ok2haz/Frequency_Counter_FPGA/STATUS.md

# STATUS — GPSDO / čítač kmitočtu (celkový přehled)

> **Společný rozcestník obou stran projektu.** Monorepo `Frequency_Counter_FPGA`
> obsahuje dva podprojekty, které spolu komunikují přes SPI. Tento soubor je
> **jediný cross-project pohled**: stav, sdílená smlouva a otevřené úkoly
> s vyznačením závislostí. Detaily NEduplikuje — odkazuje na dokumenty stran.
>
> **Poslední aktualizace:** 2026-07-20 · udržují OK2HAZ & OK2JNJ.
> Při větší změně na jedné straně aktualizuj sekci **Sdílený kontrakt** a **TODO**.

---

## Co to je
STM32H757 (host, displej + logika) měří kmitočet, který mu přes SPI dodává
FPGA (GW1NR-9) — reciproký 4-fázový čítač s front-endem MC100EP016A / MAX9601.
Reference 4×100 MHz (0/90/180/270°) generuje Si5356A z 10 MHz OCXO,
disciplinovaného z GPS (NEO-7M). Cíl = GPSDO + přesný čítač do ~1,4 GHz.

```
  GPS (NEO-7M) ──1PPS/UTC──► STM32H757 ◄──── TMP117/ADS1115/W25Q (senzory, flash)
                                │ SPI2 (64B rámec, master)
                                ▼
   OCXO 10MHz ──► Si5356A ──4×100MHz(0/90/180/270°)──► FPGA GW1NR-9
                                                          │  MC100EP016A ÷4/÷16
   RF vstup ──► MAX9601 tvarovač ──────────────────────► (reciproký čítač + TDC)
```

---

## Stav stran

### STM32H757 (`Frequency_Counter_STM32H757/`) — zralý
- Displej, FreeRTOS, senzory, GPS, RTC, W25Q flash, UI (libprim/libui/app),
  menu + okna, alarmy, IWDG, holdover — **funkční**. Detaily → `CLAUDE.md`.
- SPI driver `fpga_freq.c` (64B rámec, CRC16, polling ~20 Hz, /4↔/16 hystereze) — **hotový**.
- ⚠️ **Velké číslo na hlavní obrazovce je zatím SIMULACE.** Reálná data z FPGA
  tečou jen do UART `freq` + diag okna (`g_freq_text`/`g_freq_info`).
  **Napojení reálných dat na headline + statistiky = hlavní otevřený úkol.**
- **Nové 2026-07-16..18** (detaily → `CLAUDE.md`):
  - **Kalibrace editovatelná** (`calib.c/h`) — AD8307 slope/intercept + ADS 12V/5V
    gain přes −/+, ULOZIT persistuje do **W25Q CALIB store**; napojeno na reálný
    přepočet RF dBm i napěťových větví.
  - **Nastavení persistentní i přes power-cycle** (`syscfg.c/h`) — BKP přežije jen
    warm reset, proto zrcadlo do **W25Q CONFIG store** (debounced zápis ~1,5 s).
  - **Časová zóna** — okno „Cas", AUTO CET/CEST dle EU pravidla nebo ruční −12..+14 h.
  - **Trend až 60 dní** — decimační pyramida (×4, 9 stagí); presety 1 min…60 dní.
  - **Nová okna:** Čítač (syrový detail měření FPGA — užitečné pro SPI bring-up),
    Selftest (per-test + SPUSTIT), Komunikace (blokové schéma stavů), Cas.
  - **Si5356 reg 218 — OPRAVA ZÁMĚNY BITŮ**, viz TODO #8 (mělo dopad na diagnostiku).

### FPGA modul (`Frequency_Counter_FPGA_Module/`) — bring-up / v2.0
- Carrier board **v2.0** (KiCad) + Verilog RTL (`src/top.v`, `spi_app.v`,
  `spi_slave_phy.v`, `coarse_counter.v`, `tdc_vernier_4phase.v`) + sim testbenche
  (`sim/tb_*.sv`) + `pins.cst`/`timing.sdc` — **v repu**.
- Kalibrace fází TDC → `PHASE_CAL_DESIGN.md` (numerická LUT → IODELAY deskew).
- Osazení/wiring v2.0 → `BOARD_V20_CHECKLIST.md` (⚠️ U3 odpojené, `div_res` kritický).

---

## ⚠️ Sdílený kontrakt (= hlavní závislost mezi stranami)

**SPI: STM32 master, FPGA slave, mode 0, MSB, 8-bit. Pevný 64B full-duplex rámec.**
SCK cíl ≤6 MHz (max ~10 MHz). CRC-16/CCITT-FALSE (0x1021/0xFFFF) přes byte 0..61.
DATA payload (TYPE 0x80): `frequency_x100000` (/4), `freq16_x100000` (/16),
`edge_count`, `gate_time_ns`, `phase_status`, `error_flags`, …

- **Autoritativní specifikace v1:** `Frequency_Counter_STM32H757/CLAUDE.md`
  → sekce „FPGA strana protokolu" (tabulka offsetů, bity STATUS/FLAGS, škálování).
- **Handoff / bring-up:** `Frequency_Counter_STM32H757/FPGA_SPI_HANDOFF.md`,
  `FPGA_INSTANCE_BRIEF.md`.
- **Protokol v2 (návrh + odpověď FPGA strany):** `FPGA_PROTOCOL_V2_NAVRH.md`.

> **Pravidlo:** jakákoli změna rámce/offsetů/škálování se promítá do OBOU stran.
> Nejdřív uprav specifikaci v `CLAUDE.md`, pak obě implementace, a zapiš do TODO níže.

---

## TODO — cross-project (šipka = kdo na koho čeká)

### Hlavní (měření, UI, HW)

| # | Úkol | Strana | Závislost / blokátor |
|---|---|---|---|
| 1 | **Reálná data FPGA → headline + statistiky** (místo simulace) | STM32 | ⬅ potřebuje FPGA vydávající platné 64B rámce (link bring-up) |
| 2 | **SPI link bring-up na HW** (`RX0:FF` = FPGA nebudí MISO) | FPGA + STM32 | obě — CS/SCK/MISO, config load z flash, viz `CLAUDE.md` diagnostika |
| 3 | **Kalibrace fází TDC** (numerická LUT → IODELAY) | FPGA | `PHASE_CAL_DESIGN.md`; STM32 pak zobrazí `phase_status` PH:F/F |
| 4 | **Protokol v2** (rozšíření rámce) | obě | `FPGA_PROTOCOL_V2_NAVRH.md` — nejdřív dohodnout, pak obě strany |
| 5 | Osazení + oživení carrier v2.0 | FPGA | `BOARD_V20_CHECKLIST.md` |
| 6 | ✅ **Datalogging stability do W25Q DATA regionu — HOTOVO 2026-07-20 (v0.4.0).** | STM32 | `datalog.c/h` = append-only **kruhový** log, **32 B / 10 s → ~600 dní** v DATA regionu (63,9 MB), pak přepis nejstaršího. Záznam: f, teploty OCXO+deska, OCXO Vc, RF (**syrové mV**, ne dBm — kalibrace se může změnit), GPS lock/sat/HDOP, flags, **CRC16**. Pozice zápisu se po bootu **odvodí ze `seq`** (žádná metadata → přežije výpadek napájení). Tick v **defaultTask** s krátkým QSPI mutex timeoutem (10 ms) — při obsazené flash vzorek zahodí, watchdog nezdrží. **Úložiště za abstrakcí `datalog_backend_t`** → SD karta připravená (`datalog_sd.c`, `probe()`=false + 5bodový plán dodělání: SDMMC1 v .ioc, cache koherence, 512B RMW, FatFs, hot-unplug). Okno Datalog (s_view=17) je nově **živé** + tlačítko ZAPNOUT/VYPNOUT (persist v syscfg, ⚠️ magic `"SCFG"`→`"SCF2"` = jednorázový reset nastavení). UART `datalog [on\|off\|erase\|dump]`. Selftest **7/7** (`datalog_selftest`). ⚠️ Kmitočet bere z `fpga_freq_get_last()`, tj. **REÁLNÝ z FPGA** (ne ze simulace hlavní obrazovky) — dokud neběží SPI link (#2), bude v záznamech **0** a užitečné budou jen teploty/Vc/GPS. Smysluplný obsah tedy až po #2. |
| 7 | Reálná kalibrace RF (AD8307 slope/intercept) → CALIB store | STM32 | **infrastruktura HOTOVÁ** (`calib.c/h`, okno Kalibrace, persist do W25Q) — zbývá jen **změřit skutečné hodnoty** na HW a zadat je |
| 8 | **Si5356 „LOS_CLKIN" — VYŘEŠENO 2026-07-18: byla to FW záměna bitů, HW je V POŘÁDKU.** Kritická validace odhalila, že reg 218 má dle **AN565**: bit2 = **LOS_XTAL**, bit3 = **LOS_CLKIN** (FW měl bit2 mylně jako LOS_CLKIN). Pozorovaný status `0x04` = bit2 = LOS_XTAL — krystal XA/XB na desce **není osazen** (piny uzemněné dle datasheetu) → bit je **trvale 1 a benigní**. Skutečný LOS_CLKIN (bit3) = **0** → **TTL buzení CLKIN detektoru plně vyhovuje** (dřívější teorie „TTL 2,4 V < VIH 2,64 V" tímto empiricky vyvrácena — VIH je garanční mez, ne skutečný práh detektoru). Důkazy (4 nezávislé): AN565 tab. reg 218 + datasheet Fig. 7 (změřené sloupce) + schéma XA/XB→GND (#PWR086) + CBPro mapa `{6,0x04,0x1D}` maskuje přesně bit2 (LOS_XTAL) interrupt. **FW opraveno**: definy bit2/bit3, LOS_CLKIN(bit3)=ČERVENÁ (⚠️ AN565: **PLL_LOL se při fyzické ztrátě vstupu neasertuje** — bit3 je hlavní indikátor ztráty reference), bit2 ignorován. **Žádná HW změna není potřeba** — LMK1C1104/LVC1G17 bezpředmětné pro LOS (s bufferem by 0x04 svítil dál!). **Verifikace po flashi**: odpojit 10 MHz → status `0x08/0x0C`+červené „LOS CLKIN!", připojit → `0x04`+zelené „LOCK OK". Volitelná hygiena: scope-check overshoot ≤3,63 V na pinu 4. (Pozn. trvale platné: 74ACT/HCT jen 4,5–5,5 V.) | — vyřešeno (FW) | flash + 1min verifikace |
| 9 | ✅ **HOTOVO 2026-07-18: detekce přetečení zásobníku zapnuta + UartTask zvětšen** (audit) | STM32 | **1)** `configCHECK_FOR_STACK_OVERFLOW=2` + `configUSE_MALLOC_FAILED_HOOK=1` — obě byly NEDEFINOVANÉ → FreeRTOS je bral jako 0 → hooky ve `freertos_hooks.c` se nikdy nevolaly (crash black-box „stack:Task" byl mrtvý kód). Nastaveno v **`FreeRTOSConfig.h` USER CODE Defines** = regen-safe, stejný vzor jako `configGENERATE_RUN_TIME_STATS`. ⚠️ **Proto je NENASTAVUJ v CubeMX GUI** (vzniklo by dvojí `#define`). Ověřeno preprocesorem: `vApplicationStackOverflowHook` je nyní v `tasks.c` 2× (dřív 0×). **2)** UartTask 512→**1024 words** (2→4 KB) v `.ioc` `FREERTOS_M7.Tasks01` **i** `freertos.c` — rámec `UartTask_run` má při `-O0` (Debug = co se flashuje) 1256 B, tj. 61 % z původních 2048 B. Stacky celkem 17,4 KB z 32 KB heapu (15,4 KB rezerva). |
| 10 | ✅ **HOTOVO — ověřeno na HW 2026-08-15:** `stacktest yes` → IWDG reset → `status` ukázal **`Reset: WATCHDOG!  stack:UartTask`**, tedy hook zachytil jméno tasku a zapsal ho do crash black-boxu. (Dřívější mlčení hooku při boot-loopu mělo jinou příčinu: `configASSERT` shodil systém s vypnutými přerušeními dřív, než nastalo přepnutí kontextu, kde metoda 2 kontroluje vzorek.) Původní zadání: **Ověřit na HW, že detekce přetečení zásobníku zabírá — v0.4.0 FLASHNUTA 2026-07-20, čeká na spuštění testu.** | STM32 | Původní návrh (dočasně přidat `waste[]` do kódu, build, flash, odstranit) nahrazen **runtime UART příkazem `stacktest yes`** — žádný rebuild, test se spustí z konzole kdykoli. Záměrně přeteče stack **UartTasku** (`volatile char waste[3600]` — jen o ~760 B, aby se stihl zavolat hook dřív, než by se rozsypal sousední heap na HardFault), pak `osDelay(1)` → kontrola stack patternu při přepnutí kontextu → `vApplicationStackOverflowHook` → `crash_blackbox` do BKP_DR3..5 → `__disable_irq()` + spin → bez heartbeatů **IWDG reset do ~4 s**. **Ověření po restartu:** System Health / UART `status` musí ukázat **„Reset: … stack:UartTask"**. Vyžaduje přesně `stacktest yes` (samotné `stacktest` jen vypíše nápovědu — ochrana proti překlepu). ⚠️ Bez VBAT baterie testuj **warm resetem** (BKP nepřežije power-cycle). **Zbývá: spustit `stacktest yes` na konzoli** (firmware už je v desce). |
| 11 | ✅ **UI: dotykové cíle a typografie pro 4,3" panel — HOTOVO 2026-07-19 (vč. 2b).** | STM32 | Panel je **4,3" 800×480 = 8,54 px/mm (217 DPI)**. Hotovo (1.–4. vlna, detaily v `UI_SIZES.md`): hit-slop + rozvržení hlavní obrazovky + Nastavení/Čas/Kalibrace ovladače 56→64 px + Kalibrace přeskládána; pilulky 30→36→42→**46 px**; karta Allan font 14→**16**. **(2b) HOTOVO**: globální bump `mono_16`→`18`/`sans_16`→`18` na **~48 místech** (Diagnostika, GPS, Health, Senzory, Paměť, O přístroji, boot splash, Reference, Kalibrace, Čítač, histogram/trend overlaye, komunikační diagram) — každé ověřeno tabulkou fontů na **šířku i skutečnou výšku glyfu** (`oy` konkrétního znaku, ne nominální `ascent` fontu — ten je worst-case pro celou znakovou sadu a zbytečně by zamítl bezpečné případy, jak se ukázalo u komunikačního diagramu). **6 míst vědomě ponecháno na mono_16/sans_16** (komentář `TODO #11(2b)` u každého v kódu): GPS Vet/Fix čítače, GPS HDOP/PDOP, Diagnostika `g_freq_info`, Health „Reset:" řádek — všechny přetékají svůj box i při současném fontu, bump by to zhoršil; main-old větev (`draw_stat_card` pro `s_layout_old`) — na zamrzlé referenční obrazovce se záměrně nedělají další úpravy, viz #14. |
| 12 | ✅ **UI: odstranit duplicity v `app_gpsdo.c` — HOTOVO 2026-07-19 (A1/A2/A3/A4 vše).** | STM32 | **(A1):** prolog okna (`app_gpsdo_init`+`prim_set_target`+`prim_reset_clip`, 24 míst) sjednocen na `window_prep()`/`window_first(view_id)` — mechanická náhrada, chování beze změny. **(A2):** `fmt_temp`/`fmt_d1`/`fmt_fN`/`fmt_minmax` sdílí `fixed_split()` (čistá aritmetika) + `fmt_fixed()` (jedna hodnota→text); `fmt_minmax` skládá dvě hodnoty do jednoho `snprintf` (ne přes mezibuffery — to by kaskádovitě rozjelo GCC `-Wformat-truncation`, ověřeno a opraveno). **(A3):** `dval`/`dtext`/`dtext_c` sdílí `dtext_a(pos,baseline,boxw,v,col,font,align)`; 1px nesrovnalost v geometrii boxu sjednocena. **(A4) dokončeno:** celoplošná karta měla 5 variant geometrie — 3 skutečně duplicitní páry (5+5+**2**, poslední pár — Čítač/Čas — nalezen až při dodatečné kontrole) mají jméno (`DG_CARD_FULL_A`/`_B`/`_C`), zbylé 3 výjimky (O přístroji, Kalibrace, Komunikace) mají opravdu unikátní obsah — pojmenování jednorázové konstanty by nebylo DRY, záměrně ponechány inline. Ověřeno `-Wall -Wextra -Wshadow -O2`: 0 nových warningů (stejná množina `-Wstringop-truncation` jako před revizí, viz #13). |
| 13 | ✅ **Audit velikostí cache v `dchg()` — HOTOVO 2026-07-19: potvrzeno false positive.** | STM32 | Překlad `-O2` hlásí **~54× `-Wstringop-truncation`** v `dchg` (`strncpy(cache, now, n-1)`). Zkontrolováno **6 namátkových vzorků** napříč souborem (`c_utc[26]`/`c_loc[34]` v okně Čas, `c_spi[68]` v Diagnostice, `c_mute/c_f/c_g[12]` v Alarmech) — ve **všech** je cache buffer (`c_*[N]`) záměrně **stejně velký jako zdrojový `snprintf` buffer** (`c_spi[68]` ↔ zdroj `sig[68]`, `c_mute[12]` ↔ zdroj `b[12]` atd.), takže `strncpy` nikdy reálně neořízne — GCC jen nepočítá s tím, že oba buffery jsou párované, a hlásí teoretické maximum zdrojového typu (`%s`/`%ld` bez znalosti reálného obsahu). **Závěr: false positive z principu návrhu, ne z nedbalosti** — vzor „cache = velikost zdroje" je konzistentní přes celý soubor. Nepotřebuje další zásah; ⚠️ při přidávání NOVÉHO `dchg` volání do budoucna přesto dodržet stejný vzor (cache stejně velká jako zdrojový buffer), jinak by hrozilo tiché zamrznutí pole (dvě různé hodnoty se stejným ořízlým prefixem = "beze změny"). Počet varování mírně kolísá (54↔55) mezi buildy kvůli GCC duplicitní diagnostice u rozbalených smyček (stejný řádek nahlášen 2×) — neznamená to novou chybu, ověřeno dohledáním konkrétních zdrojových řádků. |
| 14 | ✅ **HOTOVO 2026-08-19: A/B srovnávací větev odstraněna, vybrán NOVÝ (v2) layout.** Smazány `s_layout_old` + `screen_main_toggle_layout`/`_layout_is_old` + `render_body_grid_v1`/`render_right_column_v1` + všechny `s_layout_old` dispatch větve (draw_stat_card, draw_offset_sigma, render_card_trend, tick_stats/trend_anim); `render_body_grid_v2` → `render_body_grid` (jediný kód). Footer slot 0 vrácen z „Main SW" na **PERIOD/FREQ toggle** (`MODE_NAME[st.mode ? 0 : 1]`), touch handler `b==0` vrácen do standardní RUN/GATE/CHAN cesty. Ověřeno `-Wall -Wextra -Wshadow -Os` (screen_main.c + app_gpsdo.c, 0 varování). Původní zadání: **Odstranit dočasnou A/B srovnávací větev hlavní obrazovky** (zavedeno 2026-07-19) | STM32 | Kvůli vizuálnímu porovnání starého (pre-4,3") a nového layoutu hlavní mřížky na HW existoval **dočasný přepínač**: `screen_main_toggle_layout()`/`screen_main_layout_is_old()` v `screen_main.c` (`s_layout_old`, `render_body_grid_v1`/`_v2`, `render_right_column_v1`, dispatch v `draw_stat_card`), footer tlačítko slotu 0 je **dočasně "Main SW"** místo skutečného přepínače PERIOD/FREQ (viz `footer_button_def` case 0 a `app_gpsdo_handle_touch` b==0 v `app_gpsdo.c` — obojí označeno `⚠️ DOCASNE`). ⚠️ **Default přepnut na STARÝ layout** (`s_layout_old = true`, 2026-07-19) — je to zamrzlá referenční verze, na které se **nedělají žádné další úpravy** (proto zůstala i mimo #11(2b) bump, viz `draw_stat_card`); veškerý další vývoj hlavní obrazovky cílí na `_v2`. **Až padne rozhodnutí, které rozvržení zůstane:** (1) smazat `_v1` funkce + `s_layout_old` + dispatch v `draw_stat_card`, (2) vrátit `case 0` ve `footer_button_def` na `MODE_NAME[st.mode ? 0 : 1]` a smazat `b==0` větev v touch handleru (příslušné komentáře v kódu obsahují přesné původní znění), (3) tohle udělat **PŘED** #12/A4 (dořešení zbylé geometrie karet — už jen 3 legitimní výjimky, viz #12), ať se neduplikuje práce na dvou paralelních layoutech najednou. |
| 15 | ✅ **Menu rozšířeno na 3×4 (12 dlaždic) — HOTOVO 2026-07-19, 3 sloty volné pro budoucí funkce.** | STM32 | `MENU_ITEMS` má nově 12 pozic (bylo 9): 9 stávajících funkcí beze změny obsahu, **4. řádek = 3× "Placeholder N"** (`ACT_PLACEHOLDER`, no-op). Až bude jasné, co tam patří, stačí v `MENU_ITEMS` (app_gpsdo.c) přejmenovat label a přidat `case` do `menu_activate()` — geometrie (248×76 px dlaždice, 8,9 mm výška) i touch handler (přeskakuje `nav_push` pro placeholdery) jsou hotové. |
| 16 | ✅ **Kompletní revize necommitnutého UI balíku — HOTOVO 2026-07-19, 3 nálezy opraveny.** | STM32 | Křížová kontrola všech dnešních změn (nic z toho neběželo na HW) + kompilační sweep VŠECH zdrojáků app/libui/libprim. **(1)** Řada pilulek v headeru kolidovala s **clear zónami sekundového redrawu hodin/data** (x=648/644 — dosud se ověřovalo jen proti textu hodin na 674; datová zóna s pilulkami výšky 46 koliduje i svisle) → přidán `HDR_PILL_LIMIT`+fit-check `hdr_pill_fit` (komentář to sliboval odjakživa, kód nedělal), mezery pilulek finálně 4/5. **(2)** Fit-check by v holdover stavech vyřadil právě HOLD pilulku → **HOLD přesunut před CAL** (pořadí = důležitost; CAL je statický placeholder). Ověřeno simulací všech stavů přes tabulky fontů. **(3)** `fmt_fixed`/`fmt_temp`/`fmt_minmax` ztrácely znaménko u hodnot −0,99..−0,01 (pre-existující ve všech 4 původních kopiích) → opraveno `-` předponou. **Bonus:** ověřen mezitímní CubeMX regen (všechny USER CODE přežily, diffy jen EOL — regen-safe návrh fungoval; ztracen jen komentář na generovaném řádku freertos.c, hodnota drží z .ioc), `Backup/` složky do `.gitignore`, mrtvá `SCR_MAIN_SMALL_CARD_H` pryč, zastaralé komentáře srovnány. Detaily → `UI_SIZES.md` 6. vlna. ⚠️ **Pořád platí: nic není ověřeno na HW displeji** — všechna geometrie je počítaná (tabulky fontů), první flash ukáže realitu. |
| 17 | ✅ **UI: RUN/STOP obráceně + červený STOP + podbarvení kmitočtu; okraje mřížky 12→4 px — HOTOVO 2026-07-20 (v0.4.0).** | STM32 | **(1)** Footer slot 1: label = **AKCE**, ne stav — při běhu **červené „STOP"** (`UI_BUTTON_STOP`, nová varianta v libui + `btn_stop_*` v tmavé i světlé paletě), při zastaveném zelené „RUN". **(2)** Při STOP se zóna velkého kmitočtu podbarví `UI_COLOR_FREQ_STOP_BG` (poloprůhledná červená ~15 %) → měření zjevně stojí. Alfa vyřazuje DMA2D fast-path, ale při STOP neběží 20Hz `tick_freq`, takže se kreslí jen při plném renderu a při stisku (CPU ~0); přepnutí volá nové `screen_main_redraw_freq_area()`, protože per-segment dirty cesta by podklad nepřekreslila. **(3)** `SCR_MAIN_GRID_MARGIN` 12→**4** px v **obou** layoutech (v1 i v2) — 12 px po stranách byl čistý nevyužitý pruh. Zisk 16 px se dělí dle ratia: Allan 364→**372**, pravý sloupec (trend/drift) 398→**406**; vnitřek stat karty 125→128 px = větší rezerva na mono_18. ✅ **Ověřeno na HW 2026-07-20** (v0.4.0 flashnuta, běží). |
| 18 | 🔶 **Náhodné watchdog resety („jednou za čas") — diagnostika doplněna 2026-07-20, příčina zatím NEPOTVRZENÁ.** | STM32 | Prostý IWDG reset byl **němý** — RSR řekl jen „watchdog", ne který task přestal koupat. Doplněno: **(1)** `watchdog_supervise` před vypršením IWDG zapíše do crash black-boxu (BKP_DR3..5, kind 3) jméno tasku se starým heartbeatem → po restartu `stall:UiTask` / `stall:FpgaTask` / `stall:BOTH`; **(2)** UART `status` nově vypisuje příčinu resetu + crash text + RSR + heap + CPU + **volný stack všech 5 tasků** + stav datalogu (dřív jen „RUNNING" — proto se to špatně honilo). **Opraven konkrétní nález:** `w25q.c wait_ready()` čekal na dokončení erase (50–400 ms, timeout 1000 ms) v **čistém spinu bez yieldu** → erase volaný z defaultTasku (Normal) úplně vyhladověl UiTask (BelowNormal) a defaultTask se sám nedostal na `watchdog_supervise`; nově `osDelay(1)` mezi dotazy. Týká se i `calib_save` (UiTask) a syscfg auto-save, tj. **existovalo už před v0.4.0**. Také `datalog find_head()` (16352 QSPI čtení při bootu) nově yielduje po 512 blocích. **Stav 2026-07-20: v0.4.0 flashnuta a běží. Zbývá počkat na další výskyt resetu a přečíst `status`** — `stall:<task>` ukáže viníka. ⚠️ Dokud reset nenastane znovu, NENÍ potvrzeno ani to, že příčinou byl spinující `wait_ready` (oprava je odůvodněná sama o sobě, ale důkaz chybí), ani že diagnostický zápis do BKP na HW opravdu funguje. |
| 31 | ✅ **[HW OVĚŘENO 2026-08-15 průchodem `HW_OVERENI_PRUCHOD.md`] Grafy teplot + napájení ve vlastním okně — IMPLEMENTOVÁNO 2026-07-31, čeká na HW.** Nové okno GRAFY (s_view=29), vstup tlačítkem GRAFY ve footeru System Health (footer přeskládán na 4 tlačítka). **Kombinovaný zdroj (obě zvolené cesty):** krátká okna z RAM decimační pyramidy (nový modul `sensor_hist.c/h`, plněný ze SensorsTasku 2Hz sweepu), dlouhá z datalogu (W25Q). Vlevo grafy teplot (4 série, sdílená osa) + OCXO Vc; vpravo 5 vertikálních bargrafů napájení s nominálním markerem (#32). Detaily → `CLAUDE.md` okno GRAFY. Kompilačně ověřeno (0 warningů `-Wall -Wextra -Wshadow`). ⚠️ Datalog okna renderují jen při vstupu/změně presetu (watchdog). **Zbývá: ověřit na displeji** (geometrie počítaná, tabulky fontů; datalog cesta má smysl až po #6 běhu / #2). | STM32 | Nové okno (kandidát: dlaždice v Menu, nebo tlačítko ze Senzory/System Health) s **časovým průběhem** teplot (TMP117 0x48/0x49/0x4A, ADC3 CORE_T) a napájení (ADS AIN2/AIN3 = 12V/5V větev, OCXO_VC, VREF/VBAT) — dnes `g_sensors[]` drží jen `last/min/max/mean` (žádnou historii v čase, viz `sensor_stat.h`). **Dvě možné datové cesty:** (a) nový lehký RAM ring na vzorek/sensor stejného střihu jako trend/ADEV decimační pyramida ve `screen_main.c` (rychlé, ale jen od bootu), (b) číst z **datalogu** (`datalog.c`, už loguje `t_ocxo_c100`/`t_board_c100`/`ocxo_vc_mv`/`rf_mv` po 10 s do W25Q DATA — dlouhodobá historie zdarma, ale čtení z flash je pomalejší/blokující). Asi kombinace: krátké okno z RAM ringu (hladké, ~1 min–1 h), delší z datalogu (dny). |
| 32 | ✅ **[HW OVĚŘENO 2026-08-15 průchodem `HW_OVERENI_PRUCHOD.md`] Bargraf: vertikální segmenty + jemnější granularita + zvýrazněný nominální segment — IMPLEMENTOVÁNO 2026-07-31, čeká na HW.** `ui_bargraph_t` rozšířen o `vertical` (volitelný mód, segmenty zdola nahoru), `segs` (0=default 20; jinak N = jemnější) a `nominal_pct` (segment na nominální hodnotě zvýrazněn accentem). **Horizontální fast-path `ui_bargraph_update` beze změny** — stávající RF bargraf na hlavní obrazovce i anim demo jedou dál. Použito v okně GRAFY (#31, 24 segmentů, nominál napájecích větví). Detaily → `CLAUDE.md`. Kompilačně ověřeno. **Zbývá: ověřit vzhled na displeji.** | STM32 | `ui_bargraph.c`/`bargraph.h` dnes kreslí **horizontální** track s pevně 20 segmenty (`UI_BAR_SEGS`, `bar_seg_rect`). Požadavek: **(1)** segmenty orientovat/skládat vertikálně, aby se vešlo víc najednou (kandidát pro RF/napájecí bargrafy v novém okně z #31, kde je výška k dispozici), **(2)** víc segmentů = jemnější rozlišení měřené hodnoty (dnes 20 = 5% krok), **(3)** jeden segment (na nastavené/nominální/průměrné/aktuální hodnotě — např. `g_sensors[id].mean` nebo kalibrační nominál) vykreslit **projasněně/jinou barvou**, aby šlo na první pohled vidět odchylku od očekávané hodnoty. ⚠️ Zasahuje sdílenou geometrii (`bar_seg_rect`, `bar_lit`) používanou i stávajícím RF bargrafem na hlavní obrazovce a v novém okně Animace (`ANIM_BAR_RECT`) — nová varianta by měla být **volitelný mód** (orientace + nominal-marker jako parametr `ui_bargraph_t`), ne rozbití existujícího horizontálního API. |
| 33 | ✅ **[HW OVĚŘENO 2026-08-15 průchodem `HW_OVERENI_PRUCHOD.md`] Ověřit na HW celou novou animační sadu (2026-07-21) — zatím jen kompilátorem, NIC neběželo na displeji.** | STM32 | Rozsáhlý balík: globální přepínač `g_anim_enabled` (+ samostatný `g_digit_anim_enabled` pro zvýraznění číslic) přes okno Animace (`s_view=24`), sdílený `anim.h` helper, eased jas v Nastavení, eased Offset/σ/Drift + trend sparkline (jen v2 layout), micro-flash tlačítek na hlavní obrazovce, zvýraznění změněné číslice v headline, pulsující stavová LED v blokovém schématu, statická spinner ikona u ULOZIT v Kalibraci, boot splash fade-in. **✅ 2026-07-22 opraven root-cause „animace se nespouští": `RTC_SYSCFG2_MAGIC` se při přidání anim bitů 8/9 NEzvedl → legacy BKP_DR6 (bity 8/9=0, bez legacy-guardu jako časová zóna) při warm resetu vypnul `g_anim_enabled`/`g_digit_anim_enabled`; magic bump `0x53C1`→`0x53C2` (rtc.h) legacy záznam odmítne → defaulty (anim ON).** **✅ Přidáno subokno „PRIKLADY ANIMACI" (s_view=25, tlačítko v okně Animace): 6 dlaždic, všechny typy animací běží nepřetržitě ve smyčce, nezávisle na `g_anim_enabled` — ověření animací v izolaci. Kompilace čistá (`-Wall -Wextra`).** **2026-07-22 flash na navigačních tlačítkách/pilulkách (`tap_flash(rect,label)`):** po iteracích (osDelay 70 → 1px obrys → plný accent fill [překryl text] → vypnuto → zpět) finální = **2px accent OBRYS (`tap_flash`/`tap_flash_pill` → `tap_flash_r(rect,rad)`), neblokující, 1 frame (~17 ms = page-flip floor), JEN na 4 in-place přepínačích (Animace/Čas/Trend), které po stisku zůstanou.** **U navigačních tlačítek/pilulek flash ZÁMĚRNĚ ZRUŠEN** — problik před navigací stojí vždy ≥1 frame (musí být vidět dřív, než se flipne cílová obrazovka), jen zdržoval; odezva navigace = sama změna obrazovky. Obrys nezakrývá text (kreslí se přes hotový prvek). Iterace: 1px obrys → fill (překryl text) → high-contrast fill → 2px obrys → jen in-place. Dead getters (`screen_main_*_rect`) odstraněny. Problik PŘED navigací vždy stojí ≥1 frame (musí být vidět dřív, než se flipne cílová obrazovka) — 1 frame je fyzické minimum, kratší nejde. Volá se jen tam, kde akce překreslí celý rect/obrazovku (jinak duch). In-place RUN/GATE/CHAN drží vlastní `screen_main_button_flash`. Demo dlaždice „Ease-out bar": opraveno navrstvení % textu (baseline byl na horní hraně clear boxu → glyf ascentoval mimo → nemazal se). **Kontrolní seznam při prvním flashi:** (1) Menu → Animace: oba přepínače (ANIMACE, CISLICE) přepínají a persistují přes restart; (1b) tlačítko „PRIKLADY ANIMACI" → 6 dlaždic hýbe; (2) RF bargraf demo dojíždí plynule; (3) Nastavení → Jas −/+ : bar dojíždí, HW podsvícení reaguje okamžitě; (4) hlavní obrazovka v2 layout (přes „Main SW"): Offset/σ/Drift a trend sparkline neškubou; (5) tlačítka RUN/GATE/CHAN krátce zablikají accent obrysem; (6) headline kmitočtu — zvýraznění poslední změněné skupiny cifer (může působit jako trvalé podsvícení, viz `CLAUDE.md`, proto přepínač CISLICE zvlášť); (7) Diagnostika → DIAGRAM: uzly v chybovém stavu (BAD/WARN) pulzují, OK ne; (8) Kalibrace → ULOZIT: ikonka vedle „Ukládám..."; (9) reset/reboot: boot splash se rozjasní z černé. **Magic bumpy syscfg** (`SCF2`→`SCF3`→`SCF4`) znamenají, že PRVNÍ boot po flashi vrátí nastavení na výchozí (očekávané, ne bug). |
| 34 | ✅ **VYŘEŠENO 2026-07-22: „watchdog" reset při USB byl HardFault z přetečení stacku UartTasku — `stacktest`ovský `volatile char waste[3600]` byl local v `UartTask_run`, takže GCC ho rezervoval v rámci funkce VŽDY → frame 4904 B > 4096 B stack → task přetékal i za normálu; první USB znak (echo cesta jde hlouběji do USB HAL, ale jen když je port otevřený) dorazil za hranice → poškozený rámec → HardFault. Fix: `waste[3600]` přesunut do `noinline` funkce `stacktest_overflow()` → rámec `UartTask_run` spadl 4904→1304 B (ověřeno `.su`), stacktest funguje dál.** Cesta k diagnóze: HardFault_Handler → crash black-box (kind 4, PC+LR z exception frame) → displej ukázal `SW reset HF@00000001 U` (skok na NULL) a pak `HF@F002689C B` (garbage LR + měnící se typ U/B = poškozený rámec = přetečení); `.su` odhalil frame 4904 B. Ponecháno navíc: CDC_Transmit_FS guard + HardFault self-report (obojí užitečné do budoucna). | STM32 |
| 35 | ✅ **Audit — PRŮBĚŽNĚ HOTOV 2026-08-15.** Kompilátorový sweep 73 souborů CM7+CM4 (`-Wall -Wextra -Wshadow`) = **0 varování**, `-fanalyzer` na klíčových souborech čistý, žádný mrtvý kód (`-Wunused-function` + kontrola definic vs. volání). Nálezy opraveny: `FIL` ze stacku (UartTask +1,1 kB), 2 clear boxy pod baseline, duplicitní `row[]` buffer, zastaralé komentáře. Audit je od teď součástí každé větší změny, ne jednorázová položka. Původní: **kompilátorový sweep HOTOV 2026-07-31, hloubkový audit logiky pokračuje.** Generované init soubory (`adc/i2c/spi/quadspi/ltdc/dsihost/fmc/gpio/rtc/usart/stm32h7xx_it/stm32h7xx_hal_msp.c`) + USB (`usb_device/usbd_conf/usbd_cdc_if/usbd_desc.c`) prohnány `-Wall -Wextra -Wshadow` reálnými build flagy: **žádná reálná chyba, jen benigní CubeMX warningy** (unused parameter v HAL MSP callbacích `fmc.c`/`usbd_cdc_if.c`, missing BOS initializer `usbd_desc.c` — vše generované, neopravitelné bez zásahu do generovaného kódu). **Regen-safety spot-check OK:** PB12 (FPGA CS) default=SET, QUADSPI FlashSize=25, I2C4/I2C1 Timing=0x70303AEE, RTC BKP guard, configCHECK_FOR_STACK_OVERFLOW=2, OTG_FS IRQ prio 5, vbus_sensing=DISABLE — všechny ruční zásahy z CLAUDE.md intaktní (regen je nevrátil). **Zbývá:** hloubkový audit LOGIKY USER CODE bloků + FIFO velikostí / IRQ priorit napříč (ne jen kompilace). | STM32 | Hloubkový audit má pokrýt i **CubeMX-generovaný** kód (USER CODE bloky + vygenerovaná konfigurace: `adc.c`/`i2c.c`/`spi.c`/`quadspi.c`/`ltdc.c`/`dsihost.c`/`fmc.c`/`gpio.c`/`rtc.c`/`usart.c` init, `usbd_conf.c`, `usb_device.c`, `stm32h7xx_it.c`, `stm32h7xx_hal_msp.c`) a **vendored knihovny** tam, kde je projekt konfiguruje/upravil (FIFO velikosti USB, IRQ priority, HAL conf `stm32h7xx_hal_conf.h`, `FreeRTOSConfig.h`, linker skript). Ověřit konzistenci vygenerované konfigurace s `.ioc` a s ručními zásahy popsanými v CLAUDE.md (regen-safe pattern). Ne auditovat samotné HAL/CMSIS/FreeRTOS/USB Device Library zdrojáky (ST/vendor). | Reprodukuje se spolehlivě: fyzické připojení USB kabelu do OTG_FS konektoru (USB CDC konzole, `USE_USB_CDC_CONSOLE=1`) vyvolá reset, který uživatel označuje jako „watchdog". **Kontrola kódem (2026-07-21) nenašla zjevnou chybu:** VBUS sensing správně VYPNUTÝ (`vbus_sensing_enable=DISABLE` v `usbd_conf.c`, PA9 kvůli enkodéru), NVIC OTG_FS_IRQn priorita 5 (FreeRTOS-safe, shodná s USART1), `USBD_DEBUG_LEVEL=0` (žádný `printf` z ISR kontextu enumerace), `USBD_Delay`/`HAL_Delay` se v knihovně vůbec nevolá, `HAL_PWREx_EnableUSBVoltageDetector()` volán. **Blokátor diagnostiky:** USB CDC je JEDINÝ konzolový port (žádný USART1↔TTL dongle, žádný debugger zmíněn) → nejde spustit UART `status` pro přečtení crash black-boxu běžným způsobem. **Řešení bez kabelu/debuggeru: displej sám ukazuje diagnostiku** — po resetu/rebootu na dotykovém displeji `SYS` pilulka (hlavní obrazovka) nebo Menu → System Health → řádek „Reset: …" (`g_reset_text` + `g_crash_text`, `app_gpsdo.c:991-996`) ukáže přesnou příčinu (`watchdog stall:UiTask` / `stall:FpgaTask` / `stall:BOTH` / `stack:<task>`) BEZ nutnosti jakékoli konzole. **Čeká se na:** přesný text toho řádku od uživatele → podle `stall:`/`stack:` cíle se pak jde přímo k viníkovi (UiTask touch/I2C4 smyčka vs. defaultTask USBD zásobník vs. přímo OTG_FS_IRQHandler řetězec). **2026-07-22 (příznak upřesněn: připojení OK, ale PSANÍ do konzole → žádné echo → zamrznutí → watchdog):** (1) **`CDC_Transmit_FS` dostal guard** — dřív bez kontroly dereferencoval `pClassData->TxState`; při `dev_state != CONFIGURED` / `pClassData == NULL` (před enumerací / po odpojení / během USB reset) = **NULL-deref HardFault** → `HardFault_Handler` = `for(;;)` → IWDG reset vypadal jako němý „watchdog". Guard vrací `USBD_BUSY` (data zůstanou v ring bufferu). (2) **`HardFault_Handler` teď zapíše `HardFault` (kind 4) do crash black-boxu (BKP_DR3) + hned `NVIC_SystemReset`** → displej „Reset:" nově rozliší **HardFault** vs `stall:<task>` vs čistý watchdog. **Diagnostika po flashi:** zopakovat USB freeze → Menu → System Health → „Reset:" ukáže přesnou příčinu bez konzole. (`configASSERT` je taky `for(;;)` → jakýkoli selhaný assert = taky „watchdog"; HardFault log to odliší.) **2026-07-22 POTVRZENO uživatelem: připojení OK, PRVNÍ poslaný znak → „SW reset HardFault"** → je to skutečný procesorový fault (ne stall), a to PŘES přidaný TX guard (tj. fault je na RX/echo cestě dál). **Přidán capture místa faultu:** `HardFault_Handler` čte stacknutý PC z exception frame (EXC_RETURN bit2 → MSP/PSP, PC na off 0x18) do BKP_DR4 + `SCB->CFSR` do BKP_DR5; `rtc.c` to ukáže jako **`HF@<pc><typ>`** (typ: B=BusFault/U=UsageFault/M=MemManage). **Čeká se na:** ten `HF@…` řetězec z displeje → `arm-none-eabi-addr2line -e CM7/Debug/H757_LED_CM7.elf <pc>` (čerstvý build) → přesná funkce/řádek → cílená oprava. |

| 69 | ✅ **VYŘEŠENO 2026-08-14 — příčina byla SOFTWARE (`HardwareFlowControl` vypnutý), NE elektronika.** SD čte/zapisuje bit po bitu shodně (viz #28). „Datový přenos nejede" = `HWFC_EN=0` v CLKCR (v `.ioc` chyběl `SDMMC1.HardwareFlowControl`) + neaplikovaná transfer konfigurace CLKCR. HW (bulk kondík, CK odpor) se ukázal jako NEblokující — 16 MHz jede. **📋 TODO (volitelně, RYCHLOST SD — teprve az to bude potreba):** (1) **vyšší SDMMC takt** (16 → 25/50 MHz, `SDMMC1.ClockDiv` 2→1 nebo high-speed switch) — ⚠️ jen po (2)+(3); (2) **sériový tlumicí odpor ~22–33 Ω na SDMMC1_CK** (PC12) proti překmitům při vyšším taktu; (3) **bulk kondenzátor 4,7–10 µF na SD VDD** (dnes jen C75 100n) proti propadu při zápisovém burstu. 4-bit sběrnice + 32 KB bloky + `f_expand` předalokace = HOTOVO 2026-08-14 (SW, bez HW zásahu). Původní zápis (elektronika/DMA) ponechán níže jako historie. — 🟡 **SD elektronika + DMA — PŮVODNÍ SYMPTOM VYVRÁCEN 2026-08-12.** Na cíli přes GDB: `BSP_SD_Init() = MSD_OK`, karta **SDHC 14,5 GB**, `CardState = TRANSFER`, `CLKCR = 0x4002` (4-bit, 16 MHz) → **SDMMC1 komunikuje spolehlivě**, „init OK ale přenos nejede" se nepotvrdilo. SW strana koherence je mezitím hotová (`sd_hal_*` má statický bounce buffer v `.bss`/RAM_D1 zarovnaný na 32 B + clean/invalidate; `ENABLE_SD_DMA_CACHE_MAINTENANCE` + `ENABLE_SCRATCH_BUFFER` zapnuté v `sd_diskio.c`). **Zbývá jen HW opatrnost pro vyšší rychlosti** (viz níže) — proto 🟡, ne 🔴. Původní zápis: **init projde, karta se vidí, pak datový přenos (IDMA) „nějakou rychlostí" nejede.** Revize schématu (list 7/7 `USB_SD_FLASH`, J13 `Micro_SD_DM3AT`, piny PC8-11=D0-D3/PC12=CK/PD2=CMD): ✅ pull-upy CMD/DAT (R56–R61) jsou; ⚠️ **na SD VDD jen C75 100n — chybí bulk 4,7–10 µF** (propad při zapisovém burstu); ⚠️ **na SDMMC1_CK není sériový tlumicí odpor ~22–33 Ω** (překmity při vyšším hodinovém kmitočtu → „nejede až od nějaké rychlosti"). **SW (viz `datalog_sd.c` bod 2):** i blokující `HAL_SD_*Blocks` na H7 jede přes **IDMA** → (a) buffer NESMÍ být v **DTCM** (`0x20000000`, IDMA nedosáhne — v projektu default `.bss`/stack ale v AXI SRAM `0x24000000`, OK), (b) AXI SRAM je **cacheable** → nutná koherence (`aligned(32)`, `SCB_CleanDCache` před write / `InvalidateDCache` po read) nebo ne-cachovaná MPU oblast. **Staged rychlost:** init 400 kHz → 1-bit 12–16 MHz → 4-bit → zvyšovat (SDMMC ker. clk 64 MHz). ⚠️ Potvrdit hodnotu pull-upů (~47k, HS raději 22k) a pull-up na `SDMMC1_DET`. | STM32 (HW rework + SW) | souvisí #28 (SD backend datalogu) |

### Funkce čítače / analyzátoru — rozšíření (revize funkcí profi přístrojů, 2026-08-01)

> Vychází z porovnání s Keysight 53230A / SR620 / Microsemi 5120A / TimeLab (co dělají tovární
> čítače a fázové analyzátory a co ještě nemáme). ⭐ **#36 (1PPS TIC) je NEJVYŠŠÍ HW priorita této
> skupiny — schválně první** — odemyká celý fázový/časový cluster (#37–#39): bez měření vlastní
> chyby proti GPS 1PPS je to „GPS-monitorovaný" oscilátor, ne skutečně disciplinovaný GPSDO.
> Většina statistických položek (#40–#42, #45) se **překrývá s #27 (MathTask)** a rozjede se
> naplno až po **#2** (reálná data z FPGA); do té doby by kreslily šum ze simulace.

| # | Úkol | Strana | Závislost / blokátor |
|---|---|---|---|
| 36 | 🔴⭐ **1PPS time-interval counter (TIC) — fáze/čas. chyba OCXO vs GPS 1PPS.** Vyžaduje **HW/FPGA úpravu**: přivést GPS 1PPS do FPGA a timestampovat ho proti 100 MHz (2,5 ns TDC už je osazen). Klasická funkce fázového analyzátoru; dnes se věří jen GPS fixu, vlastní disciplinační chyba se neměří. **Enabling item pro #37–#39.** | FPGA + STM32 | HW: 1PPS pin do FPGA + protokol v2 (#4) — nové pole `time_error_ns` v DATA rámci |
| 37 | **Phase/time-error graf** (TIE [ns] vs čas, strip chart) — horizontální graf analyzátoru | STM32 | ⬅ #36 |
| 38 | **Sawtooth korekce** — odečíst kvantizační chybu NEO-7M (`UBX-TIM-TP` quantErr) od 1PPS TIC | STM32 | ⬅ #36; NEO-7M quantErr přes UBX |
| 39 | **Holdover predikce** — extrapolace driftu/aging do okna Holdover (odhad chyby v čase bez GPS) | STM32 | částečně SW hned (z trendu); přesně ⬅ #36/#41 |
| 40 | **ADEV konfidenční intervaly** (χ² meze / error bars, ~1/√(2·párů)) — rozšíření `FX_ALLAN_CONF` pásu na skutečné meze | STM32 | 🟡 ⬅ #2 (reálná data); kryje i #27 |
| 41 | **Drift / aging rate** (lineární + log(t) fit, ppb/den) | STM32 | 🟡 ⬅ #2; kryje i #27 |
| 42 | **Korelace f × teplota OCXO** (tempco, scatter + koef.) — teploty už reálné, kmitočet zatím sim | STM32 | 🟡 ⬅ #2; kryje i #27 |
| 43 | ✅ **[HW OVĚŘENO 2026-08-15 průchodem `HW_OVERENI_PRUCHOD.md`] Math Mx+B + NULL/relativní — IMPLEMENTOVÁNO 2026-08-01, čeká na HW.** Jádro `meas_math.c/h` (Y=M·X+B, NULL=relativní), okno MATH/LIMITY (s_view=31, dlaždice v Menu), selftest 8/8. Aplikuje na `screen_main_freq_hz()` (dnes SIMULACE → smysl po #2). Konfigurace **persistuje** v syscfg flash blobu (magic `"SCF6"`→`"SCF7"`). | STM32 | ✅ SW hotové; reálná data ⬅ #2 |
| 44 | ✅ **[HW OVĚŘENO 2026-08-15 průchodem `HW_OVERENI_PRUCHOD.md`] Limit / pass-fail test s alarmem — IMPLEMENTOVÁNO 2026-08-01, čeká na HW.** Meze lo/hi (pásmo ± kolem Y) → verdikt PASS/FAIL v okně; **průběžné vyhodnocení i mimo okno** (`g_meas_verdict`) → `alarm.c` beepne na hranu PASS→FAIL (armuje jen skutečným PASS, respektuje mute), počítadlo `g_alarm_limit_fail`. Selftest kryje pass/fail vektory. | STM32 | ✅ SW, staví na `alarm.c`; reálná data ⬅ #2 |
| 45 | **FFT fluktuací kmitočtu → odhad ℒ(f) (fázový šum, low-offset)** — příprava (STM má double FPU) | STM32 | 🟡 ⬅ #2 |
| 46 | **Export logu** (USB CDC / REST přes `datalog_read_back()`) — příprava | STM32 | souvisí #26; USB CDC transport už běží |
| 47 | ✅ **[HW OVĚŘENO 2026-08-15 průchodem `HW_OVERENI_PRUCHOD.md`] UI: okno PREHLED KANALU (horizontální bargrafy) — IMPLEMENTOVÁNO 2026-08-01, čeká na HW.** Sesterské okno k GRAFY (s_view=30, přepínač ve footeru obou, bez `nav_push`): všechny kanály (4 teploty + 12V/5V/REF/VBAT/OCXO Vc + RF dBm) jako vodorovné bary s nominálním markerem a číselnou hodnotou → odchylka od očekávané hodnoty na první pohled. Reálná data (`g_sensors[]`), per-řádek change-detect. **2026-08-06 granularita:** bary přepsány na **segmentované** (`HB_SEGS=45`) s **barevnými markery** — AKT (vyplněný úsek, zelená/amber), REF (accent nominal), **MIN (violet) + MAX (červená) z `g_sensors[].min/max`** (peak-hold rozsah); legenda `hbar_legend()`. Change-detect rozšířen o min/max. Opraveny 2 chyby v auditu: (1) legenda kolidovala s centrovaným titulkem → přesunuta do footeru; (2) RF řádek měl `nom=-1` sentinel, ale `lo=-80` → kreslil se falešný REF marker → sentinel na `-100`. ⚠️ **Segmentace NEBYLA kompilačně ověřena** (jen manuální review), na displeji taky ne. **Zbývá: build + ověřit vzhled na displeji.** | STM32 | — |
| 48 | **Modulation domain analyzer** (kmitočet vs čas s rychlým hradlem, ~ms) — vizualizace rozmítání/driftu/FM v čase; jádro klasického MDA (HP 53310A). Vyžaduje gap-free tok měření z FPGA. | STM32 + FPGA | 🟡 ⬅ #2, gap-free/CTA (souvisí #27); FPGA gate ~ms |
| 49 | **Disciplinační smyčka OCXO** (uzavřít EFC regulaci) — dnes Si5356 jede volně, OCXO Vc se jen měří (AIN0). Doplnit: PI regulátor kmitočtové/fázové chyby → EFC DAC/PWM, laditelná časová konstanta + tlumení, kompenzace zpoždění antény. **Odemyká skutečný „disciplinovaný" provoz** (dnes GPS-monitorovaný). | STM32 + HW | ⬅ #36 (fázová chyba jako vstup regulátoru) + HW (EFC výstup do OCXO) |
| 50 | **Odhad akumulované chyby v holdoveru** (± ns / ppb roste v čase bez GPS) — extrapolace z posledního známého driftu + OCXO tempco; napojit na holdover kužel (dnes ilustrativní `wf`) a na predikci #39. | STM32 | 🟡 ⬅ #36/#41 (změřený drift + tempco); UI kužel hotový |
| 51 | **Rozšířit zobrazení nejistoty** (rozlišení + ± chyba měřeného kmitočtu) — dnes jen `UI_DIGIT_SIGMA/FLOOR` na nejistých číslicích headline. Doplnit explicitní `± <val>` (kombinace: rozlišení z gate/√N reciproční + krátká σy@τ z ADEV + ppb ref) a „počet platných číslic". Návrh viz odpověď 2026-08-01. | STM32 | 🟡 ⬅ #2 (reálná σ); UI infra (digit sigma) hotová |
| 52 | ✅ **[HW OVĚŘENO 2026-08-15 průchodem `HW_OVERENI_PRUCHOD.md`] Warm-up / stabilizace OCXO — IMPLEMENTOVÁNO 2026-08-01.** `warmup_ready()` (app): „hotovo" = uptime ≥ 300 s A tepelný sklon `|dT/dt| < 0,08 °C/min` (z RAM historie 0x49 přes `sensor_hist`). Nahradilo naivní `uptime<180` ve stavu WARMUP okna Holdover; OCXO řádek ukazuje `45.2 C +0.03/m` (fialově dokud náběh). Kompilačně ověřeno. | STM32 | — (reálná HW data teplot už jsou) |
| 53 | ✅ **[HW OVĚŘENO 2026-08-15 průchodem `HW_OVERENI_PRUCHOD.md`] Self-survey (průměrování polohy) — IMPLEMENTOVÁNO 2026-08-01.** Okno SELF-SURVEY (s_view=32, tlačítko SURVEY v GPS okně): firmwarové Welford průměrování lat/lon/alt z platných fixů → horizontální rozptyl [m] = konvergence; START/STOP. Běží na pozadí (`survey_accumulate` v `app_gpsdo_tick`). START pošle i **UBX-CFG-TMODE2** survey-in (`gps_survey_in_cmd`) — best-effort (účinné jen na timing-grade RX, NEO-7M nejspíš NAKne). **Persist (2026-08-01):** STOP uloží výsledek do syscfg flash (magic „SCF7"→„SCF8") → přežije power-cycle, okno ukáže poslední polohu. Kompilačně ověřeno. | STM32 | firmwarové jádro HW-nezávislé; UBX efekt ⬅ timing RX |
| 54 | ✅ **[HW OVĚŘENO 2026-08-15 průchodem `HW_OVERENI_PRUCHOD.md`] Uložit/načíst sestavu — IMPLEMENTOVÁNO 2026-08-01.** Okno SESTAVY (s_view=33, tlačítko v Nastavení): 8 číslovaných slotů (jas/téma/jazyk/zvuk/zóna/efekty/animace + Math+limity) do W25Q **SETUP regionu** (`setup.c/h`, wear-leveled `w25q_store`, 1 blob = všechny sloty). NAČÍST aplikuje i téma/jas. ⚠️ **Region mapa: DATA_BASE 0x020000→0x030000** (SETUP 64 KB vloženo) → datalog se po flashi jednou založí znovu (staré logy osiroti, benigní). Kompilačně ověřeno. | STM32 | — |
| 55 | ✅ **Export obrazovky — DOKONČENO 2026-08-15:** `screenshot sd` uloží `SHOTnnn.BMP` přímo na SD kartu. Vyřešeny všechny tři slabiny USB varianty: **tearing** (snímek se zkopíruje do SDRAM scratche, teprve pak zapisuje — UiTask jinak stihne během zápisu flipnout), **spolehlivost** (FatFs zapíše celý soubor; USB tok byl best-effort a při zahlcení ringu zahazoval) a **praktičnost** (vytáhneš kartu místo terminálových triků). USB varianta zůstává pro běh bez karty. Původní zápis: **ROZPRACOVÁNO 2026-08-01.** UART `screenshot`: front FB (RGB565 800×480, `prim_stm32_front_addr`) → 24-bit BMP přes USB CDC (`screenshot.c/h`). ⚠️ EXPERIMENTÁLNÍ: ~1,15 MB = sekundy, tok jen chunk+pump+osDelay (best-effort, při zahlcení ringu může zahodit). **Zbývá:** spolehlivý flow-control (blokující write-with-drain nebo handshake), příp. RLE/PNG komprese. | STM32 | USB CDC transport běží |

#### High-end funkce (metrologická třída — z porovnání 53230A / 5120A/5125A / CNT-104S / FSWP / TimePod, 2026-08-01)

| # | Úkol | Strana | Závislost / blokátor |
|---|---|---|---|
| 56 | **Ω / Π / Λ counter weighting** — lineárně-regresní (least-squares) odhad kmitočtu místo prostého/trojúhelníkového hradla; sníží šum měření ~√3× (Kramer/Klische). Hlavní SW rozdíl high-end čítačů. | STM32 | 🟡 ⬅ #2 + gap-free hrany (#62/#27); čistě SW |
| 57 | **Theo1 / ThêoH + PDEV** — moderní estimátory stability: Theo1/ThêoH lepší dlouhé-τ z kratších dat, PDEV (parabolic deviation) sladěná s Ω-counterem (#56). Doplněk k ADEV/MDEV/HDEV pyramidě. | STM32 | 🟡 ⬅ #2; SW nad pyramidou |
| 58 | **DMTD — dual-mixer time difference** (heterodyn dvou ~stejných kmitočtů → fáze v ps/fs). **THE high-end technika** pravého fázového analyzátoru (5120A/TimePod) — měří stabilitu OCXO řádově pod přímým čítáním. | HW + STM32 | 🔴 HW: směšovač + pomocný oscilátor + nízkofrekv. ADC; pak SW analýza |
| 59 | **Cross-correlation phase noise** (2 nezávislé reference, křížové spektrum → potlačení vlastního šumu měřidla, FSWP/5125A) | HW + STM32 | 🔴 2 kanály + 2 reference (HW) |
| 60 | **Exaktní TIE / MTIE / TDEV + telecom masky** — z uložené fáze (ne odhad z ADEV jako dnes); overlay masek **G.823 / G.8262 (SEC/EEC)** = sync-test verdikt. Rozšíření mask-testu (#44) na křivkovou masku. | STM32 | 🟡 ⬅ #36 (1PPS TIC = uložená fáze) |
| 61 | **Dekompozice jitteru** (RJ/DJ, TJ, PJ, DDJ/ISI), **bathtub curve**, jitter spektrum/transfer — SI analýza hodin/dat | STM32 + HW | 🔴 ⬅ 2. kanál + rychlé timestampy (#62) |
| 62 | **Zero-dead-time continuous timestamping + hluboká paměť** (1–10 M timestampů → libovolná statistika offline; 12+ číslic/s, čtení až ~1 MSa/s). Odemyká #56 i offline ADEV/histogram. | FPGA + STM32 | 🔴 ⬅ FPGA stream timestampů (protokol v2, #4) |
| 63 | **Trigger / arming** — externí arm/gate vstup, trigger holdoff, trigger na N-tou událost, nastavitelná hystereze, delayed/pre-trigger | HW + STM32 | 🔴 HW (arm vstup + programovatelný komparátor) |
| 64 | **Vstupní front-end vyšší třídy** — prescaler kanály do GHz–desítek GHz (mikrovlnný down-convert), šířkopásmové filtry, nastavitelná citlivost/práh, 50 Ω/1 MΩ, diferenciální/vysokoimpedanční | HW | 🔴 analog; dnes strop ~1,4 GHz (MAX9601) |
| 65 | **Telecom timing rozhraní** — IEEE 1588 **PTP** (GM/slave), **SyncE**, **IRIG-B**, **NTP/ToD** + distribuční **1PPS / 10 MHz výstupy** s health flagy | CM4 + HW | ⬅ ETH na CM4 (#24–26) + výstupní HW |
| 66 | **PLL lock / settling time + FM/PM/AM demodulace** (rozšíření modulation domain #48) — doba ustálení po skoku, deviace, chirp | STM32 + FPGA | 🟡 ⬅ #48 + front-end |
| 67 | ✅ **[HW OVĚŘENO 2026-08-15 průchodem `HW_OVERENI_PRUCHOD.md`] Prezentace měření (SW cluster) — JÁDRO HOTOVO 2026-08-07, okno PENDING.** Pure-logic `meas_present.c/h` (perioda T=1/f, **odchylka od nominálu ve volitelných jednotkách Hz/ppm/ppb/ppt/rel**, auto-nominál = nejbližší kulatá reference, **freq offset**, statistika N vzorků Welford **mean/σ/min/max/p-p**, **TFOM** odhad z GPS kvality). Selftest **11/11** (`mp_selftest`, wired do run_selftests). **Okno MĚŘENÍ (s_view=34) HOTOVO 2026-08-07** — sesterské k Čítači (footer „MERENI >" / „< CITAC", bez nav_push): řádky Primární (FREKV/PERIODA toggle), Nominál (auto), Odchylka (cyklus jednotky), Offset, TFOM, N/Průměr/σ/p-p; tlačítka MODE/JEDNOTKA/RESET. Vzorky statistiky z `app_gpsdo_tick_stats_sample` (1/s, jen RUN). ⚠️ Aplikuje na `screen_main_freq_hz()` = DNES SIMULACE → plný smysl po #2. **Zbývá:** manuální nominál (dnes jen auto), min/max capture s časovou značkou + error budget (#51), persist mode/unit v syscfg. | STM32 | ✅ jádro+okno; reálná data ⬅ #2 |
| 68 | ✅ **[HW OVĚŘENO 2026-08-15 průchodem `HW_OVERENI_PRUCHOD.md`] Autokalibrace / self-check — ROZPRACOVÁNO 2026-08-01.** `autocal.c/h`: verifikace (guard-band) referencí a napájení z `g_sensors` (VREF ~2,5 V, 12V/5V ±5 %, VBAT) → PASS/WARN/FAIL. UART `autocal` (report) + tlačítko **AUTO-CAL** v okně Kalibrace (výsledek do status řádku). **Staged** (jasně označené, zatím se neprovádějí): ADC3 HW self-cal (⬅ koordinovaný reinit v SensorsTasku — ADC3 vlastní SensorsTask), timebase offset vs GPS (⬅ #2), RF slope/intercept (⬅ externí RF reference → manuální okno Kalibrace). Bezpečné (nic nezapisuje do HW). Kompilačně ověřeno. | STM32 | verifikace hotová; coefficient auto-set ⬅ ext. reference / #2 |
| 70 | ✅ **HOTOVO 2026-08-23 — okno PAMETI (s_view=43) + UART `membench`.** Dlaždice **PAMETI >** v Nastavení → tlačítko **BENCHMARK**. 6 cílů (DTCM / AXI SRAM / SRAM1 D2 / SDRAM / interní FLASH bank1 jen čtení / W25Q QSPI): rychlost zápisu i čtení **a hledání chybných bitů** (vzory 0x00/0xFF/55-AA/adresa/náhodný + test adresních linek + retence 1 s u DRAM). Naměřeno: TCM/SRAM ~180 MB/s, SDRAM 14 zápis / 31 čtení MB/s, W25Q 4,5 MB/s čtení a 240 kB/s zápis. ⚠️ Běží v **UartTasku** (jediný nehlídaný watchdogem); UI jen nastaví `g_membench_req`. ⚠️ Testuje **jen vyhrazené oblasti** + před SDRAM běží reverzibilní kontrola, že se blok nepřekrývá s framebuffery. **Odhalil dvě skutečné závady** — viz #72 a oprava haldy lwIP (`LWIP_RAM_HEAP_POINTER` ležela v SRAM1 = cizí paměti → shazovalo CM4). Detaily: `CLAUDE.md` „Benchmark pamětí”, test `HW_OVERENI_PRUCHOD.md` §7g. | STM32 | ✅ ověřeno na HW 2026-08-23 (0 chybných bitů, CM4 přežije) |
| 71 | ⬜ **Kontrola využití vnější RAM (SDRAM 32 MB @ `0xC0000000`, FMC).** Ověřit z `.map` + linkeru, co reálně leží ve vnější SDRAM a co ne. Dnes ji dle CLAUDE.md („SDRAM mapa") mají obsadit: **framebuffery FB0/FB1/FB2 + off-screen canvas pool** (region 0, 4 MB WT), **Region 1** (`sdram` test/scratch, 4 MB WBWA), **`.sdram` linker sekce** `0xC0800000` (libprim glow scratch + `bg_cache` předrenderované pozadí). Otázka: **využíváme ji, nebo velký kus z 32 MB leží ladem?** Zkontrolovat (a) že to, co MÁ být v SDRAM (`bg_cache`, glyph A8 atlas, ADEV/trend pyramidy?), tam podle `.map` **skutečně je** a neskončilo omylem v interní RAM; (b) kolik z 32 MB je fakticky obsazeno; (c) kandidáti na přesun z interní **RAM_D1** do SDRAM (velké statické buffery — `FIL` 512B sektory, `sensor_hist`, screenshot scratch) kvůli uvolnění interní RAM. ⚠️ Přesun něčeho časově kritického (SPI/DWT cesty) prověřit na latenci — SDRAM je pomalejší a cachovaná dle regionu (MPU WT/WBWA). ⚠️ Koherence u DMA2D (region 0 WT) beze změny. Zdroj pravdy = `H757_LED_CM7.map` + `MPU_Config` + `STM32H757BITX_FLASH.ld`. Souvisí s #70 (benchmark pamětí). | STM32 | nezávislé; čistě audit `.map`/linker |
| 72 | 🔴 **HW: prozvonit spoj `PF15` (FMC_A9) → A9 na SDRAM — adresy v SDRAM se opakují po 2 MB.** Zápis na `0xC0400000 + 2 MB` skončí na `0xC0400000` (dvě adresy = tatáž buňka). Důkazy jsou systematické: přesně **524 288** chybných bitů (= 1 bit na slovo v dolní polovině), na `0xC0400000` přečteno `0x00080000` (hodnota zapsaná o 2 MB dál) a vzory `0x00`/`0xFF`/`55-AA` prošly bez chyby (konstanty překryv nerozliší, `55/AA` závisí jen na paritě indexu, která se posunem o **sudé** 2 MB nemění). Odpovídá to **nefunkční adresní lince FMC_A9 = PF15** (řádkový bit 9 ↔ `HADDR[21]`; při 16bit sběrnici je řádek `HADDR[24:12]`). **Firmware je v pořádku** — `PF15` je v `.ioc` i v `HAL_GPIO_Init(GPIOF, …)` s `GPIO_PIN_15` → podezření míří na **HW (spoj / pájka)**. ⚠️ **INTERMITENTNÍ — objevuje se a mizí mezi běhy**, což sedí na **studený spoj**. Krátce to vypadalo na collateral od padající CM4, ale **to je vyvráceno**: v běhu, kde byla CM4 zdravá (žádný `stall:CM4`, všechny cíle OK), se alias **přesto vrátil**. 🔴 **Nejdražší důsledek:** `FB2` (`0xC0200000`) se od `FB0` (`0xC0000000`) liší **právě jen v `HADDR[21]`** → mohly by **sdílet paměť** a triple buffering by byl fakticky double (blikání/trhání, které by nikdo nespojoval s pamětí). **`membench` to od 2026-08-23 přímo testuje** (`fb_alias`) a vypíše buď `!! FB0 … a FB2 … SDILEJI PAMET`, nebo `(framebuffery se ale navzajem NEprekryvaji)`. **Než se sáhne na cokoli v zobrazovacím řetězci, přečíst tenhle řádek.** | STM32 (HW) | ⬅ potřebuje prozvonit desku; FW změnu nevyžaduje |
| 73 | ⏸️ **ODLOŽENO 2026-08-23 — rozhodnuto: GNSS zůstává zatím JEN GPS.** (Původně: přijímat i Galileo.) ✅ **Žádná změna kódu není potřeba** — ověřeno, že firmware žádné souhvězdí nevnucuje: `gps_config_gnss()` (UBX-CFG-GNSS, zapíná GPS+SBAS+QZSS+GLONASS) se volá **jen** z UART příkazu `gps glonass`, nikdy z `gps_init()`, a posílá se **bez UBX-CFG-CFG save**, takže platí jen do power-cyklu. Přijímač tedy jede na své vlastní konfiguraci = GPS. Až se k tomu vrátíme, platí tahle analýza: **Galileo (`gnssId = 2`) v `gps_config_gnss()` chybí** — stačil by pátý `gnss_block(…, 2, 4, 8, 1)` a zvýšený `numConfigBlocks`; **parser už připravený je** (`GAGSV` se rozebírá per-talker, `gps_constel_t` má Galileo, PRN se zobrazuje s RINEX prefixem `E`). ⚠️⚠️ **HLAVNÍ HAČEK — HW: NEO-7M Galileo NEUMÍ** (přišla až s řadou **NEO-M8**, FW 3.01+; NEO-7 zvládá jen GPS/GLONASS/QZSS/SBAS). Zapnutí bloku by na osazeném modulu **nic nezměnilo**. První krok tedy není firmware, ale **zjistit, jaký modul je fyzicky osazený** (UART `gps` → řádek `Přijímač` je dnes napevno „NEO-7M“ — přečíst reálně přes UBX-MON-VER); s NEO-7M je to **výměna modulu**, ne změna kódu. ⚠️ u·blox obvykle zvládne **3 soustavy současně** (GPS povinná + 2), takže GPS+Galileo+GLONASS naraz nemusí projít. | STM32 (+ HW) | ⏸️ odloženo na přání; obnovit až s NEO-M8 |

### Přechod na dvě jádra (CM7 / CM4)

> **Plán a odůvodnění: `Frequency_Counter_STM32H757/NAVRH_ARCHITEKTURA_CM7_CM4.md`**
> (rozdělení tasků mezi jádra, IPC, CPU rozpočty, fázování). **§11 = revize 2026-07-20** —
> opravuje kritickou chybu v návrhu IPC a srovnává plán se stavem po v0.4.0.
> Číslování navazuje na tabulku výše, odkazy `#N` platí napříč celým souborem.
>
> **Rozdělení:** **CM7 = přístroj** (měření, matematika, UI, storage — má double FPU a cache),
> **CM4 = konektivita** (ETH/lwIP, SCPI, webserver — dnes leží 240 MHz ladem).
> Mezi jádry teče jen malý definovaný stav: snapshot + příkazové ringy. Žádné sdílené
> periferie, žádný sdílený FatFs, žádné křížové HAL handly.
>
> ⚠️ **Zlaté pravidlo kapitoly:** síťová větev (#24–#26, #30) **nesmí předběhnout #2**.
> SCPI server, který na `MEASure:FREQuency?` vrátí simulovanou náhodnou procházku, je horší
> než žádný — vypadá totiž věrohodně. Totéž platí pro webové API.

| # | Úkol | Strana | Závislost / blokátor |
|---|---|---|---|
| 19 | ✅ **MPU region pro SRAM4 + korektní seqlock — HOTOVO 2026-08-09.** MPU region 2 (`0x38000000`, 64 KB, NON-CACHEABLE + shareable) v `main.c` `MPU_Config`; linker sekce `.ipc_shared` @RAM_D3; `ipc_shared.h` = celá sdílená struktura + seqlock s `__DMB()` bariérami (`ipc_snap_publish_begin/end`, `ipc_snap_read_begin/retry`) + SPSC cmd/resp ringy. Korektnost kryje `ipc_selftest` (seqlock parita + ring push/pop/wrap/full/empty) = **13. selftest** (`run_selftests`). | CM7 | **Návrh IPC by v dnešní podobě NEFUNGOVAL.** `MPU_Config()` v `main.c` má jen region 0 (framebuffery, WT) a region 1 (scratch, WBWA); pro `0x38000000` (SRAM4) **žádný region není** → platí výchozí mapa ARMv7-M, kde je `0x20000000–0x3FFFFFFF` *Normal cacheable write-back*. CM7 by si sdílenou paměť nakešoval: zápisy uvíznou v D-cache (CM4 bez cache je neuvidí), čtení vrací zastaralé řádky. Seqlock to nezachrání — kešuje se i samotné `seq`. **Fix:** MPU region 2 na `0x38000000`, 64 KB, **NON-CACHEABLE** + shareable. ⚠️ **Write-Through NESTAČÍ** (řeší jen směr CM7→paměť; čtení CM7 by pořád šlo z cache, a IPC je obousměrné). **Navíc:** seqlock musí mít `__DMB()` bariéry na obou stranách a `seq` jako `volatile` — jinak přeuspořádání zápisů. Korektní vzor v `NAVRH…md` §11.1–11.2. Nezávislé na #2. |
| 20 | ✅ **Oživení CM4 + IPC — HOTOVO, RUNTIME OVĚŘEN NA HW 2026-08-14.** `status` → `CM4: alive (IPC heartbeat), stall x0`, header `4:xx%`. Obousměrný round-trip potvrzen: CM4 přijal snapshot (ověřil magic+verzi, jinak by mlčel) **a** publikuje heartbeat zpět. **🔴 KLÍČOVÉ POUČENÍ: „CM4 nebootuje / bank2 neflashnutá" BYLA MYLNÁ DIAGNÓZA.** Option bytes byly správně už z výroby (`BCM4=1`, `BOOT_CM4_ADD0=0x810` — ověřeno čtením přes CubeProgrammer CLI) a bank2 flashnutá. CM4 maskoval **připojený debugger**, který rozbíjí boot handshake CM7↔CM4 (HSEM/`D2CKRDY`) → boot gate vyprší → `g_cm4_absent=1` → „4:off". Táž sonda dělala i **falešné HardFaulty** (`HF@24000000`, `HFSR` bit31 DEBUGEVT = leftover flash breakpoint přes FPB). **Pravidlo: CM4 testuj VÝHRADNĚ po čistém power-cyklu bez debug session** (Terminate + Remove All Breakpoints). **CM4 CPU%** (2026-08-14): CM4 měří vlastní zátěž přes DWT a publikuje ji v heartbeatu → header `4:xx%` (dnes ~0 %, naskočí s ETH/SCPI). **Zbývá:** producent cmd ringu = SCPI/web na CM4 (⬅ ETH, HW-blokované: PHY dostává 10 MHz místo 25). Původní zápis níže. — 🔶 **OBĚ STRANY NAPSÁNY 2026-08-09.** **CM7** `ipc.c`: `ipc_init`/`ipc_publish` (seqlock, **jen reálná data**, ~2 Hz z defaultTask; sigma/offset/drift ZÁMĚRNĚ neplněné dokud #2)/`ipc_service` (cmd→resp NOP echo skeleton)/`ipc_cm4_alive`/`ipc_selftest`. **CM4** `ipc_cm4.c/h` (NOVÉ): `ipc_cm4_check` (ověří magic/verze/size), `ipc_cm4_read` (seqlock čtení snapshotu, bounded retry ≤8 — CM4 se nesmí zaseknout), `ipc_cm4_heartbeat` (publikuje živost → CM7 „4:xx%"). Zapojeno v CM4 `main.c` smyčce (LED_2 = viditelný důkaz: svítí při GPS fixu ze snapshotu). Sdílený `ipc_shared.h` přes **relativní include** (regen-safe, CM4/CM7 sourozenci). **CM7 konzumuje CM4 heartbeat 2026-08-09:** defaultTask volá `ipc_cm4_alive()` → `g_cm4_alive` → CPU blok headeru trojstav **`4:OK`** (zeleně, IPC živá) / `4:--` (D2 ready ale ticho) / `4:off` (nenabootoval) — obousměrný link je **kódově kompletní**. **Snapshot v2 (2026-08-09, `IPC_VERSION` 1→2):** doplněna **plná sada instrument-state** (teploty OCXO/deska/MCU, napětí 12V/5V/VREF/VBAT/Vc, RF mV + **AD8307 kalibrace**, Si5356 stav, kanál) → CM4 obslouží SCPI/web (`MEAS:VOLT?/SYST:TEMP?/MEAS:POW?`) **bez `g_sensors`/`g_calib`** (na CM4 nejsou). Vyplynulo z **kritické validace rozdělení jader** (NAVRH §11.8: měření zůstává CM7, CM4 = konektivita; snapshot = datový kontrakt). **v3 (2026-08-09) = Math cfg config sync:** čtení přes cfg mirror ve snapshotu, zápis přes cmd ring `IPC_CMD_CFG_SET` (`ipc_cfg_apply` → `g_meas_cfg` na CM7, který zůstává jediný zapisovatel); `ipc_cmd_t` rozšířen o `double argd` (plný rozsah lo/hi/m/b). CM4 tak obslouží `CALC:` dotazy i SET. **Validace (bez HW):** CM7 i CM4 kompilačně čisté (`-Wall -Wextra -Wshadow`); **celý CM4 image RELINKNUT OK** (SRAM2 @0x10020000, ~2 KB/160K). **HW aktivace = `DUALCORE_BRINGUP_CHECKLIST.md`** (option bytes BCM4/BOOT_CM4_ADD0, flash bank2, SRAM4 clock, .ioc regen pozor, ověřovací postup). **Zbývá (⬅ bank2/.ioc/HW):** option bytes + flash bank2, **runtime round-trip**, SRAM4 clock, IWDG2/`stall:CM4`, producent cmd ringu (⬅ SCPI/web na CM4). | oba | ⬅ #19. Kód obou stran hotový+relink OK; runtime ⬅ bring-up doc. Nezávislé na #2. |
| 21 | ✅ **Liveness CM4 — OVĚŘENO NA HW 2026-08-14:** `status` hlásí `CM4: alive (IPC heartbeat), stall x0`, header `CM4:xx%`. Heartbeat i detekce stallu běží. ⚠️ **IWDG2 zůstává ZÁMĚRNĚ VYPNUTÝ** — změřeno, že jeho reset scope je system-wide, ne per-core (zaseknutá CM4 by shodila i displej a měření); zaseknutí se neztratí, CM7 ho vidí přes heartbeat (`stall:CM4` + `g_cm4_stall_count`). Původní zápis: **NAPSÁNO 2026-08-09.** **IWDG2 na CM4** (`iwdg2.c/h`): nezávislý watchdog ~4 s, registrová sekvence (zrcadlo CM7 `watchdog.c`), kick v CM4 smyčce → zaseknutá smyčka resetuje CM4. **stall:CM4 na CM7** (`freertos.c` defaultTask): hrana heartbeatu alive→dead → log `stall:CM4` + `g_cm4_stall_count` (UART `status`). **⚠️ CM7 se kvůli mrtvému CM4 NEresetuje** (§11.4) a **NEsahá na crash black-box** (ten = příčina resetu CM7); CM4 se zotaví sám IWDG2. Kompilace čistá + CM4 relink s IWDG2 OK (~1,7 KB/160K). **🔴 OVĚŘIT NA HW: reset scope IWDG2** — předpoklad CPU2/CM4-only (per-core, `RCC_RSR_IWDG2RSTF` bit 27); kdyby byl system-wide, shodil by CM7 → nepoužívat (viz `DUALCORE_BRINGUP_CHECKLIST.md` §8). SYS pill amber při stallu = snadný follow-up. | oba | ⬅ #20. Kód hotový; runtime + reset scope ⬅ HW. |
| 22 | ✅ **Rozdělit D2 SRAM mezi jádra — HOTOVO 2026-08-09 (bankově zarovnané).** D2 (288K = SRAM1 128K + SRAM2 128K + SRAM3 32K) rozděleno: **SRAM1 (128K) → CM7** (`RAM_D2 @0x30000000 LENGTH 128K` v obou CM7 linkerech; diagnostický `ram write/read` @0x30001000 ~78 KB se do SRAM1 vejde, CM7 do RAM_D2 nic nelinkuje), **SRAM2+3 (160K) → CM4** (`RAM @0x10020000 LENGTH 160K` v CM4 FLASH.ld — sjednoceno s CM4 `_RAM.ld`, který tuto konfiguraci už měl). **Validace (bez HW):** all 4 linkery parsují; **CM4 relink novým skriptem OK** (sekce @0x10020000, fit 1,6 KB/160K, `_estack` vrchol 0x10048000 beze změny); CM7 map = do D2 nelinkuje NIC; regiony disjunktní. ⚠️ HW-gated: CM4 skutečně bootující z bank2 + D2 SRAM2/3 clock enable z CM4 (jeho boot). | oba | ✅ linker split hotový + validovaný; runtime ⬅ CM4 bring-up (bank2/HW). |
| 23 | **Audit per-core RCC enable bitů** | oba | Na H7 má každé jádro vlastní sadu `RCC_C1_*ENR` / `RCC_C2_*ENR` — periferie přiřazená CM4 musí mít hodiny zapnuté **z CM4**. CubeMX to řeší přiřazením kontextu, ale tenhle projekt má hodně **ručních initů v USER CODE** (`MX_I2C1_Init` v `i2c.c`, `fpga_freq_init`, `beeper_init`, `watchdog_init`, …) a tam se to snadno mine. Projít při každém přesunu periferie mezi jádry; zapsat do `CUBEMX_CHECKLIST.md`. |
| 24 | 🟢 **F0 HOTOVO — PHY ŽIJE (2026-08-22, v0.6.0). ETH hardwarově odblokován.** Dvě příčiny, obě vyřešené: **(1) hodiny** — X1/TCXO vyměněn 10→**25 MHz**, HSE přepočten (CLAUDE.md „Přechod 10→25 MHz"); **(2) 🔑 chyběl RBIAS rezistor** — LAN8742A pin 24 vyžaduje **12,1 kΩ 1 % do GND** (bias vnitřní analogové části); bez něj PLL neběžela → REF_CLK=0 + mlčení na MDIO, přestože hodiny/VDD/reset byly OK. Diagnóza z přečtení schématu (pin 24 měl no-connect). Po osazení 12,1 k: `eth` → **`PHYAD 0: ID 0x0007C131 (LAN8742A), PHY ZIJE`**. ⚠️ **Bit-bang SMI čtení mělo TA offset o 1 bit** (ID vyšlo 0x000F8263 = 0x0007C131<<1) → opraveno (2 TA takty → 1). **Všech 11 CPU↔PHY pinů ověřeno proti schématu 4/7+2/7** (PA1/PA2/PA7, PC1/PC4/PC5, PB13, PG11-14). **F1 + F3 HOTOVO 2026-08-22:** ETH přiřazen v `.ioc` kontextu **CortexM4**, CM4 čte PHY ID přes `HAL_ETH_ReadPHYRegister` → IPC **v6** (`eth_phy_id`/`eth_init_ok`) → System Health `CM4:OK PHY:C131` + UART `status`. Regen odhalil 3 pasti (všechny opravené): build spadl na obou jádrech (IDE nepřegenerovalo makefily → chyběl FatFs/HAL ETH; → `scripts/build.sh`), `MX_ETH_Init` volal `Error_Handler()` = `while(1)` na CM4 (shodilo by dvoujádro → degradovaný `return`), a ETH DMA deskriptory ležely na CM4 aliasu `0x10020010` v `.data`, kam DMA nedosáhne (→ region `ETH_D2 @0x30040000`, `RAM` 160K→128K). **F5 KÓD HOTOVÝ 2026-08-22 (NEOVĚŘENO NA HW):** lwIP **NO_SYS=1** (bare-metal, F4 rozhodnuto — CM4 nemá RTOS) zaveden **ručně** z `STM32Cube_FW_H7_V1.13.0` (30 `.c` + `lan8742` BSP; v `.ioc` LWIP není), glue `CM4/LWIP/Target/ethernetif.c` + `CM4/LWIP/App/lwip_app.c`, **DHCP klient** startovaný link callbackem, IP/link/speed publikované přes IPC → UART `status` (`NET: UP 100 Mbit full, IP …`). Ošetřeny 4 tiché zabijáky: RX buffer 1000 vs `RxBuffLen` 1536, **rozcházející se MAC** (lwIP bral `ETH_MAC_ADDR*`, HW filtr měl jiný → ARP by odpovídal špatnou adresou), duplicity s generovaným `eth.c` (deskriptory/handle/MspInit) a `SCB_InvalidateDCache_by_Addr` (CM4 nemá D-cache). **Smyčka CM4 přestavěna** — končila `HAL_Delay(800)`, což by přeteklo RX ring; teď lwIP ~1000×/s, IPC/LED 5 Hz. Paměť: RAM 30/128 KB, `.eth_dma` 12,7/32 KB, obraz 84,6 KB. **Zbývá:** flash obou bank + HW: `ping`, `ping -f` (izolace jader), a **fallback na statickou IP** (okno SÍŤ ukládá, ale IPC snapshot ta pole zatím nenese). Diagnostika = UART `eth`/`eth clk` (bit-bang SMI z CM7, piny si nastavuje sám, nic v `.ioc`). PUVODNI POPIS: **ETH + lwIP na CM4** (RMII PHY je na desce) | CM4 | ⬅ #20, #22. **W5500 modul NENÍ potřeba** — nativní MAC+PHY (LAN87xx) je osazený, modul by byl krok zpět (~10 Mbit, druhý stack mimo kontrolu, blokuje SPI). Deskriptory a RX buffery v D2 = domácí doména CM4, který **nemá D-cache** → odpadají cache pasti ETH DMA. **PHY POTVRZEN ze schématu (list 4/7 `Ethernet.kicad_sch`, 2026-08-06): `LAN8742A` (U4)**, RMII, magnetika TG110-E050N5xx, RJ45 J8. Ref. hodiny: **25 MHz** (ECS-2520MV X1) na `XTAL1/CLKIN` (pin5) → PHY interní PLL → **REFCLKO (pin14, INT/REFCLKO) = 50 MHz RMII** zpět do MCU `ETH_REF_CLK` (R21 33Ω) = režim „REF_CLK OUT". Strapy: R22–R26 (10k) na RXD0/MODE0, RXD1/MODE1, CRS_DV/MODE2, RXER/PHYAD0 — ⚠️ **PHYAD dopočítat ze skutečných pull-up/down (pravděpodobně 0 nebo 1), musí sedět s `ETH` HAL/lwIP konfigurací** (autoneg 10/100). `ETH_RES` (nRST) pulz při initu nutný. Zbývá: potvrdit PHYAD osazením a `ETH_INT`. |
| 25 | 🔶 **SCPI server — USB STRANA KOMPLETNÍ 2026-08-15, TCP čeká na CM4/ETH.** Dnes doplněno: **SET** (`SENS:FREQ:GATE/CHAN`, `INIT`/`ABOR`/`READ?` → přestalo být read-only), **STATus OPER/QUES** event+enable registry s latchováním hran + summary bity v `*STB?`, `DISP:BRIG`, `*OPT?`, `CONF:FREQ`. Selftest ~130 assertů. ⚠️ Zbývá jen `SYST:DATE/TIME` **set** (RTC vlastní defaultTask → chce request-most; hodnotu má jen bez GPS antény) a subsystémy vázané na chybějící HW (TRIG/INPut/CAL). Původní: **JÁDRO + USB HOTOVO 2026-08-07 (hand-rolled), TCP čeká na CM4.** Transportně nezávislé jádro `scpi.c/h`: parser (case-insensitive, krátká/dlouhá forma MEAS↔MEASure, `:` hierarchie, `?` dotazy) + příkazy vracející **reálná data** (`g_sensors`/`gps_get`/FPGA driver): `*IDN? *OPC? *RST *CLS`, `SYST:VERS?/ERR?/TEMP?/GPS:STAT?/GPS:TIME?/GPS:POS?`, `MEAS:FREQ?`, **`MEAS:FREQ:DIV16?`** (/16 větev), **`CALC:DATA?`** (Math m·X+b/NULL) + **`CALC:LIM:FAIL?`** (limit pass/fail, oba přes `meas_math`), `STAT:OPER:COND?`. ⚠️ Golden rule: `MEAS:FREQ?` = **reálný FPGA** (`fpga_freq_get_last`), NE sim → SCPI NaN `9.91E37` dokud #2. Bez `%f` (celočíselná extrakce). **USB napojeno**: konzolový příkaz `scpi <cmd>` (`freertos_task_uart.c`). **Error queue + SET příkazy HOTOVO 2026-08-08:** `SYST:ERR?` popuje 8-místnou frontu (`*CLS` maže, neznámý příkaz → −113); **SET + parsování argumentů** (číslo `1e6`/`-2.5`/`1.5E-3`, bool `ON/OFF/1/0`) — `CALC:MATH:STAT/M/B`, `CALC:NULL:STAT/ACQ`, `CALC:LIM:STAT/LOW/UPP` (+ `?` readback), zápis `g_meas_cfg` z UartTasku pod krátkou kritickou sekcí (bez roztrženého double). ⚠️ modulová error queue = 1 session, TCP potřebuje per-session kontext. Selftest rozšířen (parser + fronta + nové dotazy + arg parsery + setter nad lokální cfg). Zvoleno **hand-rolled** (0 vendored kódu, testovatelné) místo libscpi. **Rozšíření stromu 2026-08-09 (vše reálná HW data):** `SYST:UPT?` (uptime), `MEAS:VOLT? [P12\|P5\|VC\|VREF\|VBAT]` (napětí větví z ADS/ADC3, ve V), `MEAS:POW?` (RF dBm z AD8307 přes `g_calib`), `SENS:FREQ:GATE?` (hradlo [s]) + `SENS:FREQ:CHAN?` (kanál z posledního FPGA rámce). **Per-session kontext HOTOVO 2026-08-09:** chybová fronta + status registry (ESR/ESE/SRE) přesunuty z modulových globálů do `scpi_ctx_t` → `scpi_process_ctx(ctx,…)` (nezávislé session), `scpi_process(…)` = tenký wrapper nad sdíleným defaultem (USB konzole beze změny). Selftest má i **test izolace dvou kontextů**. Souběžný TCP 5025 teď jen alokuje `scpi_ctx_t` per spojení. **MMEMory (datalog) HOTOVO 2026-08-09:** `MMEM:CAT?` (souhrn: backend/records/capacity/seq/errors/wrapped), `MMEM:DATA:COUN?` (počet), `MMEM:DATA? <n>` (n-tý záznam od konce jako CSV seq,t_unix,freq,teploty,Vc,RF,flags,sats,HDOP; reálná logovaná data, freq z FPGA=0 dokud #2). Selftest cache-dotazy (bez flash I/O). **Zbývá:** TCP 5025 ⬅ ETH/CM4 (#24); reálná `MEAS:FREQ?` ⬅ #2; `CALC:ADEV?/DRIFt?` ⬅ #2 (dnes simulace → porušily by zlaté pravidlo). **✅ ABSTRAKCE ZDROJE DAT HOTOVO 2026-08-10:** `scpi.c` jádro (parser+handlery) je teď **DATA-SOURCE nezávislé** — čte z `scpi_src_t` (scpi.h: instrument-state + validity bity `SCPI_V_*` + akce callbacky `set_cfg`/`read_log`). **CM7 backend** `scpi_src_load_cm7` (pod `#if CORE_CM7`) plní z `g_sensors`/`gps_get`/`fpga_freq`/`g_calib`/`g_meas_cfg`/datalog; SET→`g_meas_cfg` (kritická sekce), readback = snímek `src->meas`. `scpi_process(line,out,sz)` = wrapper (načte CM7 src) → **USB volající beze změny**. **Validace 2026-08-10: jádro se přeložilo jako `-DCORE_CM4`** (izolovaný test, ne v obraze CM4) = důkaz nezávislosti; selftest má test s platným zdrojem (MEAS:FREQ?→10 MHz, SYST:TEMP?→45,1). **W1+W2 HOTOVO 2026-08-23** (`WEB_UI_PLAN.md`): ovládací most `g_ui_cfg_req` doplněn o GATE/CHAN/RUN/LOG (dřív jen Math/limity), a `scpi.c`+`meas_math.c` teď **skutečně běží v obraze CM4** (ne jen izolovaný test) — CM4 spouští `scpi_selftest()` při bootu, výsledek jde přes IPC v7 → `status` „SCPI(CM4): selftest PASS". ⚠️ **Ten skutečný pokus odhalil, že izolovaný test z 08-10 nebyl úplný důkaz:** `SYSTem:DATE/TIME` a `DISPlay:BRIGhtness` sahaly na CM7 globály (RTC, jas) **mimo** `#if CORE_CM7` guard → build v CM4 obraze spadl. Opraveno `#else` větví vracející SCPI-99 `-241 "Hardware missing"`. Čtecí i zapisovací půlka IPC mostu (`ipc_scpi_src_from_snap`/nové `ipc_scpi_set_cfg`) přesunuty do sdíleného `ipc_scpi.c` (obě jádra). **Zbývá pro CM4 SCPI:** naplnit `scpi_src` z IPC snapshotu ZA BĚHU (ne jen v selftestu) + TCP transport port 5025. **W3 HOTOVO 2026-08-23 (kód, HW test čeká):** `CM4/LWIP/App/scpi_tcp.c`, raw lwIP server na portu 5025, 4 souběžná spojení / vlastní `scpi_ctx_t`, snapshot čten živě pro každý příkaz. W0 (vypínač ovládání) proudí přes nové pole `web_ctrl_en` v **IPC v8** — `set_cfg` se přiřadí jen když je ovládání povolené, jinak SET tiše selže existující NULL-guard ochranou parseru. Test: `HW_OVERENI_PRUCHOD.md` §7d. **W4 HOTOVO 2026-08-23 (kód, HW test čeká):** `CM4/LWIP/App/httpd_min.c`, HTTP/1.1 server port 80 (3 spojení, jeden `tcp_write` bez pacing — stačí pro malé JSON/SCPI odpovědi, W5 bude potřebovat chunking). `GET /api/state` staví JSON přes `scpi_src_t` (stejná validita jako SCPI), `POST /api/scpi` sdílí kód s TCP 5025. Parser požadavků = čistá funkce s vlastním selftestem → **IPC v9**. Test: §7e. **W5 HOTOVO 2026-08-23 (kód, HW test čeká):** SPA (`SPA_HTML[]`, ~4,3 kB `.rodata`) servírovaná na `GET /`, HTTP Basic Auth (jméno/heslo z okna PŘÍSTUP publikované přes **IPC v10** — první skutečný růst snapshotu od v8, ne recyklovaný padding), asynchronní odesílání po částech přes `tcp_sent` (W3/W4 vystačily s jedním `tcp_write`, SPA ne). **Tím je celý plán W0–W5 z `WEB_UI_PLAN.md` hotov kódem — zbývá jen HW ověření celého řetězu (§7b→7f v `HW_OVERENI_PRUCHOD.md`).** **Čtení z snapshotu:** `MEAS:FREQ?/:DIV16?/:ALL?` (freq4/16), `MEAS:VOLT? P12/P5/VC/VREF/VBAT` + `MEAS:POW?` (napětí + rf_mv + `ad8307_*` kalibrace), `SYST:TEMP? OCXO/BOARD/MCU` (teploty), `SYST:GPS:*` (gps pole), `CALC:DATA?`/`CALC:LIM:FAIL?` + `CALC:*?` readbacky (cfg mirror). **Zápis přes cmd ring:** `CALC:*` SET → `IPC_CMD_CFG_SET` (CM7 aplikuje na `g_meas_cfg`). ⚠️ **SET→readback latence** ≤~0,5 s (cmd ring ~10 ms + snapshot ~2 Hz) — CM4 SCPI po SET nečekat okamžitý mirror. `MMEM:DATA?` = přes IPC file-read okno / `datalog_read_back` na CM7 (viz #26). Návrh stromu v `NAVRH…md` §6/§6a. | oba | jádro+USB+error queue+SET+config-sync hotové; **CM4 konzument (abstrakce dat) + síť ⬅ #24**, data ⬅ #2 |
| 26 | **Webserver + REST/JSON + stahování logů** — 📋 **AUDIT + PLÁN 2026-08-22: `WEB_UI_PLAN.md`** (etapy W0–W6). 🔴 **Hlavní nález: ovládací cesta CM4→CM7 je z 90 % neimplementovaná** — `ipc_cfg_apply` umí jen Math/limity (8 klíčů), `IPC_CFG_GATE/CHAN/RUN` spadnou do `default: return 0` a `IPC_CMD_GATE/RUNSTOP/CHAN/LOG` vrací `status=1`. Web by tedy dnes uměl nastavit Math a nic víc — žádné RUN/STOP. Strojovna na CM7 ale hotová je (most `g_ui_cfg_req` → `screen_main_apply_cfg_req`, používá ho SCPI), takže **W1 = napojit `ipc_cfg_apply` na tentýž most** (malé, testovatelné BEZ webu, prospěje i SCPI/TCP #25). Další nálezy: bezpečnost webu nerozhodnuta (LAN bez autentizace = kdokoli zmáčkne STOP), „stejně jako displej" nejde doslova (vzhled/jas/animace jsou vlastnost displeje; kalibrace/sestavy/SD nemají IPC cestu), HTTP server doporučen **vlastní** místo lwIP `httpd` (odpadá `makefsdata` v buildu, parser jde do `selftest`). Rozpočty v pohodě: CM4 flash 84,6 KB/1 MB, RAM 30/128 KB. | CM4 | ⬅ #24. Statická SPA v CM4 flash bance, data přes `/api/*` z **IPC snapshotu** (v3 = plný instrument-state + kalibrace + Math cfg → `/api/meas` je jen serializace snapshotu do JSON, bez sáhnutí na CM7 globály), push 1 Hz (poll → WebSocket). **Config POST** (Math/limity z webu) → cmd ring `IPC_CMD_CFG_SET` (stejný kanál jako CM4 SCPI, viz #25). **⚠️ Změna proti původnímu návrhu:** stahování logů **nemá jít přes FatFs**, ale přes `datalog_read_back()` — datalog má jednotné čtení bez ohledu na úložiště, takže to funguje stejně pro W25Q i SD a **odpadá riziko „jediný vlastník FatFs"**. CM4 přes IPC (file-read okno) jen požádá, CM7 vyřídí. **CM4 konzument sdílí abstrakci zdroje dat s SCPI (#25).** |
| 27 | **MathTask na CM7** (matematika měření z reálných dat) | CM7 | ⬅ **#2, #1.** Gap-free Σhran/ΣΔt, syntéza GATE 0,1/1/10/100 s, klouzavé statistiky, **ADEV pyramida z reálných dat**, drift, LSQ regrese, korelace s teplotou OCXO. `double` FPU (CM7 ji má, CM4 ne — proto patří sem). Plná syntéza GATE potřebuje **protokol v2** (#4). |
| 28 | ✅ **SD karta — PLNĚ FUNKČNÍ NA HW 2026-08-14** (root cause = vypnutý `HardwareFlowControl`, viz níže). Role: **SD = EXPORT, ne úložiště.** SDMMC1 v `.ioc` (4-bit, PC8–11/PC12/PD2, `ClockDiv=2` → 16 MHz) + FatFs + `sd_export.c/h`. **✅ ROZHODNUTO: autoritativní úložiště zůstává W25Q** (uveze ~600 dní, o data se nepřijde) a SD slouží k tomu, k čemu má — vytáhnout a přečíst na PC. Tím odpadá kontinuita `seq` přes dvě média, přepis MBR i ztráta dat při vyjmutí. ⚠️ **`DATALOG_SD_RAW_OK = 0` a takové zůstane** — RAW blokový zápis by šel od LBA 0 = **MBR karty**. **Dělba podle blokování:** `sd_export_tick()` je levné (GPIO + rychlý `f_mount(NULL)`) → defaultTask ~2 Hz, jen auto-UNmount; `mount`/`export`/`test` BLOKUJÍ (stovky ms až sekundy) → **výhradně UartTask**, který není pod watchdogem. Auto-mount záměrně NENÍ. UART: `sd diag|test|det|force|mount|unmount|export [N]` → `GPSDO.CSV` (oddělovač `;`, unix čas, bez `%f`). `get_fattime()` z RTC. **✅✅ SD PLNĚ FUNKČNÍ na cíli (2026-08-14):** `sd init` čte blok 0 (`55 AA` MBR), `sd fs` = FAT32 partice, `sd mount` OK, `sd test` = **8 kB zápis+čtení bit po bitu shodné** (cesta FatFs→BSP_SD→HAL_SD→IDMA→karta). **ROOT CAUSE: `HardwareFlowControl` byl VYPNUTÝ** (v `.ioc` chyběl) → `CLKCR` `HWFC_EN=0` → datová cesta na H7 SDMMC nejela vůbec (příkazy OK, blok nedostal ani bajt, `DPSMACT` visí, `STA=0x1000`). Navíc `HAL_SD_InitCard` (voláme ho místo `HAL_SD_Init` kvůli 49denní SCR smyčce v `ConfigWideBusOperation`) nechává CLKCR na init hodinách — transfer takt+HWFC se musí aplikovat ručně `SDMMC_Init(SDMMC1, hsd1.Init)`. Oba fixy regen-safe v `sd_export.c` (`sd_apply_init_config` + `SDMMC_Init`). Odhalil funkční Frantův projekt `H757_SDcard_01`. Card-detect PE3 = mechanická vada slotu, opravena. ⚠️ **Zbývá jen:** HWFC doplnit do `.ioc` přes CubeMX (viz CUBEMX_CHECKLIST); tlačítko EXPORT v UI (worker mimo UiTask). | CM7 | Nezávislé na jádrech i na #2. |
| 29 | **Encoder + J7 LED/tlačítka + AlarmMgr** | CM7 | Nezávislé na všem ostatním, dá se dělat kdykoli. Encoder PA8/PA9 přes TIM1 v HW kvadratuře (0 % CPU), PC13 tlačítko; J7 = 6 LED zrcadlících stav (PWR/LOCK/DISC/ALARM/LOG/LINK). ⚠️ **Tlačítka na J7 — potvrdit, jestli tam vůbec jsou** a na kterých pinech. AlarmMgr = modul, ne task. |
| 30 | **mDNS/LXI discovery + USBTMC** | oba | ⬅ #25, #26. `_scpi-raw._tcp`, hostname `gpsdo.local` = LXI-lite. USBTMC = VISA bez socketu. **MSC (přístroj jako flash disk) zamítnuto** — kolize vlastnictví FatFs s logováním; export souborů řeší #26. |

#### Postup migrace krok za krokem (M0–M12)

> **Zadání tohoto žebříku:** po **každém** kroku musí přístroj **dál měřit a zobrazovat**,
> krok musí jít **samostatně ověřit** a **samostatně vrátit zpět**. Žádný krok nesmí být
> „velký třesk". Kroky `M` = pořadí provedení, sloupec „Pokrývá" mapuje na úkoly #19–#30.
>
> **Průběžné pravidlo po každém kroku (regresní minimum):**
> 1. `selftest` → musí být **7/7 PASS**,
> 2. `status` → porovnat s baseline z M0 (heap, volný stack tasků, CPU %) — **výrazný propad
>    volného stacku nebo skok CPU je červená vlajka**,
> 3. displej: hlavní obrazovka překresluje, hodiny tikají, dotyk reaguje,
> 4. nechat běžet **≥30 min** a zkontrolovat, že nepřibyl watchdog reset (`status` → `Reset:`).
>
> ⚠️ **Od M3 dál se flashují OBĚ banky** (CM7 `@0x08000000` + CM4 `@0x08100000`, `BCM4=1`).
> Použij `tools/make_release_image.ps1`. Flashnutí jen bank1 = **černý displej** (viz `CONTRIBUTING.md` §7).

| Krok | Cíl | Jak ověřit (kritérium PASS) | Návrat zpět | Pokrývá |
|---|---|---|---|---|
| **M0** | **Záchytný bod.** Nic neměnit. Flashnout dnešní stav, uložit si výstup `status` jako referenci (heap, volný stack všech 5 tasků, CPU %, `Reset:`). Ověřit, že umíš flashnout obě banky. | Přístroj běží; **výstup `status` uložený do souboru** — bez baseline se později nepozná, co krok rozbil. | — | — |
| **M1** | **MPU region 2 pro SRAM4** (`0x38000000`, 64 KB, **non-cacheable + shareable**). Nic ho zatím nepoužívá. | Krok musí být **neviditelný**: displej beze změny (region 0/1 nedotčeny), `sdram write/read` OK, `qspitest` OK, regresní minimum. ⚠️ Chybná MPU konfigurace se projeví jako rozbitý framebuffer nebo HardFault — proto tenhle krok samostatně. | revert `MPU_Config()` | #19 |
| **M2** | **Ověřit, že SRAM4 opravdu NENÍ kešovaná.** UART `ipctest`: přečíst zpět `MPU->RASR` a ověřit bity TEX/C/B; zapsat vzor přes DMA a přečíst CPU **bez** `SCB_InvalidateDCache` — musí být vidět nová data. | `ipctest` → `PASS (uncached)`. **Když tenhle test neprojde, NEPOKRAČUJ** — celé IPC by pak bylo postavené na písku a chyby by se projevily až jako náhodné nekonzistence. | — (jen test) | #19 |
| **M3** | **CM4 „hello".** Minimální firmware do bank 2: bliká LED jiným rytmem než POST + inkrementuje čítač v SRAM4. CM7 ho čte a ukazuje v `status`. | `status` → `CM4: alive, cnt=N`, a při druhém volání je **N vyšší**. ⚠️ **Zároveň otestovat opak:** flashnout jen bank 1 → přístroj **musí nabootovat** a hlásit `CM4:ABSENT` + `SYS !` (degradovaně, ne černý displej). | flashnout původní bank 2 | #20 |
| **M4** | **IPC snapshot + seqlock.** Sdílená hlavička (`ipc_shared.h`) pro oba projekty: **magic + verze**, pak malý snapshot (uptime, kmitočet, GPS fix). CM7 publikuje, CM4 čte a **echuje zpět kontrolní součet**. | `status` → `IPC: v1 OK, echo match, torn=0`. **Nesouhlas echa nebo rostoucí `torn` = seqlock nebo koherence je špatně.** Necha běžet 30 min a sledovat `torn`. | vypnout publikaci (jeden `#define`) | #20 |
| **M5** | **cmd/resp ringy.** CM4 periodicky posílá **neškodný NOP příkaz**, CM7 ho aplikuje a odpoví do resp ringu. Zatím **žádný příkaz, který něco mění**. | `status` → počet odeslaných příkazů (CM4) == počet zpracovaných (CM7) == počet přijatých odpovědí. Rozjetí čísel = ztráta v ringu. | vypnout `#define` | #20 |
| **M6** | **Liveness a degradace — cíleně otestovat všechny tři poruchy.** IWDG2 na CM4 + heartbeat ve snapshotu + `stall:CM4` v black-boxu. | **Tři samostatné testy:** (a) nezaflashovaná bank 2 → `CM4:ABSENT`, měří dál; (b) CM4 zaseknutý (debug příkaz) → CM7 ukáže `SYS !`, **měří dál a NERESETUJE se**; (c) CM7 zaseknutý (`stacktest yes`) → CM4 přestane vydávat data jako aktuální. **Tenhle krok je hlavní pojistka „nic se nerozbije".** | — | #21 |
| **M7** | **Rozdělit D2 SRAM** v obou linker skriptech; `ram` test buffer (`0x30000000`, UART `ram write/read`) přesunout nebo zrušit. | `.map` obou jader: **žádný překryv** v D2. `ram write/read` buď funguje na nové adrese, nebo je odstraněn z `help`. Regresní minimum. ⚠️ **Musí být hotové PŘED M9** — jinak si ETH deskriptory a CM7 tiše přepíšou paměť. | revert linkerů | #22 |
| **M8** | **Audit per-core RCC + kontextů v `.ioc`.** Projít ruční inity v USER CODE (`MX_I2C1_Init`, `fpga_freq_init`, `beeper_init`, `watchdog_init`) proti tomu, které jádro periferii vlastní. Zkusit **CubeMX regen** a ověřit, že USER CODE bloky přežily. | Build obou jader bez varování o dvojí inicializaci; po regenu `git diff` ukáže **jen EOL změny** (stejně jako při regenu 2026-07-19). Regresní minimum. | `git checkout` po regenu | #23 |
| **M9** | **ETH na CM4 — jen link, DHCP a ping.** Žádný lwIP aplikační stack. | Ping z PC projde. **A hlavně zátěžový test:** `ping -f` (flood) několik minut → **displej nesmí zpomalit, `status` nesmí ukázat watchdog reset, CPU % na CM7 se nesmí hnout.** Tohle je test izolace jader — pokud tady CM7 utrpí, návrh dělení je špatně a je lepší to zjistit teď než po webserveru. | vypnout NetTask | #24 |
| **M10** | **SCPI přes USB CDC** (na CM7, **bez sítě**). Parser na transportu, který už funguje. | `*IDN?` přes USB vrátí správný řetězec; `MEAS:FREQ?` vrátí totéž, co je na displeji. Nulové riziko — síť se vůbec neúčastní. | vypnout `#define` | #25 |
| **M11** | **SCPI přes TCP 5025** — týž parser, jiný transport, data z IPC snapshotu. | Z PC přes socket: `*IDN?`, `MEAS:FREQ?` — hodnoty **musí souhlasit s displejem a s USB variantou**. Rozdíl = chyba ve snapshotu, ne v SCPI. | vypnout ScpiTask | #25 |
| **M12** | **Webserver** (REST/JSON → SPA → stahování logů přes `datalog_read_back()`). | `/api/meas` vrací totéž co SCPI a displej; stažený log souhlasí s `datalog dump`. | vypnout HttpTask | #26 |

**Mimo žebřík (nezávislé, dají se dělat kdykoli):** #28 SD backend, #29 encoder/J7/AlarmMgr.
**Blokované #2:** #27 MathTask. **Až po M12:** #30.

> ⚠️ **Dvě místa, kde se to nejspíš pokazí, a proto mají vlastní krok:**
> **M2** (kdyby SRAM4 zůstala kešovaná, IPC by „skoro fungovalo" a padalo náhodně) a
> **M6** (bez cíleného testu poruch se degradace nikdy neověří — pozná se až v provozu).
> Ani jeden z nich nic nepřidává funkčně; oba existují čistě proto, aby se chyba našla hned.

---

## ✅ Checklist ověření na HW — zobrazení + funkčnost všech features

> Projít na reálném displeji: každá položka = **otevřít → ověřit zobrazení (nic se neořezává/nepřekrývá/neduchuje)
> + funkčnost (tlačítka, změna stavu, persistence)**. ⚠️ Většina UI a všechny statistiky/headline jsou zatím
> nad SIMULACÍ (#2) — ověřuje se **UI/logika**, ne správnost čísel. Odškrtávej `[x]`.

### A0) Nové 2026-08-08 — GLONASS parser + SCPI rozšíření (napsáno bez HW, ověřit přednostně)

> Kód přeložen čistě (`arm-none-eabi-gcc -Wall -Wextra -Wshadow -fanalyzer`), logika krytá
> selftestem; **HW ověření zbývá.** Dotčené: `gps.c/h`, `scpi.c/h`, `freertos_task_uart.c`.

**GLONASS — per-talker GSV akumulace + `gps glonass` (UBX-CFG-GNSS):**
- [ ] **Baseline selftest:** UART `selftest` → řádek „GPS parser" **PASS** (nový per-talker test `gsv_feed`/`gsv_merge` běží i bez antény — čistá logika).
- [ ] **Před zapnutím:** `gpsraw` ukáže jen `$GP…` věty; GPS okno (s_view=2) karta Družice = jen GPS družice.
- [ ] **Zapnutí:** UART `gps glonass` → odpověď „UBX-CFG-GNSS odeslano (GPS+SBAS+QZSS+GLONASS)".
- [ ] **Ověření příjmu:** po ~2–5 s `gpsraw` → přicházejí i **`$GLGSV`** věty, `SENT` roste.
- [ ] **⚠️ Regrese původního bugu:** v GPS okně **GPS družice NEZMIZÍ**, když dorazí GLONASS — **obě konstelace vidět SOUČASNĚ** (dřív jeden akumulátor → GLGSV vynuloval GPGSV).
- [ ] **Počet družic:** `sats_in_view` (družice v dosahu) = **součet** GPS+GLONASS; víc družic než před zapnutím.
- [ ] **Sky plot / bargraf:** tap na kartu Družice přepne bargraf↔sky plot; GLONASS PRN v rozsahu **65–96**, tečky na správných azimutech/elevacích.
- [ ] **NAK varianta:** pokud NEO-7M má jednosouhvězdí FW → `$GLGSV` nepřijdou, GPS jede dál (neškodné). → kandidát na **NEO-M8** (Galileo/BeiDou).
- [ ] **(volitelné, až po ověření dat)** obarvit sky plot/bargraf dle pole `gps_sat_t.constel` (GPS/GLONASS/Galileo/BeiDou).
- [ ] **(rozhodnutí)** po úspěšném ověření zvážit, zda `gps_config_gnss()` volat automaticky v `gps_init` (dnes záměrně opt-in — reconfig nešel ověřit bez HW).

**SCPI — error queue + nové dotazy (přes `scpi <cmd>` na USB konzoli):**
- [ ] **Baseline selftest:** `selftest` → řádek „SCPI parser" **PASS** (pokrývá nové příkazy i chování fronty).
- [ ] **Identita:** `scpi *IDN?` → `OK2HAZ,GPSDO-Counter,0,<verze>`.
- [ ] **Chybová fronta (SCPI-99):** `scpi SYST:ERR?` → `0,"No error"` (prázdno) → `scpi FOO?` (neznámý) vrátí `-113,"Undefined header"` → `scpi SYST:ERR?` → `-113,"Undefined header"` → znovu `scpi SYST:ERR?` → `0,"No error"` (fronta vyprázdněna).
- [ ] **`*CLS` maže frontu:** `scpi FOO?` → `scpi *CLS` → `scpi SYST:ERR?` → `0,"No error"`.
- [ ] **Kmitočet /4 vs /16:** `scpi MEAS:FREQ?` a `scpi MEAS:FREQ:DIV16?` → reálný kmitočet (bez FPGA linku obojí `9.91E37`); při signálu **obě větve stejný reálný kmitočet** (FPGA už dělič zahrnuje).
- [ ] **GPS dotazy:** `scpi SYST:GPS:TIME?` → `hh:mm:ss` při fixu (jinak `9.91E37`); `scpi SYST:GPS:POS?` → `lat,lon,alt`.
- [ ] **CALC subsystém (Math/limity):** v okně Math/Limity (31) nastav M/B/NULL a limity → `scpi CALC:DATA?` = `Y=m·X+b` nad reálným kmitočtem; `scpi CALC:LIM:FAIL?` = `0` (v mezích/off) / `1` (FAIL). Ověř, že sedí s verdiktem v okně.
- [ ] **SET příkazy + arg parsing (2026-08-08):** `scpi CALC:MATH:M 2` → `scpi CALC:MATH:M?` vrátí `2.00000`; `scpi CALC:MATH:B 100`, `scpi CALC:MATH:STAT ON` → zkontroluj, že se **okno Math/Limity (31) aktualizovalo** (M/B/stav sedí). `scpi CALC:LIM:LOW 9.9e6` + `CALC:LIM:UPP 10.1e6` + `CALC:LIM:STAT ON` → limity nastaveny. `scpi CALC:NULL:ACQ` (při platném kmitočtu) zachytí referenci. Chybný arg `scpi CALC:MATH:M xyz` → `-224` + zapíše se do `SYST:ERR?`.
- [ ] **Ostatní:** `scpi SYST:TEMP?` (OCXO °C), `scpi STAT:OPER:COND?` (bit0 FPGA link, bit1 GPS lock, bit2 ref lock).

**SCPI — rozšíření 2026-08-08 (IEEE 488.2 compliance, VISA-ready před ETH):**
- [ ] **IEEE 488.2 status model:** `scpi *ESR?` (přečte + smaže Standard Event Status), `scpi *ESE 32`→`*ESE?`=`32`, `scpi *SRE?`, `scpi *STB?`. Po `scpi FOO?` musí `*ESR?` mít bit5 (CME, `32`) a `*STB?` bit2 (EAV, `4`); `*ESR?` podruhé = `0` (čtení maže). Chybný arg (`CALC:MATH:M xyz`) → `*ESR?` bit4 (EXE, `16`). `*CLS` smaže ESR i frontu.
- [ ] **Common commands:** `scpi *OPC` → `*ESR?` bit0 (`1`); `scpi *OPC?`=`1`; `scpi *WAI` (ticho); `scpi *TST?`=`0` když poslední selftest PASS (jinak `1`); `scpi *RST` (ticho).
- [ ] **Fronta — počet + alias:** `scpi SYST:ERR:COUN?` = počet chyb; `scpi SYST:ERR:NEXT?` = totéž co `SYST:ERR?` (popne).
- [ ] **Compound (`;`):** `scpi *CLS;*ESE 32;*ESE?;*STB?` → provede vše, vrátí dvě odpovědi spojené `;` (`32;0`). `scpi *IDN?;SYST:VERS?` → dvě hodnoty přes `;`.
- [ ] **Frekvenční jednotky:** `scpi CALC:LIM:UPP 10.1MHZ` → `CALC:LIM:UPP?` ≈ `10100000`; `100KHZ`, `1GHZ`, `2M` fungují (mega = velké i malé M — jen Hz doména).
- [ ] **Teplota s selektorem:** `scpi SYST:TEMP? BOARD` (0x48), `MCU` (jádro), `FPGA` (neosazen → `9.91E37`); bez arg = OCXO.
- [ ] **Kmitočet — obě větve + FETCh:** `scpi MEAS:FREQ:ALL?` = `f4,f16`; `scpi FETC:FREQ?` = totéž co `MEAS:FREQ?`.
- [ ] **Questionable:** `scpi STAT:QUES:COND?` (bit0 kmitočet podezřelý, bit1 čas/GPS, bit2 reference) — inverzní k `OPER:COND?`.
- [ ] **⚠️ Pozn.:** `MEAS:FREQ?`/`CALC:*` jsou plně smysluplné až po **#2** (reálný SPI link místo simulace headline); do té doby ukazují reálná FPGA data z driveru, ne simulovaný headline.

**Sky plot / bargraf — prefix souhvězdí (navazuje na GLONASS):**
- [ ] GPS okno (2) → karta Družice: PRN mají **písmenný prefix dle RINEX** — `G05` (GPS), `R68` (GLONASS), `E12` (Galileo), `C07` (BeiDou). Platí v bargrafu i sky plotu.
- [ ] Barva tečky/sloupce zůstává **dle C/N0** (zelená/žlutá/červená) — prefix je jen textový, C/N0 se neztratí.
- [ ] Bez GLONASS (jen GPS) = všechny prefixy `G` (žádná regrese zobrazení).

**Datalog SD backend — 512B RMW layer (SW hotové, SD stále neaktivní):**
- [ ] `selftest` → řádek „Datalog zaznam + CRC" **PASS** (nově pokrývá i SD RMW layer proti RAM fake bloku — čistá logika, bez SD). Toto ověří **správnost blokové vrstvy bez HW**.
- [ ] SD backend zůstává neaktivní (`probe()==false`) → datalog jede dál na W25Q (žádná změna chování). SD bring-up (SDMMC1 v .ioc, HAL 512B primitiva, cache koherence) = samostatný HW krok, viz komentář v `datalog_sd.c`.

### A) Nové / změněné tento cyklus (2026-08-06/07) — ověřit přednostně
- [ ] **PŘEHLED KANÁLŮ (s_view=30):** segmentované bary; markery AKT(zelená/amber)/REF(accent)/MIN(violet)/MAX(červená) na správných pozicích; **legenda ve footeru** vpravo od „< GRAFY" (nekoliduje s titulkem); RF řádek **nemá** REF marker; hodnoty vpravo se neořezávají.
- [ ] **MĚŘENÍ (s_view=34, #67):** vstup přes Čítač → footer „MERENI >" (a zpět „< CITAC"). Řádky: Primární (tlačítko FREKV↔PERIODA), Nominál (auto), Odchylka (tlačítko cyklu jednotky Hz/ppm/ppb/ppt/rel), Offset, TFOM (barva dle úrovně), N/Průměr/σ/Peak-peak. Tlačítko RESET nuluje statistiku. Řádky se nepřekrývají, hodnoty se neořezávají. *(Statistika roste jen při RUN; hodnoty ze simulace do #2.)*
- [ ] **Selftest (s_view=20):** ukazuje **11/11 PASS** (přibyl „Prezentace mereni"); řádky se nepřekrývají s „Celkem".
- [ ] **Perf regrese — BEZ artefaktů:** zaoblené rohy karet/tlačítek/pilulek/stop barů čisté (AA LUT `fill.c`); orámování bez zubů (arc bez atan2f `shapes.c`); **žádní „duchové"** po překreslení kdekoli (dedup dirty rectů v `present`); veškerý text ostrý bez šumu (glyph loop `text.c`).

### B) Hlavní obrazovka (s_view=0)
- [ ] Headline kmitočet + jednotka; **RUN/STOP** (červené STOP při běhu, zelené RUN při stopu) + podbarvení čísla při STOP.
- [ ] Footer tlačítka (dočasně „Main SW" #14 → přepíná starý/nový layout); GATE/CHAN reagují + bliknou.
- [ ] Pilulky headeru (GNSS/SYS/SAT/HDOP/HOLD/CAL) — vejdou se, správné barvy; tap GNSS→GPS okno, tap SYS→Health.
- [ ] Čas/datum tiká 1×/s (lokální čas + label zóny); ikony mute/holdover.
- [ ] Tap Allan náhled→ALLAN okno; tap trend→trend fullscreen.

### C) Průchod všemi okny (otevřít z Menu / kontextu → zpět BACK vede správně)
- [ ] **GPS (2):** FIX, TP 100k/10Hz, družice (bargraf ↔ sky plot tapem), lokátor, čas UTC. Tlačítko SURVEY→Self-survey.
- [ ] **Diagnostika (1):** teploty/napětí/FPGA/Si5356/RTOS; footer DIAGRAM/PAMET/SELFTEST/ZPĚT.
- [ ] **System Health (3):** RTOS, stacky, I2C chyby, linky, reset důvod; footer SENZORY/DIAGNOSTIKA/NASTAVENI/GRAFY.
- [ ] **Senzory (4)** · **Paměť (5)** · **Grafy (29)** (teploty+napájení) · **Přehled kanálů (30)** (viz A).
- [ ] **Histogram (6) ↔ ALLAN (23) ↔ Spektrogram (26):** záložky VIEW_TABS; LIN/LOG; ADEV/TDEV/MTIE.
- [ ] **Trend fullscreen (9):** presety 1 min…60 dní (−/+).
- [ ] **Nastavení (7):** mute, jas −/+ (bar + HW), auto-dim, téma TMAVÉ/SVĚTLÉ (přepne paletu), jazyk; REFERENCE(14), O PŘÍSTROJI(10), SESTAVY(33).
- [ ] **Menu (12):** 12 dlaždic + Restart (→ potvrzení 13). Dlaždice: Diagnostika, Nastavení, Health, Čítač(19), Holdover(16), Datalog(17), Alarmy(18), Kalibrace(15), Čas(22), Animace(24), Math/Limity(31), Status ribbon(28).
- [ ] **Čítač (19):** živý SPI/měření detail, obě odbočky /4+/16, fázový status.
- [ ] **Holdover (16):** WARMUP/LOCK/HOLDOVER/NO-LOCK; OCXO warm-up sklon; (kandidát na TFOM #67).
- [ ] **Kalibrace (15):** editace slope/intercept/gain −/+; ULOZIT (persist W25Q); AUTO-CAL verdikt.
- [ ] **Datalog (17):** stav/kapacita/seq; ZAPNOUT/VYPNOUT. **Alarmy (18):** počítadla + mute.
- [ ] **Čas (22):** UTC + lokální; AUTO CET/CEST ↔ ruční −/+.
- [ ] **Reference (14):** Si5356 lock stav. **O přístroji (10):** verze = git tag, build, autoři.
- [ ] **Komunikace/diagram (21):** uzly + stavové LED (pulzují při BAD/WARN), spoje barvené stavem.
- [ ] **Animace (24) → Příklady (25) / EFEKTY (27):** přepínače ZAP/VYP; 6 demo animací běží.
- [ ] **Math/Limity (31):** MATH m/B/NULL, verdikt PASS/FAIL, pásmo, LIMITY/ALARM.
- [ ] **Self-survey (32):** START/STOP, rozptyl klesá, persist polohy.
- [ ] **Sestavy (33):** 8 slotů uložit/načíst/smazat (načtení aplikuje téma/jas).
- [ ] **Screensaver (8):** auto-dim po nečinnosti → velké hodiny; dotek probudí (nespustí akci).
- [ ] **Boot splash (11):** logo + build + Selftest řádek.

### D) Persistence (přežije reset i power-cycle)
- [ ] Jas/téma/jazyk/mute/auto-dim/zóna/efekty/animace/Math/survey — po **power-cycle** drží (W25Q syscfg).
- [ ] Kalibrace (W25Q CALIB) + Sestavy (W25Q SETUP) drží. RTC čas přes warm reset (BKP), přes power-cycle jen s VBAT.

### E) Zvuk / alarmy / watchdog
- [ ] Boot jingle (pokud ne mute); mute umlčí i test. Alarm: ztráta signálu 3×, ztráta GPS 2×, limit FAIL 4×, obnova 1×.
- [ ] `stacktest yes` → po ~4 s IWDG reset → Health „Reset: stack:UartTask" (ověření detekce #10).

## Kde co hledat (mapa dokumentů)

**Kořen repa:** `CONTRIBUTING.md` (workflow, IOC-owner pravidlo, **§7 dual-core flash**) ·
`STATUS.md` (tento soubor) · **`NAVOD.md` (uživatelský návod — pro obsluhu, ne pro vývoj)** ·
`tools/make_release_image.ps1` (combined CM7+CM4 image).

> ⚠️ **`NAVOD.md` drž v souladu s realitou.** Má nahoře tabulku „Stav vývoje", která přiznává,
> že měřený kmitočet je zatím simulace — **po dokončení #1/#2 ji aktualizuj**, jinak bude návod
> lhát o tom hlavním. Totéž u dočasného tlačítka „Main SW" (#14) a jednorázového resetu
> nastavení ve v0.4.0.

> ⚠️ **STM32H757 = dual-core. Flashuj OBĚ banky** (CM7 `@0x08000000` + CM4 `@0x08100000`)
> a měj `BCM4=1` v option bytes, jinak černý displej. Detaily → `CONTRIBUTING.md` §7.

**STM32 (`Frequency_Counter_STM32H757/`):** `CLAUDE.md` (bible) ·
`CUBEMX_CHECKLIST.md` · `FPGA_INSTANCE_BRIEF.md` · `FPGA_PROTOCOL_V2_NAVRH.md` ·
`FPGA_SPI_HANDOFF.md` · `NAVRH_ARCHITEKTURA_CM7_CM4.md` · `USB_CDC_PLAN.md` ·
`CM7/GPSDO_UI_README.md`.

**FPGA (`Frequency_Counter_FPGA_Module/`):** `BOARD_V20_CHECKLIST.md` ·
`PHASE_CAL_DESIGN.md` · `FPGA_MEAS_VALIDATION.md` (validace metod: rozpočet chyb,
drift/kompenzace, koherentní limitace, placement GW1NR-9C; 2026-07-19) ·
`FPGA_module_schematic.pdf` · `src/` (RTL) · `sim/` (testbenche).
