ok2haz/Frequency_Counter_FPGA/Frequency_Counter_STM32H757/ETH_BRINGUP_CHECKLIST.md

# Ethernet + SCPI + web na CM4 — etapový plán

> Rozpracování `NAVRH_ARCHITEKTURA_CM7_CM4.md` §5/§6/§6a do **spustitelných etap**.
> Váže se na `STATUS.md` #24/#25/#26, `DUALCORE_BRINGUP_CHECKLIST.md`.
>
> Přidáno 2026-08-11, **přepracováno po auditu téhož dne** (viz §10 — co a proč se změnilo).

> 🔴 **MÍRA JISTOTY (čti kriticky):** ETH na této desce **nikdy neběželo**. Ověřeno je jen,
> že PHY je osazený (schéma list 4/7) a že CM4 bootuje a mluví přes IPC. Čísla paměti jsou
> **odhady** z §2 návrhu, ne měření. Kroky ber jako kontrolní body, ne jako recept.

---

## 0. Řídicí princip

**Každý nevratný závazek až po levném důkazu.**

V plánu jsou přesně dva nevratné závazky — **regenerace `.ioc`** (může rozbít právě
stabilizovaný build obou jader) a **volba RTOS vs. holá smyčka** (určuje tvar celé
síťové vrstvy). Oba jsou proto zařazené **až za** etapy, které stojí skoro nic a přinesou
data: F0 ověří hardware bez jediné změny v projektu, F1 připraví diagnostiku, F3 udělá
minimální regen.

Vedlejší efekt: nejlevnější únik z celého plánu je hned po **F0**.

---

## 1. Přehled etap

```
F0 diagnostika ─→ F1 IPC v4 ─→ F2 paměť ─→ F3 CubeMX(ETH) ─→ F4 ROZHODNUTÍ ─→ F5 link+ping
   z CM7            příprava      pravidlo     minimální        RTOS/smyčka       = M9
   BEZ REGENU       bez ETH                                                         │
                                                                                    ▼
                                                        F6 SCPI (M10) ─→ F7 web (M11) ─→ F8 služby (M12)
```

| F | Cíl | Nevratné? | Riziko | Rozsah | Hotovo, když |
|---|---|---|---|---|---|
| **F0** | Pinmapa + PHY žije + REF_CLK měří 50 MHz | ne | 🔴 HW nejistoty | S | přečteno PHY ID, změřen ref. clock |
| **F1** | IPC v4: stav linky/IP → displej | ne | bump verze | S | Health ukazuje `NET: down` |
| **F2** | Adresování DMA bufferů, clocky | ne | — (řešeno návrhem) | S | pravidlo zapsané, `.map` ověřen |
| **F3** | CubeMX: **jen ETH** na CM4 | ⚠️ **ANO** | regen rozbije jádra | M | obě jádra se přeloží a bootují |
| **F4** | Rozhodnout RTOS vs. smyčka | ⚠️ **ANO** | — | S | rozhodnutí zapsané i s důvodem |
| **F5** | Link + DHCP + ping (**M9**) | ne | ETH DMA, izolace jader | L | `ping` projde, `ping -f` nehne displejem |
| **F6** | SCPI TCP 5025 (**M10**) | ne | — jen práce | M | VISA `*IDN?`, reálné veličiny |
| **F7** | Web + `/api/*` (**M11**) | ne | flash rozpočet | L | stránka v prohlížeči |
| **F8** | mDNS, SNTP (**M12**) | ne | — | S | `gpsdo.local` se najde |

**Rozsah:** S = hodiny, M = den, L = víc dní. Relativní, ne kalendářní.

---

## 2. F0 — Diagnostika z CM7 (⭐ nejdůležitější etapa)

**Bez jediné změny v `.ioc`, bez regenerace, bez rizika pro funkční build.** Zodpoví dvě
ze tří hardwarových neznámých pomocí infrastruktury, která funguje dnes.

Klíčové zjištění, na kterém to stojí: **SMI/MDIO je clockované signálem MDC, tedy
nezávisle na 50 MHz RMII ref. hodinách.** PHY odpovídá na MDIO, i kdyby `nINTSEL` byl
špatně. Obě otázky se tak dají řešit odděleně.

- [x] ✅ **Pinmapa vytažena 2026-08-13** — schéma v repu **je** (`STM32H747BIT.pdf`, list 4/7
      Ethernet + 2/7 CPU), jen ho nikdo neotevřel. Zapsána do `NAVRH…md` §6a.1 i do komentáře
      u příkazu `eth`. PHY = **LAN8742A**, strap `PHYAD0`→GND ⇒ očekávaná adresa **0**.
      **Původní znění:** „v repu **není**,
      dokumenty znají jen názvy signálů. Potřebné: `MDC`, `MDIO`, `ETH_RES`, `ETH_REF_CLK`,
      `ETH_INT`. Zapsat do `NAVRH…md` §6a.1 (dnes tam jsou jen jména).
- [x] ✅ **Příkaz `eth` HOTOV 2026-08-13** (inline v `freertos_task_uart.c`, idiom `scanner`):
  - pulz `ETH_RES` low ≥100 µs, pak pár ms
  - **bit-bang SMI** na MDC/MDIO (GPIO je přístupné z obou jader, nezávisle na tom, komu
    ETH v `.ioc` patří)
  - **scan adres 0–31**, číst PHY ID (reg 2 a 3) → očekáváno `0x0007C130` / `0x0007C131`
  - vypsat nalezenou PHYAD a BMSR (stav linku)
- [x] ✅ **`eth clk` HOTOV** (TIM2_CH2 v režimu externích hodin na PA1, okno 100 ms z DWT) → musí být **50 MHz**. Timerem v external-clock režimu
      (pokud pin sedí na TIM vstupu), jinak osciloskopem. **Tím se ověří strap `nINTSEL`**
      (režim „REF_CLK OUT"), který §6a.1 sám označuje jen jako *předpokládaný*.
- [x] 🔴 **VÝSLEDEK F0 (2026-08-13): PHY NEODPOVÍDÁ — a je známo proč. ETH je blokovaná HW.**

  `eth` na cíli: `=> ZADNY PHY NEODPOVIDA na SMI` (sken všech 32 adres).
  **Příčina nalezena a uživatelem potvrzena na desce:** `X1` je **10 MHz**
  (`HSE_VALUE` 10 MHz, PLL 10×96/2 = 480 MHz sedí). Podle listu 2/7 jde jeho
  výstup přes **R5 (50 Ω) do `RCC_OSC`** (HSE procesoru) **a přes R6 (50 Ω) do
  `OSC_25M`**, což je `XTAL1/CLKIN` PHY (list 4/7, pin 5; XTAL2 nezapojen).
  **LAN8742A vyžaduje 25 MHz** — dostává 10 → nenaběhne a neodpoví ani na MDIO.

  Jeden oscilátor nemůže obsloužit obojí: GPSDO potřebuje 10 MHz pro časovou
  základnu, PHY 25 MHz. Síť je *pojmenovaná* `OSC_25M`, takže záměr byl 25 MHz.

  ⚠️ **Oprava vlastní dřívější formulace:** tvrzení „SMI nezávisí na REF_CLK,
  takže mlčení nelze vysvětlit strapem nINTSEL" je o nINTSEL pravdivé, ale
  sváděla k závěru, že PHY nepotřebuje žádné hodiny. **Jsou to dvoje různé
  hodiny:** 50 MHz REF_CLK (výstup do MAC, řídí ho nINTSEL) a **25 MHz vstupní
  takt**, bez kterého PHY neběží vůbec. Hláška v příkazu `eth` opravena.

  **Proč zrovna 25 MHz (a proč 10 nestačí ani částečně):** vnitřní PLL PHY je
  navržená na pevný poměr — z 25 MHz dělá **125 MHz** pro 100BASE-TX (linková
  rychlost je 125 Mbaud) a 50 MHz pro REF_CLK OUT. **Není žádný registr ani strap,
  kterým by se vstupní kmitočet přeladil.** Při 10 MHz by i v ideálním případě
  vyšlo 50 MHz místo 125 → na drátě by to nebyl Ethernet a žádný protějšek by se
  nesesynchronizoval; 10BASE-T by dopadl stejně. Reálně PLL při 2,5× mimo rozsah
  vůbec nezachytí a čip zůstane v interním resetu → mlčí i na MDIO, což odpovídá
  pozorování. **Zkrátka: 25 MHz je zadrátované v návrhu PLL, ne konfigurovatelné.**

  **Doporučené řešení: odpojit R6 a přivést PHY samostatných 25 MHz** (levný XO,
  Ethernet nepotřebuje disciplinovaný takt, stačí ±50 ppm). ⚠️ **R5 nechat** —
  to jsou hodiny procesoru.

  **Zamítnuté varianty (ověřeno výpočtem, ne odhadem):**
  - **Si5356** — má přesně 4 výstupy a všechny nese 4-fázový TDC. Žádný nezbývá.
  - **MCO z STM32** — ⚠️ zamítnuto ze dvou nezávislých důvodů. (1) `MCO2` umí přes
    PLL2 vyrobit 25 MHz, ale sedí na **PC9 = SDMMC1_D1** (SD karta, obsazené).
    (2) `MCO1` je na **PA8** (encoder, zatím neimplementovaný → pin by šel uvolnit),
    jenže **PLL1 nikdy nedá přesně 25 MHz**: VCO je 960 MHz (10 × N96) a
    `960 / 25 = 38,4` — MCO dělič i `PLLQ` jsou celočíselné, takže to nevyjde
    v žádné kombinaci. Snížit VCO na 800 MHz (25 × 32) by znamenalo SYSCLK
    400 místo 480 MHz, tedy −17 % výkonu při už tak 60% zátěži. Nevyplatí se.
  - **Režim REF_CLK IN (50 MHz na XTAL1)** — stejně potřebuje externí zdroj
    hodin, navíc změnu strapu `nINTSEL` a přepojení pinu 14 (stal by se z něj
    `nINT`, ale je drátovaný do `ETH_REF_CLK`). Víc práce než varianta s XO.

  **Tohle je ten „nejlevnější únik" z §0.** Dokud se HW neupraví, F1–F8 nemá smysl začínat.

⚠️ Příkaz `eth` je bring-up rezidum — nechat ho jako diagnostiku (jako `fpgaraw`), ale
označit komentářem, že bit-bang MDIO je jen pro F0 a produkčně to dělá HAL z CM4.

---

## 3. F1 — IPC v5 dopředu (příprava, ne důsledek) — ✅ HOTOVO 2026-08-22

CM4 nemá konzoli ani displej. Bez tohohle kroku bys M9 ladil jen debuggerem —
proto **patří sem, ne až za rozjetou síť**. Na ETH nezávisí ani trochu.

- [x] ✅ **Rozšířeno `ipc_cm4_status_t`** o `net_ip` (IPv4 oktety), `net_link`, `net_speed_mbps`,
      `net_duplex` (`ipc_shared.h`). Publikuje `ipc_cm4_set_net()` (CM4), čte `ipc_cm4_net()` (CM7).
- [x] ✅ **`IPC_VERSION` 4 → 5** (ne 3→4 — v4 už zabral `sens_valid`). Obě strany ověřují
      `magic`+`version`+`size`; nesouhlas → IPC off (`4:--`). ⚠️ **Nutno přeflashnout OBĚ banky.**
- [x] ✅ **System Health**: řádek CM4 nově `CM4:OK NET:down` (mono_16, box 156 px). CM4 dnes
      hlásí natvrdo `down` (`ipc_cm4_set_net(0,0,0,0)` v CM4 smyčce) — lwIP až F5.
- [x] ✅ **`NET` chip v headeru ZAMÍTNUT** — `HDR_PILL_LIMIT` je na rozpočtu; Health je bezpečnější (dle plánu).
- [x] ✅ Zapsáno do `CLAUDE.md` (IPC v5) a `STATUS.md` (#24).
- **Most CM7:** `g_cm4_net_up` (defaultTask z `ipc_cm4_net()`), app vrstva čte globál (vzor jako `g_cm4_alive`).

✅ **Kritérium SPLNĚNO:** Health ukazuje `NET: down`, přežije reset (IPC re-init robustní na magic).
Zobrazovací řetěz je odladěný dřív, než ho u F5 budu potřebovat. Kompilačně čisté (CM7+CM4,
`-Wall -Wextra -Wshadow`). **Zbývá HW-ověřit na displeji po reflashi obou bank.**

---

## 4. F2 — Paměť: pravidlo místo ověřování

Rozpočet CM4 (160 KB, SRAM2+3), odhady z §2 návrhu:

| Položka | Odhad |
|---|---|
| ETH deskriptory + RX/TX buffery | ~32 KB |
| lwIP heap + pbuf pool | 32–64 KB |
| Stacky (F5: 1 kontext, F8: 4) | 4–20 KB |
| **Rezerva ze 160 KB** | **44–92 KB** |

- [ ] 🔴 **PRAVIDLO: DMA-viditelné buffery adresuj vždy systémovou adresou `0x3002xxxx`.**
      CM4 linkuje RAM na `0x10020000` (alias), CM7 vidí tutéž paměť na `0x30020000`.
      ETH DMA je **sběrnicový master, ne CPU** — přes alias by mohl zapisovat jinam, než
      CPU čte (projev: link up, ale RX nikdy nepřijde). **Tímhle pravidlem riziko mizí
      definičně**, není potřeba luštit RM0399 jako bránu.
      ⚠️ Sekce nesmí kolidovat s běžnou RAM CM4 — je to **stejná fyzická paměť**.
- [ ] **Povolit SRAM2/3 clock z CM4** — `RCC_C2_AHB2ENR` (per-core registr!).
- [ ] Ověřit v `.map`, kde deskriptory reálně skončily. **Nespoléhat, že to sedlo.**
- [ ] ⚠️ CM4 **nemá D-cache** → žádná cache maintenance kolem ETH DMA. Hlavní důvod, proč
      ETH patří sem a ne na CM7 — **nezahazuj tu výhodu** přesunem bufferů do D1.
- [ ] Kdyby bylo těsno: **přerozdělit SRAM1** (CM7 drží 128 KB, které linker nevyužívá —
      jediný uživatel je diagnostický `ram write/read`).

---

## 5. F3 — CubeMX: jen ETH (⚠️ první nevratný krok) — ✅ KÓD HOTOVÝ 2026-08-22, čeká na HW ověření

Záměrně **minimální regen**: žádné LWIP, žádný FreeRTOS. Menší změna = menší šance,
že se rozbije funkční stav.

### Co regenerace přinesla a co se muselo dodělat
`.ioc` vyšlo správně (`ETH:I` v `CortexM4.IPs`, `MX_ETH_Init … CortexM4`, všech 11 pinů sedí
proti schématu). Regen ale odhalil **tři věci, které by jinak tiše bolely**:

1. 🔴 **Build spadl na obou jádrech** — IDE po regeneraci nepřegenerovalo `Debug/*/subdir.mk`,
   takže z buildu vypadl FatFs (CM7) i HAL ETH (CM4): `undefined reference to f_open` /
   `HAL_ETH_Init`, přestože `.project` byl v pořádku. Léčba + prevence viz `CUBEMX_CHECKLIST.md`
   („VRÁTILO SE 2026-08-22"); nezávislá cesta ven = **`scripts/build.sh`**.
2. 🔴 **`MX_ETH_Init` → `Error_Handler()` = `while(1)` na CM4.** `HAL_ETH_Init` čeká na SW reset
   MAC, který bez běžícího RMII REF_CLK vyprší → shodilo by to **celou CM4** i s IPC (`4:off`),
   tedy bychom kvůli nefunkčnímu ethernetu přišli o funkční dvoujádro. Upraveno na degradovaný
   `return` + `g_eth_init_ok`.
3. 🔴 **ETH DMA deskriptory skončily na `0x10020010` v `.data`** (orphan sekce — linker
   `.RxDescripSection` neznal). To je CM4-only alias, kam **ETH DMA nedosáhne**. Vyčleněn region
   `ETH_D2 @0x30040000` (SRAM3, systémová adresa) + `RAM` zkrácena 160K→128K, jinak by tam
   linker tiše umístil `.bss`. Ověřeno: `nm` → `30040000 B DMARxDscrTab`.

Obě úpravy (2) a (3) **regenerace smaže** — jsou zapsané v `CUBEMX_CHECKLIST.md` § ETH.

- [x] Přepnout kontext na **CortexM4** a přiřadit mu **ETH (RMII)**. Nic víc.
- [ ] ⚠️ **Odškrtnout aspirační IP CM4** (`DUALCORE_BRINGUP_CHECKLIST.md` §5):
      `OPENAMP_M4`, `USB_DEVICE_M4`, `USB_HOST_M4`, `FATFS_M4`, `PDM2PCM_M4`, `WWDG2`, `VREFBUF`.
- [ ] `IWDG2` v `.ioc` **nezapínat** — `iwdg2.c` je ruční registrová implementace, HAL modul vypnutý.
- [ ] Ověřit, že **USER CODE bloky přežily**: beep, LED_2, `ipc_cm4_init()`, `iwdg2_init()`, smyčka.
- [ ] ⚠️ **Zdiffovat `.ioc` a `CM7/Core/Src/gpio.c`** — ETH piny nesmí přepsat nic z CM7 (FMC/LTDC/DSI).
- [ ] ⬅ **ZBÝVÁ NA HW:** ověřit, že se **nic nerozbilo**: displej běží, `4:OK`, selftest projde.
- [x] `HAL_ETH_ReadPHYRegister` → potvrdit PHY ID **z CM4** (nejen z CM7 v F0).
      Implementováno: `eth.c` čte reg 2/3 po úspěšném initu → `g_eth_phy_id` → IPC v6
      (`ipc_cm4_set_eth`) → CM7 `g_cm4_phy_id`. Vidět v **System Health** (`CM4:OK PHY:C131`)
      a v UART **`status`** (`ETH(CM4): init OK, PHY ID 0x0007C131 (LAN8742A)`).
      ⚠️ PHY ID se čte **až po** úspěšném `HAL_ETH_Init` (dřív není nastavený MDIO CSR clock
      range) → `init no` znamená „CM4 se k MDIO nedostala", **ne** „PHY mlčí".
      ⚠️ Vyžaduje **flash obou bank** (`IPC_VERSION` 5→6).

---

## 6. F4 — Rozhodnutí RTOS vs. smyčka (⚠️ druhý nevratný krok)

Až **teď**, s daty. Do téhle chvíle byly F0–F3 na volbě nezávislé.

**Stav argumentů (po auditu, viz §10):**

| Pro **smyčku** (`NO_SYS=1`) | Pro **FreeRTOS** |
|---|---|
| Nic v aplikaci neblokuje — data jsou v IPC snapshotu, `scpi_process` je čistá transformace | ✅ **Ekosystém H7+lwIP je RTOS-first** — generovaný `ethernetif.c` počítá se semaforem a input taskem, referencí pro `NO_SYS` je míň |
| `httpd`, `mdns`, `sntp` z lwIP jsou **všechny `NO_SYS`-kompatibilní** | Pod zátěží (flood) jde prioritizovat SCPI proti webu |
| `iwdg2_kick()` zůstane triviální (jeden kick, jedna smyčka) | Rozdíl v RAM je **~16 KB ze 160 KB** — nerozhoduje |

**Rozhodovací kritéria, která budeš mít v ruce po F3:**
- [ ] Jak vypadá generovaný `ethernetif.c` — jde z něj `NO_SYS` udělat bez přepisu?
- [ ] Kolik ladění spolykalo F3 — když H7 ETH dělal potíže, ber šlapanou cestu (FreeRTOS).
- [ ] Rozhodnutí **zapsat i s důvodem** (sem, do §6), ať se k němu nemusíš vracet.

**Výchozí doporučení, pokud nic nerozhodne:** FreeRTOS s **jediným NetTaskem** v F5 —
chová se jako smyčka, ale sedí na standardním portu lwIP a další tasky jde přidat bez přepisu.

---

## 7. F5 — Link + DHCP + ping — 🟡 KÓD HOTOVÝ 2026-08-22, NEOVĚŘENO NA HW

**F4 rozhodnuto: `NO_SYS = 1` (bare-metal lwIP, bez RTOS).** CM4 je dnes holá `while(1)`
smyčka — raw API + polling je nejmenší možný zásah a nepřidává FreeRTOS, jeho heap ani
další stacky do 128 KB, které CM4 má. Na `NO_SYS = 0` se dá přejít, až to bude chtít
webserver (F7) s blokujícími sockety; do té doby by RTOS byl jen režie navíc.

**lwIP zaveden RUČNĚ, ne CubeMX** (v `.ioc` LWIP není): zdroje zkopírované
z `STM32Cube_FW_H7_V1.13.0` — 30 `.c` z `LwIP/src/{core,core/ipv4,netif}` +
`Drivers/BSP/Components/lan8742`. Glue: `CM4/LWIP/Target/ethernetif.c` (adaptovaný ST
`LwIP_HTTP_Server_Raw` z H743I-EVAL) + `CM4/LWIP/App/lwip_app.c` (náš init/proces/DHCP).
⚠️ Soubor se jmenuje `lwip_app.c`, ne `lwip.c`, aby budoucí CubeMX „Generate Code"
s LWIP nezpůsobil kolizi dvou souborů se stejnou rolí.

**Čtyři věci, které by to tiše rozbily (všechny ošetřené):**
1. **`ETH_RX_BUFFER_SIZE` 1000 vs `heth.Init.RxBuffLen` 1536** — ST příklad má 1000, náš
   generovaný `eth.c` programuje DMA na 1536. DMA by psala za konec bufferu. Srovnáno na 1536.
2. **MAC adresa se lišila** — `low_level_init` bral `ETH_MAC_ADDR*` z `hal_conf` (02:00:…),
   ale HW filtr naprogramoval `MX_ETH_Init` na 00:80:E1:…. ARP odpovědi by chodily se špatným
   MAC. Teď se MAC bere **z `heth.Init.MACAddr`**, takže se nemůžou rozejít.
3. **Duplicity s generovaným `eth.c`** — ST příklad si sám deklaruje `DMARxDscrTab`/
   `DMATxDscrTab`, `EthHandle` i `HAL_ETH_MspInit`. Vše odstraněno, používá se `heth` z `eth.c`
   a `low_level_init` **ETH znovu neinicializuje** (jen čte `heth.gState`) → `eth.c` zůstává netknutý.
4. **`SCB_InvalidateDCache_by_Addr` v `HAL_ETH_RxLinkCallback`** — CM4 nemá D-cache a CMSIS
   pro něj tu funkci ani nedefinuje. Odstraněno; právě tohle je důvod, proč ETH patří na CM4.

**⚠️ Hlavní smyčka CM4 přestavěná.** Končila `HAL_Delay(800)`, takže by se lwIP obsloužil
1× za 800 ms → RX ring (4 deskriptory) by při jakémkoli provozu přetekl a ping by měl RTT
skoro sekundu. Teď: **rychlá část** (`lwip_app_process()` + `iwdg2_kick()`) každou iteraci
(~1 ms), **pomalá část** (IPC snapshot, heartbeat, ETH stav) na ~5 Hz, LED_2 na stavovém
automatu místo blokujících `HAL_Delay`.

**Paměť** (ověřeno z `.map`): RAM 30 KB ze 128 KB (SRAM2), `.eth_dma` 12,7 KB z 32 KB (SRAM3
— deskriptory + zero-copy RX pool 8×1568 B). CM4 obraz 12,9 KB → **84,6 KB** flash.

- [x] lwIP init, `ethernetif`, `netif` up (bare-metal smyčka dle F4).
- [x] Autonegotiace → `HAL_ETH_SetMACConfig` dle Speed/Duplex (`ethernet_link_check_state`).
- [x] DHCP jako výchozí — startuje/zastavuje se **link callbackem**, ne natvrdo: jinak by
      klient posílal DISCOVER do odpojeného kabelu a po zapojení čekal na svůj backoff.
- [ ] ⬅ **ZBÝVÁ: fallback na statickou IP.** Okno SÍŤ na CM7 (s_view=35) sice DHCP on/off
      i ruční adresu ukládá do syscfg, ale **IPC snapshot ta pole zatím nenese** → CM4 se k nim
      nedostane. Doplnit spolu s rozšířením snapshotu.
- [x] Hlásit stav linky a IP přes **IPC** (`ipc_cm4_set_net()`, publikuje se jen při změně)
      → UART `status` řádek `NET: UP 100 Mbit full, IP 10.0.0.42`.
- [x] `iwdg2_kick()` — jeden kontext, prostý kick (viz §9).
- [ ] ⬅ **ZBÝVÁ (HW):** `ping` z PC projde.
- [ ] ✅ **Test izolace jader:** `ping -f` (flood) → **displej na CM7 se nesmí hnout**,
      žádný watchdog reset, `g_rtos_cpu_pct` CM7 beze změny. Hlavní důkaz, že rozdělení
      jader dává smysl.

---

## 8. F6–F8 — Aplikační vrstva

### F6 — SCPI na TCP 5025 (**M10**)

🔴 **Gate na #2 platí PER PŘÍKAZ, ne per etapu.** Zlaté pravidlo zakazuje servírovat
*simulaci*, ne servírovat cokoli:

| Smí hned (reálná data dnes) | Čeká na #2 (dnes simulace) |
|---|---|
| `*IDN?`, `SYST:ERR?`, `SYST:VERS?` | `MEAS:FREQ?` |
| `MEAS:VOLT?`, `SYST:TEMP?`, `MEAS:POW?` | `CALC:ADEV?`, `CALC:DRIF?`, `CALC:OFFS?` |
| `SYST:GPS:STAT?`, `STAT:OPER:COND?` | statistiky odvozené z headline |

Neimplementované vracej jako chybu do `SYST:ERR?`, **ne jako vymyšlené číslo**.

- [ ] `scpi_src_load_cm4()` — plní **tentýž `scpi_src_t`** z IPC snapshotu. Jádro `scpi.c`
      se nemění, ověřeně se kompiluje jako `-DCORE_CM4`.
- [ ] `set_cfg` → **cmd ring** (`IPC_CMD_CFG_SET`, klíče `IPC_CFG_*`).
- [ ] ⚠️ **BLOKUJÍCÍ: sjednotit `SCPI_CFG_*` a `IPC_CFG_*`.** Dnes jsou to dva paralelní
      enumy, které musí sedět 1:1 **bez jakéhokoli compile-time hlídání** (nález z revize
      kódu). Přidat `_Static_assert` **dřív, než na tom poběží síťové zápisy** — jinak
      přeházené pořadí tiše zapíše `LIM:LOW` do `null_ref`.
- [ ] ✅ Kritérium: `*IDN?` a `MEAS:VOLT?` z PC vrátí totéž co USB CDC na CM7.

### F7 — Webserver (**M11**)

- [ ] Statická SPA v bank2 flash (dnes je v ní 8 KB z 1 MB).
- [ ] `/api/meas`, `/api/status` = JSON ze snapshotu; start **pollingem 1 Hz**, WebSocket později.
- [ ] Stahování logů: **IPC file-read okno** (§3 návrhu plánuje 4 KB, **zatím neexistuje**)
      → CM7 plní přes `datalog_read_back()`. Další rozšíření = **IPC v6**.
      Záměrně **ne přes FatFs** — funguje pak stejně pro W25Q i SD.

### F8 — Služby (**M12**)

- [ ] mDNS (`gpsdo.local`, `_scpi-raw._tcp`) = LXI-lite.
- [ ] SNTP jako **cross-check** času proti GPS (ne jako zdroj — GPS je přesnější).

---

## 9. Průřezová témata

### Watchdog CM4

| Etapa | Model |
|---|---|
| dnes / F5 | `iwdg2_kick()` v jednom kontextu — triviálně správné |
| F6+ (pokud FreeRTOS) | **heartbeat + supervisor** jako na CM7 (`watchdog.c`) |

⚠️ Nekopíruj `watchdog.c` doslova — CM7 verze píše **crash black-box do BKP**, což je
„příčina resetu CM7". CM4 do něj sahat nesmí.

🔴 **Reset scope IWDG2 je pořád neověřený** (`DUALCORE_BRINGUP_CHECKLIST.md` §8). Při ladění
boot-loopu 2026-08-11 se `IWDG2RSTF` (bit 27) ani jednou neasertoval, takže o něm nevíme nic
nového. **Ověřit dřív, než na CM4 poběží něco, co se musí umět zotavit.**

### Verzování IPC

| Verze | Obsah | Kdy |
|---|---|---|
| v3 | senzory, kalibrace, Math/limit cfg mirror | hotovo |
| v4 | sens_valid (maska platnosti) + t_fpga_c100 | hotovo (2026-08-13) |
| **v5** | + stav ETH linky a IP (CM4→CM7) | ✅ **F1 HOTOVO (2026-08-22)** |
| **v6** | + file-read okno pro stahování logů | F7 |

### Bezpečnost — rozhodnout před F6

⚠️ SCPI i web umí přes cmd ring **měnit konfiguraci přístroje** (`CALC:` SETy → `g_meas_cfg`),
a po síti to bude **bez autentizace**. Volba:
- jen důvěryhodná LAN, nebo
- **read-only jako výchozí** a zápis za přepínačem v UI.

Není to teoretické — je to měřicí přístroj, kterému může kdokoli na LAN přenastavit limity.

### Diagnostika bez konzole

CM4 nemá UART ani displej. Do F1 (a při jakémkoli pádu i potom) je jediná cesta **debugger** —
postup v `memory/debug-bez-konzole.md` (`ST-LINK_gdbserver -g` = attach bez resetu).
Pro CM4 vybrat **jiný access port než pro CM7** (`-m <apID>`) — hodnotu ověřit.

---

## 10. Únikové cesty

| Kdy | Když se nepovede | Kam ustoupit |
|---|---|---|
| **F0** | PHY neodpoví ani po scanu 0–31 | HW problém (strapy/hodiny). **Zatím jsi neinvestoval nic** — SCPI zůstává na USB CDC, které funguje dnes. |
| **F0** | REF_CLK není 50 MHz | Strap `nINTSEL` → HW úprava, nebo externí 50 MHz oscilátor |
| **F3** | Regen rozbije build | `git checkout` na `.ioc` a generované soubory; F0/F1/F2 zůstávají použitelné |
| **F5** | `ping -f` shodí displej | Izolace jader nefunguje dle předpokladu → přehodnotit umístění ETH |
| **F5** | RAM nestačí | Přerozdělit SRAM1 z CM7 (128 KB leží ladem) |
| **F7** | Flash bank2 nestačí na SPA | Assets komprimovat, nebo do W25Q (64 MB) |

**Nejlevnější únik je po F0** — do té chvíle je investovaný jen jeden diagnostický UART příkaz.

---

## 11. Co se tímto plánem NEMĚNÍ

- `scpi.c` jádro — už teď data-source nezávislé (`scpi_src_t`), CM4 backend je jen další plnič.
- IPC snapshot CM7→CM4 — v3 nese plnou sadu instrument-state, na SCPI stačí.
- CM7 — kromě `ipc_cm4_status_t` (v4), zobrazení stavu sítě a diagnostického `eth` příkazu
  se ho to nedotkne.

**Hlavní hodnota dosavadní práce na IPC v2/v3: síť je transport, ne přepis aplikace.**

---

## 12. Historie: co změnil audit (2026-08-11)

První verze plánu měla pořadí `E0 brány → E1 CubeMX → E2 paměť → E3 PHY → E4 link`.
Audit našel čtyři vady:

| # | Nález | Oprava |
|---|---|---|
| 1 | **Největší riziko (regen) předcházelo prvnímu důkazu** — `.ioc` se měnil dřív, než bylo jasné, jestli ETH hardware vůbec žije | Nová etapa **F0**: diagnostika **z CM7** bit-bangem MDIO, bez regenu. SMI je clockované MDC → nepotřebuje REF_CLK, takže obě HW otázky jdou zodpovědět odděleně. |
| 2 | **Riziko adresy DMA řešeno ověřováním** („ověřit v RM0399") | Změněno na **pravidlo návrhu**: DMA buffery vždy na systémové adrese `0x3002xxxx`. Riziko mizí definičně. |
| 3 | **Volba RTOS/smyčka udělaná předem** na základě ekosystémových argumentů | Odsunuta do **F4**, protože F0–F3 jsou na ní nezávislé. Z původních tří argumentů pro FreeRTOS obstál v auditu **jen jeden** (ekosystém); „lwIP si nese vlastní souběžnost" neplatí — `NO_SYS=1` je přesně na to navržený, a `httpd`/`mdns`/`sntp` jsou `NO_SYS`-kompatibilní. |
| 4 | **Gate na #2 byl per etapa** | Zjemněn na **per příkaz** — reálné veličiny (napětí, teploty, GPS) můžou jít po síti hned, čeká jen headline kmitočet a odvozené statistiky. |

Dále: **IPC v4 přesunuto z E4b (důsledek) do F1 (příprava)** — na ETH nezávisí a bez něj
se M9 ladí jen debuggerem. A doplněn nález, že **pinmapa ETH v repu vůbec neexistuje**
(dokumenty znají jen názvy signálů), takže je to první konkrétní úkol.
