ok2haz/Frequency_Counter_FPGA/Frequency_Counter_STM32H757/STM32H747BIT.pdf

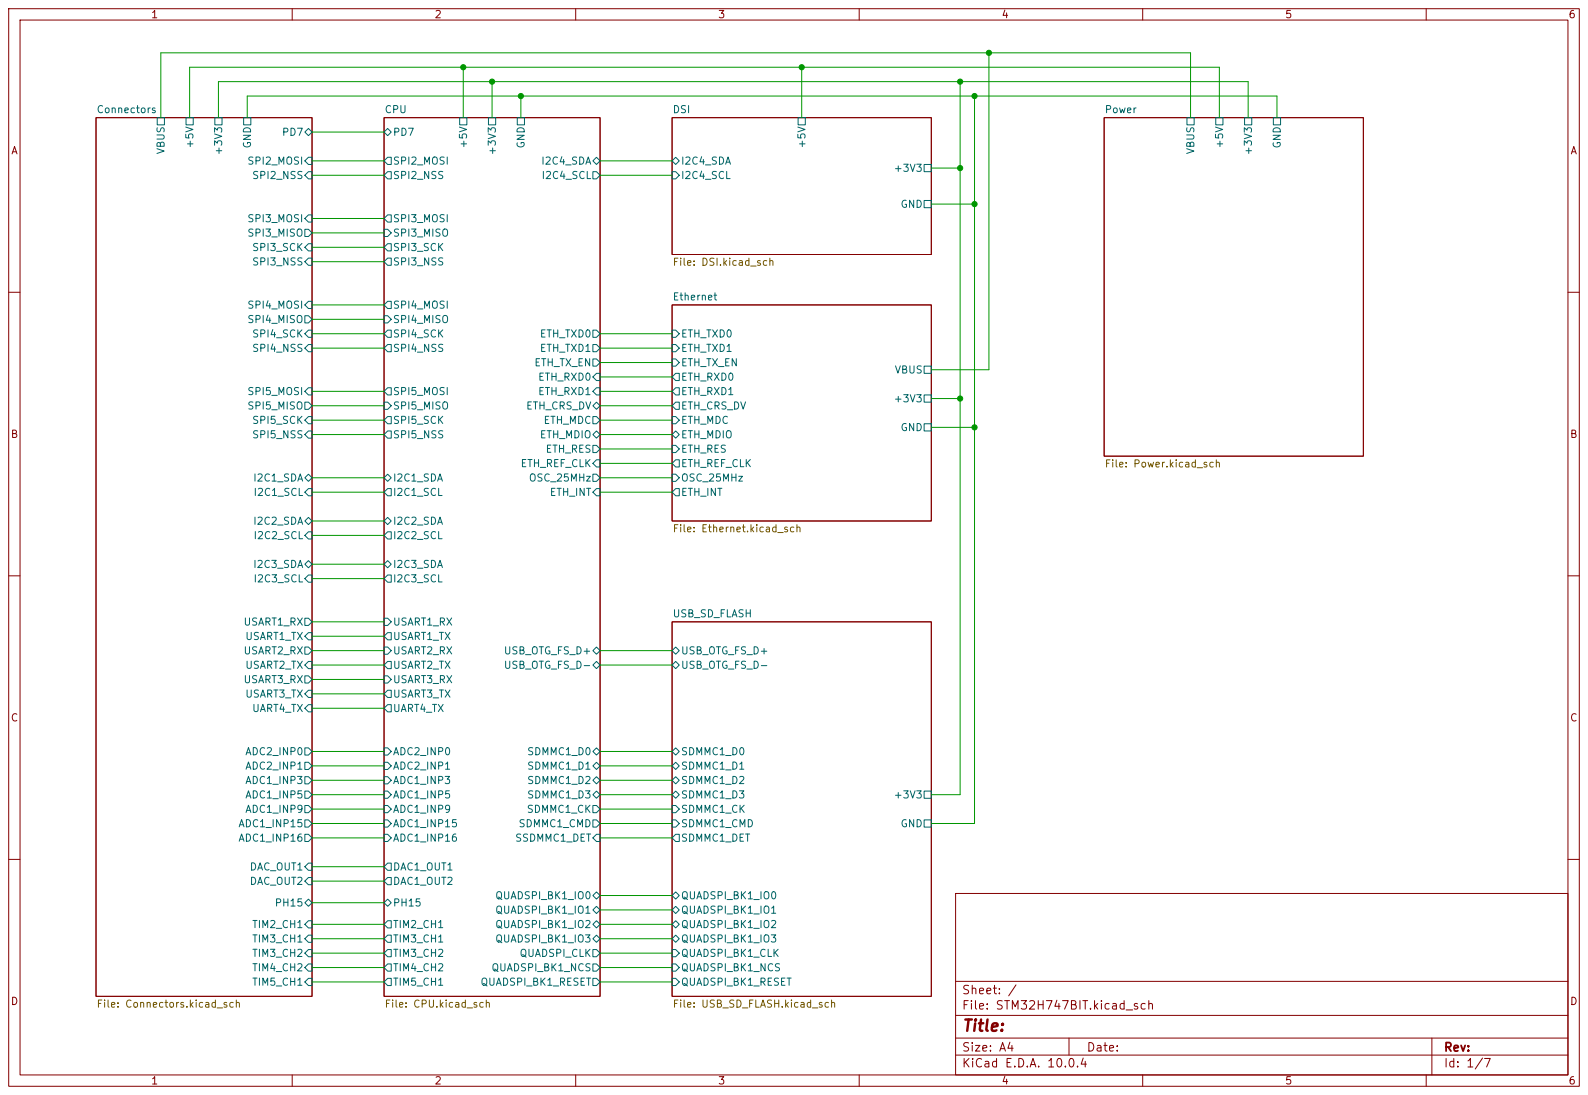
[picture p1: page 1]

Size: A4 | Rev:
KiCad E.D.A. 10.0.4 | Id: 1/7

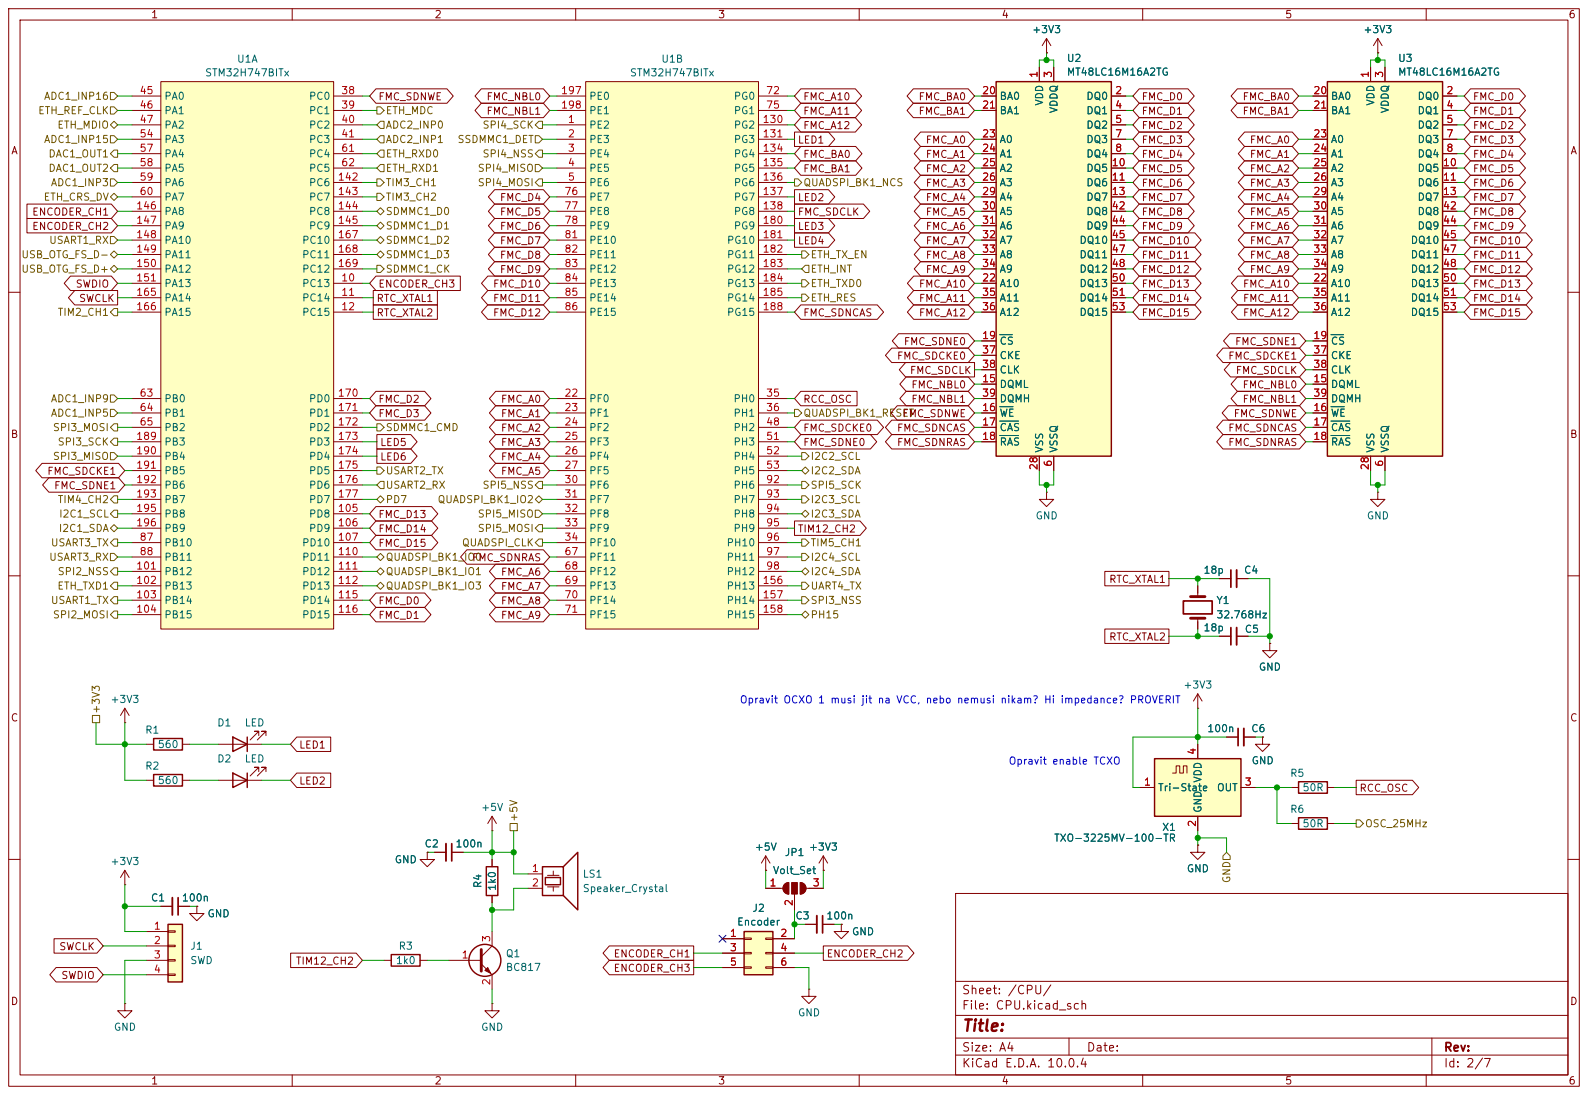
[picture p2: page 2]

6 DQ3 7 DQ4 8 DQ5 10 DQ6 11 DQ7 13 DQML 15 WE 16 CAS 17 RAS 18 CS 19 BA0 20 BA1 21

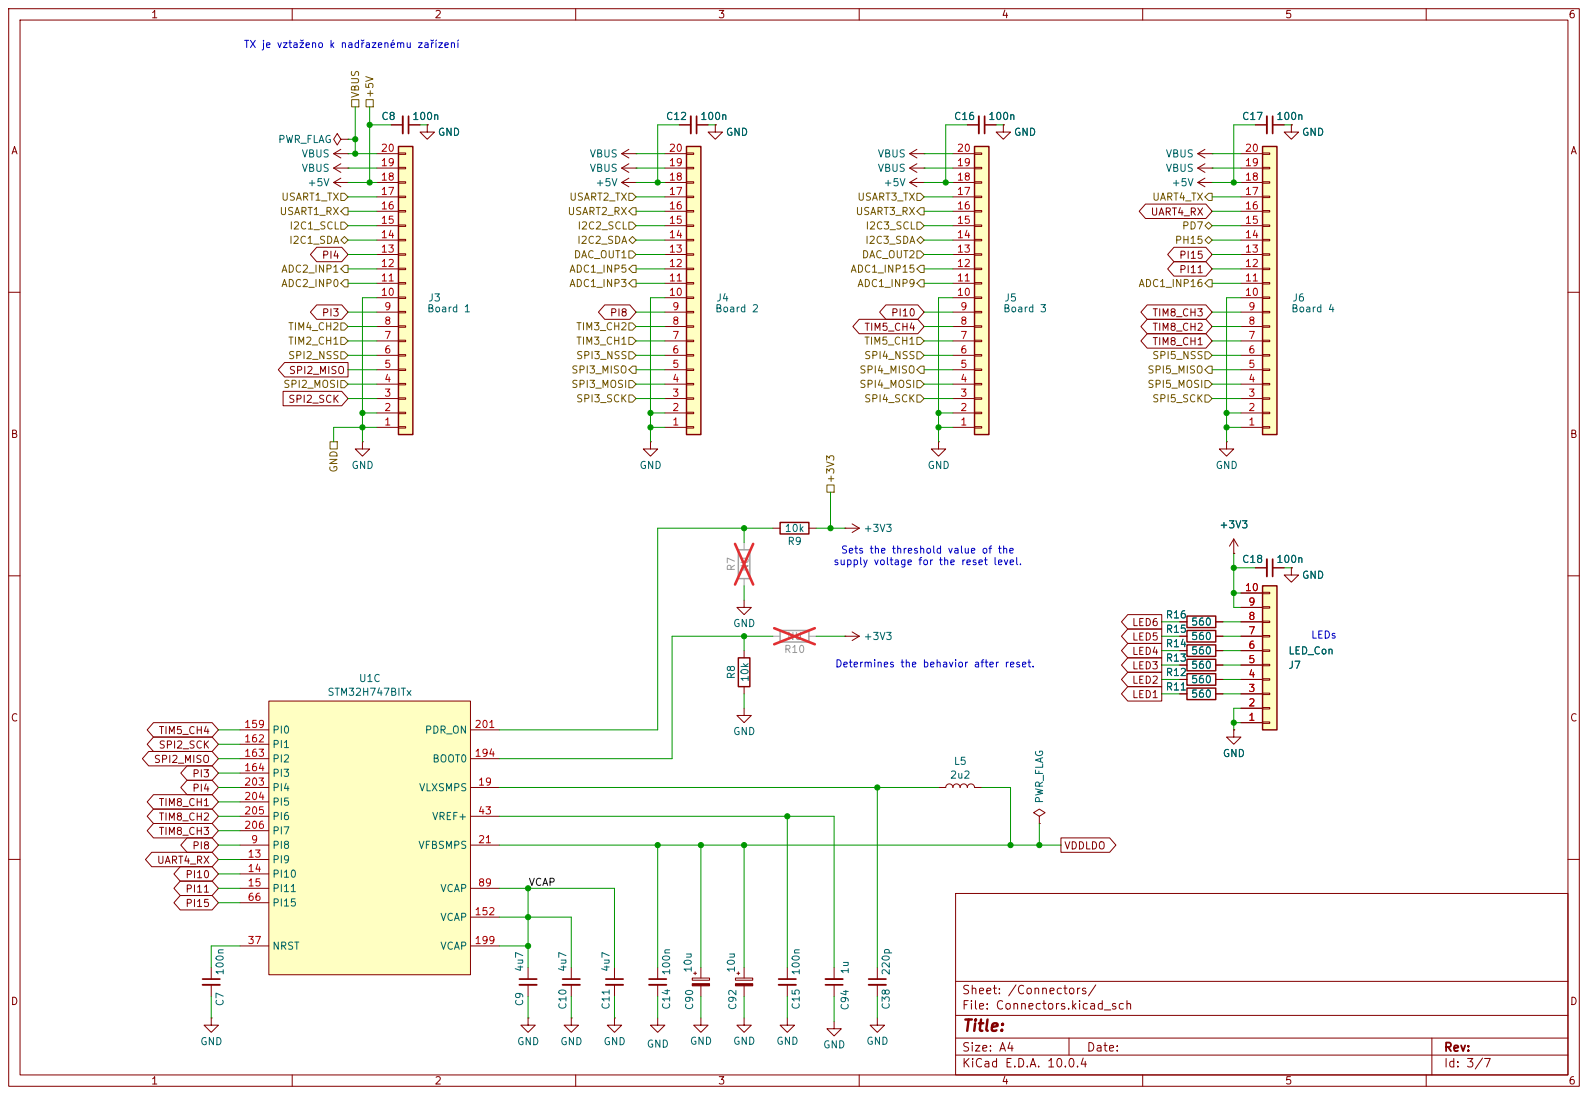
[picture p3: page 3]

supply voltage for the reset level.

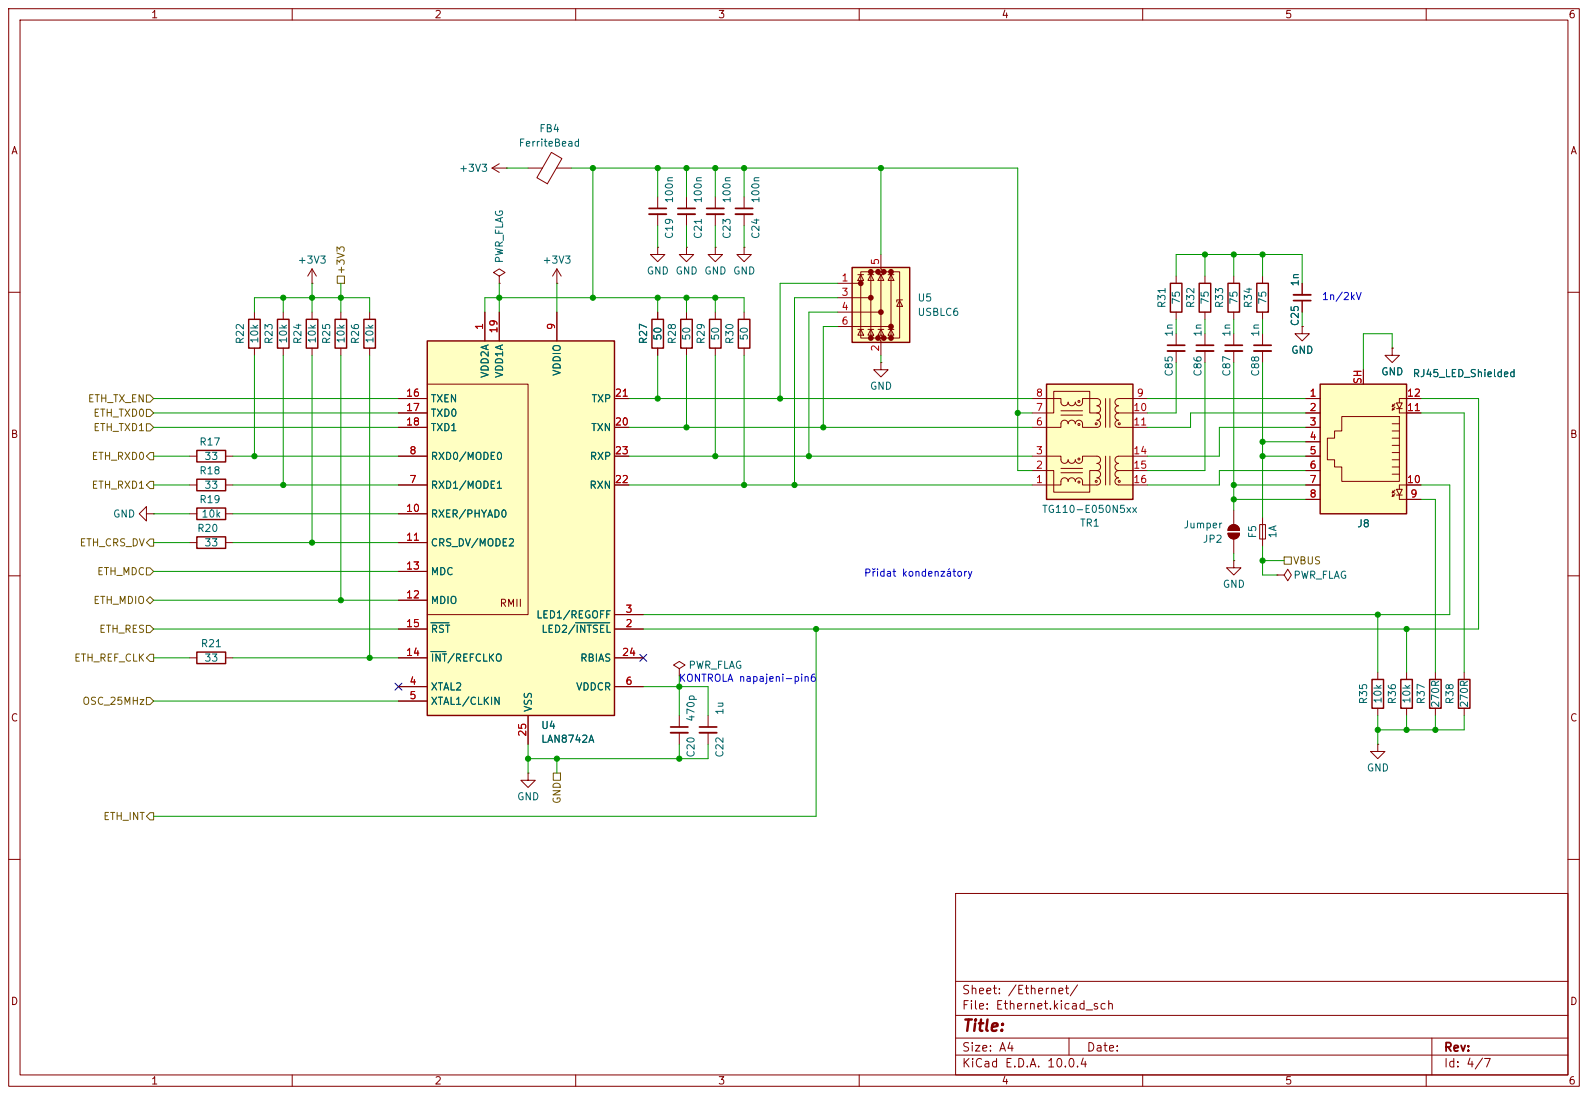
[picture p4: page 4]

7 7
8 8 | | 9 9

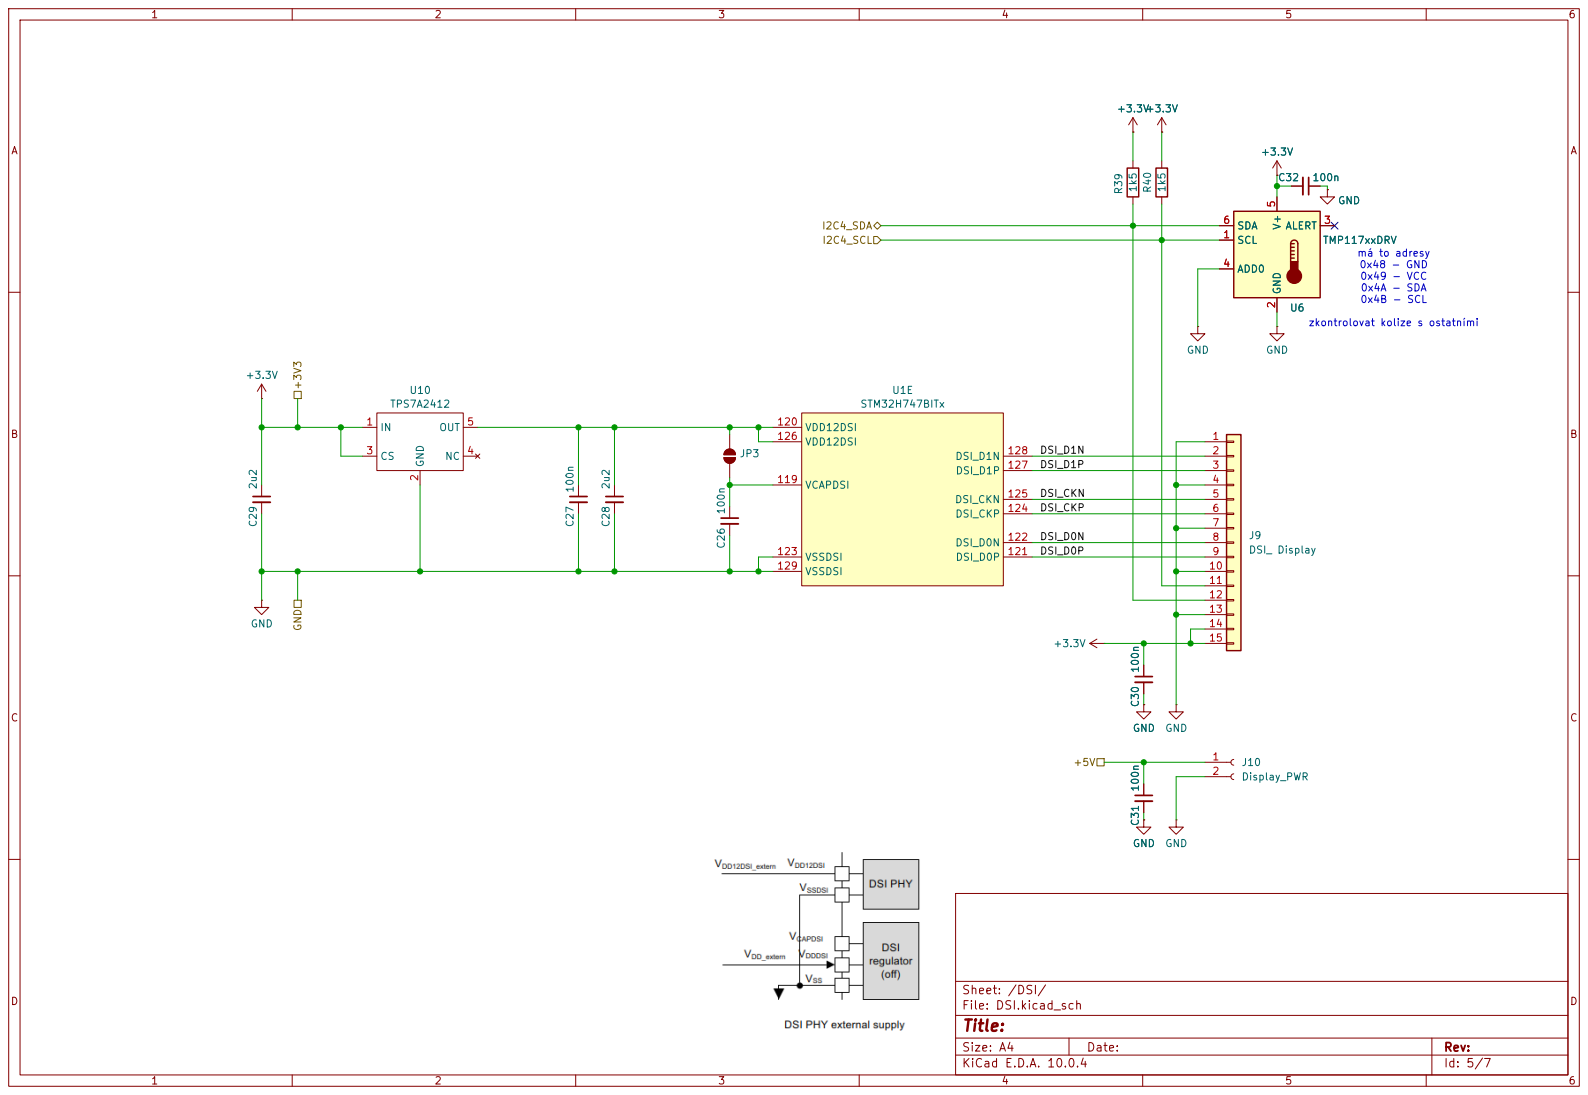
[picture p5: page 5]

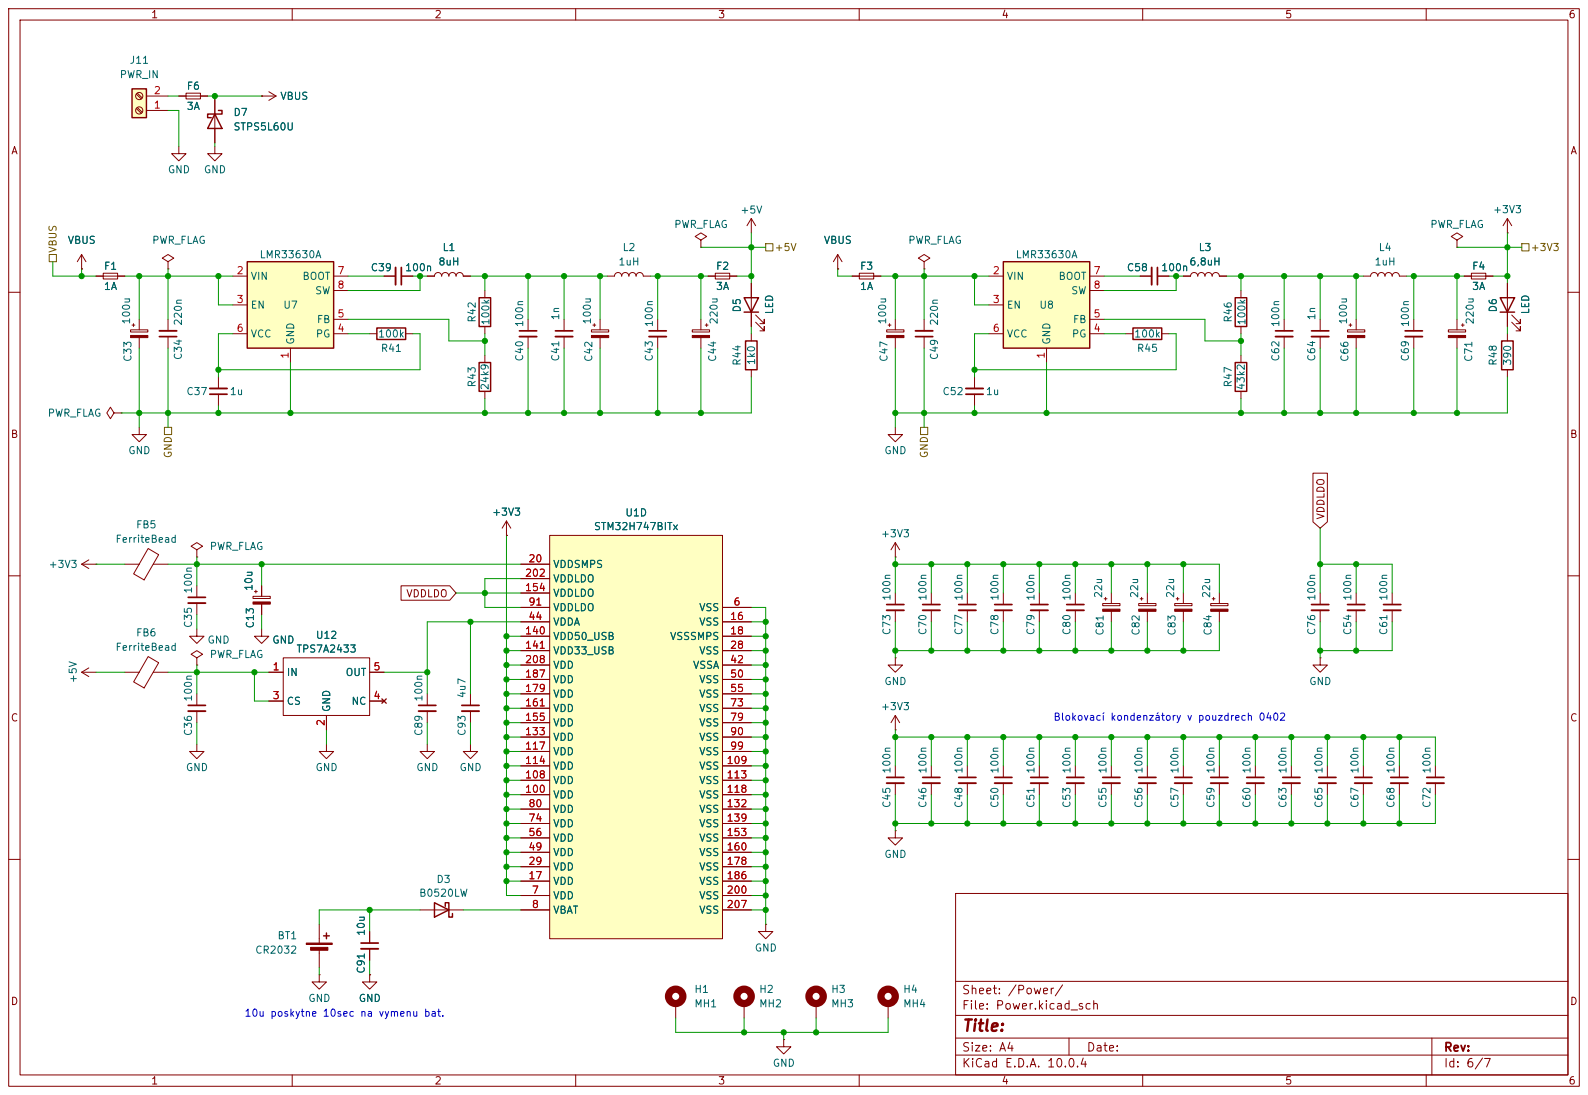
[picture p6: page 6]

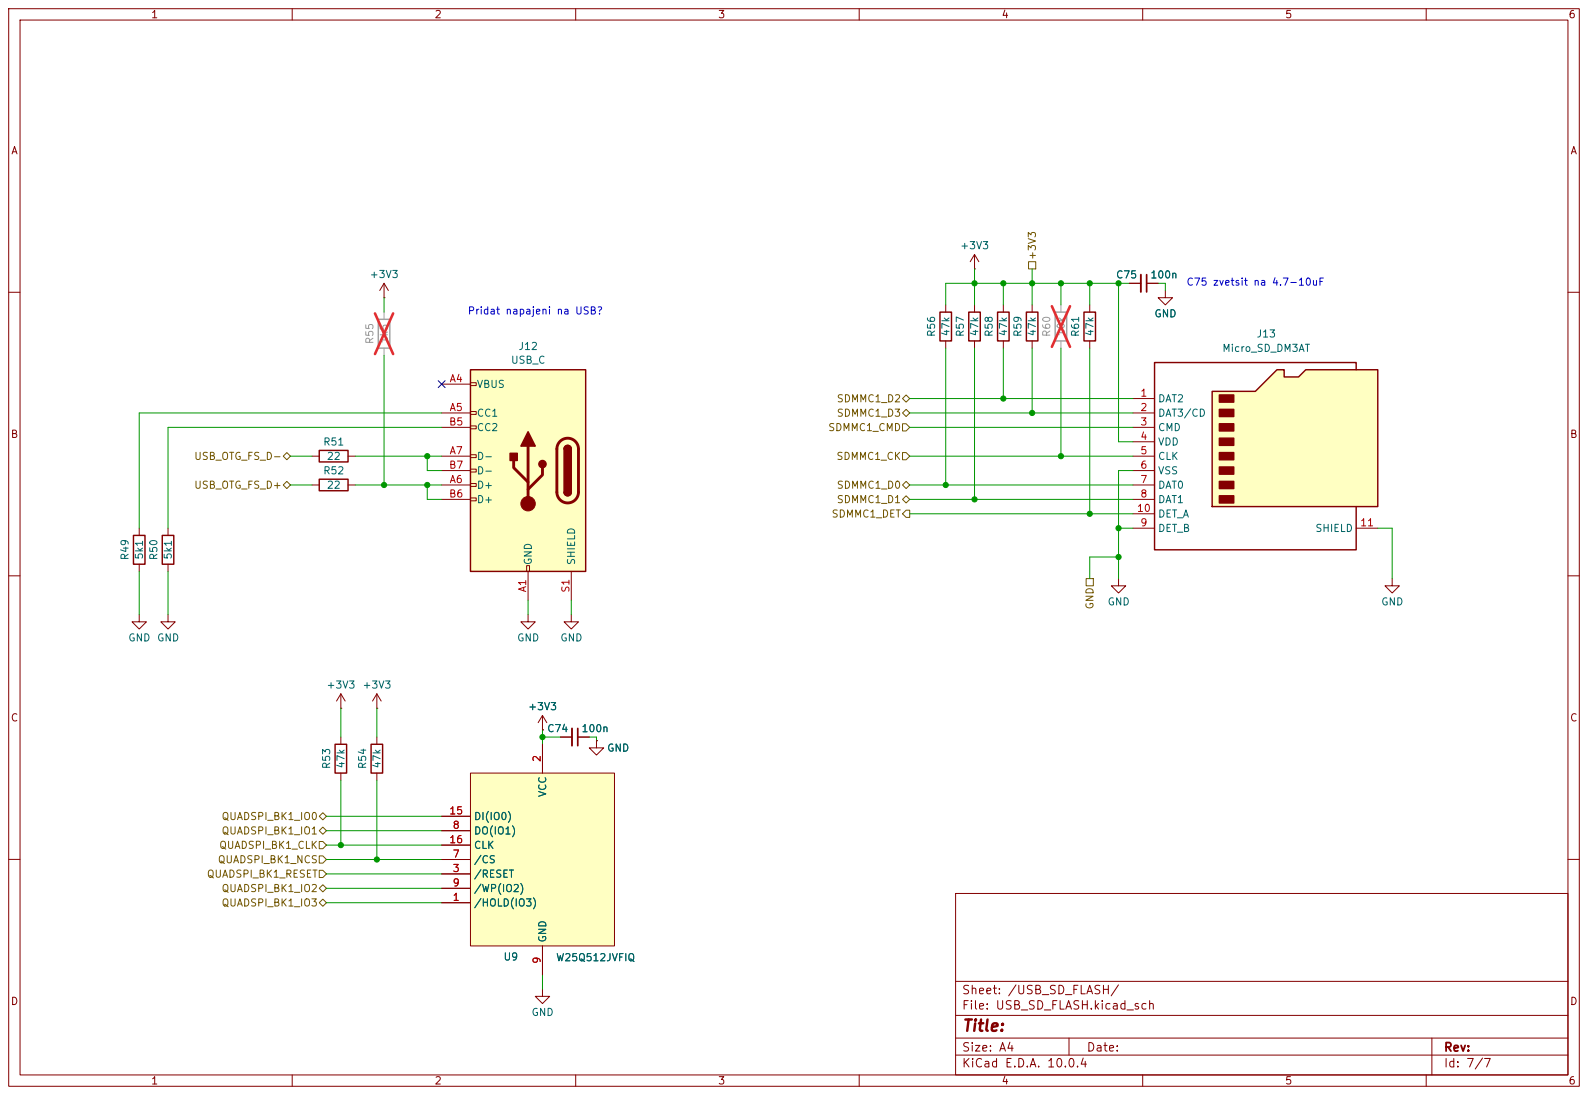
[picture p7: page 7]

2 /RESET 3 /CS 7 DO(IO1) 8 /WP(IO2) 9 GND
