ok2haz/Frequency_Counter_FPGA/Frequency_Counter_FPGA_Module/FPGA_Module_2_0/FPGA_module.pdf

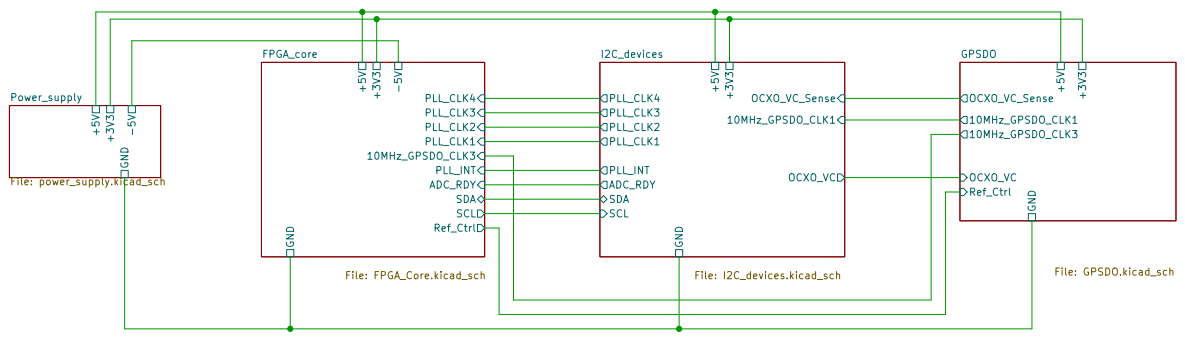
[picture p8: page 1]

FPGA_core

GPSDO

Size: A4 | Rev: 1.0
KiCad E.D.A. 10.0.4 | Id: 1/5

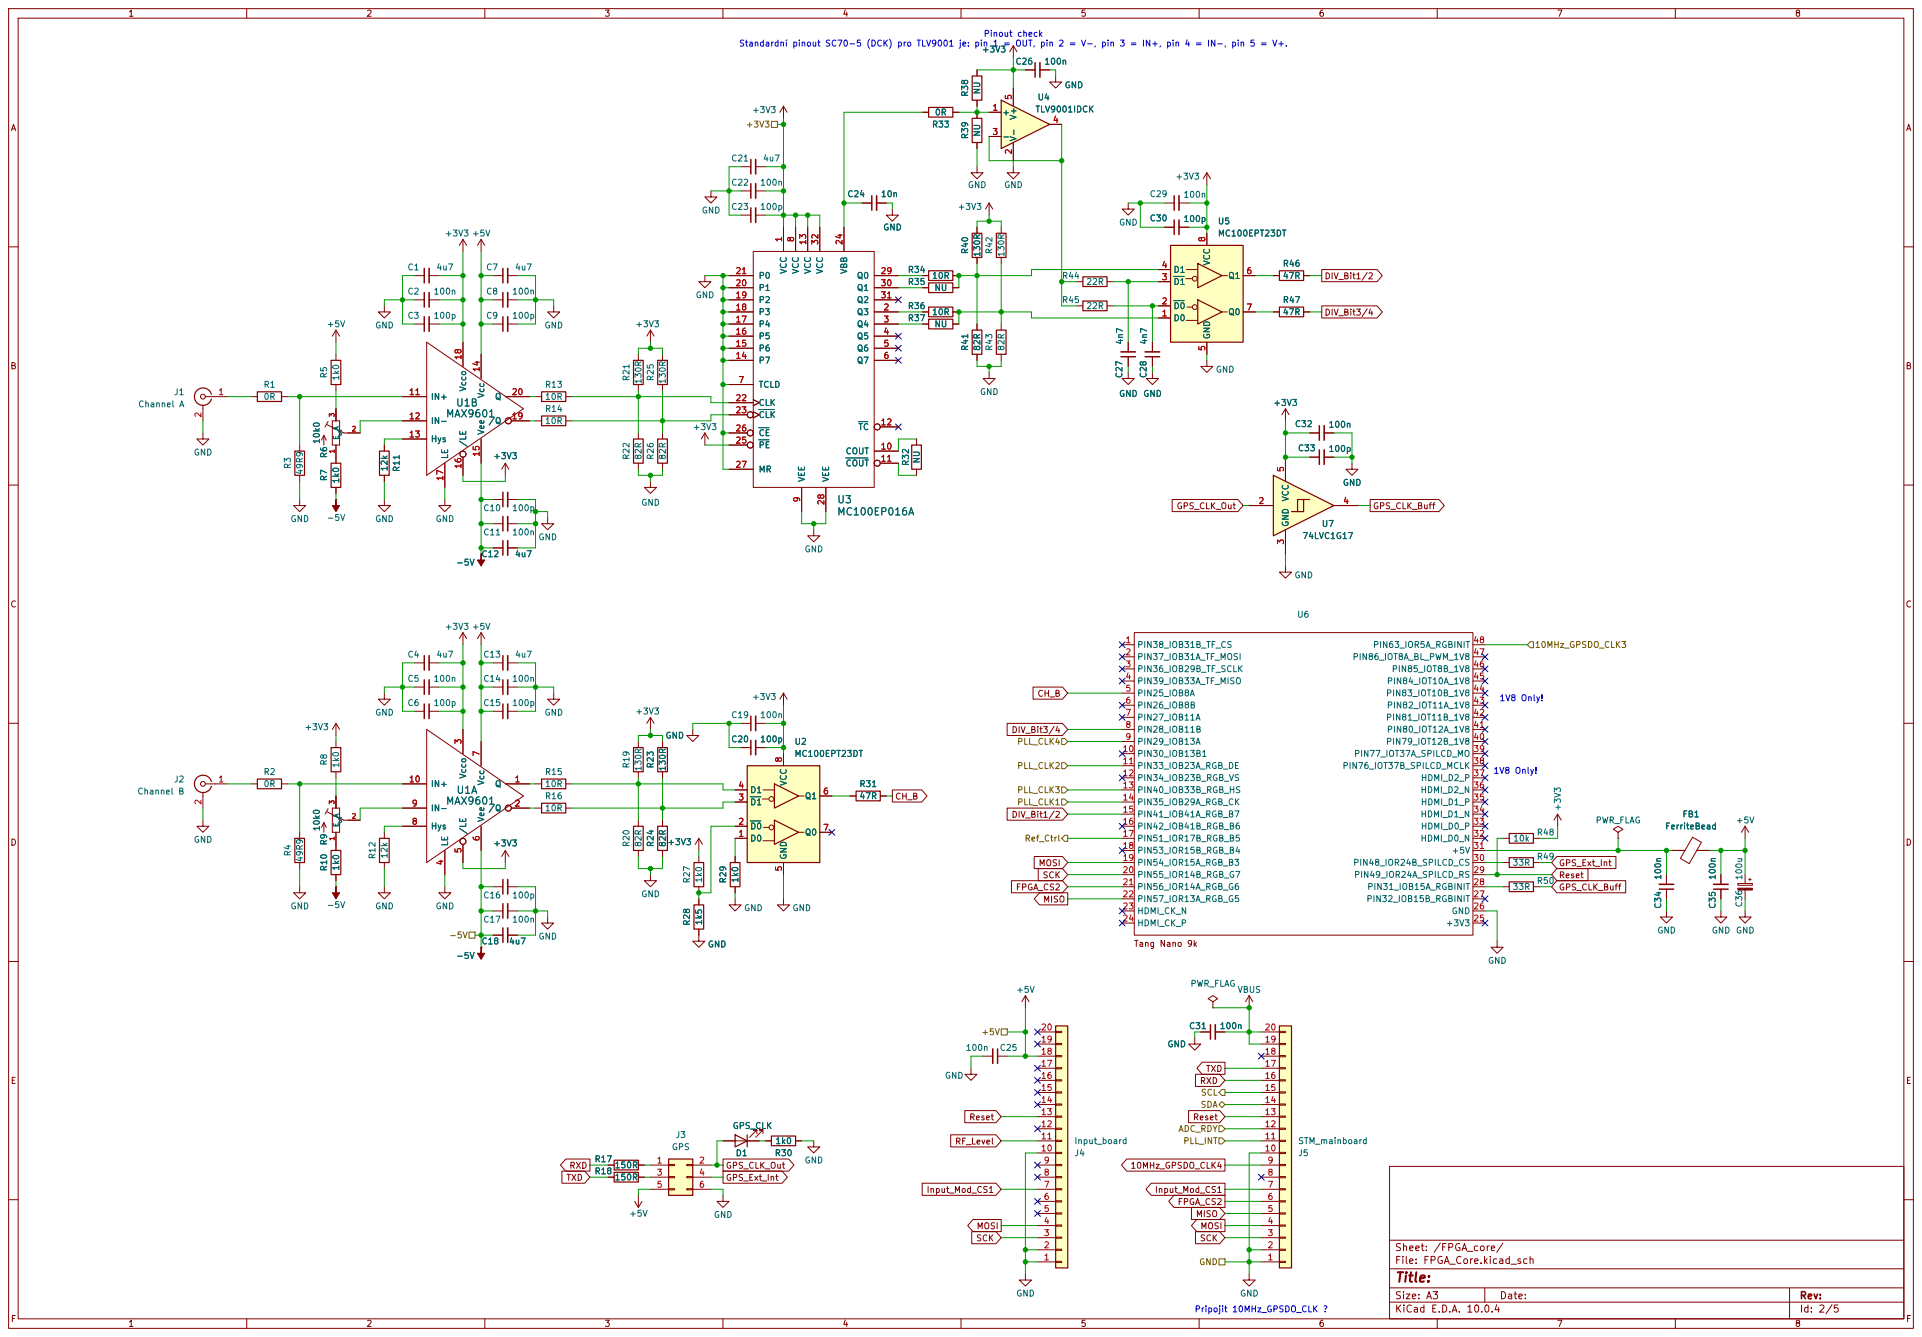
[picture p9: page 2]

Size: A3 | Rev:

F Date:

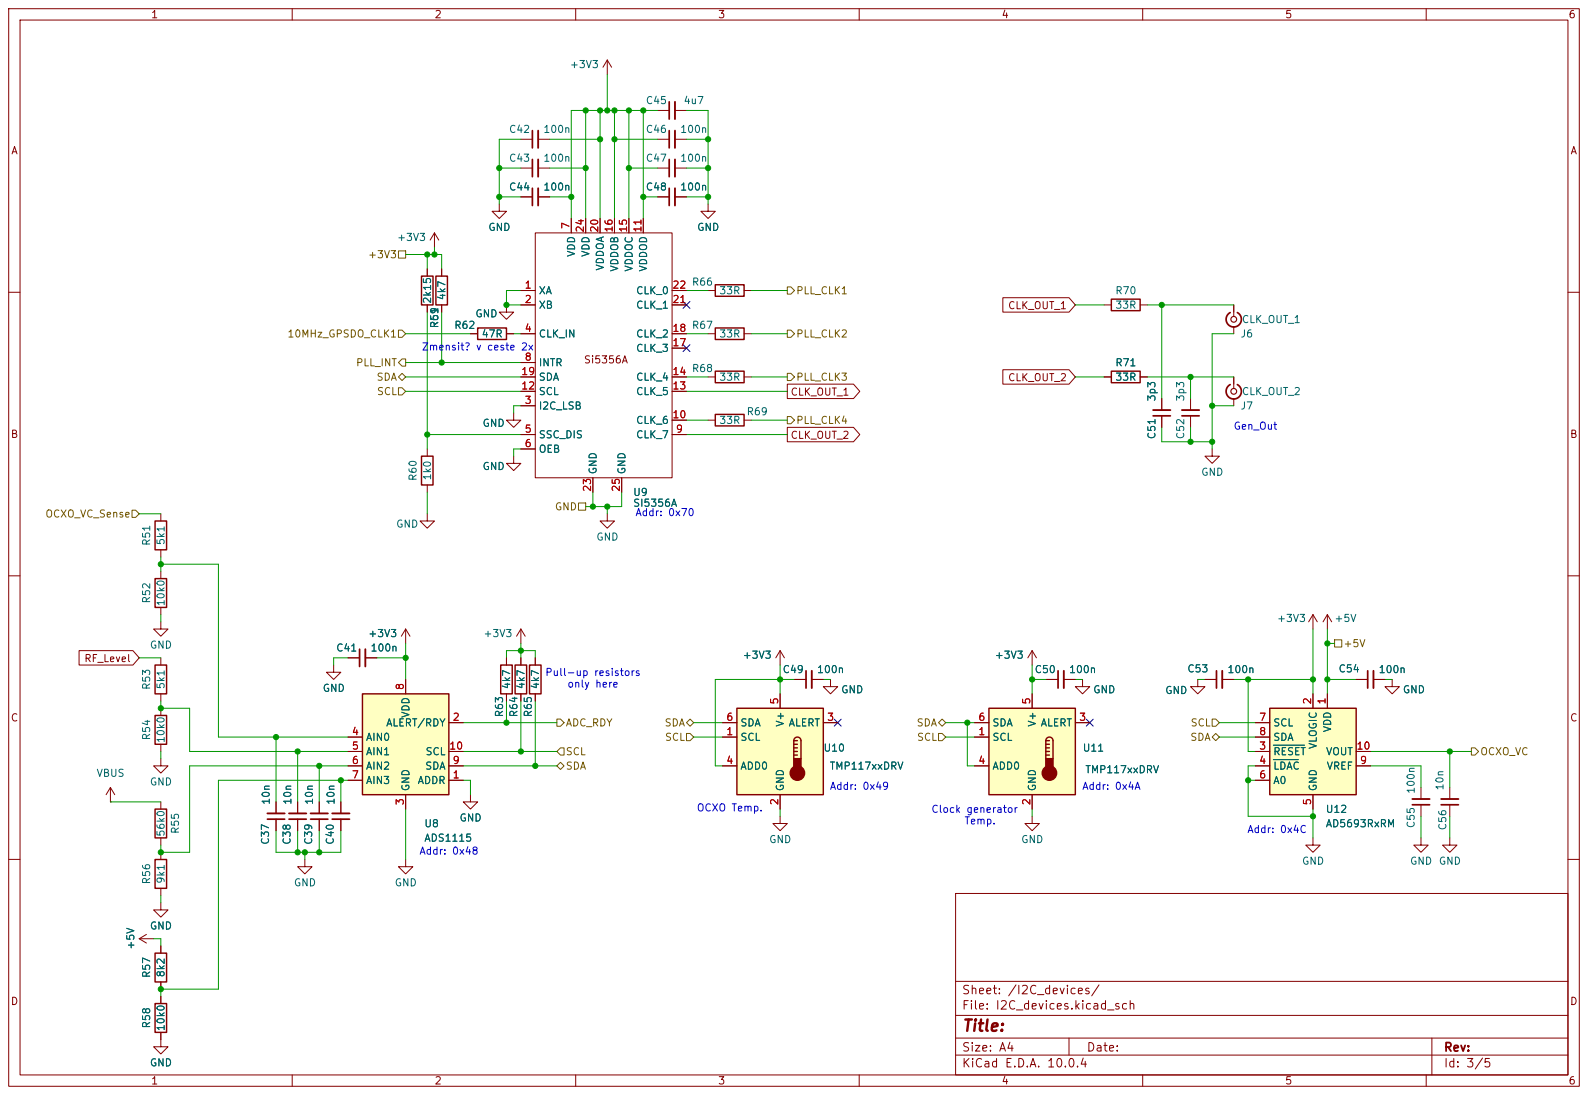
[picture p10: page 3]

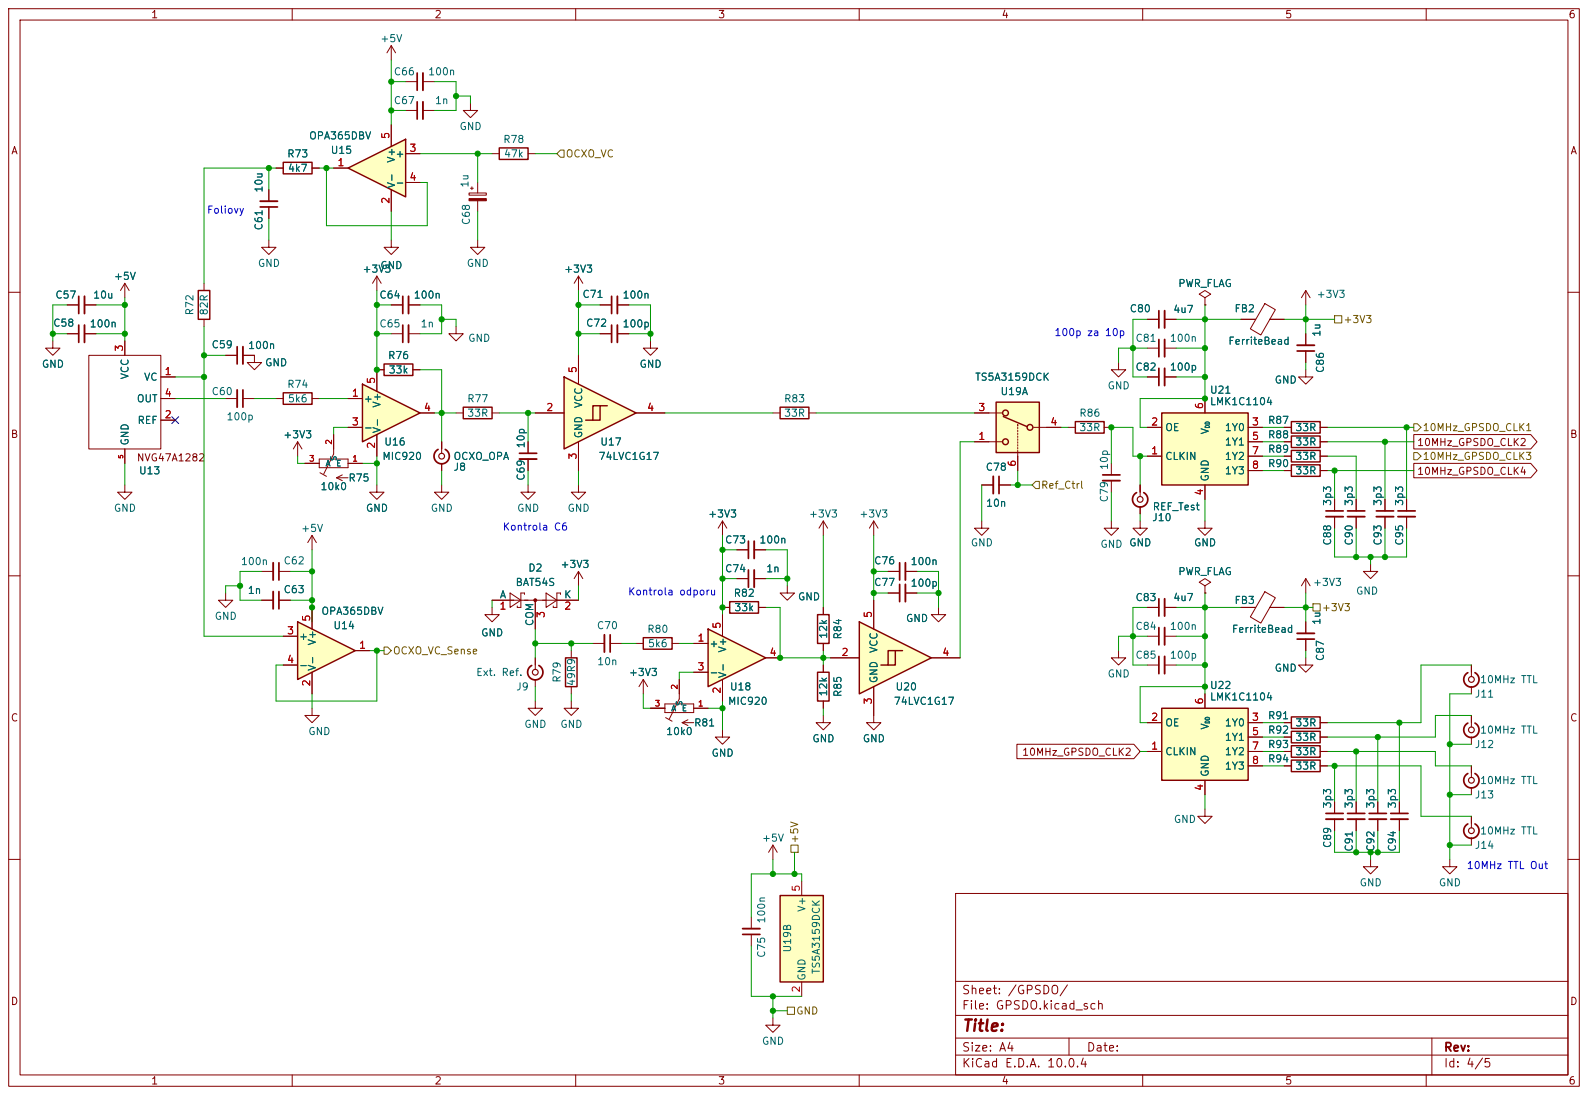
[picture p11: page 4]

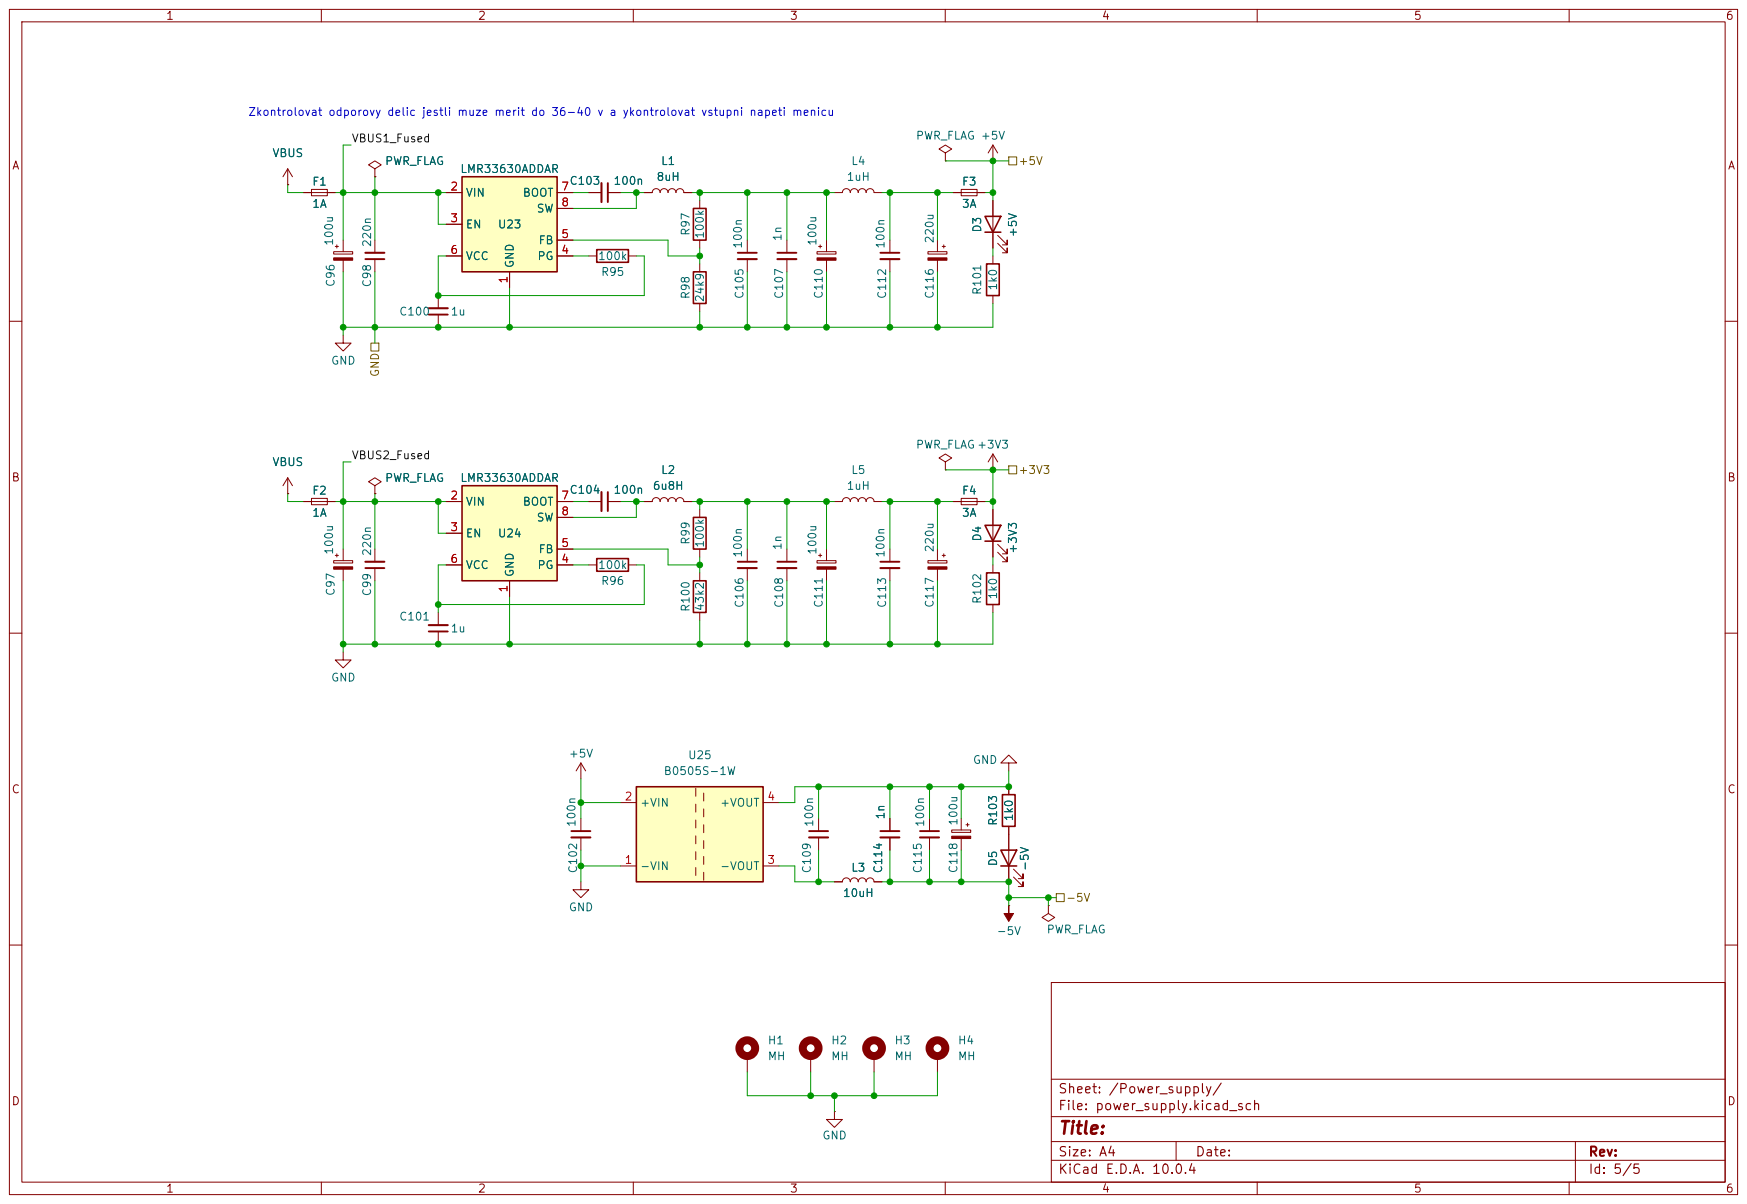
[picture p12: page 5]

VBUS2_Fused Zkontrolovat odporovy delic jestli muze merit do 36-40 v a ykontrolovat vstupni napeti menicu
