ok2haz/Frequency_Counter_FPGA/Frequency_Counter_STM32H757/H757_LED.ioc

Mcu.UserName=STM32H757BITx
PA1.Signal=ETH_REF_CLK
PA10.Signal=USART1_RX
PA11.Signal=USB_OTG_FS_DM
PA12.Signal=USB_OTG_FS_DP
PA2.Signal=ETH_MDIO
PA7.Signal=ETH_CRS_DV
PB12.GPIO_Label=SPI2_RCK
PB12.Signal=GPIO_Output
PB13.Signal=ETH_TXD1
PB14.Signal=USART1_TX
PB15.Signal=SPI2_MOSI
PC0.Signal=FMC_SDNWE
PC1.Signal=ETH_MDC
PC10.Signal=SDMMC1_D2
PC11.Signal=SDMMC1_D3
PC12.Signal=SDMMC1_CK
PC4.Signal=ETH_RXD0
PC5.Signal=ETH_RXD1
PC8.Signal=SDMMC1_D0
PC9.Signal=SDMMC1_D1
PD0.Signal=FMC_D2_DA2
PD1.Signal=FMC_D3_DA3
PD10.Signal=FMC_D15_DA15
PD11.GPIO_Label=QSPI BK1 IO0
PD11.Signal=QUADSPI_BK1_IO0
PD12.GPIO_Label=QSPI BK1 IO1
PD12.Signal=QUADSPI_BK1_IO1
PD13.GPIO_Label=QSPI BK1 IO3
PD13.Signal=QUADSPI_BK1_IO3
PD14.Signal=FMC_D0_DA0
PD15.Signal=FMC_D1_DA1
PD2.Signal=SDMMC1_CMD
PD8.Signal=FMC_D13_DA13
PD9.Signal=FMC_D14_DA14
PE0.Signal=FMC_NBL0
PE1.Signal=FMC_NBL1
PE10.Signal=FMC_D7_DA7
PE11.Signal=FMC_D8_DA8
PE12.Signal=FMC_D9_DA9
PE13.Signal=FMC_D10_DA10
PE14.Signal=FMC_D11_DA11
PE15.Signal=FMC_D12_DA12
PE3.GPIO_Label=SD_DET
PE3.Signal=GPIO_Input
PE7.Signal=FMC_D4_DA4
PE8.Signal=FMC_D5_DA5
PE9.Signal=FMC_D6_DA6
PF0.Signal=FMC_A0
PF1.Signal=FMC_A1
PF10.GPIO_Label=QSPI CLK
PF10.Signal=QUADSPI_CLK
PF11.Signal=FMC_SDNRAS
PF12.Signal=FMC_A6
PF13.Signal=FMC_A7
PF14.Signal=FMC_A8
PF15.Signal=FMC_A9
PF2.Signal=FMC_A2
PF3.Signal=FMC_A3
PF4.Signal=FMC_A4
PF5.Signal=FMC_A5
PF7.GPIO_Label=QSPI BK1 IO2
PF7.Signal=QUADSPI_BK1_IO2
PG0.Signal=FMC_A10
PG1.Signal=FMC_A11
PG11.Signal=ETH_TX_EN
PG12.GPIO_Label=ETH_INT
PG12.Signal=GPIO_Input
PG13.Signal=ETH_TXD0
PG14.GPIO_Label=ETH_RES
PG14.Signal=GPIO_Output
PG15.Signal=FMC_SDNCAS
PG2.Signal=FMC_A12
PG3.GPIO_Label=LED_1
PG3.Signal=GPIO_Output
PG4.Signal=FMC_A14_BA0
PG5.Signal=FMC_A15_BA1
PG6.GPIO_Label=QSPI BK1 NCS
PG6.Signal=QUADSPI_BK1_NCS
PG7.GPIO_Label=LED_2
PG7.Signal=GPIO_Output
PG8.Signal=FMC_SDCLK
PH11.Signal=I2C4_SCL
PH12.Signal=I2C4_SDA
PH2.Signal=FMC_SDCKE0
PH3.Signal=FMC_SDNE0
PI1.Signal=SPI2_SCK
PI2.Signal=SPI2_MISO
PI4.Signal=GPIO_Output
