ok2haz/Frequency_Counter_FPGA/Frequency_Counter_STM32H757/CM7/Core/Src/main.c

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
/* Includes ------------------------------------------------------------------*/
#include "main.h"
#include "FreeRTOS.h"
#include "cmsis_os2.h"
#include "adc.h"
#include "dsihost.h"
#include "fatfs.h"
#include "i2c.h"
#include "ltdc.h"
#include "quadspi.h"
#include "rtc.h"
#include "sdmmc.h"
#include "spi.h"
#include "usart.h"
#include "usb_device.h"
#include "gpio.h"
#include "fmc.h"

/* USER CODE BEGIN Includes */
#include <stdio.h>
#include "ws_panel.h"
#include "tc358762.h"
#include "ft5x06.h"
#include "beeper.h"
#include "si5356.h"
#include "watchdog.h"      /* IWDG1 watchdog (init pred schedulerem) */
#include "bootled.h"       /* boot selftest blikani na LED_1 (PG3) */
#include "freertos_shared.h"  /* g_brightness — ulozeny jas z BKP */
#include <string.h>        /* strncpy — g_reset_text */
#include "usb_console.h"   /* prepinac konzole USART1 <-> USB CDC (USE_USB_CDC_CONSOLE) */
extern UART_HandleTypeDef huart1;
extern I2C_HandleTypeDef hi2c4;
extern DSI_HandleTypeDef hdsi;
extern LTDC_HandleTypeDef hltdc;
/* USER CODE END Includes */

/* USER CODE BEGIN PD */

#ifndef HSEM_ID_0
#define HSEM_ID_0 (0U) /* HW semaphore 0*/
#endif

/* USER CODE END PD */


void SystemClock_Config(void);
void PeriphCommonClock_Config(void);
void MX_FREERTOS_Init(void);
/* USER CODE BEGIN PFP */
static void MPU_Config(void);
/* USER CODE END PFP */

/* USER CODE BEGIN 0 */

/**
  * @brief  Konfigurace MPU pro SDRAM framebuffer.
  *
  * Bez MPU konfigurace bere ARM Cortex-M7 SDRAM (0xC0000000) jako default
  * Write-Back cacheable region. To znamena, ze CPU zapisy zustanou v D-cache
  * dokud neprijde SCB_CleanDCache flush. LTDC ale cte primo ze SDRAM pres AXI,
  * coz vede k race conditions zejmena pri psani menicich se dat.
  *
  * Tato funkce konfiguruje 4 MB region na 0xC0000000 jako Write-Through cache:
  *   - CPU zapisy jdou IHNED do SDRAM (LTDC vidi konzistentni data)
  *   - CPU cteni stale vyuziva cache (rychle)
  *   - Neni potreba explicitni SCB_CleanDCache po zapisu do FB
  */
static void MPU_Config(void)
{
    MPU_Region_InitTypeDef MPU_InitStruct = {0};

    /* Vypnout MPU pred zmenou */
    HAL_MPU_Disable();

    /* Region 0: SDRAM framebuffery (0xC0000000, 4 MB, Write-Through).
     * Triple buffering: FB0 @C0000000, FB1 @C0100000, FB2 @C0200000 (vse RGB565,
     * 1 MB stride); zbytek regionu (@C0300000) rezerva. WT = CPU zapisy jdou hned
     * do SDRAM (LTDC/DMA2D ctou konzistentni data). DMA2D zapisy ale obchazi
     * D-cache -> po DMA2D copy/blit do FB se cache zneplatnuje v prim_stm32_hal.c. */
    MPU_InitStruct.Enable           = MPU_REGION_ENABLE;
    MPU_InitStruct.Number           = MPU_REGION_NUMBER0;
    MPU_InitStruct.BaseAddress      = 0xC0000000;
    MPU_InitStruct.Size             = MPU_REGION_SIZE_4MB;   /* FB0/FB1/FB2 (triple buffer), vse WT */
    MPU_InitStruct.SubRegionDisable = 0x00;
    MPU_InitStruct.TypeExtField     = MPU_TEX_LEVEL0;
    MPU_InitStruct.AccessPermission = MPU_REGION_FULL_ACCESS;
    MPU_InitStruct.DisableExec      = MPU_INSTRUCTION_ACCESS_DISABLE;
    MPU_InitStruct.IsShareable      = MPU_ACCESS_NOT_SHAREABLE;
    MPU_InitStruct.IsCacheable      = MPU_ACCESS_CACHEABLE;
    MPU_InitStruct.IsBufferable     = MPU_ACCESS_NOT_BUFFERABLE;  /* WT = Cacheable+NotBufferable */
    HAL_MPU_ConfigRegion(&MPU_InitStruct);

    /* Region 1: sdram test buffer (UART 'sdram' write/read) + scratch (0xC0400000,
     * 4 MB, Normal Write-Back). Mimo framebuffery (region 0 = 4 MB); cachovane (WBWA).
     * Jen CPU (necte LTDC/DMA2D) -> WB je OK. */
    MPU_InitStruct.Enable           = MPU_REGION_ENABLE;
    MPU_InitStruct.Number           = MPU_REGION_NUMBER1;
    MPU_InitStruct.BaseAddress      = 0xC0400000;
    MPU_InitStruct.Size             = MPU_REGION_SIZE_4MB;
    MPU_InitStruct.SubRegionDisable = 0x00;
    MPU_InitStruct.TypeExtField     = MPU_TEX_LEVEL1;            /* TEX=001,C=1,B=1 -> WBWA */
    MPU_InitStruct.AccessPermission = MPU_REGION_FULL_ACCESS;
    MPU_InitStruct.DisableExec      = MPU_INSTRUCTION_ACCESS_DISABLE;
    MPU_InitStruct.IsShareable      = MPU_ACCESS_NOT_SHAREABLE;
    MPU_InitStruct.IsCacheable      = MPU_ACCESS_CACHEABLE;
    MPU_InitStruct.IsBufferable     = MPU_ACCESS_BUFFERABLE;
    HAL_MPU_ConfigRegion(&MPU_InitStruct);

    /* Region 2: IPC sdilena pamet CM7<->CM4 (SRAM4 / domena D3, 0x38000000, 64 KB)
     * — Normal NON-CACHEABLE + SHAREABLE. Bez D-cache: zapisy CM7 uvidi CM4 (a
     * naopak) bez SCB_Clean/Invalidate -> zaklad pro seqlock IPC snapshot + cmd/resp
     * ringy. Linker sekce .ipc_shared @RAM_D3 (STM32H757BITX_FLASH.ld). Zatim jen
     * priprava regionu (IPC vrstva prijde pozdeji). ⚠️ Bez tohoto by SRAM4 bela
     * default kesovana -> IPC "skoro funguje" a pada nahodne. */
    MPU_InitStruct.Enable           = MPU_REGION_ENABLE;
    MPU_InitStruct.Number           = MPU_REGION_NUMBER2;
    MPU_InitStruct.BaseAddress      = 0x38000000;
    MPU_InitStruct.Size             = MPU_REGION_SIZE_64KB;
    MPU_InitStruct.SubRegionDisable = 0x00;
    MPU_InitStruct.TypeExtField     = MPU_TEX_LEVEL1;            /* TEX=001,C=0,B=0 -> Normal non-cacheable */
    MPU_InitStruct.AccessPermission = MPU_REGION_FULL_ACCESS;
    MPU_InitStruct.DisableExec      = MPU_INSTRUCTION_ACCESS_DISABLE;
    MPU_InitStruct.IsShareable      = MPU_ACCESS_SHAREABLE;
    MPU_InitStruct.IsCacheable      = MPU_ACCESS_NOT_CACHEABLE;
    MPU_InitStruct.IsBufferable     = MPU_ACCESS_NOT_BUFFERABLE;
    HAL_MPU_ConfigRegion(&MPU_InitStruct);

    /* Zapnout MPU s default mapou pro nechraneny privilegovany pristup */
    HAL_MPU_Enable(MPU_PRIVILEGED_DEFAULT);
}

/* USER CODE END 0 */

/**
  * @brief  The application entry point.
  * @retval int
  */
int main(void)
{

/* USER CODE BEGIN Boot_Mode_Sequence_0 */
  int32_t timeout;
  /* MPU MUSI byt nakonfigurovan PRED enable D-Cache.
   * Voláme zde misto v USER CODE BEGIN MPU_Configuration, protože
   * tamten region existuje pouze kdyz MPU je povoleno v IOC.
   * V IOC mame CORTEX_M7.MPU_Control=__NULL (vypnuto), takze region
   * po regeneraci CubeMX zmizi a volani by se ztratilo.
   * Boot_Mode_Sequence_0 region je naopak generovan vzdycky. */
  MPU_Config();
/* USER CODE END Boot_Mode_Sequence_0 */

  /* Enable the CPU Cache */

  /* Enable I-Cache---------------------------------------------------------*/
  SCB_EnableICache();

  /* Enable D-Cache---------------------------------------------------------*/
  SCB_EnableDCache();

/* USER CODE BEGIN Boot_Mode_Sequence_1 */
  /* Wait until CPU2 boots and enters in stop mode or timeout.
   * ⚠️ NEspadnout do Error_Handler pri timeoutu! Displej + veskera logika bezi
   * na CM7; CM4 dnes jen blika LED. Kdyz CM4 nenabehne (prazdna/vadna bank2 nebo
   * BCM4=0 v option bytes), D2CKRDY se nikdy nenastavi -> puvodni Error_Handler
   * = tichy zasek PRED init displeje = CERNA obrazovka. Misto toho pokracujeme
   * degradovane a priznak g_cm4_absent zviditelnime (UART boot log + Health + SYS
   * pill amber). Behem tohoto boot fragmentu jeste nebezi HAL/UART, jen RAM zapis. */
  timeout = 0xFFFF;
  while((__HAL_RCC_GET_FLAG(RCC_FLAG_D2CKRDY) != RESET) && (timeout-- > 0));
  if ( timeout < 0 )
  {
    g_cm4_absent = 1;
  }
/* USER CODE END Boot_Mode_Sequence_1 */
  /* MCU Configuration--------------------------------------------------------*/

  /* Reset of all peripherals, Initializes the Flash interface and the Systick. */
  HAL_Init();

  /* USER CODE BEGIN Init */
  setvbuf(stdout, NULL, _IONBF, 0);
  /* USER CODE END Init */

  /* Configure the system clock */
  SystemClock_Config();

  /* Configure the peripherals common clocks */
  PeriphCommonClock_Config();
/* USER CODE BEGIN Boot_Mode_Sequence_2 */
/* When system initialization is finished, Cortex-M7 will release Cortex-M4 by means of
HSEM notification */
/*HW semaphore Clock enable*/
__HAL_RCC_HSEM_CLK_ENABLE();
/*Take HSEM */
HAL_HSEM_FastTake(HSEM_ID_0);
/*Release HSEM in order to notify the CPU2(CM4)*/
HAL_HSEM_Release(HSEM_ID_0,0);
/* wait until CPU2 wakes up from stop mode.
 * ⚠️ Stejny duvod jako Boot_Mode_Sequence_1: kdyz CM4 vubec nenabehl, ani se
 * neprobudi z HSEM -> timeout. Pokracuj degradovane misto tiche tmy. */
timeout = 0xFFFF;
while((__HAL_RCC_GET_FLAG(RCC_FLAG_D2CKRDY) == RESET) && (timeout-- > 0));
if ( timeout < 0 )
{
g_cm4_absent = 1;
}
/* USER CODE END Boot_Mode_Sequence_2 */

  /* Initialize all configured peripherals */
  MX_GPIO_Init();
  MX_FMC_Init();
  MX_SPI2_Init();
  MX_I2C4_Init();
  MX_DSIHOST_DSI_Init();
  MX_LTDC_Init();
  MX_USART1_UART_Init();
  MX_RTC_Init();
  MX_ADC3_Init();
  MX_QUADSPI_Init();
  MX_SDMMC1_SD_Init();
  MX_FATFS_Init();
  /* USER CODE BEGIN 2 */

  /* Pricina resetu (24/7 diagnostika): zachyt RCC->RSR a smaz flagy (RMVF),
   * aby pristi boot videl cerstvou pricinu. IWDG1RSTF = watchdog zasahl (system
   * v behu zatuhl a auto-zotavil se) -> Health okno to ukaze cervene. */
  g_reset_rsr = RCC->RSR;
  RCC->RSR |= RCC_RSR_RMVF;
  {
    const char *rc; uint8_t bad = 0;
    if      (g_reset_rsr & RCC_RSR_IWDG1RSTF) { rc = "WATCHDOG!"; bad = 1; }
    else if (g_reset_rsr & RCC_RSR_WWDG1RSTF) { rc = "WWDG!";     bad = 1; }
    else if (g_reset_rsr & RCC_RSR_SFT1RSTF)    rc = "SW reset";
    else if (g_reset_rsr & RCC_RSR_PORRSTF)     rc = "power-on";
    else if (g_reset_rsr & RCC_RSR_BORRSTF)     rc = "brownout";
    else if (g_reset_rsr & RCC_RSR_PINRSTF)     rc = "NRST pin";
    else                                        rc = "---";
    strncpy((char *)g_reset_text, rc, sizeof(g_reset_text) - 1);
    g_reset_text[sizeof(g_reset_text) - 1] = '\0';
    g_reset_bad = bad;
    printf("[RESET] pricina: %s%s\n", rc,
           bad ? " (system zatuhl a byl auto-resetovan!)" : "");
  }

  /* CM4 (D2) boot handshake vyhodnoceny v Boot_Mode_Sequence_1/2 (pred UART).
   * Kdyz nenabehl, jedeme dal (displej je na CM7) — jen o tom nahlas rekni:
   * typicky priznak = naflashovana jen bank1, nebo BCM4=0 v option bytes. */
  if (g_cm4_absent)
    printf("[BOOT] CM4 (D2) nenabehl -> degradovany rezim. Zkontroluj: "
           "naflashovana bank2 @0x08100000 + option byte BCM4=1.\n");

  /* ⚠️ Vycisti framebuffery na CERNO hned na zacatku: SDRAM (FMC, 0xC0000000)
   * NENI resetem nulovana -> po soft resetu (napr. Menu->Restart) drzi POSLEDNI
   * snimek pred restartem (klidne trend/jine okno) a LTDC ho zacne skenovat drive,
   * nez ho UiTask prekresli -> vypadalo, ze system "nabootuje do trendu". Cerne FB
   * = cisty start. FB0/1/2 = 3x 1 MB stride od 0xC0000000. */
  memset((void *)0xC0000000u, 0, 3u * 0x100000u);

  /* ⚠️ ADC reference VREFBUF: VREF+ (pin 43) NENI na desce spojen s VDDA (zamerne —
   * kvuli sumu ze SMPS), budi se vnitrnim bufferem. Bez reference VREF+ visi (~0,5 V)
   * a ADC3 interni kanaly railuji na 0xFFFF. SCALE0 = VREF_OUT1 ~2,5 V (zmereno 2,51 V),
   * HIZ=0 -> buffer skutecne zene pin VREF+. Vyzaduje >=1uF na VREF+ (na desce dodano).
   * ⚠️🔑 KLICOVE: VREFBUF ma VLASTNI clock `RCC_APB4ENR.VREFEN` (NE pres SYSCFG!) —
   * bez `__HAL_RCC_VREF_CLK_ENABLE()` je cely VREFBUF->CSR MRTVY (zapisy ignorovany,
   * cteni vraci 0, ENVR nedrzi). Tohle byla nejskrytejsi pricina railovani.
   * Neni fatal: kdyby buffer nenabehl, ADC railuje, ale zbytek (displej/FPGA) pojede;
   * stav pres `adcraw` (VREFBUF CSR=0x09 = ENVR+VRR). SensorsTask meri skutecne VREF+
   * z VREFINT (self-measuring) -> presna hodnota SCALE0 nemusi sedet, dopocita se. */
  __HAL_RCC_VREF_CLK_ENABLE();
  HAL_SYSCFG_VREFBUF_VoltageScalingConfig(SYSCFG_VREFBUF_VOLTAGE_SCALE0);
  HAL_SYSCFG_VREFBUF_HighImpedanceConfig(SYSCFG_VREFBUF_HIGH_IMPEDANCE_DISABLE);
  if (HAL_SYSCFG_EnableVREFBUF() != HAL_OK) {
    printf("[WARN] VREFBUF nenabehl (VRR timeout) - ADC reference plovouci\n");
  }

  /* I2C1 (FPGA deska: TMP117 0x49/0x4A, ADS1115 0x48, Si5356A 0x70/0x71) */
  MX_I2C1_Init();

  /* Si5356A clock generator: aplikovat CBPro register map (100 MHz + faze).
   * Pred schedulerem -> bez mutexu (zadna I2C1 konkurence). */
  si5356_init(&hi2c1);

  /* Beeper na PH9 (800 Hz pres TIM7) */
  beeper_init();

  /* DMA2D (Chrom-ART) si inicializuje primitives HAL (prim_stm32_init)
   * pri prvnim renderu obrazovky. */

  /* === Inicializace Waveshare 43H-800480-IPS displeje === */
  printf("\n=== Display init start ===\n");

  /* 1) ATTINY MCU 0x45 potrebuje cas po power-on */
  HAL_Delay(100);

  /* 2) Probe MCU a precist FW ID */
  if (!ws_panel_probe(&hi2c4)) {
      printf("[ERR] Panel probe selhal - pokracuji bez displeje\n");
      bootled_blink_once(BOOTLED_STEP_PANEL_PROBE);
      goto display_skip;
  }

  /* 3) Power-on sekvence: napajeni LCD, uvolnit reset bridge, backlight enable */
  if (!ws_panel_power_on(&hi2c4)) {
      printf("[ERR] Panel power-on selhal\n");
      bootled_blink_once(BOOTLED_STEP_PANEL_POWERON);
      goto display_skip;
  }

  /* 4) Spustit DSI signal - bridge ho potrebuje pred inicializaci */
  if (HAL_DSI_Start(&hdsi) != HAL_OK) {
      printf("[ERR] HAL_DSI_Start selhal\n");
      bootled_blink_once(BOOTLED_STEP_DSI_START);
      goto display_skip;
  }
  HAL_Delay(50);

  /* 5) Inicializovat TC358762 bridge pres DSI generic write */
  if (!tc358762_init(&hdsi)) {
      printf("[ERR] TC358762 init selhal\n");
      bootled_blink_once(BOOTLED_STEP_TC358762);
      goto display_skip;
  }

  /* 6) Reload LTDC layer - aby zacal tlacit pixely z framebufferu */
  HAL_LTDC_Reload(&hltdc, LTDC_RELOAD_IMMEDIATE);

  /* 7) Zapnout podsviceni na ulozeny jas (g_brightness z BKP, jinak default 200) */
  ws_panel_set_backlight(&hi2c4, g_brightness);

  printf("=== Display init dokoncen ===\n");

  /* 8) Probe touch controlleru (po panel power-on, kdy uz neni v resetu) */
  printf("=== Touch init start ===\n");
  if (!ft5x06_probe(&hi2c4)) {
      printf("ft5x06: probe FAILED - touch nebude k dispozici\n");
  } else {
      printf("=== Touch init dokoncen ===\n");
  }
display_skip:
  ;
  /* IWDG1 watchdog (~4 s) — az tesne pred schedulerem (min. hlidany cas pred
   * prvnim refreshem z defaultTasku; startup grace pokryje rozjezd tasku). */
  watchdog_init();
  /* USER CODE END 2 */

  /* Init scheduler */
  osKernelInitialize();  /* Call init function for freertos objects (in cmsis_os2.c) */
  MX_FREERTOS_Init();

  /* Start scheduler */
  osKernelStart();

  /* We should never get here as control is now taken by the scheduler */

  /* Infinite loop */
  /* USER CODE BEGIN WHILE */
  while (1)
  {

    /* USER CODE END WHILE */

    /* USER CODE BEGIN 3 */
  }
  /* USER CODE END 3 */
}

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
/* USER CODE BEGIN 4 */
/* Pozn.: SPI2 nyni slouzi pro FPGA citac kmitoctu (viz fpga_freq.c).
 * Puvodni ShiftRegister_SendByte (74HC595) byl odstranen - kolidoval s PB12,
 * ktere je nyni CS k FPGA. */

/**
  * Přesměrování standardního výstupu (printf) na UART
  */
extern osMutexId_t uartTxMutexHandle;

/* Vystup jednoho bloku konzole: USB CDC (neblokujici, ring) nebo USART1 (blokujici).
 * Prepina USE_USB_CDC_CONSOLE (usb_console.h) — vychozi 0 = USART1 jako dosud. */
static HAL_StatusTypeDef console_send(uint8_t *buf, uint16_t n)
{
#if USE_USB_CDC_CONSOLE
  usb_console_tx(buf, n);
  return HAL_OK;
#else
  return HAL_UART_Transmit(&huart1, buf, n, 100);
#endif
}

int _write(int file, char *ptr, int len)
{
  /* \n -> \r\n expanze: kazda zprava zacne na novem radku od kraje (jinak LF
   * bez CR dela "schodiste"). Timeout 100ms; mutex serializuje soubezne printf
   * (jen za behu scheduleru - pred startem je jednovlaknove). */
  uint8_t buf[160];
  int n = 0;
  HAL_StatusTypeDef status = HAL_OK;
  uint8_t locked = (uartTxMutexHandle != NULL) && (osKernelGetState() == osKernelRunning);

  if (locked) osMutexAcquire(uartTxMutexHandle, osWaitForever);
  for (int i = 0; i < len; i++) {
    if (ptr[i] == '\n' && (n == 0 || buf[n - 1] != '\r')) {
      buf[n++] = '\r';
    }
    buf[n++] = (uint8_t)ptr[i];
    if (n >= (int)sizeof(buf) - 1) {                 /* prubezny flush */
      if (console_send(buf, (uint16_t)n) != HAL_OK) { status = HAL_ERROR; break; }
      n = 0;
    }
  }
  if (status == HAL_OK && n > 0) status = console_send(buf, (uint16_t)n);
  if (locked) osMutexRelease(uartTxMutexHandle);

  /* Vrátí počet vstupních znaku, nebo -1 při chybě */
  return (status == HAL_OK) ? len : -1;
}

/* USER CODE END 4 */

/**
  * @brief  Period elapsed callback in non blocking mode
  * @note   This function is called  when TIM6 interrupt took place, inside
  * HAL_TIM_IRQHandler(). It makes a direct call to HAL_IncTick() to increment
  * a global variable "uwTick" used as application time base.
  * @param  htim : TIM handle
  * @retval None
  */
void HAL_TIM_PeriodElapsedCallback(TIM_HandleTypeDef *htim)
{
  if (htim->Instance == TIM6)
  {
    HAL_IncTick();
  }
  /* USER CODE BEGIN Callback 1 */
  else if (htim->Instance == TIM7)
  {
    beeper_isr_toggle();   /* 1600 Hz -> 800 Hz na PH9 */
  }
  /* USER CODE END Callback 1 */
}

/**
  * @brief  This function is executed in case of error occurrence.
  * @retval None
  */
void Error_Handler(void)
{
  /* USER CODE BEGIN Error_Handler_Debug */
  /* User can add his own implementation to report the HAL error return state */
  __disable_irq();
  bootled_fail();   /* donekonecna blika LED_1 (PG3) - pocet bliknuti = posledni bootled_step() */
  /* USER CODE END Error_Handler_Debug */
}
#ifdef USE_FULL_ASSERT
/**
  * @brief  Reports the name of the source file and the source line number
  *         where the assert_param error has occurred.
  * @param  file: pointer to the source file name
  * @param  line: assert_param error line source number
  * @retval None
  */
void assert_failed(uint8_t *file, uint32_t line)
{
  /* USER CODE BEGIN 6 */
  /* User can add his own implementation to report the file name and line number,
     ex: printf("Wrong parameters value: file %s on line %d\r\n", file, line) */
  /* USER CODE END 6 */
}
#endif /* USE_FULL_ASSERT */
