ok2haz/Frequency_Counter_FPGA/Frequency_Counter_STM32H757/CM7/Core/Inc/sensor_stat.h

/*
 * sensor_stat.h
 *
 * Sdílený stav senzorů (3× TMP117 + 4× ADS1115 + 3× ADC3 interní = 10): poslední
 * hodnota + platnost + statistika (min/max/avg) + čítače chyb. Slouží displeji,
 * UART výpisu i budoucí matematice/statistice/logu.
 *
 * Čistý C header (jen <stdint.h>), BEZ RTOS/HAL závislostí — smí ho includovat
 * jak firmware (Core/Src), tak decoupled app/ vrstva (UI).
 *
 * Zápis: VÝHRADNĚ SensorsTask (freertos_task_sensors.c) přes sensor_update()
 * (platný vzorek) / sensor_fail() (chyba čtení). Čtení: kdokoli. ⚠️ Výjimka:
 * sensor_stat_reset_all() smí volat i jiný task (UART/UI) — viz komentář u ní.
 *
 * ⚠️ Sdílení bez zámku (jako ostatní g_* stavy). Hodnoty se mění ~1×/s; případné
 * roztržené čtení vícebajtové položky je pro monitor/diagnostiku akceptovatelné.
 * Přesná matematika nad vzorky by měla běžet uvnitř SensorsTask.
 */
#ifndef INC_SENSOR_STAT_H_
#define INC_SENSOR_STAT_H_

#include <stdint.h>

/* Index senzoru v g_sensors[]. Pořadí = pořadí čtení v SensorsTask. */
typedef enum {
    SENS_T48 = 0,   /* TMP117 0x48 (displej, I2C4)   [°C] */
    SENS_T49,       /* TMP117 0x49 (FPGA, I2C1)      [°C] */
    SENS_T4A,       /* TMP117 0x4A (FPGA, I2C1)      [°C] */
    SENS_ADS0,      /* ADS1115 AIN0                  [mV] */
    SENS_ADS1,      /* ADS1115 AIN1                  [mV] */
    SENS_ADS2,      /* ADS1115 AIN2 = 12V větev      [mV] */
    SENS_ADS3,      /* ADS1115 AIN3 = 5V větev       [mV] */
    SENS_CORE_T,    /* MCU teplota jádra (ADC3 TEMPSENSOR)       [°C] */
    SENS_VDDA,      /* VREF+ z ADC3 VREFINT (= VREFBUF ~2,5 V, NE VDDA;
                       enum název SENS_VDDA ponechán kvůli stabilitě indexů; label "VREF") [mV] */
    SENS_VBAT,      /* VBAT (ADC3, vnitřní dělič /4)             [mV] */
    SENS_COUNT
} sensor_id_t;

/* Stav + statistika jednoho skalárního senzoru. Jednotka dle sensor_id_t. */
typedef struct {
    float    last;        /* poslední hodnota; při chybě DRŽÍ poslední dobrou */
    float    min;         /* minimum z platných vzorků */
    float    max;         /* maximum z platných vzorků */
    float    mean;        /* aritmetický průměr (running) z platných vzorků */
    uint32_t samples;     /* počet platných vzorků od resetu (0 = ještě žádný) */
    uint32_t err_total;   /* celkový počet chyb čtení od bootu */
    uint32_t err_last_ms; /* HAL_GetTick() v okamžiku poslední chyby (0 = žádná) → "uptime od poslední" */
    uint16_t err_streak;  /* po sobě jdoucí chyby (0 = poslední čtení OK) */
    uint8_t  valid;       /* 1 = poslední čtení bylo platné */
    uint8_t  _pad;
} sensor_stat_t;

extern sensor_stat_t g_sensors[SENS_COUNT];

/* Popisná metadata senzoru (název + jednotka) — JEDNO místo pravdy pro UART výpis
 * i UI/diagnostiku (dřív duplicitní pole v každém konzumentovi). Index = sensor_id_t.
 * Definováno ve freertos.c. */
typedef struct {
    const char *label;   /* název, např. "TMP117 0x48" */
    const char *unit;    /* jednotka, "C" / "mV" */
} sensor_desc_t;

extern const sensor_desc_t g_sensor_desc[SENS_COUNT];

/* Zaznamená PLATNÝ vzorek: last=value, aktualizuje min/max/mean/samples,
 * valid=1, err_streak=0. Min/max/mean se lazy-inicializují prvním vzorkem. */
void sensor_update(sensor_id_t id, float value);

/* Zaznamená CHYBU čtení: valid=0, err_total++, err_streak++. 'last' zůstává
 * (poslední dobrá hodnota) → matematika/log mají ignorovat podle valid. */
void sensor_fail(sensor_id_t id);

/* Restartuje statistiku VŠECH senzorů od aktuální hodnoty: min=max=mean=last,
 * samples=1. `last`, `valid` a `err_*` zůstávají (aktuální hodnota a chybová
 * historie nejsou totéž co měřená statistika).
 * ⚠️ `samples` se ZÁMĚRNĚ nenuluje — zbytek kódu ho čte jako „má senzor vůbec
 * hodnotu?" (datalog by zapsal INVALID16, UI by ukázalo „---"); detaily
 * v implementaci. Senzor, který ještě nikdy nic nepřečetl, se přeskočí.
 * Smí volat i UartTask/UiTask (UART `sensors reset` / tlačítko v okně Senzory),
 * ne jen SensorsTask — `sensor_stat_t` už dnes toleruje netrhané čtení bez
 * zámku (viz výše), takže benigní rasa s právě probíhajícím `sensor_update()`
 * je přijatelná stejně jako jinde v téhle struktuře. */
void sensor_stat_reset_all(void);

#endif /* INC_SENSOR_STAT_H_ */
