ok2haz/Frequency_Counter_FPGA/Frequency_Counter_STM32H757/CM7/app/app_gpsdo.c

/**
 * @file app_gpsdo.c
 * @brief Glue: init libprim+HAL, drive the main and diagnostics screens, and
 *        route touch to the MENU / back buttons. Single-context (UiTask).
 */

#include "app_gpsdo.h"
#include "anim.h"                /* anim_t/anim_reset/anim_set/anim_step — sdileno se screen_main.c */
#include "screens/screen_main.h"
#include "hal/stm32/prim_stm32_hal.h"
#include "sensor_stat.h"        /* g_sensors[] (hodnota + valid + statistika) */
#include "fx_flags.h"           /* g_fx_enabled + FX_* — graficke efekty (OCXO budik, holdover kuzel, spektrogram) */
#include "gps.h"                /* gps_get() — zive GPS data do GNSS okna */
#include "w25q.h"               /* w25q_read_jedec — externi flash v okne PAMET */
#include "w25q_map.h"           /* W25Q_DATA_BASE/SIZE — okno Datalog */
#include "datalog.h"            /* datalog_get_status/set_enabled — okno Datalog */
#include "sd_export.h"          /* stav SD + g_sd_req — okno SD karta (s_view=37) */
#include "membench.h"           /* benchmark pameti + g_membench_req — okno PAMETI (s_view=43) */
#include "sensor_hist.h"        /* sensor_hist_series — RAM historie pro okno Grafy (#31) */
#include "ipc_shared.h"         /* IPC_VERSION — detekce nesouladu bank v System Health (v6).
                                 * Cisty sdileny header (jen stdint, zadny HAL), stejny na obou jadrech. */
#include "alarm.h"              /* g_alarm_* pocitadla — okno Alarmy */
#include "fpga_freq.h"          /* fpga_freq_get_last/format_val — okno Citac */
#include "calib.h"              /* g_calib, calib_load/save — okno Kalibrace */
#include "meas_math.h"          /* g_meas_cfg + Math/limity (#43/#44) — okno MATH */
#include "meas_present.h"       /* perioda/jednotky/nominal/statistika/TFOM (#67) — okno MERENI */
#include "setup.h"              /* uloz/nacti sestavu — okno SESTAVY (s_view=33) */
#include "autocal.h"            /* autokalibrace / self-check — tlacitko AUTO-CAL v Kalibraci */
#include "syscfg.h"             /* syscfg_load — nastaveni z W25Q flash (prezije power-cycle) */
#include "cmsis_os2.h"          /* osThreadGetStackSpace (volny stack tasku) */
#include "FreeRTOS.h"           /* taskENTER_CRITICAL — atomicka publikace g_survey_* (S2) */
#include "task.h"
#include <prim/prim.h>
#include <ui/ui.h>
#include <stdio.h>
#include <string.h>
#include <math.h>    /* sinf/cosf — sky plot druzic (GPS okno) */
#include "version.h" /* FW_VERSION_FULL — okno "O pristroji" + splash (== UART) */

/* Firmware sensor globals (defined in freertos.c). */
extern volatile char    g_spi_text[64];          /* FPGA SPI status line */
extern volatile uint8_t g_spi_ok;                /* 1 = link alive */
extern volatile char    g_freq_info[64];         /* FPGA quality: gate/PH/SEQ line */
extern volatile uint8_t g_si5356_status;         /* reg 218: SYS_CAL/LOS_CLKIN/PLL_LOL */
extern volatile uint8_t g_si5356_ok;             /* 1 = status read OK */
extern volatile uint32_t g_rtos_heap_free;       /* free heap [B] */
extern volatile uint32_t g_rtos_heap_min;        /* min-ever-free heap [B] */
extern volatile uint32_t g_rtos_cpu_pct;         /* CPU load [%] */
extern volatile uint32_t g_uptime_s;             /* uptime [s] */
extern volatile char     g_rtc_text[24];         /* "YYYY-MM-DD HH:MM:SS" (RTC z LSE, sync z GPS) — UTC */
extern volatile char     g_rtc_text_local[24];   /* totez v lokalni zone (screensaver, okno Cas) */
extern volatile char     g_tz_label[8];          /* "UTC"/"UTC+2"/"CET"/"CEST" (pise rtc_app_tick) */
/* Sitova konfigurace (okno Sit, s_view=35) — persist v syscfg blobu. */
extern volatile uint8_t  g_net_dhcp;
extern volatile uint32_t g_net_ip, g_net_mask, g_net_gw;
extern volatile int8_t   g_tz_offset_h;          /* casova zona -12..+14 h (okno Cas) */
extern volatile uint8_t  g_tz_auto;              /* 1 = AUTO CET/CEST (EU pravidlo) */
int rtc_cest_active(uint16_t y, uint8_t month, uint8_t day, uint8_t hour_utc); /* rtc.h (cista fce) */
extern volatile uint8_t  g_rtc_synced;           /* 1 = RTC srovnan z GPS */
extern volatile uint8_t  g_brightness;           /* jas displeje 0-255 (okno Nastaveni) */
extern volatile uint8_t  g_sound_muted;          /* 1 = zvuk vypnut */
extern volatile uint8_t  g_autodim_en;           /* 1 = auto-dim po necinnosti */
extern volatile uint16_t g_autodim_sec;          /* prodleva auto-dim [s] (preset 15..600) */
extern volatile uint8_t  g_theme_idx;            /* schema 0..4 = tmave/svetle/stredni/obrys/kontrast (UI_THEME_*) */
extern volatile uint8_t  g_lang_en;              /* 0 = cesky, 1 = english (texty postupne) */
/* g_anim_enabled je deklarovan v anim.h (sdileno se screen_main.c). */
extern volatile uint8_t  g_sys_cfg_dirty;        /* 1 = zmena jas/mute/dim -> persist do BKP */
/* Ulozeny vysledek self-survey (persist syscfg flash; survey_stop plni). */
extern volatile uint8_t  g_survey_valid;
extern volatile uint32_t g_survey_n;
extern volatile double   g_survey_lat, g_survey_lon;
extern volatile float    g_survey_alt, g_survey_spread;
extern volatile char     g_reset_text[12];       /* pricina posledniho resetu (main.c) */
extern volatile uint8_t  g_reset_bad;            /* 1 = watchdog reset (cervene) */
extern volatile char     g_crash_text[16];       /* crash black-box z BKP ("stack:UiTask") */
extern volatile uint8_t  g_selftest_res;         /* boot selftest: 0=--- 1=PASS 2=FAIL */
extern volatile uint8_t  g_selftest_detail[13];  /* per-test vysledky (poradi viz freertos_shared.h; drz = SELFTEST_N=13) */
extern volatile uint8_t  g_freq_stale;           /* 1 = ztrata signalu / mrtvy link (okno Citac) */
extern volatile uint8_t  g_cm4_absent;           /* 1 = CM4 (D2) nenabehl pri bootu */
extern volatile uint8_t  g_cm4_alive;            /* 1 = CM4 heartbeat ziva (IPC) */
extern volatile uint8_t  g_cm4_net_up;           /* 1 = ETH link UP (z CM4, IPC v5, F1) -> Health "NET:" */
extern volatile uint8_t  g_cm4_eth_ok;           /* 1 = HAL_ETH_Init na CM4 proslo (IPC v6, F3) */
extern volatile uint32_t g_cm4_phy_id;           /* PHY ID z CM4 pres MDIO (0x0007C131 = LAN8742A) */
extern volatile uint8_t  g_cm4_ipc_ver;          /* IPC_VERSION obrazu CM4; != IPC_VERSION = nesoulad bank */
extern volatile uint8_t  g_web_ctrl_en;          /* 1 = vzdalene OVLADANI povoleno (W0) */
extern volatile char     g_web_user[16];
extern volatile char     g_web_pass[20];
int run_selftests(void);                         /* pure-logic testy — okno Selftest (SPUSTIT) */

/* FreeRTOS task handles (defined in freertos.c) — pro volny stack v System Health. */
extern osThreadId_t UiTaskHandle, FpgaTaskHandle, UartTaskHandle,
                    I2C4TaskHandle, defaultTaskHandle;

/* Linker symboly (adresy) pro vyuziti interni FLASH/RAM v okne PAMET. */
extern uint32_t _sidata, _sdata, _edata, _sbss, _ebss;

/* Si5356 status bits (reg 218 / 0xDA) — bitova mapa OVERENA z AN565 (drivejsi
 * bit2=LOS_CLKIN byla chyba). bit2 = LOS_XTAL: krystalovy vstup XA/XB je na
 * teto desce uzemneny (bez krystalu, 10 MHz jde do CLKIN pin 4) -> bit2 je
 * TRVALE 1 a IGNORUJE se. bit3 = skutecny LOS_CLKIN. ⚠️ PLL_LOL se pri
 * fyzicke ztrate vstupu NEasertuje (AN565: LOL = rozdil >5000 ppm na PFD)
 * -> ztratu 10 MHz reference hlasi prave LOS_CLKIN (bit3) = cervena. */
#define SI5356_SYS_CAL    (1u << 0)
#define SI5356_LOS_XTAL   (1u << 2)   /* bez krystalu trvale 1 — nehodnotit */
#define SI5356_LOS_CLKIN  (1u << 3)   /* ztrata 10 MHz na CLKIN (pin 4) */
#define SI5356_PLL_LOL    (1u << 4)

static prim_fb_t s_fb;
static int s_inited = 0;
static int s_view = 0;          /* 0=main 1=diag 2=gps ... 23=allan — plny seznam oken v CLAUDE.md */

/* Present coalescing: vysokofrekvencni ticky (clock/signal/freq) jen renderuji a
 * nastavi s_dirty; jeden flip pak udela app_gpsdo_flush() (UiTask ho vola na ~30Hz
 * gate). Snizi pocet VBR flipu + sjednoti copy-forward. Vzacne udalosti (touch,
 * prepnuti obrazovky, render/clear) prezentuji hned pres present_now(). */
static int s_dirty = 0;
static void present_now(void) { prim_stm32_present(); s_dirty = 0; }

/* Forward decl — goto_view/nav i touch je potrebuji pred definici nize. */
static void app_gpsdo_render_anim(void);       /* Animace/prepinace (s_view=24) */
static void app_gpsdo_render_animdemo(void);   /* Prehled vsech animaci ve smycce (s_view=25) */

/* ── Flash tlacitka/pilulky pri stisku (2px accent OBRYS pres prvek) ──────────
 * `rad` = zaobleni dle prvku (UI_DIM_BUTTON_RADIUS tlacitko / UI_DIM_PILL_RADIUS
 * pilulka). Obrys NEzakryva text — kresli se PRES uz vykresleny prvek (popisek
 * zustava), takze netreba label ani re-render obsahu. Neblokuje: nakresli + flipne,
 * akce volajiciho hned potom prekresli + flipne. Diky double-buffered vsync flipu
 * (present_now ceka na dokonceni PREDCHOZIHO) se obrys zobrazi 1 frame (~17 ms =
 * page-flip floor, mene fyzicky nejde).
 * ⚠️ VOLA SE JEN u in-place prvku, ktere po stisku ZUSTANOU (anim/cas/trend
 * toggly; RUN/GATE/CHAN maji vlastni flash). U NAVIGACNICH tlacitek/pilulek se
 * ZAMERNE nevola — tam by ten 1 frame navic jen zdrzoval prepnuti okna (2026-07-22,
 * odezva = sama zmena obrazovky). Obrys jde mimo dirty-rect copy-forward -> volat
 * jen pred akci, ktera dotceny rect prekresli. Gate g_anim_enabled. */
static void tap_flash_r(prim_rect_t r, int16_t rad)
{
    if (!g_anim_enabled || r.w <= 6 || r.h <= 6) return;
    prim_set_target(&s_fb);
    prim_reset_clip();
    prim_stroke_rect_rounded(r, rad, 2, UI_COLOR_ACC);
    present_now();
}
static inline void tap_flash(prim_rect_t r)      { tap_flash_r(r, UI_DIM_BUTTON_RADIUS); }
static inline void tap_flash_pill(prim_rect_t r) { tap_flash_r(r, UI_DIM_PILL_RADIUS); }

/* ── Spolecny prolog okna (TODO #12/A1) ──────────────────────────────────────
 * `app_gpsdo_init(); prim_set_target(&s_fb); prim_reset_clip();` byl doslova
 * zkopirovany v 24 render funkcich (radove dalsich ~70 radku) — kazda kopie
 * byla dalsi misto, kde se mohl rozejit init/target/clip. window_prep() to
 * sjednocuje; window_first(N) navic vyresi "je tohle prvni vstup do okna N?"
 * (zmena s_view) pro oken s live-redraw dispatchem (app_gpsdo_tick). Poradi
 * `s_view = N;` vuci prep() NEZALEZI (nezavisle stavy) — volajici ho muze
 * priradit pred i za window_prep()/window_first(), podle toho, co je citelnejsi. */
static void window_prep(void)
{
    app_gpsdo_init();
    prim_set_target(&s_fb);
    prim_reset_clip();
}
static int window_first(uint8_t view_id)
{
    window_prep();
    return (s_view != (int)view_id);
}

/* Back button on the diagnostics screen. */
/* Back button lives in the bottom bar, in the same slot as the main MENU. */
static const prim_rect_t BACK_RECT = {650, 417, 133, 61};
/* System Health footer = 4 tlacitka (2026-07-31 pridano GRAFY, #31): rozlozeni
 * SENZORY / DIAGNOSTIKA / NASTAVENI / GRAFY, sirky nestejne (DIAGNOSTIKA nejdelsi
 * label -> nejsirsi), vse pred BACK_RECT (x=650). */
static const prim_rect_t SENS_BTN_RECT = {18, 417, 140, 61};
static const prim_rect_t HEALTH_DIAG_BTN_RECT = {166, 417, 176, 61};
/* "GRAFY" tlacitko v System Health -> okno Grafy (casovy prubeh senzoru, s_view=29). */
static const prim_rect_t HEALTH_GRAPH_BTN_RECT = {498, 417, 138, 61};
/* SESTERSKA okna analyzy stability: ALLAN (s_view=23, log-log graf) <-> HISTOGRAM
 * (s_view=6, rozdeleni) <-> SPEKTROGRAM Δf (s_view=26). Prepina SDILENA ZALOZKA
 * (VIEW_TABS, segmented v patce vlevo) BEZ nav_push -> BACK z libovolneho vede
 * tam, odkud byla trojice otevrena (tap na Allan nahled na hl. obrazovce = main).
 * Patka: [zalozky vlevo] [ovladac konkretniho pohledu stred] [ZPET vpravo]. */
static const prim_rect_t VIEW_TABS_RECT = {18, 417, 300, 61};    /* zalozky ALLAN/HIST/SPEKTR */
static const char *const VIEW_TAB_LABELS[3] = {"ALLAN", "HIST", "SPEKTR"};
static const prim_rect_t LOGY_RECT       = {330, 417, 180, 61};  /* histogram: lin/log Y (footer stred) */
static const prim_rect_t ALLAN_METRIC_RECT = {330, 417, 300, 61}; /* allan: prepinac ADEV/TDEV/MTIE (footer stred) */
/* 5 segmentu v 300 px = 60 px/segment = 7,0 mm — presne na projektovem minimu
 * dotykoveho cile (UI_SIZES.md). Uz se nesmi pridat sesty. */
static const char *const ALLAN_METRIC_SEG[5] = {"ADEV", "MDEV", "HDEV", "TDEV", "MTIE"};

/* Sdilena zalozka (segmented) — vybrany = aktivni pohled (0=ALLAN 1=HIST 2=SPEKTR). */
static void view_tabs_render(int active)
{
    ui_segmented_t sc = {.rect = VIEW_TABS_RECT, .labels = VIEW_TAB_LABELS,
                         .n = 3, .selected = (uint8_t)active};
    ui_segmented_render(&sc);
}
/* Trend okno: RELATIVNI +/- casove okno (presety 10/20/30/60/120 s), hodnota mezi. */
static const prim_rect_t TREND_MINUS = {18, 417, 90, 61};
static const prim_rect_t TREND_PLUS  = {214, 417, 90, 61};
/* Presety casoveho okna trendu. ⚠️ int32_t (NE int16_t) — 60 dni = 5 184 000 s
 * by v int16 preteklo. Dlouha okna kresli decimacni pyramida (screen_main.c
 * trend_feed): krok se automaticky prizpusobi, u 30 d je ~18 h/vzorek. */
static const int32_t TREND_PRESETS[] = {
    60,                 /* 1 min  */
    600,                /* 10 min */
    3600,               /* 1 h    */
    21600,              /* 6 h    */
    86400,              /* 1 den  */
    604800,             /* 7 dni  */
    2592000,            /* 30 dni */
    5184000,            /* 60 dni */
};
#define TREND_PRESET_N ((int)(sizeof(TREND_PRESETS)/sizeof(TREND_PRESETS[0])))
static const prim_rect_t HIST_PLOT_RECT  = {26, 96, 540, 300};
static const prim_rect_t HIST_TABLE_RECT = {582, 100, 180, 292};
/* "NASTAVENI" tlacitko v System Health (footer, viz SENS_BTN_RECT skupina). */
static const prim_rect_t SET_BTN_RECT = {350, 417, 140, 61};
/* Footer Diagnostiky (hub pro technicka podokna): DIAGRAM | PAMET | SELFTEST.
 * Vse konci pred BACK_RECT (x=650) — footer pravidlo y>=416 patri tlacitkum. */
static const prim_rect_t DIAG_DIAGRAM_BTN_RECT = {18, 417, 160, 61};
static const prim_rect_t DIAG_MEM_BTN_RECT     = {190, 417, 150, 61};
static const prim_rect_t DIAG_ST_BTN_RECT      = {352, 417, 160, 61};
/* Ovladace v okne Nastaveni (2 sloupce jako diag): levy = Zvuk / Jas / Auto-dim,
 * pravy = Vzhled (schema) / Jazyk (+ rezerva na dalsi polozky).
 * ⚠️ TODO #11(1b) HOTOVO 2026-07-19: 56 px (6,6 mm) -> 64 px (7,5 mm, nad
 * doporucenym minimem 7 mm). MUTE/THEME/LANG mely v kartach dost rezervy
 * (button koncil 16-24 px pred spodnim okrajem karty) -> zmena JEN vysky
 * bez zasahu do karet c1/c4/c5. Jas (c2) a Auto-dim (c3) mely rezervu jen
 * 10-12 px -> karty c2/c3 se zvetsily o 8 px kazda (viz app_gpsdo_render_settings),
 * cerpano ze 42 px volneho prostoru pred paticnkou (bylo 368->410 px). */
static const prim_rect_t MUTE_RECT   = {230, 354, 148, 64};   /* Zvuk zap/vyp — v okne ALARMY */
static const prim_rect_t BR_MINUS    = {30, 112, 72, 64};     /* Jas - (y 188->112, layout 2026-08-15) */
static const prim_rect_t BR_PLUS     = {110, 112, 72, 64};    /* Jas + */
static const prim_rect_t ADEN_RECT   = {30, 232, 140, 64};    /* Auto-dim zap/vyp (y 308->232) */
static const prim_rect_t DIM_MINUS   = {182, 232, 64, 64};    /* prodleva - (56->64 px: 6,6 -> 7,5 mm, UI_SIZES 2026-08-15) */
static const prim_rect_t DIM_PLUS    = {310, 232, 64, 64};    /* prodleva + */
/* ── Prava polovina okna Nastaveni = MRIZKA 2x5 (2026-08-13) ────────────────
 * Nastaveni se stalo rozcestnikem: Menu se vyprazdnilo na placeholdery a vsechno,
 * co je konfigurace (Cas, Alarmy, Kalibrace, Animace, Sit), se presunulo sem.
 * Leva polovina zustava primym ovladanim (zvuk / jas / auto-dim).
 * Geometrie: x=410/600 (w=182, mezera 8), y=72/140/208/276/344 (h=62, mezera 6);
 * posledni rada konci na 406, footer zacina 417. Dotykovy cil 62 px = 7,3 mm,
 * tesne nad projektovym minimem 7 mm (viz UI_SIZES.md). */
/* ⚠️ 2026-08-13 (2. iterace): Nastaveni je CISTY ROZCESTNIK — vsechny primé
 * ovladace se odstehovaly do tematickych podoken:
 *   - jas + auto-dim -> nove okno DISPLEJ (s_view=36),
 *   - zvuk (mute)    -> okno ALARMY (patri k tomu, co umlcuje).
 * Diky tomu je mrizka 3x4 pres CELOU sirku okna a ma stejnou geometrii jako
 * Menu (w=246, h=76, x=18/278/538, y=68/154/240/326) — jednotny vzhled obou
 * rozcestniku a dotykovy cil 76 px = 8,9 mm. */
#define SETNAV_W   246
#define SETNAV_H   76
#define SETNAV_XA   18
#define SETNAV_XB  278
#define SETNAV_XC  538
/* ⚠️ 2026-08-13: `Vzhled` se presunul do okna DISPLEJ (je to vlastnost displeje,
 * ne obecne nastaveni) — mrizka se proto o jednu bunku PRESKLADALA, aby v ni
 * nezustala díra uprostred. Volne jsou ted posledni dve bunky vpravo dole. */
static const prim_rect_t DISPNAV_RECT = {SETNAV_XA,  68, SETNAV_W, SETNAV_H};  /* -> Displej (36) */
static const prim_rect_t LANG_RECT    = {SETNAV_XB,  68, SETNAV_W, SETNAV_H};  /* Jazyk (prepinac) */
static const prim_rect_t ALRMNAV_RECT = {SETNAV_XC,  68, SETNAV_W, SETNAV_H};  /* -> Alarmy (18) */
static const prim_rect_t CASNAV_RECT  = {SETNAV_XA, 154, SETNAV_W, SETNAV_H};  /* -> Cas (22) */
static const prim_rect_t NET_RECT     = {SETNAV_XB, 154, SETNAV_W, SETNAV_H};  /* -> Sit (35) */
static const prim_rect_t KALIBNAV_RECT= {SETNAV_XC, 154, SETNAV_W, SETNAV_H};  /* -> Kalibrace (15) */
static const prim_rect_t ANIMNAV_RECT = {SETNAV_XB, 240, SETNAV_W, SETNAV_H};  /* -> Animace (24) */
/* Vzhled (prepinac) — uz NENI v Nastaveni, zije v okne DISPLEJ (prava karta).
 * ⚠️ Souradnice natvrdo: `DG_RX` (= DG_MX 18 + DG_COLW 376 + DG_GAP 12 = 406) je
 * definovane az nize v souboru, takze se tu na nej odkazat neda. 406 + 14 = 420. */
static const prim_rect_t THEME_RECT   = {420, 112, 200, 64};   /* Vzhled (y 190->112) */
/* Rozlozeni hlavni obrazovky — pravy sloupec okna DISPLEJ, symetricky pod
 * kartou Vzhled (stejne y jako Auto-dim vlevo). */
static const prim_rect_t LAYOUT_RECT  = {420, 230, 240, 64};
/* Okno Cas (s_view=22, dlazdice v Menu): rezim AUTO CET/CEST vs rucni posun.
 * TODO #11(1b) HOTOVO: 56->64 px, vsude dost rezervy (viz komentare u volajicich). */
static const prim_rect_t TZ_AUTO_RECT = {30, 236, 200, 64};   /* AUTO <-> RUCNI */
static const prim_rect_t TZ_MINUS     = {30, 310, 72, 64};    /* rucni posun - */
static const prim_rect_t TZ_PLUS      = {250, 310, 72, 64};   /* rucni posun + */
static const prim_rect_t REF_RECT    = {SETNAV_XA, 240, SETNAV_W, SETNAV_H};  /* -> Reference (14) */
static const prim_rect_t ABOUT_RECT  = {SETNAV_XA, 326, SETNAV_W, SETNAV_H};  /* -> O pristroji (10) */
static const prim_rect_t SETUP_ENTER_RECT = {SETNAV_XC, 240, SETNAV_W, SETNAV_H}; /* -> SESTAVY (33) */
static const prim_rect_t SDNAV_RECT  = {SETNAV_XC, 326, SETNAV_W, SETNAV_H};  /* -> SD karta (37) */
static const prim_rect_t MEMBNAV_RECT= {SETNAV_XB, 326, SETNAV_W, SETNAV_H};  /* -> Pameti/benchmark (43) */
/* Okno SESTAVY (s_view=33): vyber slotu (-/+) + ULOZIT/NACIST/SMAZAT ve footeru. */
static const prim_rect_t SET_SLOT_MINUS = {40, 116, 64, 64};
static const prim_rect_t SET_SLOT_PLUS  = {214, 116, 64, 64};
static const prim_rect_t SETUP_SAVE_RECT  = {18,  417, 150, 61};
static const prim_rect_t SETUP_LOAD_RECT  = {176, 417, 150, 61};
static const prim_rect_t SETUP_ERASE_RECT = {334, 417, 150, 61};

static bool in_rect(int16_t x, int16_t y, prim_rect_t r)
{
    return x >= r.x && x < r.x + r.w && y >= r.y && y < r.y + r.h;
}

/* ── Navigacni zasobnik (BACK se vraci k tomu, odkud okno OTEVRENO) ──────────
 * Pri kazdem forward prechodu se pushne aktualni s_view; BACK popne a vykresli.
 * Umoznuje "z okna oteviraneho z Menu -> BACK zpet do Menu" i vnoreni
 * (Menu->Nastaveni->O pristroji). app_gpsdo_render_main resetuje (koren). */
static uint8_t s_nav_stack[6];
static int     s_nav_sp = 0;
static void nav_push(uint8_t from) { if (s_nav_sp < 6) s_nav_stack[s_nav_sp++] = from; }
static void app_gpsdo_render_net(void);      /* Sit / ETH (s_view=35) */
static void app_gpsdo_render_access(void);   /* Pristup: jmeno/heslo (s_view=42) */
static void app_gpsdo_render_display(void);  /* Displej: jas + auto-dim (s_view=36) */
static void app_gpsdo_render_sd(void);       /* SD karta (s_view=37) */
static void app_gpsdo_render_membench(void); /* Pameti / benchmark (s_view=43) */
static void app_gpsdo_render_kalib(void);    /* Kalibrace (s_view=15) — spawnuje pruvodce */
static void app_gpsdo_render_alarms(void);   /* Alarmy (s_view=18) — spawnuje okno PRAHY */
static void goto_view(uint8_t v)
{
    switch (v) {
    case 1:  app_gpsdo_render_diag();     break;   /* Diagnostika (spawnuje Komunikaci) */
    /* ⚠️ `case 2` DOPLNEN 2026-08-17. `nav_push(2)` se pouzival uz driv (GPS ->
     * SURVEY), ale goto_view ho neznal -> spadlo to do `default` a ZPET ze
     * Self-survey vedlo na HLAVNI OBRAZOVKU misto zpatky do GPS okna. Stejnou
     * chybu by zdedilo nove okno KVALITA GPS (38). */
    case 2:  app_gpsdo_render_gps();      break;   /* GPS (spawnuje survey + kvalitu) */
    case 3:  app_gpsdo_render_health();   break;   /* Health (spawnuje senzory/pamet/nastaveni) */
    case 7:  app_gpsdo_render_settings(); break;   /* Nastaveni (spawnuje O pristroji) */
    case 12: app_gpsdo_render_menu();     break;   /* Menu rozcestnik */
    case 15: app_gpsdo_render_kalib();    break;   /* Kalibrace (spawnuje pruvodce) */
    case 18: app_gpsdo_render_alarms();   break;   /* Alarmy (spawnuje okno PRAHY) */
    case 24: app_gpsdo_render_anim();     break;   /* Animace (spawnuje subokno prikladu) */
    case 35: app_gpsdo_render_net();      break;   /* Sit (dnes bez podoken, pro symetrii) */
    case 42: app_gpsdo_render_access();   break;   /* Pristup (z okna Sit) */
    case 36: app_gpsdo_render_display();  break;   /* Displej */
    case 37: app_gpsdo_render_sd();       break;   /* SD karta */
    case 43: app_gpsdo_render_membench(); break;   /* Pameti / benchmark */
    default: app_gpsdo_render_main();     break;   /* koren */
    }
}
static void nav_back(void)
{
    uint8_t v = (s_nav_sp > 0) ? s_nav_stack[--s_nav_sp] : 0;
    goto_view(v);
}

void app_gpsdo_init(void)
{
    if (s_inited) return;
    /* Nastaveni z W25Q flash (prezije power-cycle) PRED tematem/renderem — pri
     * studenem startu (BKP smazana) je flash autoritativni pro jas/schema/zonu/... */
    syscfg_load();
    ui_theme_select(g_theme_idx);   /* ulozene schema PRED prvnim renderem */
    prim_stm32_init(&s_fb);
    screen_main_init();
    calib_load();   /* W25Q CALIB store -> g_calib (blokujici, ~ms; prazdno = vychozi hodnoty) */
    setup_init();   /* W25Q SETUP store -> ulozene sestavy (okno SESTAVY) */
    /* Rekonstrukce dlouhych tau z datalogu — jen se NAPLANUJE, samotne cteni
     * bezi po davkach z tick_stats_sample (blokujici QSPI nesmi do initu, ktery
     * drzi prvni render obrazovky). */
    app_gpsdo_stats_seed_start();
    s_inited = 1;
}

void app_gpsdo_render_main(void)
{
    window_prep();
    s_view = 0;
    s_nav_sp = 0;    /* hlavni obrazovka = koren navigace */
    screen_main_render();
    present_now();          /* flip hotovy snimek na displej (tearing-free) */
}

/* ── Diagnostics screen ─────────────────────────────────────── */

/* Rozklad float na (cele, des) bez %f (nano.specs), decimals 1..3. Ciste
 * cislo — sjednocuje aritmetiku ctyr drivejsich temer identickych kopii
 * (fmt_temp, fmt_d1, fmt_fN, fmt_minmax), viz TODO #12/A2. Vraci JEN cisla
 * (ne string): fmt_minmax kombinuje DVA vysledky do jednoho snprintf, stejne
 * jako puvodne — samostatny mezikrok "naformatuj do bufferu, pak %s%s slep"
 * by kaskadovite roztahl GCC -Wformat-truncation worst-case pres vic bufferu
 * (overeno pri prvnim pokusu: rostouci buf[24]->32 si vyzadalo i key[26]...). */
static void fixed_split(float v, int decimals, int32_t *whole, int32_t *frac)
{
    int32_t scale = 1;
    for (int i = 0; i < decimals; i++) scale *= 10;
    int32_t t = (int32_t)(v * (float)scale + (v >= 0.0f ? 0.5f : -0.5f));
    *whole = t / scale;
    *frac  = t % scale; if (*frac < 0) *frac = -*frac;
}

/* Jedna hodnota -> "cele.des" (decimals 1..3). ZADNA jednotka/sentinel navic
 * — to resi volajici (fmt_temp pridava " C", fmt_d1 ma "--" sentinel).
 * ⚠️ sgn: pro v v (-1;0) je cela cast 0 a %ld minus nevytiskne — bez explicitni
 * predpony by "-0.5" vyslo jako "0.5" (ZTRATA ZNAMENKA; pre-existujici chyba
 * vsech ctyr puvodnich fmt_* kopii, nalezena revizi 2026-07-19 — realne
 * zasahne zaporne teploty -0.99..-0.01 °C). */
static void fmt_fixed(char *buf, size_t n, float v, int decimals)
{
    int32_t w, f;
    fixed_split(v, decimals, &w, &f);
    const char *sgn = (v < 0.0f && w == 0 && f != 0) ? "-" : "";
    switch (decimals) {
    case 1: snprintf(buf, n, "%s%ld.%01ld", sgn, (long)w, (long)f); break;
    case 2: snprintf(buf, n, "%s%ld.%02ld", sgn, (long)w, (long)f); break;
    case 3: snprintf(buf, n, "%s%ld.%03ld", sgn, (long)w, (long)f); break;
    default: snprintf(buf, n, "%ld", (long)w); break;
    }
}

/* Teplota "23.45 C" (2 des. + jednotka). */
static void fmt_temp(char *buf, size_t n, float v)
{
    char num[16];
    fmt_fixed(num, sizeof num, v, 2);
    snprintf(buf, n, "%s C", num);
}

/* ── Dvousloupcový layout diagnostiky ──────────────────────────────────── */
#define DG_MX    18                              /* outer margin */
#define DG_GAP   12                              /* column gap */
#define DG_COLW  376                             /* column width */
#define DG_LX    DG_MX                           /* left column x */
#define DG_RX    (DG_MX + DG_COLW + DG_GAP)      /* right column x */
#define DG_LLBL  (DG_LX + 12)                    /* left col label x */
#define DG_RLBL  (DG_RX + 12)                    /* right col label x */
#define DG_LVAL  (DG_LX + DG_COLW - 14)          /* left col value right edge */
#define DG_RVAL  (DG_RX + DG_COLW - 14)          /* right col value right edge */

/* TODO #12/A4 (castecne): celoplosna karta jednoho okna existovala v 5 ruznych
 * variantach geometrie (y 58 vs 62, h 200..346) — spodni hrana kolisala 13-55 px
 * pred paticnkou bez zjevneho duvodu. Tyhle dve konstanty pojmenovavaji dve
 * SKUTECNE pouzivane (identicke) varianty (5+5 oken), aby se aspon nerozchazely
 * NAHODOU pri budouci uprave jednoho z nich. ⚠️ Zbyle vyjimky (About, Kalibrace,
 * Citac/Cas, Komunikace) maji vlastni obsah ruzne vysoky — sjednotit i je na
 * jednu spolecnou vysku by chtelo overit polohu radku v kazdem z nich zvlast
 * (riziko prekryvu); ponechano jako samostatny TODO. */
static const prim_rect_t DG_CARD_FULL_A = {DG_LX, 58, 764, 346};  /* Senzory/Pamet/Histogram/Allan/Trend */
static const prim_rect_t DG_CARD_FULL_B = {DG_LX, 62, 764, 300};  /* Reference/Datalog/Alarmy/Survey/Sestavy/SD */
/* Vysoka varianta: konci 407, tj. 10 px nad footerem (417) — pro okna s hodne
 * obsahem (Selftest, Holdover). Zadani z HW pruchodu 2026-08-15. */
static const prim_rect_t DG_CARD_FULL_TALL = {DG_LX, 62, 764, 345};
/* TODO #12/A4 dokonceno 2026-07-19: Citac + Cas mely stejnou geometrii, jen
 * duplikovanou (ne zamerne odlisnou jako zbyle vyjimky). O pristroji (2 karty
 * 200+130), Kalibrace (348) a Komunikace (320) zustavaji SAMOSTATNE — kazda
 * pouzita jen jednou, pojmenovani konstanty by tam nebylo DRY, jen navic
 * neduvod uvrstva (viz zasada "no premature abstraction"). Timhle je A4
 * uzavrena — vic skutecne duplicitni geometrie v souboru neni. */
static const prim_rect_t DG_CARD_FULL_C = {DG_LX, 62, 764, 340};  /* Citac/Cas */

/* GPS okno ma NEsymetricke sloupce: levy (Druzice: sky/bar prepinatelne dotykem)
 * je siroky, pravy (cas/poloha/timepulse/prijimac) zmenseny ~1/3. */
#define GPS_LX    DG_MX                           /* 18 */
#define GPS_LW    502                             /* levy sloupec (Druzice) — siroky */
#define GPS_LLBL  (GPS_LX + 12)                   /* 30 */
#define GPS_RX    532                             /* pravy sloupec x (right-aligned na 782) */
#define GPS_RW    250                             /* pravy sloupec sirka (~2/3 z 376) */
/* Tlacitko SURVEY (footer pravy sloupec, pred BACK@650) -> okno Self-survey (s_view=32). */
static const prim_rect_t GPS_SURVEY_BTN = {532, 417, 112, 61};
/* ⚠️ Vstup do okna KVALITA GPS je TAP NA KARTU "Prijimac", ne footer tlacitko.
 * Duvod (chyba z prvni verze, 2026-08-17): footer tohoto okna je obsazeny —
 * karta Druzice je ZAMERNA vyjimka roztazena az po spodni okraj (x 18..520,
 * y 160..478, viz komentar u jejiho renderu), takze cela leva polovina radku
 * y=417 je karta; v pravem sloupci uz sedi SURVEY (532..644) a ZPET (650..783).
 * Tlacitko umistene do {330,417,...} leželo CELE uvnitr karty Druzice a bargraf
 * ho pri kazdem obnoveni (2x/s) prekreslil -> na displeji nebylo videt.
 * Tap na kartu je navic zavedeny idiom teto codebase (Allan, trend, prepinac
 * bar/sky na teze obrazovce) vcetne ztlumeneho '↗' v headeru. */
static const prim_rect_t GPS_QUAL_RECT  = {GPS_RX, 330, GPS_RW, 74};   /* karta Prijimac */
#define GPS_RLBL  (GPS_RX + 12)                   /* 544 */

/* GPS okno: karta Druzice — prepinani zobrazeni (bargraf <-> sky plot) dotykem.
 * Roztazena az po spodni okraj (160..478). */
static const prim_rect_t GPS_SAT_RECT = {GPS_LX, 160, GPS_LW, 318};
static bool s_gps_polar = false;   /* false = bargraf C/N0 (default), true = polarni sky plot */

/* A static label drawn once into the chrome (left, sans). */
/* Popisek (menu) řádku diagnostiky: STEJNÝ font jako živá hodnota (mono_18),
 * odlišený jen barvou — tlumená (INK_3) vs světlá hodnota (INK). */
static void dlabel(int16_t x, int16_t y, const char *s)
{
    prim_draw_text((prim_point_t){x, y}, s, &ui_font_mono_18, UI_COLOR_INK_3,
                   PRIM_ALIGN_LEFT);
}

/* ── Box-cisteny zivy text (TODO #12/A3) ─────────────────────────────────────
 * dval/dtext/dtext_c byly tri skoro identicke funkce lisici se jen zarovnanim
 * — a navic se rozchazely v geometrii boxu (dval `baseline-17`, ostatni dve
 * `baseline-16` — 1px nesrovnalost, objevena pri teto revizi). dtext_a je
 * spolecny zaklad (LEFT/CENTER/RIGHT), sjednoceny na `baseline-16`; dtext/
 * dtext_c jsou uz jen tenke obalky (volajici beze zmeny), dval zustava
 * vlastni specializovanou funkci (fixni font mono_18, barva dle `valid`,
 * "!" znacka pro neplatna data) postavenou nad stejnym zakladem. */
typedef enum { DTEXT_LEFT, DTEXT_CENTER, DTEXT_RIGHT } dtext_align_t;

static void dtext_a(int16_t pos, int16_t baseline, int16_t boxw, const char *v,
                    prim_color_t col, const prim_font_t *font, dtext_align_t align)
{
    int16_t box_x = (align == DTEXT_LEFT)   ? pos
                   : (align == DTEXT_CENTER) ? (int16_t)(pos - boxw / 2)
                   :                           (int16_t)(pos - boxw);
    prim_rect_t box = {box_x, (int16_t)(baseline - 16), boxw, 22};
    prim_fill_rect(box, UI_COLOR_BG_CARD, PRIM_BLEND_REPLACE);
    prim_set_clip(box);
    prim_align_t palign = (align == DTEXT_LEFT)   ? PRIM_ALIGN_LEFT
                         : (align == DTEXT_CENTER) ? PRIM_ALIGN_CENTER
                         :                            PRIM_ALIGN_RIGHT;
    prim_draw_text((prim_point_t){pos, baseline}, v, font, col, palign);
    prim_reset_clip();
}

/* Right-aligned live value: clear its box then redraw. valid==0 → dimmed + red "!". */
static void dval(int16_t xr, int16_t baseline, int16_t boxw, const char *v, int valid)
{
    dtext_a(xr, baseline, boxw, v, valid ? UI_COLOR_INK : UI_COLOR_INK_3,
           &ui_font_mono_18, DTEXT_RIGHT);
    if (!valid)
        prim_draw_text((prim_point_t){(int16_t)(xr - boxw + 2), baseline}, "!",
                       &ui_font_mono_18, UI_COLOR_BAD, PRIM_ALIGN_LEFT);
}

/* Left-aligned live text in a cleared box (status lines, colorized).
 * Text se OŘÍZNE na šířku boxu -> dlouhý řetězec (SPI stav, velké SEQ/CRC)
 * nepřeteče kartu. */
static void dtext(int16_t x, int16_t baseline, int16_t boxw, const char *v,
                  prim_color_t col, const prim_font_t *font)
{ dtext_a(x, baseline, boxw, v, col, font, DTEXT_LEFT); }

/* Center-aligned live text in a cleared box (GPS okno). */
static void dtext_c(int16_t cx, int16_t baseline, int16_t boxw, const char *v,
                    prim_color_t col, const prim_font_t *font)
{ dtext_a(cx, baseline, boxw, v, col, font, DTEXT_CENTER); }

/* Jako dtext(), ale clear/clip box se pocita ze SKUTECNYCH metrik fontu
 * (ascent/descent), ne z napevno danych 22 px v dtext_a. dtext_a je ladena pro
 * mono_14/16/18 (ascent<=18) a pouziva se na desitkach mist -> nemenit globalne.
 * Pro vyssi fonty (mono_20/25, okno PRISTUP) ale ten napevny box orizne HORNI
 * cast glyfu (mono_25 ma ascent 26 -> orizne se 10 px z 26, tedy pres tretinu
 * znaku) -> pismena splynou/zmizi a heslo na displeji vypada kratsi nebo jinak,
 * nez skutecne je (nahlaseno 2026-08-23: opsane heslo z displeje nesedelo). */
static void dtext_tall(int16_t x, int16_t baseline, int16_t boxw, const char *v,
                       prim_color_t col, const prim_font_t *font)
{
    prim_rect_t box = {x, (int16_t)(baseline - font->ascent), boxw,
                       (int16_t)(font->ascent + font->descent)};
    prim_fill_rect(box, UI_COLOR_BG_CARD, PRIM_BLEND_REPLACE);
    prim_set_clip(box);
    prim_draw_text((prim_point_t){x, baseline}, v, font, col, PRIM_ALIGN_LEFT);
    prim_reset_clip();
}

/* ── Spolecna hlavicka okna: pozadi + BACK + nadpis ─────────────────────────
 * Tenhle blok byl doslova zkopirovany v 19 render funkcich — kazda kopie byla
 * dalsi misto, kde se mohly rozejit souradnice (viz historie oprav layoutu
 * 2026-07-18). Volajici pak uz jen dokresli sve karty/tlacitka.
 * title_y: WIN_TITLE_Y (38) pro vetsinu oken; okno Nastaveni ma hustsi layout
 * a nadpis o 4 px vys (WIN_TITLE_Y_TIGHT) — proto je to parametr, ne konstanta. */
#define WIN_TITLE_Y        38
#define WIN_TITLE_Y_TIGHT  34
static void window_chrome(const char *title, int16_t title_y)
{
    prim_blit((prim_rect_t){0, 0, UI_DIM_SCREEN_W, UI_DIM_SCREEN_H},
              screen_main_bg(), UI_DIM_SCREEN_W * (int16_t)sizeof(prim_pixel_t));
    ui_button_t back = {.rect = BACK_RECT, .variant = UI_BUTTON_NORMAL, .label = "< ZPET"};
    ui_button_render(&back);
    prim_draw_text((prim_point_t){UI_DIM_SCREEN_W / 2, title_y}, title,
                   &ui_font_mono_25, UI_COLOR_ACC, PRIM_ALIGN_CENTER);
}

/* GPS souradnice -> "dd.ddddddH" (bez float v printf, integer extrakce). */
static void fmt_ll(float v, char pos, char neg, char *out, size_t n)
{
    char h = (v >= 0.0f) ? pos : neg;
    if (v < 0.0f) v = -v;
    long ud = (long)(v * 1000000.0f + 0.5f);
    snprintf(out, n, "%ld.%06ld%c", ud / 1000000, ud % 1000000, h);
}

/* float DOP/1-desetinne -> "1.7" (bez %f); "--" pro neplatne (<=0). Obracene
 * poradi argumentu (v,out,n) oproti fmt_fixed(buf,n,v,decimals) — puvodni
 * volani v draw_gps_values zustavaji beze zmeny. */
static void fmt_d1(float v, char *out, size_t n)
{
    if (v <= 0.0f) { snprintf(out, n, "--"); return; }
    fmt_fixed(out, n, v, 1);
}

/* Round a float reading to long without pulling in <math.h>. */
static long lround_f(float v) { return (long)(v >= 0.0f ? v + 0.5f : v - 0.5f); }

/* anim_t/anim_reset/anim_set/anim_step jsou v anim.h (sdileno se screen_main.c). */

/* Maidenhead lokator (10 znaku, 5 paru: field/square/subsquare/ext/ext2),
 * napr. "JN89NS85KN". Vstup = zem. sirka/delka [°]. Pary 3+5 velkymi pismeny. */
static void fmt_locator(float lat, float lon, char *out, size_t n)
{
    double lo = (double)lon + 180.0;   /* 0..360 */
    double la = (double)lat + 90.0;    /* 0..180 */
    if (lo < 0) lo = 0; else if (lo >= 360) lo = 359.999999;
    if (la < 0) la = 0; else if (la >= 180) la = 179.999999;
    char b[11];
    b[0] = (char)('A' + (int)(lo / 20.0));  b[1] = (char)('A' + (int)(la / 10.0));
    lo = fmod(lo, 20.0);  la = fmod(la, 10.0);
    b[2] = (char)('0' + (int)(lo / 2.0));   b[3] = (char)('0' + (int)(la / 1.0));
    lo = fmod(lo, 2.0);   la = fmod(la, 1.0);
    b[4] = (char)('A' + (int)(lo / (2.0 / 24.0)));  b[5] = (char)('A' + (int)(la / (1.0 / 24.0)));
    lo = fmod(lo, 2.0 / 24.0);   la = fmod(la, 1.0 / 24.0);
    b[6] = (char)('0' + (int)(lo / (2.0 / 240.0))); b[7] = (char)('0' + (int)(la / (1.0 / 240.0)));
    lo = fmod(lo, 2.0 / 240.0);  la = fmod(la, 1.0 / 240.0);
    b[8] = (char)('A' + (int)(lo / (2.0 / 5760.0)));b[9] = (char)('A' + (int)(la / (1.0 / 5760.0)));
    b[10] = '\0';
    snprintf(out, n, "%s", b);
}

/* Selftest cistych app helperu (Maidenhead lokator — nova, snadno chybova logika).
 * Bez sdileneho stavu -> bezpecne za behu; soucast UART "selftest"/boot selftestu. */
bool app_gpsdo_selftest(void)
{
    char loc[16]; int ok = 1;
    fmt_locator(49.52f, 17.55f, loc, sizeof loc);   /* interni bod -> field/square/subsquare */
    ok &= (strncmp(loc, "JN89SM", 6) == 0);
    fmt_locator(0.0f, 0.0f, loc, sizeof loc);        /* rovnik + nulty poledník -> pole "JJ" */
    ok &= (loc[0] == 'J' && loc[1] == 'J');
    printf("app: fmt_locator selftest %s (%s)\n", ok ? "OK" : "FAIL", loc);
    return ok != 0;
}

/* Compact "min/max" with 1 decimal from a sensor's stats. */
static void fmt_minmax(char *buf, size_t n, const sensor_stat_t *s)
{
    if (s->samples == 0) { snprintf(buf, n, "--/--"); return; }
    /* clamp na realny rozsah senzoru (teploty ±125.0) pred fmt_fixed — samo
     * o sobe by na tomto rozsahu nepretekly, klamp jen drzi vystup rozumny
     * pri necekane hodnote (senzor error apod). Puvodne se klampoval az
     * zaokrouhleny int (×10, hranice 9999 = 999.9); ekvivalentni na floatu. */
    float lo = s->min, hi = s->max;
    if (lo > 999.9f) lo = 999.9f; else if (lo < -999.9f) lo = -999.9f;
    if (hi > 999.9f) hi = 999.9f; else if (hi < -999.9f) hi = -999.9f;
    int32_t lw, lf, hw, hf;
    fixed_split(lo, 1, &lw, &lf);
    fixed_split(hi, 1, &hw, &hf);
    /* Klamp na VYSTUPU fixed_split (i kdyz uz vstupni float je klampnuty vyse):
     * GCC -Wformat-truncation nedokaze protahnout rozsahovou analyzu pres
     * float aritmetiku uvnitr fixed_split, takze bez tohohle vidi lw/hw jako
     * "cely int32" -> az 26 B do buf[24]. S explicitnim klampem primo na
     * hodnotach predanych do snprintf uz rozsah spocita (shoduje se s tim,
     * jak to delal puvodni kod pred timto sjednocenim). */
    if (lw > 999) lw = 999; else if (lw < -999) lw = -999;
    if (hw > 999) hw = 999; else if (hw < -999) hw = -999;
    /* sgn: stejna oprava ztraty znamenka u -0.x jako ve fmt_fixed (viz tam). */
    const char *ls = (lo < 0.0f && lw == 0 && lf != 0) ? "-" : "";
    const char *hs = (hi < 0.0f && hw == 0 && hf != 0) ? "-" : "";
    snprintf(buf, n, "%s%d.%d/%s%d.%d", ls, (int)lw, (int)lf, hs, (int)hw, (int)hf);
}

/* Change-detect: vrati 1 (a aktualizuje cache) kdyz se 'now' lisi od 'cache'. */
static int dchg(char *cache, size_t n, const char *now)
{
    if (strncmp(cache, now, n) == 0) return 0;
    strncpy(cache, now, n - 1);
    cache[n - 1] = '\0';
    return 1;
}

/* Redraw dynamic values. force=1 -> prekresli VSE (po blitu chrome jsou hodnoty
 * smazane); force=0 (tick) -> jen pole, ktera se ZMENILA -> usetri DMA2D fill +
 * cache invalidaci + CPU text u nemennych poli (vetsina). */
/* Vrati 1 pokud se NECO prekreslilo (-> volajici flipne present), jinak 0. */
static int draw_diag_values(int force)
{
    static char c_tv[4][20], c_tm[4][20], c_adc[4][20], c_mcu[2][20];
    static char c_spi[68], c_fpga[68], c_si[20], c_sys[5][20];
    char buf[24], key[26];
    int drew = force;   /* force -> vse se kresli */

    /* ── Levy sloupec: teploty (hodnota + min/max), poradi = labely v chrome:
     * STM board (0x48) / MCU jadro (ADC3) / OCXO (0x49) / FPGA board (0x4A).
     * ⚠️ Radkovy layout: label (DG_LLBL, sirka do ~140 px — nejdelsi "FPGA board"
     * ma 110 px @ mono_18) | min/max (DG_LLBL+140, 100 px) | hodnota (DG_LVAL,
     * 100 px). Puvodni min/max box zacinal na DG_LLBL+96=126 px — to je UVNITR
     * label "FPGA board"/"STM board"/"MCU jadro" (koncí ~129-140 px), takze
     * kazdy zivy prekres min/max SMAZAL (fill_rect pred textem) kus labelu ->
     * neciteny/uriznuty text. Posunuto + zuzeno tak, aby zadny box nezasahoval
     * do sousedniho textu (min. 20 px rezerva na obe strany). */
    static const sensor_id_t tid[4] = { SENS_T48, SENS_CORE_T, SENS_T49, SENS_T4A };
    static const int16_t     ty[4]  = { 104, 130, 156, 182 };
    for (int i = 0; i < 4; i++) {
        const sensor_stat_t *s = &g_sensors[tid[i]];
        fmt_minmax(buf, sizeof(buf), s);
        if (force || dchg(c_tm[i], sizeof(c_tm[i]), buf)) {
            dtext((int16_t)(DG_LLBL + 140), ty[i], 100, buf, UI_COLOR_INK_3, &ui_font_sans_18); drew = 1; }
        fmt_temp(buf, sizeof(buf), s->last);
        snprintf(key, sizeof(key), "%c%s", s->valid ? 'V' : 'X', buf);  /* vykresleni zalezi i na valid */
        if (force || dchg(c_tv[i], sizeof(c_tv[i]), key)) {
            dval(DG_LVAL, ty[i], 100, buf, s->valid); drew = 1; }
    }

    /* Napeti: ADS1115 AIN0..3 (258/284/310/336) + MCU VREF/VBAT (362/388). Roztec 26.
     * Box zuzen na 100 px (bylo 120) — realny obsah "1234 mV" ~88 px @ mono_18,
     * 120 px byla zbytecna rezerva ("blok siresi nez text uvnitr"). */
    for (int k = 0; k < 4; k++) {
        const sensor_stat_t *a = &g_sensors[SENS_ADS0 + k];
        snprintf(buf, sizeof(buf), "%ld mV", lround_f(a->last));
        snprintf(key, sizeof(key), "%c%s", a->valid ? 'V' : 'X', buf);
        if (force || dchg(c_adc[k], sizeof(c_adc[k]), key)) {
            dval(DG_LVAL, (int16_t)(258 + k * 26), 100, buf, a->valid); drew = 1; }
    }
    for (int k = 0; k < 2; k++) {
        const sensor_stat_t *mv = &g_sensors[SENS_VDDA + k];
        snprintf(buf, sizeof(buf), "%ld mV", lround_f(mv->last));
        snprintf(key, sizeof(key), "%c%s", mv->valid ? 'V' : 'X', buf);
        if (force || dchg(c_mcu[k], sizeof(c_mcu[k]), key)) {
            dval(DG_LVAL, (int16_t)(362 + k * 26), 100, buf, mv->valid); drew = 1; }
    }

    /* ── Pravy sloupec ── */
    /* FPGA: SPI status (barva dle g_spi_ok -> klic vc. ok) + merici kvalita. */
    char sig[68];
    snprintf(sig, sizeof(sig), "%c%s", g_spi_ok ? 'O' : 'X', (const char *)g_spi_text);
    if (force || dchg(c_spi, sizeof(c_spi), sig)) {
        /* mono_14 ZAMERNE (jediny 14px text v oknech): NOLINK radek ma az 38 zn
         * (38x10=380 px @16 > box 352 -> orizl by se RX0/CRC ocas; @14 = 304 px OK). */
        dtext(DG_RLBL, 104, DG_COLW - 24, (const char *)g_spi_text,
              g_spi_ok ? UI_COLOR_OK : UI_COLOR_BAD, &ui_font_mono_14); drew = 1; }
    /* ⚠️ TODO #11(2b): NEbumpovano — absolutni worst-case (vsechny chybove
     * priznaky + max SEQ/gate soucasne) uz na mono_16 preteka box 352 px,
     * na mono_18 jeste vic (overeno tabulkou fontu); realny obsah je kratsi,
     * ale bez jistoty to radsi nechat na soucasnem fontu. */
    if (force || dchg(c_fpga, sizeof(c_fpga), (const char *)g_freq_info)) {
        dtext(DG_RLBL, 132, DG_COLW - 24, (const char *)g_freq_info, UI_COLOR_INK_2, &ui_font_sans_16); drew = 1; }

    /* Reference Si5356: lock status (retezec 1:1 se statusem -> staci porovnat si).
     * LOS_CLKIN (bit3) = ztrata 10 MHz reference = CERVENA (LOL se pri fyzicke
     * ztrate vstupu neasertuje — viz SI5356_* definice). LOS_XTAL ignorovan. */
    const char *si; prim_color_t sic;
    if (!g_si5356_ok)                                   { si = "N/A (I2C)";   sic = UI_COLOR_INK_3; }
    else if (g_si5356_status & SI5356_LOS_CLKIN)        { si = "LOS CLKIN!";  sic = UI_COLOR_BAD; }
    else if (g_si5356_status & SI5356_PLL_LOL)          { si = "PLL UNLOCK!"; sic = UI_COLOR_BAD; }
    else if (g_si5356_status & SI5356_SYS_CAL)          { si = "CALIB...";    sic = UI_COLOR_VIOLET; }
    else                                                { si = "LOCK OK";     sic = UI_COLOR_OK; }
    if (force || dchg(c_si, sizeof(c_si), si)) {
        dtext(DG_RLBL, 206, DG_COLW - 24, si, sic, &ui_font_mono_18); drew = 1; }

    /* System / RTOS / RTC. Box zuzen na 110 px (bylo 150) — heap je max 32768 B
     * (configTOTAL_HEAP_SIZE) = "32768 B" ~77 px @ mono_18, "23:59:59"/"100 %"
     * jeste kratsi; 110 px necha ~30 px rezervu vc. mista na "!" pri neplatne
     * hodnote, misto 73 px prazdneho bloku navic. */
    snprintf(buf, sizeof(buf), "%lu B", (unsigned long)g_rtos_heap_free);
    if (force || dchg(c_sys[0], sizeof(c_sys[0]), buf)) { dval(DG_RVAL, 288, 110, buf, 1); drew = 1; }
    snprintf(buf, sizeof(buf), "%lu B", (unsigned long)g_rtos_heap_min);
    if (force || dchg(c_sys[1], sizeof(c_sys[1]), buf)) { dval(DG_RVAL, 314, 110, buf, 1); drew = 1; }
    snprintf(buf, sizeof(buf), "%lu %%", (unsigned long)g_rtos_cpu_pct);
    if (force || dchg(c_sys[2], sizeof(c_sys[2]), buf)) { dval(DG_RVAL, 340, 110, buf, 1); drew = 1; }
    { uint32_t s = g_uptime_s;
      snprintf(buf, sizeof(buf), "%lu:%02lu:%02lu",
               (unsigned long)(s / 3600u), (unsigned long)((s / 60u) % 60u),
               (unsigned long)(s % 60u)); }
    if (force || dchg(c_sys[3], sizeof(c_sys[3]), buf)) { dval(DG_RVAL, 366, 110, buf, 1); drew = 1; }

    /* RTC: cas HH:MM:SS z g_rtc_text ("YYYY-MM-DD HH:MM:SS"). synced=0 -> ztlumeny
     * + "no GPS" (jeste nesrovnano z GPS). Klic vc. sync stavu (rozhoduje o barve). */
    { char rt[24]; uint8_t rsy;
      strncpy(rt, (const char *)g_rtc_text, sizeof rt - 1); rt[sizeof rt - 1] = '\0';
      rsy = g_rtc_synced;
      if (rsy && strlen(rt) >= 19) snprintf(buf, sizeof(buf), "%.8s", rt + 11);
      else                         snprintf(buf, sizeof(buf), "no GPS");
      snprintf(key, sizeof(key), "%c%s", rsy ? 'V' : 'X', buf);
      if (force || dchg(c_sys[4], sizeof(c_sys[4]), key)) { dval(DG_RVAL, 392, 110, buf, rsy); drew = 1; } }

    return drew;
}

void app_gpsdo_render_diag(void)
{
    int first = window_first(1);
    if (first) {
        /* First entry: draw the static chrome + labels exactly once. */
        s_view = 1;
        window_chrome("DIAGNOSTIKA", WIN_TITLE_Y);
        ui_button_t diagbtn = {.rect = DIAG_DIAGRAM_BTN_RECT, .variant = UI_BUTTON_NORMAL,
                               .label = "DIAGRAM"};
        ui_button_render(&diagbtn);
        ui_button_t membtn = {.rect = DIAG_MEM_BTN_RECT, .variant = UI_BUTTON_NORMAL,
                              .label = "PAMET"};
        ui_button_render(&membtn);
        ui_button_t stbtn = {.rect = DIAG_ST_BTN_RECT, .variant = UI_BUTTON_NORMAL,
                             .label = "SELFTEST"};
        ui_button_render(&stbtn);

        /* Left column: Teploty (vc. MCU jadra) + Napeti (ADS1115 + MCU).
         * ⚠️ FOOTER PRAVIDLO: spodni lista (y >= 416) je VZDY dedikovana
         * tlacitkum -> obsah konci <= 404. (Drivejsi 3. karta "MCU" sahala
         * do 472 = do listy; jeji radky jsou slouceny sem, roztec 26 px.) */
        ui_card_t c_temp = {.rect = {DG_LX, 58, DG_COLW, 144},
                            .header_label = "Teploty  (last  min/max)"};
        ui_card_render_chrome(&c_temp);
        dlabel(DG_LLBL, 104, "STM board");    /* TMP117 0x48 (I2C4) */
        dlabel(DG_LLBL, 130, "MCU jadro");    /* ADC3 interni senzor */
        dlabel(DG_LLBL, 156, "OCXO");         /* TMP117 0x49 (I2C1, FPGA deska) */
        dlabel(DG_LLBL, 182, "FPGA board");   /* TMP117 0x4A (I2C1, neosazen) */

        ui_card_t c_adc = {.rect = {DG_LX, 212, DG_COLW, 192},
                           .header_label = "Napeti (ADS1115 + MCU)"};
        ui_card_render_chrome(&c_adc);
        dlabel(DG_LLBL, 258, "OCXO_VC");      /* AIN0: ladici napeti OCXO */
        dlabel(DG_LLBL, 284, "RF_Level");     /* AIN1: uroven vstupniho signalu */
        dlabel(DG_LLBL, 310, "AIN2 (12V)");
        dlabel(DG_LLBL, 336, "AIN3 (5V)");
        dlabel(DG_LLBL, 362, "VREF");
        dlabel(DG_LLBL, 388, "VBAT");

        /* Right column: FPGA + Reference + System. */
        ui_card_t c_fpga = {.rect = {DG_RX, 58, DG_COLW, 92},
                            .header_label = "Komunikace + mereni FPGA"};
        ui_card_render_chrome(&c_fpga);

        ui_card_t c_ref = {.rect = {DG_RX, 160, DG_COLW, 72},
                           .header_label = "Reference Si5356 (4x100MHz)"};
        ui_card_render_chrome(&c_ref);

        ui_card_t c_sys = {.rect = {DG_RX, 242, DG_COLW, 162},
                           .header_label = "System / RTOS / RTC"};
        ui_card_render_chrome(&c_sys);
        dlabel(DG_RLBL, 288, "Heap free");
        dlabel(DG_RLBL, 314, "Heap min");
        dlabel(DG_RLBL, 340, "CPU");
        dlabel(DG_RLBL, 366, "Uptime");
        dlabel(DG_RLBL, 392, "RTC (UTC)");
    }
    /* present (flip) jen kdyz se neco prekreslilo (first=1 vzdy kresli chrome+vse). */
    if (draw_diag_values(first)) present_now();
}

/* Zive hodnoty GPS okna (s_view=2). force=1 po vykresleni chrome -> vse;
 * force=0 (tick) -> jen zmenena pole. Vrati 1 pokud se neco prekreslilo. */
static int draw_gps_values(int force)
{
    static char c_fix[16], c_sat[24], c_bars[64], c_dop[28], c_time[20], c_date[16];
    static char c_lat[24], c_lon[24], c_alt[20], c_tp[20], c_loc[24], c_rx[40];
    char buf[64], a[16], b[16];
    gps_data_t g;
    gps_get(&g);
    int drew = force;

    /* ── Radek 1 karty FIX (bez nadpisu): "FIX: 3D/2D/No signal" (velke, vlevo) +
     * Time Pulse (vpravo). Time Pulse: s fixem 100 kHz (GPSDO PLL ref, disc. na
     * GNSS), bez fixu 10 Hz (hold VC / holdover). ── */
    const char *fs; prim_color_t fc;
    if      (g.valid && g.fix_mode == 3) { fs = "FIX: 3D";        fc = UI_COLOR_OK; }
    else if (g.valid && g.fix_mode == 2) { fs = "FIX: 2D";        fc = UI_COLOR_OK; }
    else if (g.fix_quality > 0)          { fs = "FIX: OK";        fc = UI_COLOR_OK; }
    else                                 { fs = "FIX: No signal"; fc = UI_COLOR_INK_3; }
    if (force || dchg(c_fix, sizeof c_fix, fs)) {
        /* ⚠️ box MUSI zacinat nad baseline: mono_25 kresli 25 px NAHORU od 96,
         * tj. od 71 — puvodni box od 74 nechaval horni 3 px stareho textu
         * (audit 2026-08-15, stejna trida chyby jako u FORMAT varovani v SD okne). */
        prim_fill_rect((prim_rect_t){GPS_LLBL, 70, 288, 34}, UI_COLOR_BG_CARD, PRIM_BLEND_REPLACE);
        prim_draw_text((prim_point_t){GPS_LLBL, 96}, fs, &ui_font_mono_25, fc, PRIM_ALIGN_LEFT);
        drew = 1; }

    const char *tp; prim_color_t tc;
    if (g.fix_quality) { tp = "Time Pulse 100 kHz"; tc = UI_COLOR_OK; }
    else               { tp = "Time Pulse 10 Hz";   tc = UI_COLOR_WARN; }
    if (force || dchg(c_tp, sizeof c_tp, tp)) {
        prim_fill_rect((prim_rect_t){300, 74, (int16_t)(GPS_LX + GPS_LW - 14 - 300), 30},
                       UI_COLOR_BG_CARD, PRIM_BLEND_REPLACE);
        prim_draw_text((prim_point_t){(int16_t)(GPS_LX + GPS_LW - 14), 96}, tp,
                       &ui_font_mono_18, tc, PRIM_ALIGN_RIGHT); drew = 1; }

    /* ── Radek 2 karty FIX: pocet druzic (vlevo) + HDOP/PDOP (vpravo, presunuto sem) ── */
    snprintf(buf, sizeof buf, "%u / %u druzic", g.num_sat, g.sats_in_view);
    if (force || dchg(c_sat, sizeof c_sat, buf)) {
        dtext(GPS_LLBL, 134, 200, buf, UI_COLOR_INK_3, &ui_font_sans_18); drew = 1; }
    fmt_d1(g.hdop, a, sizeof a); fmt_d1(g.pdop, b, sizeof b);
    snprintf(buf, sizeof buf, "HDOP %s   PDOP %s", a, b);
    if (force || dchg(c_dop, sizeof c_dop, buf)) {
        prim_fill_rect((prim_rect_t){300, 118, (int16_t)(GPS_LX + GPS_LW - 14 - 300), 24},
                       UI_COLOR_BG_CARD, PRIM_BLEND_REPLACE);
        /* ⚠️ TODO #11(2b): NEbumpovano — box ~206 px, i kratsi "HDOP 9.9 PDOP 9.9"
         * uz na mono_18 preteka (overeno tabulkou fontu), box neni dtext-clipovany
         * (jen fill_rect clear) -> preteceni by bylo VIDITELNE, ne tiche. */
        prim_draw_text((prim_point_t){(int16_t)(GPS_LX + GPS_LW - 14), 134}, buf,
                       &ui_font_mono_16, UI_COLOR_INK_3, PRIM_ALIGN_RIGHT); drew = 1; }
    /* naznak prepinani zobrazeni druzic (staticky) vpravo v hlavicce karty Druzice */
    if (force)
        prim_draw_text((prim_point_t){(int16_t)(GPS_LX + GPS_LW - 14), 186},
                       "TAP: bar/sky", &ui_font_mono_14, UI_COLOR_INK_4, PRIM_ALIGN_RIGHT);

    /* Druzice: JEDNO zobrazeni na plnou sirku sloupce — bargraf C/N0 nebo polarni
     * sky plot (az/el), prepinatelne dotykem (s_gps_polar). Barva = C/N0. */
    {
        gps_sat_t sv[GPS_MAX_SATS];
        /* RINEX písmeno souhvězdí (gps_constel_t: GPS/GLONASS/Galileo/BeiDou) —
         * prefix PRN (G05/R68/E12/C07) odliší souhvězdí; barva zůstává = C/N0. */
        static const char k_constel_ltr[GPS_CONSTEL_N] = { 'G', 'R', 'E', 'C' };
        int nsv = g.sat_count;                        /* uint8_t 0..GPS_MAX_SATS -> vzdy >=0 */
        if (nsv > GPS_MAX_SATS) nsv = GPS_MAX_SATS;   /* pojistka proti pretekani sv[] */
        for (int i = 0; i < nsv; i++) sv[i] = g.sats[i];
        for (int i = 1; i < nsv; i++) {               /* insertion sort podle snr desc */
            gps_sat_t t = sv[i]; int j = i - 1;
            while (j >= 0 && sv[j].snr < t.snr) { sv[j + 1] = sv[j]; j--; }
            sv[j + 1] = t;
        }
        int n = nsv > 14 ? 14 : nsv;                  /* bary: az 14 (siroky sloupec) */
        /* zmenovy klic: mod + pocet + hash az/el/snr VSECH druzic (+ C/N0 baru) */
        uint32_t skyh = s_gps_polar ? 0xA5u : 0x5Au;
        for (int i = 0; i < nsv; i++)
            skyh = skyh * 31u + sv[i].prn + (uint32_t)(sv[i].azim / 4u) * 7u
                 + (uint32_t)(sv[i].elev / 4u) * 13u + (sv[i].snr / 8u)
                 + (uint32_t)sv[i].constel * 17u;
        char key[64]; int kp = snprintf(key, sizeof key, "%d_%08lx", n, (unsigned long)skyh);
        for (int i = 0; i < n && kp < (int)sizeof key - 5; i++)
            kp += snprintf(key + kp, sizeof key - kp, ".%u", sv[i].snr);
        if (force || dchg(c_bars, sizeof c_bars, key)) {
            /* clear cele plochy druzic (194..476) — karta jde az po spodni okraj */
            prim_fill_rect((prim_rect_t){GPS_LLBL, 194, GPS_LW - 24, 282},
                           UI_COLOR_BG_CARD, PRIM_BLEND_REPLACE);
            if (nsv == 0) {
                dtext_c((int16_t)(GPS_LX + GPS_LW / 2), 330, GPS_LW - 24,
                        "Hledam druzice...", UI_COLOR_WARN, &ui_font_sans_18);
            } else if (s_gps_polar) {
                /* ── Sky plot na plnou plochu: velky kruh r=132, stred=zenit, N nahore ── */
                const int16_t scx = (int16_t)(GPS_LX + GPS_LW / 2), scy = 332, sr = 132;
                /* prim_draw_circle (ne prim_draw_arc 0..360) — plny kruh nedela
                 * atan2f per-pixel (ring_sector); u r=132 to je ~70k atan2f/kruh. */
                prim_draw_circle((prim_point_t){scx, scy}, sr,                   1, UI_COLOR_LINE);
                prim_draw_circle((prim_point_t){scx, scy}, (int16_t)(sr * 2 / 3), 1, UI_COLOR_LINE);
                prim_draw_circle((prim_point_t){scx, scy}, (int16_t)(sr / 3),     1, UI_COLOR_LINE);
                prim_draw_line((prim_point_t){(int16_t)(scx - sr), scy},
                               (prim_point_t){(int16_t)(scx + sr), scy}, 1, UI_COLOR_LINE);
                prim_draw_line((prim_point_t){scx, (int16_t)(scy - sr)},
                               (prim_point_t){scx, (int16_t)(scy + sr)}, 1, UI_COLOR_LINE);
                prim_draw_text((prim_point_t){scx, (int16_t)(scy - sr + 15)}, "N",
                               &ui_font_mono_14, UI_COLOR_INK_3, PRIM_ALIGN_CENTER);
                prim_draw_text((prim_point_t){(int16_t)(scx + sr - 12), (int16_t)(scy + 5)}, "E",
                               &ui_font_mono_14, UI_COLOR_INK_4, PRIM_ALIGN_RIGHT);
                for (int i = 0; i < nsv; i++) {       /* tecky: azimut 0=N po smeru hodin */
                    float azr = (float)sv[i].azim * 0.0174533f;
                    float rr  = (float)sr * (float)(90 - (sv[i].elev > 90 ? 90 : sv[i].elev)) / 90.0f;
                    int16_t px = (int16_t)(scx + sinf(azr) * rr);
                    int16_t py = (int16_t)(scy - cosf(azr) * rr);
                    uint8_t snr = sv[i].snr;
                    prim_color_t col = (snr >= 38) ? UI_COLOR_OK :
                                       (snr >= 25) ? UI_COLOR_WARN :
                                       (snr > 0)   ? UI_COLOR_BAD : UI_COLOR_INK_4;
                    prim_fill_circle((prim_point_t){px, py}, (int16_t)(snr > 0 ? 6 : 3), col);
                    if (snr > 0) {                    /* PRN vedle tecky */
                        char pr[8]; snprintf(pr, sizeof pr, "%c%u",
                            (sv[i].constel < GPS_CONSTEL_N) ? k_constel_ltr[sv[i].constel] : '?', sv[i].prn);
                        prim_draw_text((prim_point_t){(int16_t)(px + 8), (int16_t)(py + 4)}, pr,
                                       &ui_font_mono_14, UI_COLOR_INK_3, PRIM_ALIGN_LEFT);
                    }
                }
            } else {
                /* ── C/N0 bargraf na plnou plochu (az 14 nejsilnejsich) ── */
                const int16_t base = 452;             /* dolni hrana sloupcu (u spodniho okraje) */
                const int16_t maxh = 238;             /* vyska pro C/N0 = 55 dB-Hz */
                const int16_t area = (int16_t)(GPS_LW - 24);
                int16_t slot = (int16_t)(area / n);
                int16_t bw = (int16_t)(slot * 2 / 3);
                if (bw < 3) bw = 3;
                for (int i = 0; i < n; i++) {
                    uint8_t snr = sv[i].snr;
                    prim_color_t col = (snr >= 38) ? UI_COLOR_OK :
                                       (snr >= 25) ? UI_COLOR_WARN :
                                       (snr > 0)   ? UI_COLOR_BAD : UI_COLOR_INK_4;
                    int16_t cx = (int16_t)(GPS_LLBL + i * slot + slot / 2);
                    int16_t h  = (int16_t)((snr > 55 ? 55 : snr) * maxh / 55);
                    if (h < 2) h = 2;
                    prim_fill_rect((prim_rect_t){(int16_t)(cx - bw / 2), (int16_t)(base - h),
                                   bw, h}, col, PRIM_BLEND_REPLACE);
                    if (snr > 0) {                    /* C/N0 nad sloupcem */
                        char sn[6]; snprintf(sn, sizeof sn, "%u", snr);
                        prim_draw_text((prim_point_t){cx, (int16_t)(base - h - 4)}, sn,
                                       &ui_font_mono_14, UI_COLOR_INK_3, PRIM_ALIGN_CENTER);
                    }
                    char pr[8]; snprintf(pr, sizeof pr, "%c%u",
                        (sv[i].constel < GPS_CONSTEL_N) ? k_constel_ltr[sv[i].constel] : '?', sv[i].prn);
                    prim_draw_text((prim_point_t){cx, 468}, pr, &ui_font_mono_14,
                                   UI_COLOR_INK_3, PRIM_ALIGN_CENTER);
                }
            }
            drew = 1;
        }
    }

    /* (HDOP/PDOP presunuty nahoru k FIX — radek 2 karty FIX.) */

    /* cas + datum z RTC (LSE, disciplinovany GPS). RTC tika i bez fixu -> karta
     * je vzdy zive; synced=0 (volny beh od bootu) ztlumime. g_rtc_text =
     * "YYYY-MM-DD HH:MM:SS" -> [0..9] datum, [11..18] cas. */
    char rt[24]; uint8_t rsy;
    strncpy(rt, (const char *)g_rtc_text, sizeof rt - 1); rt[sizeof rt - 1] = '\0';
    rsy = g_rtc_synced;
    snprintf(buf, sizeof buf, "%s UTC", (strlen(rt) >= 19) ? rt + 11 : "--:--:--");
    if (force || dchg(c_time, sizeof c_time, buf)) {
        dtext(GPS_RLBL, 104, GPS_RW - 24, buf, rsy ? UI_COLOR_INK : UI_COLOR_INK_3,
              &ui_font_mono_18); drew = 1; }
    snprintf(buf, sizeof buf, "%.10s", rt);   /* datum "YYYY-MM-DD" (sync stav nese barva casu) */
    if (force || dchg(c_date, sizeof c_date, buf)) {
        dtext(GPS_RLBL, 126, GPS_RW - 24, buf, UI_COLOR_INK_3, &ui_font_sans_18); drew = 1; }

    /* poloha */
    if (g.valid) fmt_ll(g.lat_deg, 'N', 'S', a, sizeof a); else snprintf(a, sizeof a, "--");
    snprintf(buf, sizeof buf, "Lat  %s", a);
    if (force || dchg(c_lat, sizeof c_lat, buf)) {
        dtext(GPS_RLBL, 190, GPS_RW - 24, buf, UI_COLOR_INK_3, &ui_font_mono_18); drew = 1; }
    if (g.valid) fmt_ll(g.lon_deg, 'E', 'W', a, sizeof a); else snprintf(a, sizeof a, "--");
    snprintf(buf, sizeof buf, "Lon  %s", a);
    if (force || dchg(c_lon, sizeof c_lon, buf)) {
        dtext(GPS_RLBL, 214, GPS_RW - 24, buf, UI_COLOR_INK_3, &ui_font_mono_18); drew = 1; }
    if (g.fix_quality) snprintf(buf, sizeof buf, "Alt  %ld m", lround_f(g.alt_m));
    else               snprintf(buf, sizeof buf, "Alt  --");
    if (force || dchg(c_alt, sizeof c_alt, buf)) {
        dtext(GPS_RLBL, 238, GPS_RW - 24, buf, UI_COLOR_INK_3, &ui_font_mono_18); drew = 1; }

    /* Lokator (Maidenhead grid) — karta bez nadpisu, jen "Locator <hodnota>"
     * (vetsim pismem, vycentrovano ve volne karte 252..320). */
    char loc[16];
    if (g.valid) fmt_locator(g.lat_deg, g.lon_deg, loc, sizeof loc);
    else         snprintf(loc, sizeof loc, "----------");
    snprintf(buf, sizeof buf, "Locator %s", loc);
    if (force || dchg(c_loc, sizeof c_loc, buf)) {
        dtext(GPS_RLBL, 294, GPS_RW - 24, buf, g.valid ? UI_COLOR_ACC : UI_COLOR_INK_3,
              &ui_font_mono_18); drew = 1; }

    /* Prijimac: zive statistiky linky (naparsovane vety + platne fixy) — rostou,
     * dokud GPS tece -> dukaz zivosti (staticke "NEO-7M" je v chrome). */
    snprintf(buf, sizeof buf, "Vet:%lu Fix:%lu",
             (unsigned long)g.sentences, (unsigned long)g.fixes);
    /* ⚠️ TODO #11(2b): NEbumpovano na mono_18 — pocitadla rostou bez limitu
     * (roky provozu), realny 7-8 mistny stav uz PRETEKA i pri soucasnem
     * mono_16 (226 px box, overeno tabulkou fontu) -> bump by to jen zhorsil. */
    if (force || dchg(c_rx, sizeof c_rx, buf)) {
        dtext(GPS_RLBL, 384, GPS_RW - 24, buf, UI_COLOR_INK_2, &ui_font_mono_16); drew = 1; }

    return drew;
}

/* GPS / GNSS okno (tap na GNSS pill, ZPET zpet na main). Zive (refresh ~2x/s
 * v app_gpsdo_tick). First entry kresli chrome, pak jen zmenena pole. */
void app_gpsdo_render_gps(void)
{
    int first = window_first(2);
    if (first) {
        s_view = 2;
        window_chrome("GNSS / GPS", WIN_TITLE_Y);

        /* Levy (siroky) sloupec: FIX (bez nadpisu — FIX/druzice/DOP/TimePulse jsou
         * uvnitr) + Druzice roztazena AZ PO SPODNI OKRAJ (vyjimka z footer pravidla —
         * BACK je vpravo, levy sloupec ho nekryje). */
        ui_card_t c_fix = {.rect = {GPS_LX, 58, GPS_LW, 96}};   /* bez header_label */
        ui_card_render_chrome(&c_fix);
        ui_card_t c_sat = {.rect = {GPS_LX, 160, GPS_LW, 318},   /* 160..478 = spodni okraj */
                           .header_label = "Druzice"};
        ui_card_render_chrome(&c_sat);
        /* Pravy (uzsi) sloupec: cas/poloha/lokator/prijimac. */
        ui_card_t c_time = {.rect = {GPS_RX, 58, GPS_RW, 76}, .header_label = "Cas / datum (UTC)"};
        ui_card_render_chrome(&c_time);
        ui_card_t c_pos = {.rect = {GPS_RX, 144, GPS_RW, 98}, .header_label = "Poloha"};
        ui_card_render_chrome(&c_pos);
        ui_card_t c_loc = {.rect = {GPS_RX, 252, GPS_RW, 68}};   /* Lokator — bez nadpisu */
        ui_card_render_chrome(&c_loc);
        ui_card_t c_rx = {.rect = GPS_QUAL_RECT,
                          .header_label = "Prijimac NEO-7M"};
        ui_card_render_chrome(&c_rx);
        /* Ztlumene '↗' hned za titulkem = naznak, ze karta je klikaci (tap -> okno
         * KVALITA GPS). Pozice se pocita STEJNE jako u Allan/trend karet na hlavni
         * obrazovce (sirka titulku z tabulky fontu + 6 px), aby to sedelo i kdyby
         * se popisek zmenil. */
        {   const char *rxt = "Prijimac NEO-7M";
            int16_t hx = (int16_t)(GPS_QUAL_RECT.x + UI_DIM_CARD_PAD_X
                                   + prim_text_width(rxt, &ui_font_sans_18) + 6);
            prim_draw_text((prim_point_t){hx, (int16_t)(GPS_QUAL_RECT.y + UI_DIM_CARD_PAD_Y + 16)},
                           "↗", &ui_font_sans_18, UI_COLOR_INK_4, PRIM_ALIGN_LEFT);
        }
        ui_button_t sv = {.rect = GPS_SURVEY_BTN, .variant = UI_BUTTON_NORMAL, .label = "SURVEY >"};
        ui_button_render(&sv);
    }
    if (draw_gps_values(first)) present_now();
}

/* ── System Health okno (s_view=3) ────────────────────────────────────────
 * Otevre se tapem na SYS pill (vedle GNSS). Hlubsi pohled nez diagnostika:
 * RTOS pamet+CPU, volny stack tasku (osThreadGetStackSpace), I2C chybovost
 * (z g_sensors err citacu), stav linku (FPGA/Si5356/senzory) a napajeci vetve.
 * Live refresh ~2x/s pres app_gpsdo_tick (stejny first/values split jako diag). */

/* Agreguje I2C chybovost ze skupiny senzoru: streak = max souvislych chyb,
 * total = soucet chyb od bootu. (Health = streak==0 -> ted OK.) */
static void i2c_health(const sensor_id_t *ids, int n, uint16_t *streak, uint32_t *total)
{
    uint16_t st = 0; uint32_t tot = 0;
    for (int i = 0; i < n; i++) {
        const sensor_stat_t *s = &g_sensors[ids[i]];
        if (s->err_streak > st) st = s->err_streak;
        tot += s->err_total;
    }
    *streak = st; *total = tot;
}

/* Prekresli dynamicke hodnoty System Health. force=1 -> vse (po blitu chrome),
 * force=0 (tick) -> jen zmenena pole. Vrati 1 pokud neco kreslil. */
static int draw_health_values(int force)
{
    static char c_rtos[3][20], c_stk[5][16], c_i2c[2][40], c_lnk[3][40];
    char buf[36], key[40];   /* "I2C1 FPGA: CHYBA (<u32>)" az 29 zn. -> bez truncation */
    int drew = force;

    /* ── Levy sloupec: RTOS pamet / CPU / uptime ── */
    snprintf(buf, sizeof(buf), "%lu B", (unsigned long)g_rtos_heap_free);
    if (force || dchg(c_rtos[0], sizeof(c_rtos[0]), buf)) { dval(DG_LVAL, 104, 150, buf, 1); drew = 1; }
    snprintf(buf, sizeof(buf), "%lu B", (unsigned long)g_rtos_heap_min);
    if (force || dchg(c_rtos[1], sizeof(c_rtos[1]), buf)) { dval(DG_LVAL, 132, 150, buf, 1); drew = 1; }
    snprintf(buf, sizeof(buf), "%lu %%", (unsigned long)g_rtos_cpu_pct);
    if (force || dchg(c_rtos[2], sizeof(c_rtos[2]), buf)) { dval(DG_LVAL, 160, 150, buf, 1); drew = 1; }
    /* Uptime presunut do karty "System" (pravy sloupec) — c_rtos[3] nevyuzito. */

    /* ── Levy sloupec: volny stack tasku (high-water headroom, bajty) ── */
    osThreadId_t thr[5] = { UiTaskHandle, FpgaTaskHandle, UartTaskHandle,
                            I2C4TaskHandle, defaultTaskHandle };
    static const int16_t sy[5] = { 264, 292, 320, 348, 376 };
    for (int i = 0; i < 5; i++) {
        uint32_t fb = thr[i] ? osThreadGetStackSpace(thr[i]) : 0;
        snprintf(buf, sizeof(buf), "%lu B", (unsigned long)fb);
        /* < 64 B headroom = varovani (cerveny '!'); jinak svetla hodnota. */
        if (force || dchg(c_stk[i], sizeof(c_stk[i]), buf)) {
            dval(DG_LVAL, sy[i], 120, buf, fb >= 64); drew = 1; }
    }

    /* ── Pravy sloupec: I2C chybovost (celobarevne radky) ── */
    static const sensor_id_t i2c1_ids[5] = { SENS_T49, SENS_ADS0, SENS_ADS1,
                                             SENS_ADS2, SENS_ADS3 };  /* T4A vynechan (neosazen) */
    static const sensor_id_t i2c4_ids[1] = { SENS_T48 };
    uint16_t s1, s4; uint32_t t1, t4;
    i2c_health(i2c1_ids, 5, &s1, &t1);
    i2c_health(i2c4_ids, 1, &s4, &t4);
    snprintf(buf, sizeof(buf), "I2C1 FPGA: %s (%lu)", s1 ? "CHYBA" : "OK", (unsigned long)t1);
    snprintf(key, sizeof(key), "%c%s", s1 ? 'X' : 'O', buf);
    if (force || dchg(c_i2c[0], sizeof(c_i2c[0]), key)) {
        dtext(DG_RLBL, 104, DG_COLW - 24, buf, s1 ? UI_COLOR_BAD : UI_COLOR_OK, &ui_font_mono_18); drew = 1; }
    snprintf(buf, sizeof(buf), "I2C4 panel: %s (%lu)", s4 ? "CHYBA" : "OK", (unsigned long)t4);
    snprintf(key, sizeof(key), "%c%s", s4 ? 'X' : 'O', buf);
    if (force || dchg(c_i2c[1], sizeof(c_i2c[1]), key)) {
        dtext(DG_RLBL, 132, DG_COLW - 24, buf, s4 ? UI_COLOR_BAD : UI_COLOR_OK, &ui_font_mono_18); drew = 1; }

    /* ── Pravy sloupec: periferie / linky ── */
    snprintf(buf, sizeof(buf), "FPGA SPI: %s", g_spi_ok ? "LINK OK" : "NO LINK");
    snprintf(key, sizeof(key), "%c%s", g_spi_ok ? 'O' : 'X', buf);
    if (force || dchg(c_lnk[0], sizeof(c_lnk[0]), key)) {
        dtext(DG_RLBL, 200, DG_COLW - 24, buf, g_spi_ok ? UI_COLOR_OK : UI_COLOR_BAD, &ui_font_mono_18); drew = 1; }
    const char *si; prim_color_t sic;
    if (!g_si5356_ok)                            { si = "N/A (I2C)";   sic = UI_COLOR_INK_3; }
    else if (g_si5356_status & SI5356_LOS_CLKIN) { si = "LOS CLKIN!";  sic = UI_COLOR_BAD; }
    else if (g_si5356_status & SI5356_PLL_LOL)   { si = "PLL UNLOCK!"; sic = UI_COLOR_BAD; }
    else if (g_si5356_status & SI5356_SYS_CAL)   { si = "CALIB...";    sic = UI_COLOR_VIOLET; }
    else                                         { si = "LOCK OK";     sic = UI_COLOR_OK; }
    snprintf(buf, sizeof(buf), "Ref Si5356: %s", si);
    if (force || dchg(c_lnk[1], sizeof(c_lnk[1]), buf)) {
        dtext(DG_RLBL, 228, DG_COLW - 24, buf, sic, &ui_font_mono_18); drew = 1; }
    int nok = 0; for (int i = 0; i < SENS_COUNT; i++) if (g_sensors[i].valid) nok++;
    snprintf(buf, sizeof(buf), "Senzory: %d/%d OK", nok, (int)SENS_COUNT);
    snprintf(key, sizeof(key), "%c%s", (nok >= SENS_COUNT - 1) ? 'O' : 'X', buf);  /* -1: 0x4A neosazen */
    if (force || dchg(c_lnk[2], sizeof(c_lnk[2]), key)) {
        dtext(DG_RLBL, 256, DG_COLW - 24, buf,
              (nok >= SENS_COUNT - 1) ? UI_COLOR_OK : UI_COLOR_WARN, &ui_font_mono_18); drew = 1; }

    /* ── Pravy sloupec: karta System (napajeni souhrnne / uptime / reset / selftest).
     * Konkretni napeti vetvi jsou v Diagnostice + SENZORY; tady jen verdikt. ── */
    static char c_sys2[5][40];
    { const sensor_stat_t *v12 = &g_sensors[SENS_ADS2];
      const sensor_stat_t *v5  = &g_sensors[SENS_ADS3];
      const char *ps; prim_color_t pc;
      if (v12->samples == 0 || v5->samples == 0 || !v12->valid || !v5->valid) {
          ps = "Unkn"; pc = UI_COLOR_INK_3;
      } else {
          long m12 = lround_f(v12->last), m5 = lround_f(v5->last);
          int ok12 = (m12 > 10800 && m12 < 13200);    /* 12 V ±10 % */
          int ok5  = (m5  > 4500  && m5  < 5500);     /* 5 V ±10 % */
          if (ok12 && ok5) { ps = "OK";   pc = UI_COLOR_OK; }
          else             { ps = "FAIL"; pc = UI_COLOR_BAD; }
      }
      snprintf(buf, sizeof(buf), "Power supplies: %s", ps);
      /* TODO #11(2b) 2026-07-19: bump na mono_18 tam, kde se vejde (overeno
       * tabulkou fontu). Tenhle radek ("Power supplies: FAIL" max 20 zn.) i
       * Uptime nize maji velkou rezervu (352 px box, realny obsah <200 px). */
      if (force || dchg(c_sys2[0], sizeof(c_sys2[0]), buf)) {
          dtext(DG_RLBL, 328, DG_COLW - 24, buf, pc, &ui_font_mono_18); drew = 1; } }
    { uint32_t s = g_uptime_s;
      snprintf(buf, sizeof(buf), "Uptime: %lu:%02lu:%02lu", (unsigned long)(s / 3600u),
               (unsigned long)((s / 60u) % 60u), (unsigned long)(s % 60u));
      if (force || dchg(c_sys2[1], sizeof(c_sys2[1]), buf)) {
          dtext(DG_RLBL, 350, DG_COLW - 24, buf, UI_COLOR_INK_2, &ui_font_mono_18); drew = 1; } }
    if (g_crash_text[0])
        snprintf(buf, sizeof(buf), "Reset: %s %s", (const char *)g_reset_text,
                 (const char *)g_crash_text);
    else
        snprintf(buf, sizeof(buf), "Reset: %s", (const char *)g_reset_text);
    int rbad = g_reset_bad || g_crash_text[0];
    /* ⚠️ TODO #11(2b): NEbumpovano — nejdelsi radek Reset ("Reset: " +
     * g_reset_text[12] + " " + g_crash_text[16]) = 34 zn. = 340 px pri
     * mono_16 (bezva bez rezervy, box 352 px); pri mono_18 by to bylo
     * 374 px > 352 -> orizlo by se (overeno tabulkou fontu). */
    if (force || dchg(c_sys2[2], sizeof(c_sys2[2]), buf)) {
        dtext(DG_RLBL, 372, DG_COLW - 24, buf,
              rbad ? UI_COLOR_BAD : UI_COLOR_INK_3, &ui_font_mono_16); drew = 1; }
    /* Selftest + CM4 (D2) sdili jeden radek (oba kratke fixni retezce - "Selftest:
     * FAIL" max 14 zn. v boxu 190 px, "CM4:ABSENT" max 10 zn. v boxu 156 px;
     * pri mono_18 (advance 11) to je 154 resp. 110 px - porad s rezervou, zadne
     * riziko prekryvu, overeno tabulkou fontu). Drive samostatny radek CM4 na
     * baseline 416 kolidoval s paticnimi tlacitky (zacinaji na y=417). */
    snprintf(buf, sizeof(buf), "Selftest: %s",
             g_selftest_res == 1 ? "PASS" : (g_selftest_res == 2 ? "FAIL" : "---"));
    if (force || dchg(c_sys2[3], sizeof(c_sys2[3]), buf)) {
        dtext(DG_RLBL, 394, 190, buf,
              g_selftest_res == 1 ? UI_COLOR_OK
              : (g_selftest_res == 2 ? UI_COLOR_BAD : UI_COLOR_INK_3), &ui_font_mono_18);
        drew = 1; }

    /* CM4 (D2) boot + stav ETH linky (F1, IPC v5). CM4 ABSENT = degradovany rezim
     * (prazdna bank2 / BCM4=0), amber. Kdyz CM4 bezi, pripoj NET stav (link z CM4;
     * dnes vzdy "down" nez prijde lwIP ve F5). Mono_16 (advance 10) -> "CM4:OK
     * NET:down" = 150 px do boxu 156 px (overeno). */
    /* ⚠️ Do boxu 156 px se pri mono_16 (advance 10) vejde 15 znaku — "CM4:OK NET:down"
     * je presne na doraz, takze PRIPOJIT dalsi udaj NELZE. Misto toho se ukazuje ten
     * udaj, ktery v danem stavu neco rika: dokud link nejede (tj. do lwIP ve F5) je
     * "NET:down" konstanta bez informace, kdezto PHY ID je zivy dukaz, ze CM4 mluvi
     * s LAN8742A pres MDIO (= kriterium F3). Jakmile link nabehne, prebira NET. */
    if (g_cm4_absent)
        snprintf(buf, sizeof(buf), "CM4:ABSENT");
    /* ⚠️ Nesoulad IPC verzi bank ma PREDNOST: v tomhle stavu CM4 zije a heartbeat bezi
     * (takze header ukazuje "4:xx%"), ale snapshot IGNORUJE — displej by jinak klamal.
     * "CM4:IPCv5!=6" = 12 znaku, vejde se. Lecba = preflashnout OBE banky. */
    else if (g_cm4_ipc_ver != (uint8_t)IPC_VERSION)
        snprintf(buf, sizeof(buf), "CM4:IPCv%u!=%u",
                 (unsigned)g_cm4_ipc_ver, (unsigned)IPC_VERSION);
    else if (g_cm4_net_up)
        snprintf(buf, sizeof(buf), "CM4:OK NET:UP");
    else if (g_cm4_eth_ok && g_cm4_phy_id != 0u)
        snprintf(buf, sizeof(buf), "CM4:OK PHY:%04X", (unsigned)(g_cm4_phy_id & 0xFFFFu));
    else
        snprintf(buf, sizeof(buf), "CM4:OK ETH:--");
    if (force || dchg(c_sys2[4], sizeof(c_sys2[4]), buf)) {
        dtext((int16_t)(DG_RLBL + 196), 394, (int16_t)(DG_COLW - 24 - 196), buf,
              (g_cm4_ipc_ver != (uint8_t)IPC_VERSION) ? UI_COLOR_BAD   /* nesoulad = mereni/data z CM4 nejsou platna */
              : g_cm4_absent                          ? UI_COLOR_WARN
              : (g_cm4_eth_ok ? UI_COLOR_OK : UI_COLOR_WARN), &ui_font_mono_16);
        drew = 1; }

    return drew;
}

void app_gpsdo_render_health(void)
{
    int first = window_first(3);
    if (first) {
        s_view = 3;
        window_chrome("SYSTEM HEALTH", WIN_TITLE_Y);
        ui_button_t sens = {.rect = SENS_BTN_RECT, .variant = UI_BUTTON_NORMAL, .label = "SENZORY"};
        ui_button_render(&sens);
        ui_button_t hdiag = {.rect = HEALTH_DIAG_BTN_RECT, .variant = UI_BUTTON_NORMAL,
                             .label = "DIAGNOSTIKA"};
        ui_button_render(&hdiag);
        ui_button_t set = {.rect = SET_BTN_RECT, .variant = UI_BUTTON_NORMAL, .label = "NASTAVENI"};
        ui_button_render(&set);
        ui_button_t grf = {.rect = HEALTH_GRAPH_BTN_RECT, .variant = UI_BUTTON_NORMAL, .label = "GRAFY"};
        ui_button_render(&grf);

        /* Levy: RTOS + Stack tasku. */
        ui_card_t c_rtos = {.rect = {DG_LX, 58, DG_COLW, 122},
                            .header_label = "RTOS / Pamet"};
        ui_card_render_chrome(&c_rtos);
        dlabel(DG_LLBL, 104, "Heap free");
        dlabel(DG_LLBL, 132, "Heap min");
        dlabel(DG_LLBL, 160, "CPU");
        /* Uptime presunut do karty "System" (pravy sloupec). */

        ui_card_t c_stk = {.rect = {DG_LX, 218, DG_COLW, 186},
                           .header_label = "Stack tasku (volno)"};
        ui_card_render_chrome(&c_stk);
        dlabel(DG_LLBL, 264, "UiTask");
        dlabel(DG_LLBL, 292, "FpgaTask");
        dlabel(DG_LLBL, 320, "UartTask");
        dlabel(DG_LLBL, 348, "I2C4Task");
        dlabel(DG_LLBL, 376, "Default");

        /* Pravy: I2C + Linky + Napajeni. */
        ui_card_t c_i2c = {.rect = {DG_RX, 58, DG_COLW, 86},
                           .header_label = "I2C sbernice (chyby)"};
        ui_card_render_chrome(&c_i2c);

        ui_card_t c_lnk = {.rect = {DG_RX, 154, DG_COLW, 116},
                           .header_label = "Periferie / linky"};
        ui_card_render_chrome(&c_lnk);

        ui_card_t c_pwr = {.rect = {DG_RX, 280, DG_COLW, 128},
                           .header_label = "System"};
        ui_card_render_chrome(&c_pwr);
        /* vsechny radky (Napajeni/Uptime/Reset/Selftest) kresli draw_health_values
         * celobarevne (dtext) — konkretni napeti jsou v Diagnostice/SENZORY */
    }
    if (draw_health_values(first)) present_now();
}

/* ── Podmenu vsech senzoru (s_view=4), otevre se z System Health ──────────
 * Cisty prehled AKTUALNICH hodnot, dva sloupce jako diagnostika: vlevo Teploty,
 * vpravo Napeti. Jmena (dlabel) kresli render_sensors jednou; zive hodnoty
 * (dval, zarovnane vpravo) tady. Bez min/max/avg/err — jen aktualni hodnota. */
#define SENS_R0   132                /* y prvniho radku */
#define SENS_DY    32                /* rozteč radku */

/* Rozmisteni: id senzoru + sloupec (xr value) + radek (y) + zda je to teplota. */
static const struct { uint8_t id; int16_t xr; int16_t y; uint8_t temp; }
SENS_ROW[SENS_COUNT] = {
    { SENS_T48,    DG_LVAL, SENS_R0 + 0 * SENS_DY, 1 },   /* leva: Teploty (poradi = labely: */
    { SENS_CORE_T, DG_LVAL, SENS_R0 + 1 * SENS_DY, 1 },   /* STM board / MCU jadro /         */
    { SENS_T49,    DG_LVAL, SENS_R0 + 2 * SENS_DY, 1 },   /* OCXO / FPGA board)              */
    { SENS_T4A,    DG_LVAL, SENS_R0 + 3 * SENS_DY, 1 },
    { SENS_ADS0,   DG_RVAL, SENS_R0 + 0 * SENS_DY, 0 },   /* prava: Napeti */
    { SENS_ADS1,   DG_RVAL, SENS_R0 + 1 * SENS_DY, 0 },
    { SENS_ADS2,   DG_RVAL, SENS_R0 + 2 * SENS_DY, 0 },
    { SENS_ADS3,   DG_RVAL, SENS_R0 + 3 * SENS_DY, 0 },
    { SENS_VDDA,   DG_RVAL, SENS_R0 + 4 * SENS_DY, 0 },
    { SENS_VBAT,   DG_RVAL, SENS_R0 + 5 * SENS_DY, 0 },
};

static int draw_sensors_values(int force)
{
    static char c[SENS_COUNT][20];
    char buf[20], key[24];
    int drew = force;
    for (int i = 0; i < SENS_COUNT; i++) {
        const sensor_stat_t *s = &g_sensors[SENS_ROW[i].id];
        if (s->samples == 0)       snprintf(buf, sizeof buf, "---");
        else if (SENS_ROW[i].temp) fmt_temp(buf, sizeof buf, s->last);        /* "23.45 C" */
        else                       snprintf(buf, sizeof buf, "%ld mV", lround_f(s->last));
        snprintf(key, sizeof key, "%c%s", s->valid ? 'V' : 'X', buf);   /* redraw i pri zmene valid */
        if (force || dchg(c[i], sizeof c[i], key)) {
            dval(SENS_ROW[i].xr, SENS_ROW[i].y, 150, buf, s->valid); drew = 1;
        }
    }
    return drew;
}

/* Footer: vynuluje min/max/mean vsech senzoru (RAM, okamzite — na rozdil od
 * datalogu tu neni co blokujiciho, staci normalni tlacitko bez potvrzeni). */
static const prim_rect_t SENS_RESET_RECT = {18, 417, 300, 61};

void app_gpsdo_render_sensors(void)
{
    int first = window_first(4);
    if (first) {
        s_view = 4;
        window_chrome("SENZORY", WIN_TITLE_Y);
        ui_card_t c = {.rect = DG_CARD_FULL_A,
                       .header_label = "Aktualni hodnoty senzoru"};
        ui_card_render_chrome(&c);
        ui_button_t rb = {.rect = SENS_RESET_RECT, .variant = UI_BUTTON_NORMAL,
                          .label = "RESET MIN/MAX"};
        ui_button_render(&rb);

        /* podnadpisy sloupcu */
        prim_draw_text((prim_point_t){DG_LLBL, 104}, "TEPLOTY  [C]", &ui_font_mono_18,
                       UI_COLOR_INK_2, PRIM_ALIGN_LEFT);
        prim_draw_text((prim_point_t){DG_RLBL, 104}, "NAPETI  [mV]", &ui_font_mono_18,
                       UI_COLOR_INK_2, PRIM_ALIGN_LEFT);
        /* jmena senzoru (poradi musi sedet se SENS_ROW) */
        dlabel(DG_LLBL, SENS_R0 + 0 * SENS_DY, "STM board");
        dlabel(DG_LLBL, SENS_R0 + 1 * SENS_DY, "MCU jadro");
        dlabel(DG_LLBL, SENS_R0 + 2 * SENS_DY, "OCXO");
        dlabel(DG_LLBL, SENS_R0 + 3 * SENS_DY, "FPGA board");
        dlabel(DG_RLBL, SENS_R0 + 0 * SENS_DY, "OCXO_VC");
        dlabel(DG_RLBL, SENS_R0 + 1 * SENS_DY, "RF_Level");
        dlabel(DG_RLBL, SENS_R0 + 2 * SENS_DY, "12V vetev");
        dlabel(DG_RLBL, SENS_R0 + 3 * SENS_DY, "5V vetev");
        dlabel(DG_RLBL, SENS_R0 + 4 * SENS_DY, "VREF");
        dlabel(DG_RLBL, SENS_R0 + 5 * SENS_DY, "VBAT");
    }
    if (draw_sensors_values(first)) present_now();
}

/* ── Okno GRAFY (s_view=29): casovy prubeh teplot + napajeni (STATUS.md #31) ──
 * Vstup: tlacitko GRAFY v System Health. Kombinovany datovy zdroj:
 *   - KRATKA okna (<=1 h) z RAM decimacni pyramidy (sensor_hist.c) — hladke, od
 *     bootu, vsechny senzory;
 *   - DLOUHA okna (6 h / 1 den / 7 dni) z datalogu (W25Q) — jen veliciny, ktere
 *     datalog uklada (OCXO+deska teplota, OCXO Vc); ostatni serie se u dlouhych
 *     oken vynechaji (v grafu neni cara). Vpravo vertikalni bargrafy AKTUALNICH
 *     hodnot napajecich vetvi s nominalnim markerem (#32) — vzdy z g_sensors[]. */
#define GRAPH_MAXPTS 120
static float s_gbuf[GRAPH_MAXPTS];   /* sdilena serie (jen UiTask kresli) */

/* Presety casoveho okna + zdroj (dlog=1 -> datalog, jinak RAM). */
static const struct { int32_t secs; uint8_t dlog; } GRAPH_PRESETS[] = {
    {180,   0},   /* 3 min  (RAM)     */
    {900,   0},   /* 15 min (RAM)     */
    {3600,  0},   /* 1 h    (RAM)     */
    {21600, 1},   /* 6 h    (datalog) */
    {86400, 1},   /* 1 den  (datalog) */
    {604800,1},   /* 7 dni  (datalog) */
};
#define GRAPH_PRESET_N ((int)(sizeof(GRAPH_PRESETS)/sizeof(GRAPH_PRESETS[0])))
static int s_graph_idx = 1;   /* default 15 min */

static const prim_rect_t GRAPH_MINUS = {18, 417, 90, 61};
static const prim_rect_t GRAPH_PLUS  = {214, 417, 90, 61};
/* SESTERSKA dvojice (bez nav_push, jako ALLAN<->HIST): GRAFY (s_view=29, casovy
 * prubeh) <-> PREHLED KANALU (s_view=30, horizontalni bargrafy aktualnich hodnot).
 * Tlacitko ve footeru obou oken prepina mezi nimi; BACK z obou vede tam, odkud
 * byla dvojice otevrena (System Health). */
static const prim_rect_t GRAPH_BARS_BTN = {330, 417, 200, 61};  /* GRAFY -> PREHLED */
static const prim_rect_t HBARS_GRAF_BTN = {18,  417, 200, 61};  /* PREHLED -> GRAFY */

/* Karty: vlevo dva grafy (teploty nahore, OCXO Vc dole), vpravo bargrafy. */
static const prim_rect_t GRAPH_CARD_T  = {18, 58, 544, 176};   /* teploty */
static const prim_rect_t GRAPH_CARD_V  = {18, 242, 544, 168};  /* OCXO Vc  */
static const prim_rect_t GRAPH_CARD_B  = {576, 58, 208, 352};  /* bargrafy */
static const prim_rect_t GRAPH_PLOT_T  = {26, 96, 528, 106};   /* plocha grafu teplot */
static const prim_rect_t GRAPH_PLOT_V  = {26, 280, 528, 116};  /* plocha grafu Vc */

/* Serie teplot (poradi = legenda; barvy viz graph_line_col). */
static const struct { uint8_t id; const char *name; } GRAPH_TEMP[4] = {
    { SENS_T48,    "STM"  },
    { SENS_CORE_T, "MCU"  },
    { SENS_T49,    "OCXO" },
    { SENS_T4A,    "FPGA" },
};
/* Barva serie (UI_COLOR_* jsou runtime makra -> nelze do static init). */
static prim_color_t graph_line_col(int i)
{
    switch (i) { case 0: return UI_COLOR_ACC; case 1: return UI_COLOR_OK;
                 case 2: return UI_COLOR_WARN; default: return UI_COLOR_BAD; }
}

/* Vertikalni bargrafy vpravo — napajeci vetve + Vc, s nominalni hodnotou. */
static const struct { uint8_t id; const char *lab; float lo, hi, nom; } GRAPH_BAR[5] = {
    { SENS_ADS2, "12V", 10800.f, 13200.f, 12000.f },
    { SENS_ADS3, "5V",   4500.f,  5500.f,  5000.f },
    { SENS_VDDA, "REF",  2300.f,  2700.f,  2500.f },
    { SENS_VBAT, "BAT",  2500.f,  3400.f,  3300.f },   /* CR2032, nominal 3,3 V */
    { SENS_ADS0, "Vc",      0.f,  3300.f,  1650.f },
};

/* Datalog nese jen 4 z merenych velicin -> mapovani senzor->pole (-1 = neni).
 * VBAT pribyl 2026-08-17 (bajt 27 zaznamu) — u dlouhych oken tedy nove jde
 * videt i stárnutí zalozni CR2032. Zaznamy porizene driv ho nemaji a
 * `graph_series_dlog` je preskoci (drzi posledni platnou hodnotu). */
static int graph_dlog_field(uint8_t sens)
{ return sens == SENS_T49 ? 0 : sens == SENS_T48 ? 1 : sens == SENS_ADS0 ? 2
       : sens == SENS_VBAT ? 3 : -1; }

/* Nacte serii z DATALOGU (field 0=OCXO t, 1=deska t, 2=OCXO Vc, 3=VBAT) do out (oldest→new). */
static int graph_series_dlog(int field, int32_t win_s, float *out, int max_out,
                             float *mn, float *mx, int32_t *span_s)
{
    datalog_status_t st; datalog_get_status(&st);
    if (!st.ready || st.records < 2) return 0;
    int32_t nrec_win = win_s / (int32_t)DATALOG_PERIOD_S; if (nrec_win < 2) nrec_win = 2;
    int32_t nrec = (nrec_win < (int32_t)st.records) ? nrec_win : (int32_t)st.records;
    int npts = (int)nrec; if (npts > max_out) npts = max_out; if (npts < 2) return 0;
    int32_t stride = nrec / npts; if (stride < 1) stride = 1;
    float mnv = 1e30f, mxv = -1e30f, last = 0; int havelast = 0;
    for (int i = 0; i < npts; i++) {
        uint32_t fn = (uint32_t)((npts - 1 - i) * stride);   /* oldest→newest */
        datalog_rec_t r; float v = 0; int ok = 0;
        if (datalog_read_back(fn, &r)) {
            int16_t raw = (field == 0) ? r.t_ocxo_c100
                        : (field == 1) ? r.t_board_c100
                        : (field == 2) ? r.ocxo_vc_mv : r.vbat_mv;
            ok = (raw != DATALOG_INVALID16);
            /* Teploty jsou v setinach °C, napeti (Vc i VBAT) uz v mV. */
            v  = (field >= 2) ? (float)raw : (float)raw * 0.01f;
        }
        if (!ok) v = havelast ? last : 0;
        else     { last = v; havelast = 1; }
        out[i] = v;
        if (v < mnv) mnv = v;
        if (v > mxv) mxv = v;
    }
    if (mn) *mn = mnv;
    if (mx) *mx = mxv;
    if (span_s) *span_s = (int32_t)(npts - 1) * stride * (int32_t)DATALOG_PERIOD_S;
    return npts;
}

/* Jednotny fetch serie do s_gbuf (RAM nebo datalog dle use_dlog). */
static int graph_fetch(uint8_t sens, int32_t win_s, int use_dlog,
                       float *mn, float *mx, int32_t *span)
{
    if (use_dlog) {
        int f = graph_dlog_field(sens);
        if (f < 0) return 0;
        return graph_series_dlog(f, win_s, s_gbuf, GRAPH_MAXPTS, mn, mx, span);
    }
    return sensor_hist_series((sensor_id_t)sens, win_s, s_gbuf, GRAPH_MAXPTS,
                              mn, mx, NULL, span);
}

/* Polyline z s_gbuf (n bodu) do plochy `in`, mapovano [vmin..vmax] -> vyska. */
static void graph_plot(prim_rect_t in, int n, float vmin, float vmax, prim_color_t col)
{
    if (n < 2) return;
    float span = vmax - vmin; if (span < 1e-6f) span = 1.0f;
    int16_t px = in.x, py;
    { float t = (s_gbuf[0] - vmin) / span; if (t < 0) t = 0; if (t > 1) t = 1;
      py = (int16_t)(in.y + in.h - 1 - (int)(t * (in.h - 1))); }
    for (int i = 1; i < n; i++) {
        int16_t x = (int16_t)(in.x + (int32_t)i * (in.w - 1) / (n - 1));
        float t = (s_gbuf[i] - vmin) / span; if (t < 0) t = 0; if (t > 1) t = 1;
        int16_t y = (int16_t)(in.y + in.h - 1 - (int)(t * (in.h - 1)));
        prim_draw_line((prim_point_t){px, py}, (prim_point_t){x, y}, 2, col);
        px = x; py = y;
    }
}

/* Mrizka grafu: podklad BG_CARD + 3 vodorovne delici cary (ctvrtiny). */
static void graph_grid(prim_rect_t in)
{
    prim_fill_rect(in, UI_COLOR_BG_CARD, PRIM_BLEND_REPLACE);
    for (int q = 1; q < 4; q++) {
        int16_t y = (int16_t)(in.y + (int32_t)q * (in.h - 1) / 4);
        prim_draw_line((prim_point_t){in.x, y},
                       (prim_point_t){(int16_t)(in.x + in.w - 1), y}, 1, UI_COLOR_INK_5);
    }
}

/* Graf teplot: sdilena osa pres vsechny dostupne serie + legenda s akt. hodnotou. */
static void graph_render_temps(int32_t win_s, int use_dlog)
{
    float gmn = 1e30f, gmx = -1e30f; int any = 0;
    int cnt[4];
    for (int k = 0; k < 4; k++) {
        float mn, mx;
        cnt[k] = graph_fetch(GRAPH_TEMP[k].id, win_s, use_dlog, &mn, &mx, NULL);
        if (cnt[k] >= 2) { if (mn < gmn) gmn = mn; if (mx > gmx) gmx = mx; any = 1; }
    }
    graph_grid(GRAPH_PLOT_T);
    if (!any) {
        prim_draw_text((prim_point_t){(int16_t)(GRAPH_PLOT_T.x + GRAPH_PLOT_T.w / 2),
                       (int16_t)(GRAPH_PLOT_T.y + GRAPH_PLOT_T.h / 2)},
                       "cekam na data", &ui_font_sans_18, UI_COLOR_INK_4, PRIM_ALIGN_CENTER);
    } else {
        float pad = (gmx - gmn) * 0.08f; if (pad < 0.1f) pad = 0.1f;
        gmn -= pad; gmx += pad;
        for (int k = 0; k < 4; k++) {
            if (cnt[k] < 2) continue;
            int c2 = graph_fetch(GRAPH_TEMP[k].id, win_s, use_dlog, NULL, NULL, NULL);
            if (c2 >= 2) graph_plot(GRAPH_PLOT_T, c2, gmn, gmx, graph_line_col(k));
        }
        /* Y popisky (min/max osy) vlevo. */
        char b[16];
        fmt_fixed(b, sizeof b, gmx, 1);
        dtext(GRAPH_PLOT_T.x + 2, (int16_t)(GRAPH_PLOT_T.y + 14), 70, b, UI_COLOR_INK_3, &ui_font_mono_14);
        fmt_fixed(b, sizeof b, gmn, 1);
        dtext(GRAPH_PLOT_T.x + 2, (int16_t)(GRAPH_PLOT_T.y + GRAPH_PLOT_T.h - 4), 70, b, UI_COLOR_INK_3, &ui_font_mono_14);
    }
    /* Legenda: [•] name value, 4 polozky v rade pod grafem. */
    for (int k = 0; k < 4; k++) {
        int16_t lx = (int16_t)(GRAPH_CARD_T.x + 12 + k * 132);
        int16_t ly = 222;
        char v[24];
        const sensor_stat_t *s = &g_sensors[GRAPH_TEMP[k].id];
        int avail = (cnt[k] >= 2);
        prim_fill_circle((prim_point_t){(int16_t)(lx + 4), (int16_t)(ly - 5)}, 4,
                         avail ? graph_line_col(k) : UI_COLOR_INK_5);
        if (s->samples) { char n[12]; fmt_fixed(n, sizeof n, s->last, 1);
                          snprintf(v, sizeof v, "%s %s", GRAPH_TEMP[k].name, n); }
        else            snprintf(v, sizeof v, "%s --", GRAPH_TEMP[k].name);
        dtext((int16_t)(lx + 14), ly, 116, v,
              avail ? UI_COLOR_INK_2 : UI_COLOR_INK_4, &ui_font_mono_14);
    }
}

/* ── Dolni graf: OCXO Vc ↔ VBAT, prepinatelne TAPEM ─────────────────────────
 * VBAT (zalozni CR2032) se od 2026-08-17 loguje do datalogu, takze u dlouhych
 * oken jde videt jeji stárnutí — a to je jediny zpusob, jak odhadnout, KDY ji
 * vymenit (prahovy alarm krikne az kdyz je pozde).
 * ⚠️ Zamerne PREPINAC, ne dve serie v jednom grafu: Vc se pohybuje kolem 1,9 V
 * a VBAT kolem 2,9 V, takze spolecny autoscale by obe kresliky zmackl do ~30 %
 * vysky. Tap na kartu je navic zavedeny idiom (karta Druzice bar↔sky). */
static bool s_graph_vbat = false;   /* false = OCXO Vc (vychozi), true = VBAT */

static void graph_render_vc(int32_t win_s, int use_dlog)
{
    float mn, mx; int32_t span = 0;
    int n = graph_fetch(s_graph_vbat ? SENS_VBAT : SENS_ADS0, win_s, use_dlog, &mn, &mx, &span);
    graph_grid(GRAPH_PLOT_V);
    if (n < 2) {
        prim_draw_text((prim_point_t){(int16_t)(GRAPH_PLOT_V.x + GRAPH_PLOT_V.w / 2),
                       (int16_t)(GRAPH_PLOT_V.y + GRAPH_PLOT_V.h / 2)},
                       "cekam na data", &ui_font_sans_18, UI_COLOR_INK_4, PRIM_ALIGN_CENTER);
        return;
    }
    float pad = (mx - mn) * 0.08f; if (pad < 1.0f) pad = 1.0f;
    graph_plot(GRAPH_PLOT_V, n, mn - pad, mx + pad,
               s_graph_vbat ? UI_COLOR_WARN : UI_COLOR_ACC);
    char b[16], o[40], sp[16];
    fmt_fixed(b, sizeof b, mx, 0);
    dtext(GRAPH_PLOT_V.x + 2, (int16_t)(GRAPH_PLOT_V.y + 14), 80, b, UI_COLOR_INK_3, &ui_font_mono_14);
    fmt_fixed(b, sizeof b, mn, 0);
    dtext(GRAPH_PLOT_V.x + 2, (int16_t)(GRAPH_PLOT_V.y + GRAPH_PLOT_V.h - 4), 80, b, UI_COLOR_INK_3, &ui_font_mono_14);
    screen_main_fmt_dur(sp, sizeof sp, span);
    snprintf(o, sizeof o, "%ld mV rozsah  ~%s", lround_f(mx - mn), sp);
    dtext((int16_t)(GRAPH_PLOT_V.x + GRAPH_PLOT_V.w - 200), (int16_t)(GRAPH_PLOT_V.y + 14),
          200, o, UI_COLOR_INK_3, &ui_font_mono_14);
}

/* Vertikalni bargrafy vpravo: aktualni hodnota vetve + nominalni marker (#32). */
static void graph_render_bars(void)
{
    for (int k = 0; k < 5; k++) {
        int16_t bx = (int16_t)(585 + k * 42);   /* uzsi bary (22 px), vetsi rozestup */
        const sensor_stat_t *s = &g_sensors[GRAPH_BAR[k].id];
        float lo = GRAPH_BAR[k].lo, hi = GRAPH_BAR[k].hi, nom = GRAPH_BAR[k].nom;
        float val = s->last;
        int16_t pct = (int16_t)((val - lo) * 100.f / (hi - lo));
        if (pct < 0) pct = 0;
        if (pct > 100) pct = 100;
        int16_t nomp = (int16_t)((nom - lo) * 100.f / (hi - lo));
        int ok = s->valid && s->samples &&
                 (val > nom - (hi - lo) * 0.15f) && (val < nom + (hi - lo) * 0.15f);
        /* 55 segmentu (3 px, VGAP 1 -> plni stopu 219 px presne) = jemne rozliseni. */
        ui_bargraph_t bar = {
            .rect = {bx, 118, 22, 219}, .value_pct = s->samples ? pct : 0,
            .color = s->samples ? (ok ? UI_COLOR_OK : UI_COLOR_WARN) : UI_COLOR_INK_5,
            .vertical = 1, .segs = 55, .nominal_pct = nomp };
        ui_bargraph_render(&bar);
        /* hodnota nad barem (V) + popisek pod nim (stred = bx+11). */
        char v[12];
        if (s->samples) fmt_fixed(v, sizeof v, val / 1000.f, 1);
        else            snprintf(v, sizeof v, "--");
        dtext_c((int16_t)(bx + 11), 112, 42, v,
                s->valid ? UI_COLOR_INK : UI_COLOR_INK_3, &ui_font_mono_14);
        dtext_c((int16_t)(bx + 11), 356, 42, GRAPH_BAR[k].lab, UI_COLOR_INK_3, &ui_font_mono_14);
    }
}

/* Footer: presety okna (-/+) + hodnota + zdroj (RAM/datalog). */
static void graph_render_footer(void)
{
    ui_button_t m = {.rect = GRAPH_MINUS, .variant = UI_BUTTON_NORMAL, .label = "-"};
    ui_button_t p = {.rect = GRAPH_PLUS,  .variant = UI_BUTTON_NORMAL, .label = "+"};
    ui_button_render(&m);
    ui_button_render(&p);
    prim_fill_rect_rounded((prim_rect_t){112, 419, 98, 57}, 6, UI_COLOR_BG_CARD, PRIM_BLEND_OVER);
    char v[16];
    screen_main_fmt_dur(v, sizeof v, GRAPH_PRESETS[s_graph_idx].secs);
    prim_draw_text((prim_point_t){161, 450}, v, &ui_font_mono_22, UI_COLOR_INK, PRIM_ALIGN_CENTER);
    prim_draw_text((prim_point_t){161, 470},
                   GRAPH_PRESETS[s_graph_idx].dlog ? "datalog" : "RAM",
                   &ui_font_mono_14, UI_COLOR_INK_4, PRIM_ALIGN_CENTER);
    /* Prepinac na sesterske okno PREHLED KANALU (horizontalni bargrafy). */
    ui_button_t hb = {.rect = GRAPH_BARS_BTN, .variant = UI_BUTTON_NORMAL,
                      .label = "PREHLED >"};
    ui_button_render(&hb);
}

/* Prekresli VSECHEN dynamicky obsah (grafy + bargrafy). Kazdy kus si cisti box. */
static void graph_render_dynamic(void)
{
    int32_t win = GRAPH_PRESETS[s_graph_idx].secs;
    int dlog = GRAPH_PRESETS[s_graph_idx].dlog;
    graph_render_temps(win, dlog);
    graph_render_vc(win, dlog);
    graph_render_bars();
}

static void app_gpsdo_render_graphs(void)
{
    static uint32_t s_key;
    int first = window_first(29);
    if (first) {
        s_view = 29;
        window_chrome("GRAFY", WIN_TITLE_Y);
        ui_card_t ct = {.rect = GRAPH_CARD_T, .header_label = "Teploty [C] v case"};
        ui_card_render_chrome(&ct);
        ui_card_t cv = {.rect = GRAPH_CARD_V,
                        .header_label = s_graph_vbat ? "VBAT — zalozni baterie [mV]"
                                                     : "OCXO ladici napeti [mV]"};
        ui_card_render_chrome(&cv);
        /* Naznak prepinatelnosti — stejny vzor jako "TAP: bar/sky" u karty Druzice. */
        prim_draw_text((prim_point_t){(int16_t)(GRAPH_CARD_V.x + GRAPH_CARD_V.w - 12),
                                      (int16_t)(GRAPH_CARD_V.y + 25)},
                       "TAP: Vc/VBAT", &ui_font_mono_14, UI_COLOR_INK_4, PRIM_ALIGN_RIGHT);
        ui_card_t cb = {.rect = GRAPH_CARD_B, .header_label = "Napajeci vetve [V]"};
        ui_card_render_chrome(&cb);
        graph_render_footer();
    }
    /* Change-key: RAM okna se hybou 1x/s (uptime — cteni z RAM je levne). DATALOG
     * okna se renderuji JEN pri vstupu / zmene presetu (klic stabilni per preset):
     * jeden render dela az stovky blokujicich QSPI read_back -> periodicke
     * obnovovani by v UiTasku porusilo pravidlo "zadny spin >10 ms" (viz CLAUDE.md).
     * Dlouha historie je stejne minuty/hodiny stara, takze 1x pri otevreni staci. */
    uint32_t key;
    if (GRAPH_PRESETS[s_graph_idx].dlog)
        key = 0x20000000u | (uint32_t)s_graph_idx;                 /* stabilni per preset */
    else
        key = ((uint32_t)s_graph_idx << 24) ^ g_uptime_s;         /* 1x/s posun */
    if (first || key != s_key) {
        s_key = key;
        graph_render_dynamic();
        present_now();
    }
}

/* ── Okno PREHLED KANALU (s_view=30) — horizontalni bargrafy AKTUALNICH hodnot ──
 * Sesterske okno k GRAFY (#31): kdezto GRAFY ukazuje casovy prubeh, tady jsou
 * vsechny kanaly (teploty + napajeni + OCXO Vc + RF) jako vodorovne bary s
 * nominalnim markerem a cislenou hodnotou -> odchylka od ocekavane hodnoty na
 * prvni pohled. Vsechna data jsou REALNA (g_sensors[], SensorsTask 2 Hz), na
 * rozdil od simulovaneho headline. Prepina se tlacitkem (bez nav_push).
 *
 * Layout radku: [label vlevo] [track uprostred + fill + nominal] [hodnota vpravo].
 * Track/hodnota se prekresluji jen pri ZMENE (per-radek dchg-styl), label je
 * staticky (kresli se pri prvnim vstupu). */
#define HBAR_ROWS 10
static const int16_t HB_LBL_X   = 32;    /* label vlevo                     */
static const int16_t HB_TRACK_X = 210;   /* zacatek stopy baru              */
static const int16_t HB_TRACK_W = 452;   /* sirka stopy (210..662)          */
static const int16_t HB_VAL_XR  = 770;   /* prava hrana boxu hodnoty        */
static const int16_t HB_VAL_W   = 100;   /* box hodnoty (670..770)          */
static const prim_rect_t HB_CARD_T = {18, 58,  764, 150};   /* Teploty  */
static const prim_rect_t HB_CARD_V = {18, 216, 764, 194};   /* Napajeni */

/* Popis radku: id senzoru, label, rozsah baru [lo..hi], nominal (<=lo = zadny
 * marker/ok-warn, jen valid=zelena), scale (last -> zobrazovana jednotka),
 * pocet desetin, jednotka. RF (index 9) ma rf=1 = prepocet mV->dBm z g_calib.
 *
 * `deci` (2026-08-16, na vyzadani): teploty na SETINY, napeti na TISICINY —
 * ADS1115 ma 16 bit na +-4,096 V (125 uV/LSB) a TMP117 0,0078 C/LSB, takze ta
 * mista nesou skutecne rozliseni, nedopisuji se nuly. Vic uz nema smysl: sum
 * poslednich mV je vetsi nez krok. ⚠️ Strop je `HB_VAL_W` = 100 px pri mono_16
 * (10 px/znak) = **10 znaku**; nejdelsi realny retezec je "-61.2 dBm" (9) a
 * "13.092 V" (8) — dalsi desetinne misto u dBm uz by se do boxu neveslo.
 * `fmt_fixed` umi `decimals` jen 1..3 (jinak utne na cele cislo). */
static const struct {
    uint8_t id; const char *lab; float lo, hi, nom, scale; uint8_t deci;
    const char *unit; uint8_t rf;
} HBAR[HBAR_ROWS] = {
    { SENS_T48,    "STM board",  0.f, 70.f,  -1.f, 1.f,     2, " C",   0 },
    { SENS_CORE_T, "MCU jadro",  0.f, 90.f,  -1.f, 1.f,     2, " C",   0 },
    { SENS_T49,    "OCXO",       0.f, 70.f,  -1.f, 1.f,     2, " C",   0 },
    { SENS_T4A,    "FPGA board", 0.f, 70.f,  -1.f, 1.f,     2, " C",   0 },
    /* ⚠️ `lo`/`hi`/`nom` MUSI byt v ZOBRAZOVANE jednotce (tedy uz po `scale`), ne
     * v syrove hodnote senzoru. Do 2026-08-16 tu byly MILIVOLTY (10800/13200/12000),
     * zatimco `hbar_disp()` prevadi syrovych 13092 mV na 13.092 V -> porovnavaly se
     * volty s milivolty, `bar` vyslo zaporne a clamp ho srazil na 0. Vysledek: bar
     * byl PRAZDNY, ackoli hodnota vpravo (jde pres tentyz `hbar_disp`) byla spravne.
     * REF marker to nechytil, protoze se pocita primo z `nom` — tedy mV proti mV. */
    { SENS_ADS2,   "12V vetev",  10.8f,  13.2f,  12.0f,  0.001f, 3, " V",   0 },
    { SENS_ADS3,   "5V vetev",    4.5f,   5.5f,   5.0f,  0.001f, 3, " V",   0 },
    { SENS_VDDA,   "REF 2V5",     2.3f,   2.7f,   2.5f,  0.001f, 3, " V",   0 },
    { SENS_VBAT,   "VBAT",        2.5f,   3.4f,   3.3f,  0.001f, 3, " V",   0 },   /* CR2032, nominal 3,3 V */
    { SENS_ADS0,   "OCXO Vc",     0.0f,   3.3f,   1.65f, 0.001f, 3, " V",   0 },
    { SENS_ADS1,   "RF level",    -80.f,   10.f,  -100.f, 1.f,     1, " dBm", 1 },  /* nom < lo = zadny REF marker (RF nema ocekavanou hodnotu) */
};
/* Stred radku (y) pro index r (0..3 = karta Teploty, 4..9 = karta Napajeni). */
static int16_t hbar_cy(int r)
{
    return (r < 4) ? (int16_t)(110 + r * 28)          /* 110/138/166/194     */
                   : (int16_t)(266 + (r - 4) * 26);   /* 266..396 (6 radku)  */
}

/* ── Segmentovany horizontalni bar (#47 granularita) ─────────────────────────
 * Stopa je slozena z HB_SEGS malych segmentu; vyplneny usek = AKTUALNI hodnota,
 * plus barevne markery MIN / MAX / REFERENCNI (nominal) prekresli svuj segment
 * -> na prvni pohled aktualni hodnota vs. dosud videny rozsah [min,max] i
 * ocekavana (nominalni) hodnota. Barvy viz legenda (hbar_legend):
 *   AKT = zelena/amber vypln, REF = accent, MIN = violet, MAX = cervena. */
/* Granularita horizontalnich baru — vyvoj 2026-08-12:
 *   45 segmentu: sw = (452 - 44*2)/45 = 8 px, krok 2,22 %   (puvodni)
 *   56 segmentu: sw = (452 - 55*2)/56 = 6 px, krok 1,79 %
 *   64 segmentu: sw = (452 - 63*2)/64 = 5 px, krok 1,56 %   <- ted
 * Geometrie je parametricka (hb_seg si sw dopocita, hb_marker_idx skaluje pct),
 * takze staci menit HB_SEGS. Segmenty zaberou 64*5 + 63*2 = 446 z 452 px; 6 px
 * vpravo zustane nevyuzitych — zamerne se to nedorovnava, aby hb_seg zustalo
 * trivialni (pouziva ho i kresleni markeru).
 *
 * ⚠️ FYZIKALNI STROP: panel ma 8,54 px/mm, takze 5px segment = 0,59 mm. Markery
 * MIN/MAX/REF kresli JEDINY segment — pod ~4 px (0,47 mm) uz je barevny prouzek
 * spatne rozeznatelny. Dalsi zjemneni pri HB_SGAP=2 srazi sw na 4 px; jit vys
 * znamena zmensit i mezeru na 1 px (napr. 75 segmentu = sw 5 px, krok 1,33 %),
 * coz ale setre "LED bar" vzhled -> bar zacne splyvat v plnou listu. */
#define HB_SEGS  64          /* pocet segmentu (452 px / 7 px na segment vc. mezery) */
#define HB_SGAP  2           /* mezera mezi segmenty [px]                            */

/* Prepocet SYROVE hodnoty senzoru (s->last/min/max) na zobrazovanou jednotku. */
static float hbar_disp(int r, float raw)
{
    if (HBAR[r].rf) {   /* AD8307: dBm = mV/slope + intercept */
        float slope = g_calib.ad8307_slope_mv_db; if (slope < 1e-3f) slope = 25.f;
        return raw / slope + g_calib.ad8307_intercept_dbm;
    }
    return raw * HBAR[r].scale;
}
/* Zobrazovana hodnota -> pct (0..100) v rozsahu baru [lo..hi]. */
static int16_t hbar_pct_disp(int r, float disp)
{
    float bar = (disp - HBAR[r].lo) / (HBAR[r].hi - HBAR[r].lo);
    if (bar < 0.f) bar = 0.f; else if (bar > 1.f) bar = 1.f;
    return (int16_t)(bar * 100.f + 0.5f);
}
/* Obdelnik segmentu i uvnitr stopy tr (vyska = stopa bez 1px okraje). */
static prim_rect_t hb_seg(prim_rect_t tr, int16_t i)
{
    int16_t sw = (int16_t)((tr.w - (HB_SEGS - 1) * HB_SGAP) / HB_SEGS);
    if (sw < 1) sw = 1;
    int16_t sx = (int16_t)(tr.x + i * (sw + HB_SGAP));
    return (prim_rect_t){ sx, (int16_t)(tr.y + 1), sw, (int16_t)(tr.h - 2) };
}
/* Segment, ktery kryje danou pct pozici (marker). */
static int16_t hb_marker_idx(int16_t pct)
{
    int16_t i = (int16_t)((int32_t)pct * HB_SEGS / 100);
    if (i >= HB_SEGS) i = (int16_t)(HB_SEGS - 1);
    if (i < 0) i = 0;
    return i;
}

/* Zobrazovana hodnota radku r + odpovidajici bar_pct (0..100). Vraci 1 kdyz
 * jsou platna data (samples>0). RF prepocita mV->dBm z kalibrace. */
static int hbar_value(int r, char *out, size_t n, int16_t *pct_out)
{
    const sensor_stat_t *s = &g_sensors[HBAR[r].id];
    if (!s->samples) { snprintf(out, n, "--"); *pct_out = 0; return 0; }
    float disp = hbar_disp(r, s->last);
    *pct_out = hbar_pct_disp(r, disp);
    char num[16]; fmt_fixed(num, sizeof num, disp, HBAR[r].deci);
    snprintf(out, n, "%s%s", num, HBAR[r].unit);
    return 1;
}

/* Kompaktni legenda barev markeru — ve footeru vpravo od tlacitka "< GRAFY"
 * (kresli se jednou). ⚠️ NELZE vedle nadpisu: window_chrome kresli titulek
 * CENTROVANE (SCREEN_W/2, mono_25) a "PREHLED KANALU" saha az ~x=505 -> kolize. */
static void hbar_legend(void)
{
    struct { const char *t; prim_color_t c; } it[4] = {
        { "AKT", UI_COLOR_OK },     { "REF", UI_COLOR_ACC },
        { "MIN", UI_COLOR_VIOLET }, { "MAX", UI_COLOR_BAD },
    };
    int16_t x = 250;                 /* za tlacitkem GRAFY (18..218), y = stred footeru */
    for (int i = 0; i < 4; i++) {
        prim_fill_rect((prim_rect_t){x, 440, 14, 14}, it[i].c, PRIM_BLEND_OVER);
        prim_draw_text((prim_point_t){(int16_t)(x + 18), 452}, it[i].t,
                       &ui_font_mono_16, UI_COLOR_INK_2, PRIM_ALIGN_LEFT);
        x = (int16_t)(x + 78);
    }
}

/* Prekresli dynamickou cast JEDNOHO radku (track + segmenty + markery + hodnota).
 * Cely radek se nejdriv vycisti (REPLACE) -> mark_dirty pokryje copy-forward. */
static void hbar_row_bar(int r, int16_t pct, int16_t minp, int16_t maxp,
                         int valid, int samples)
{
    int16_t cy = hbar_cy(r);
    /* Vycisti zonu STOPY (label vlevo je staticky, box hodnoty vpravo si cisti
     * `dtext_a` sam) — clear je zaroven ten `mark_dirty`, na ktery se veze
     * copy-forward zaobleni stopy (`aa_corner` jde mimo DMA2D). */
    prim_fill_rect((prim_rect_t){HB_TRACK_X, (int16_t)(cy - 11), HB_TRACK_W, 22},
                   UI_COLOR_BG_CARD, PRIM_BLEND_REPLACE);
    /* Stopa (podklad). */
    prim_rect_t tr = {HB_TRACK_X, (int16_t)(cy - 7), HB_TRACK_W, 14};
    prim_fill_rect_rounded(tr, 3, UI_COLOR_INK_5, PRIM_BLEND_OVER);
    prim_stroke_rect_rounded(tr, 3, 1, UI_COLOR_LINE);
    if (samples) {
        int has_nom = (HBAR[r].nom > HBAR[r].lo);
        int ok = 1;
        if (has_nom) {
            float dev  = (HBAR[r].hi - HBAR[r].lo) * 0.15f;
            float disp = HBAR[r].lo + (HBAR[r].hi - HBAR[r].lo) * pct / 100.f;
            ok = (disp > HBAR[r].nom - dev) && (disp < HBAR[r].nom + dev);
        }
        /* AKTUALNI = vyplneny usek segmentu (zelena/amber dle odchylky). */
        prim_color_t base = valid ? (ok ? UI_COLOR_OK : UI_COLOR_WARN) : UI_COLOR_INK_4;
        int16_t lit = (int16_t)(((int32_t)pct * HB_SEGS + 50) / 100);
        for (int16_t i = 0; i < lit; i++)
            prim_fill_rect(hb_seg(tr, i), base, PRIM_BLEND_OVER);
        /* Markery kresli PRES vypln (at jsou videt i uvnitr zelene): */
        prim_fill_rect(hb_seg(tr, hb_marker_idx(minp)), UI_COLOR_VIOLET, PRIM_BLEND_OVER); /* MIN */
        prim_fill_rect(hb_seg(tr, hb_marker_idx(maxp)), UI_COLOR_BAD,    PRIM_BLEND_OVER); /* MAX */
        if (has_nom) {                                                  /* REFERENCNI (nominal) */
            int16_t refp = hbar_pct_disp(r, HBAR[r].nom);
            prim_fill_rect(hb_seg(tr, hb_marker_idx(refp)), UI_COLOR_ACC, PRIM_BLEND_OVER);
        }
    }
}

/* Hodnota vpravo (vlastni box-clear) — oddelena od stopy, protoze se meni
 * MNOHEM casteji: pri 3 desetinach preblikne kazdy mV sumu, zatimco bar se
 * hne az pri ~1 % rozsahu (u 12V vetve 24 mV). Kdyby oboji kreslil jeden
 * `hbar_row_draw` jako do 2026-08-16, prekresloval by se pri kazdem tiku
 * cely radek vcetne 64 segmentu — pri 2 Hz a peti napetovych radcich zbytecne. */
static void hbar_row_val(int r, int valid, int samples, const char *val)
{
    dtext_a(HB_VAL_XR, (int16_t)(hbar_cy(r) + 6), HB_VAL_W, val,
            samples ? (valid ? UI_COLOR_INK : UI_COLOR_INK_3) : UI_COLOR_INK_4,
            &ui_font_mono_16, DTEXT_RIGHT);
}

static void app_gpsdo_render_hbars(void)
{
    static int16_t  s_pct[HBAR_ROWS], s_minp[HBAR_ROWS], s_maxp[HBAR_ROWS];
    static char     s_val[HBAR_ROWS][16];
    static uint8_t  s_valid[HBAR_ROWS];
    int first = window_first(30);
    if (first) {
        s_view = 30;
        window_chrome("PREHLED KANALU", WIN_TITLE_Y);
        hbar_legend();
        ui_card_t ct = {.rect = HB_CARD_T, .header_label = "Teploty [C]"};
        ui_card_render_chrome(&ct);
        ui_card_t cv = {.rect = HB_CARD_V, .header_label = "Napajeni + RF"};
        ui_card_render_chrome(&cv);
        /* Staticke labely radku (kresli se jednou; dynamicka cast je vpravo). */
        for (int r = 0; r < HBAR_ROWS; r++)
            prim_draw_text((prim_point_t){HB_LBL_X, (int16_t)(hbar_cy(r) + 6)},
                           HBAR[r].lab, &ui_font_mono_16, UI_COLOR_INK_2, PRIM_ALIGN_LEFT);
        /* Prepinac zpet na GRAFY (sesterske okno). */
        ui_button_t gb = {.rect = HBARS_GRAF_BTN, .variant = UI_BUTTON_NORMAL,
                          .label = "< GRAFY"};
        ui_button_render(&gb);
    }
    /* Per-radek zmena: prekresli jen radky, kde se zmenilo pct/min/max nebo text. */
    int drew = first;
    for (int r = 0; r < HBAR_ROWS; r++) {
        char val[16]; int16_t pct;
        const sensor_stat_t *s = &g_sensors[HBAR[r].id];
        int valid = s->valid;
        hbar_value(r, val, sizeof val, &pct);
        int16_t minp = s->samples ? hbar_pct_disp(r, hbar_disp(r, s->min)) : 0;
        int16_t maxp = s->samples ? hbar_pct_disp(r, hbar_disp(r, s->max)) : 0;
        /* ⚠️ `valid` MUSI byt v obou klicich: pri vypadku senzoru drzi `last`
         * posledni dobrou hodnotu, takze se pct ani text NEZMENI — bez tohohle
         * by radek zustal zeleny a vypadek by nebyl videt (chyba do 2026-08-16). */
        int vchg = first || (uint8_t)valid != s_valid[r];
        if (vchg || pct != s_pct[r] || minp != s_minp[r] || maxp != s_maxp[r]) {
            s_pct[r] = pct; s_minp[r] = minp; s_maxp[r] = maxp;
            hbar_row_bar(r, pct, minp, maxp, valid, s->samples);
            drew = 1;
        }
        if (vchg || strcmp(val, s_val[r]) != 0) {
            snprintf(s_val[r], sizeof s_val[r], "%s", val);
            hbar_row_val(r, valid, s->samples, val);
            drew = 1;
        }
        s_valid[r] = (uint8_t)valid;
    }
    if (drew) present_now();
}

/* ── Okno MATH / LIMITY (s_view=31, #43 Math Mx+B + #44 limit pass/fail) ──────
 * Aplikuje na mereny kmitocet (screen_main_freq_hz — DNES SIMULACE, po #2 realny)
 * transformaci Y = M*X + B (+ relativni NULL) a limitni pass/fail test. Konfigurace
 * v g_meas_cfg (meas_math.h); prubezne vyhodnoceni + alarm bezi i mimo okno
 * (app_gpsdo_tick_stats_sample -> g_meas_verdict -> alarm.c). Vstup: dlazdice
 * "Math/Limity" v Menu. */
static const double MATH_M_PRESETS[]    = {0.5, 1.0, 2.0, 10.0, 100.0};
#define MATH_M_N ((int)(sizeof(MATH_M_PRESETS)/sizeof(MATH_M_PRESETS[0])))
static const double MATH_BAND_PRESETS[] = {0.001, 0.01, 0.1, 1.0, 10.0};
#define MATH_BAND_N ((int)(sizeof(MATH_BAND_PRESETS)/sizeof(MATH_BAND_PRESETS[0])))
#define MATH_B_STEP 1.0                 /* krok offsetu B [Hz] na tap */
static int s_math_m_idx  = 1;           /* ×1.0 */
static int s_math_band_idx = 3;         /* ±1 Hz */

/* Rozvrzeni (dve karty). ⚠️ Tlacitka h=64 (7,5 mm) — projektovy standard dotyk.
 * cile z TODO #11 (56 px = 6,6 mm bylo pod hranici 7 mm). */
static const prim_rect_t MATH_CARD_A = {18, 58,  764, 182};   /* Vypocet Y=M*X+B  */
static const prim_rect_t MATH_CARD_B = {18, 246, 764, 166};   /* Limity pass/fail */
#define MATH_LBL_X    40
#define MATH_VAL_XR   760              /* prava hrana boxu X/Y hodnoty */
#define MATH_VAL_W    420
#define MATH_X_BASE   120
#define MATH_Y_BASE   152
/* Tlacitka karty A (rada, y=170 h=64 -> 170..234, karta konci 240). */
static const prim_rect_t MATH_BTN_MATH = {30, 170, 150, 64};
static const prim_rect_t MATH_BTN_M    = {192, 170, 120, 64};
static const prim_rect_t MATH_BTN_BM   = {324, 170, 64, 64};   /* B - */
static const prim_rect_t MATH_BOX_B    = {392, 170, 84, 64};   /* hodnota B */
static const prim_rect_t MATH_BTN_BP   = {480, 170, 64, 64};   /* B + */
static const prim_rect_t MATH_BTN_NULL = {556, 170, 204, 64};
/* Karta B (badge nahore, tlacitka y=346 h=64 -> 346..410, karta konci 412). */
static const prim_rect_t MATH_BADGE    = {30, 288, 190, 54};   /* verdikt PASS/FAIL */
static const prim_rect_t MATH_BTN_LIM  = {30, 346, 160, 64};
static const prim_rect_t MATH_BTN_BANDM= {200, 346, 120, 64};  /* pasmo - */
static const prim_rect_t MATH_BTN_BANDP= {330, 346, 120, 64};  /* pasmo + */
static const prim_rect_t MATH_BTN_ALRM = {460, 346, 200, 64};

/* Kmitocet [Hz] -> "10000000.00000 Hz" (bez %f — nano.specs; integer extrakce,
 * 5 desetin jako headline). Zaporne (po NULL) se znamenkem. */
static void fmt_hz(double v, char *out, size_t n)
{
    const char *sgn = (v < 0.0) ? "-" : "";
    double a = (v < 0.0) ? -v : v;
    if (a >= 4.2e9) { snprintf(out, n, "%s>4G Hz", sgn); return; }   /* uint32 strop */
    uint32_t whole = (uint32_t)a;
    uint32_t frac  = (uint32_t)((a - (double)whole) * 100000.0 + 0.5);
    if (frac >= 100000u) { whole++; frac -= 100000u; }
    snprintf(out, n, "%s%lu.%05lu Hz", sgn, (unsigned long)whole, (unsigned long)frac);
}

/* Dopocita UI preset indexy (M, pasmo) z g_meas_cfg — po nacteni z flash
 * (syscfg) drzi cfg hodnoty, ale indexy jsou app-lokalni. M je v cfg presne
 * (round-trip pres flash zachova bit-vzor), pasmo = (hi-lo)/2 s tolerance. */
static void math_sync_idx(void)
{
    s_math_m_idx = 1;                                   /* fallback x1.0 */
    for (int i = 0; i < MATH_M_N; i++)
        if (MATH_M_PRESETS[i] == g_meas_cfg.m) { s_math_m_idx = i; break; }
    double band = (g_meas_cfg.hi - g_meas_cfg.lo) * 0.5;
    for (int i = 0; i < MATH_BAND_N; i++) {
        double d = band - MATH_BAND_PRESETS[i]; if (d < 0) d = -d;
        if (d < MATH_BAND_PRESETS[i] * 0.01) { s_math_band_idx = i; break; }
    }
}

/* Pri zapnutych limitech nastavi meze = aktualni Y ± pasmo (bench "null then band"). */
static void math_recenter_limits(void)
{
    double y = meas_math_apply(&g_meas_cfg, screen_main_freq_hz());
    double band = MATH_BAND_PRESETS[s_math_band_idx];
    g_meas_cfg.lo = y - band;
    g_meas_cfg.hi = y + band;
}

/* Verdikt badge (zive — barva dle stavu). */
static void math_draw_badge(meas_verdict_t v)
{
    const char *t; prim_color_t bg;
    switch (v) {
    case MEAS_PASS: t = "PASS";    bg = UI_COLOR_OK;    break;
    case MEAS_LO:   t = "FAIL LO"; bg = UI_COLOR_BAD;   break;
    case MEAS_HI:   t = "FAIL HI"; bg = UI_COLOR_BAD;   break;
    default:        t = "---";     bg = UI_COLOR_INK_5; break;   /* limity vypnute */
    }
    prim_fill_rect(MATH_BADGE, UI_COLOR_BG_CARD, PRIM_BLEND_REPLACE);
    prim_fill_rect_rounded(MATH_BADGE, 8, bg, PRIM_BLEND_OVER);
    prim_draw_text((prim_point_t){(int16_t)(MATH_BADGE.x + MATH_BADGE.w / 2),
                   (int16_t)(MATH_BADGE.y + MATH_BADGE.h / 2 + 8)},
                   t, &ui_font_mono_22, UI_COLOR_BG_0, PRIM_ALIGN_CENTER);
}

/* Staticke prvky (karty + labely + poznamka) — jen pri prvnim vstupu. */
static void math_render_static(void)
{
    ui_card_t ca = {.rect = MATH_CARD_A, .header_label = "Vypocet   Y = M * X + B"};
    ui_card_render_chrome(&ca);
    ui_card_t cb = {.rect = MATH_CARD_B, .header_label = "Limity   (PASS / FAIL)"};
    ui_card_render_chrome(&cb);
    prim_draw_text((prim_point_t){MATH_LBL_X, MATH_X_BASE}, "X (mereno)",
                   &ui_font_mono_18, UI_COLOR_INK_3, PRIM_ALIGN_LEFT);
    prim_draw_text((prim_point_t){MATH_LBL_X, MATH_Y_BASE}, "Y (vysledek)",
                   &ui_font_mono_18, UI_COLOR_INK_3, PRIM_ALIGN_LEFT);
    prim_draw_text((prim_point_t){30, 462},
                   "Aplikuje se na mereny kmitocet (dnes simulace, viz #2).",
                   &ui_font_sans_16, UI_COLOR_INK_4, PRIM_ALIGN_LEFT);
}

/* Ovladace + Lo/Hi/pasmo text (stavove — pri vstupu a po kazdem tapu). */
static void math_render_controls(void)
{
    prim_fill_rect((prim_rect_t){26, 166, 748, 72},  UI_COLOR_BG_CARD, PRIM_BLEND_REPLACE);
    prim_fill_rect((prim_rect_t){26, 284, 748, 128}, UI_COLOR_BG_CARD, PRIM_BLEND_REPLACE);

    /* Karta A: MATH / M / B-/B+/ NULL. */
    ui_button_t bm = {.rect = MATH_BTN_MATH,
                      .variant = g_meas_cfg.math_en ? UI_BUTTON_RUN : UI_BUTTON_NORMAL,
                      .label = g_meas_cfg.math_en ? "MATH ZAP" : "MATH VYP"};
    ui_button_render(&bm);
    char mb[16]; fmt_fixed(mb, sizeof mb, g_meas_cfg.m, 1);
    char ml[20]; snprintf(ml, sizeof ml, "M x%s", mb);
    ui_button_t bM = {.rect = MATH_BTN_M, .variant = UI_BUTTON_NORMAL, .label = ml};
    ui_button_render(&bM);
    ui_button_t bBm = {.rect = MATH_BTN_BM, .variant = UI_BUTTON_NORMAL, .label = "B -"};
    ui_button_t bBp = {.rect = MATH_BTN_BP, .variant = UI_BUTTON_NORMAL, .label = "B +"};
    ui_button_render(&bBm); ui_button_render(&bBp);
    prim_fill_rect_rounded(MATH_BOX_B, 6, UI_COLOR_BG_0, PRIM_BLEND_OVER);
    { char bv[16]; double b = g_meas_cfg.b; fmt_fixed(bv, sizeof bv, b < 0 ? -b : b, 1);
      char bt[20]; snprintf(bt, sizeof bt, "%s%s", b < 0 ? "-" : "+", bv);
      prim_draw_text((prim_point_t){(int16_t)(MATH_BOX_B.x + MATH_BOX_B.w / 2), 208},
                     bt, &ui_font_mono_16, UI_COLOR_INK, PRIM_ALIGN_CENTER); }
    ui_button_t bN = {.rect = MATH_BTN_NULL,
                      .variant = g_meas_cfg.null_en ? UI_BUTTON_ACTIVE : UI_BUTTON_NORMAL,
                      .label = g_meas_cfg.null_en ? "NULL ZAP" : "NULL"};
    ui_button_render(&bN);

    /* Karta B: Lo/Hi + pasmo text. */
    char tmp[28], line[40];
    fmt_hz(g_meas_cfg.lo, tmp, sizeof tmp); snprintf(line, sizeof line, "Lo  %s", tmp);
    prim_draw_text((prim_point_t){240, 308}, line, &ui_font_mono_16, UI_COLOR_INK_2, PRIM_ALIGN_LEFT);
    fmt_hz(g_meas_cfg.hi, tmp, sizeof tmp); snprintf(line, sizeof line, "Hi  %s", tmp);
    prim_draw_text((prim_point_t){240, 336}, line, &ui_font_mono_16, UI_COLOR_INK_2, PRIM_ALIGN_LEFT);
    fmt_hz(MATH_BAND_PRESETS[s_math_band_idx], tmp, sizeof tmp);
    snprintf(line, sizeof line, "Pasmo +/- %s", tmp);
    prim_draw_text((prim_point_t){560, 308}, line, &ui_font_mono_16, UI_COLOR_INK_3, PRIM_ALIGN_LEFT);

    ui_button_t bL = {.rect = MATH_BTN_LIM,
                      .variant = g_meas_cfg.limit_en ? UI_BUTTON_RUN : UI_BUTTON_NORMAL,
                      .label = g_meas_cfg.limit_en ? "LIMITY ZAP" : "LIMITY VYP"};
    ui_button_render(&bL);
    ui_button_t bpm = {.rect = MATH_BTN_BANDM, .variant = UI_BUTTON_NORMAL, .label = "PASMO -"};
    ui_button_t bpp = {.rect = MATH_BTN_BANDP, .variant = UI_BUTTON_NORMAL, .label = "PASMO +"};
    ui_button_render(&bpm); ui_button_render(&bpp);
    ui_button_t bA = {.rect = MATH_BTN_ALRM,
                      .variant = g_meas_cfg.alarm_en ? UI_BUTTON_RUN : UI_BUTTON_NORMAL,
                      .label = g_meas_cfg.alarm_en ? "ALARM ZAP" : "ALARM VYP"};
    ui_button_render(&bA);
}

/* Zive: X, Y, verdikt badge, pocet FAIL (change-detect). */
static int math_render_live(int force)
{
    static char cX[28], cY[28], cV[24];
    double x = screen_main_freq_hz();
    double y = meas_math_apply(&g_meas_cfg, x);
    char bx[28], by[28];
    fmt_hz(x, bx, sizeof bx);
    fmt_hz(y, by, sizeof by);
    int drew = force;
    if (force || dchg(cX, sizeof cX, bx)) {
        dtext_a(MATH_VAL_XR, MATH_X_BASE, MATH_VAL_W, bx, UI_COLOR_INK, &ui_font_mono_18, DTEXT_RIGHT);
        drew = 1;
    }
    if (force || dchg(cY, sizeof cY, by)) {
        dtext_a(MATH_VAL_XR, MATH_Y_BASE, MATH_VAL_W, by, UI_COLOR_ACC, &ui_font_mono_18, DTEXT_RIGHT);
        drew = 1;
    }
    meas_verdict_t v = meas_limit_eval(&g_meas_cfg, y);
    char vb[24]; snprintf(vb, sizeof vb, "%d %u", (int)v, g_alarm_limit_fail);
    if (force || dchg(cV, sizeof cV, vb)) {
        math_draw_badge(v);
        char fc[20]; snprintf(fc, sizeof fc, "FAIL: %u", g_alarm_limit_fail);
        dtext_a(560, 336, 200, fc, UI_COLOR_INK_2, &ui_font_mono_16, DTEXT_LEFT);
        drew = 1;
    }
    return drew;
}

static void app_gpsdo_render_math(void)
{
    int first = window_first(31);
    if (first) {
        s_view = 31;
        math_sync_idx();                 /* preset indexy z (nactene) g_meas_cfg */
        window_chrome("MATH / LIMITY", WIN_TITLE_Y);
        math_render_static();
        math_render_controls();
    }
    if (math_render_live(first)) present_now();
}
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
