ok2haz/Frequency_Counter_FPGA/Frequency_Counter_STM32H757/CM7/Core/Src/fmc.c

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

/* Includes ------------------------------------------------------------------*/
#include "fmc.h"

/* USER CODE BEGIN 0 */
#include "bootled.h"
static FMC_SDRAM_CommandTypeDef Command;
/* ⚠️⚠️ PODEZRELA HODNOTA — NEOVERENO, NEMENIT BEZ MERENI (2026-08-23).
 * 1835 je prevzata z ST prikladu pro jinou desku. Prepocet pro TUHLE:
 *   PLL2 VCO 200 MHz / R=2 -> FMC kernel 100 MHz, SDClockPeriod_2 -> SDCLK 50 MHz.
 *   REFRESH_COUNT = tREF * SDCLK / pocet_radku - 20.
 *   Pro 8192 radku (RowBitsNumber = 13, viz nize) a bezne tREF = 64 ms vychazi
 *   **371**, nikoli 1835. S 1835 se cela matice obnovi az za ~304 ms, tj.
 *   **4,7x pomaleji nez 64 ms**, coz je mimo spec bezne SDRAM.
 * Proc to zatim NEJDE poznat: framebuffery se prepisuji kazdy snimek a LTDC je
 * navic porad cte (cteni radek taky obnovi), takze displej funguje. Projevit by
 * se to melo az na datech, ktera lezi dlouho nedotcena — presne to meri retencni
 * test v `membench.c` (UART `membench`, radek „retence po 1 s").
 * ⚠️ ZMERENO 2026-08-23: retence po 1 s = **0 chybnych bitu**, takze obsah se
 * nerozpada a tahle hodnota (at uz je „spravna" jakkoli) NENI pricinou chyb, ktere
 * benchmark nasel — ty jsou z prekryvu adres (viz CLAUDE.md, podezreni na FMC_A9).
 * Necham tedy 1835 beze zmeny; prepocet vyse zustava jako otevrena otazka k overeni
 * proti datasheetu osazene SDRAM, ne jako znamy bug.
 * ⚠️ 1835 by naopak zhruba sedelo pro 4096 radku — pokud je osazeny cip 4096-radkovy,
 * je spatne `RowBitsNumber`, ne tohle. Rozhodne to az datasheet osazene SDRAM. */
#define REFRESH_COUNT        1835

#define SDRAM_TIMEOUT                            ((uint32_t)0xFFFF)
#define SDRAM_MODEREG_BURST_LENGTH_1             ((uint16_t)0x0000)
#define SDRAM_MODEREG_BURST_LENGTH_2             ((uint16_t)0x0001)
#define SDRAM_MODEREG_BURST_LENGTH_4             ((uint16_t)0x0002)
#define SDRAM_MODEREG_BURST_LENGTH_8             ((uint16_t)0x0004)
#define SDRAM_MODEREG_BURST_TYPE_SEQUENTIAL      ((uint16_t)0x0000)
#define SDRAM_MODEREG_BURST_TYPE_INTERLEAVED     ((uint16_t)0x0008)
#define SDRAM_MODEREG_CAS_LATENCY_2              ((uint16_t)0x0020)
#define SDRAM_MODEREG_CAS_LATENCY_3              ((uint16_t)0x0030)
#define SDRAM_MODEREG_OPERATING_MODE_STANDARD    ((uint16_t)0x0000)
#define SDRAM_MODEREG_WRITEBURST_MODE_PROGRAMMED ((uint16_t)0x0000)
#define SDRAM_MODEREG_WRITEBURST_MODE_SINGLE     ((uint16_t)0x0200)
/* USER CODE END 0 */

SDRAM_HandleTypeDef hsdram1;

/* FMC initialization function */
void MX_FMC_Init(void)
{
  /* USER CODE BEGIN FMC_Init 0 */
  bootled_step(BOOTLED_STEP_FMC);
  /* USER CODE END FMC_Init 0 */

  FMC_SDRAM_TimingTypeDef SdramTiming = {0};

  /** Perform the SDRAM1 memory initialization sequence
  */
  hsdram1.Instance = FMC_SDRAM_DEVICE;
  /* hsdram1.Init */
  hsdram1.Init.SDBank = FMC_SDRAM_BANK1;
  hsdram1.Init.ColumnBitsNumber = FMC_SDRAM_COLUMN_BITS_NUM_9;
  hsdram1.Init.RowBitsNumber = FMC_SDRAM_ROW_BITS_NUM_13;
  hsdram1.Init.MemoryDataWidth = FMC_SDRAM_MEM_BUS_WIDTH_16;
  hsdram1.Init.InternalBankNumber = FMC_SDRAM_INTERN_BANKS_NUM_4;
  hsdram1.Init.CASLatency = FMC_SDRAM_CAS_LATENCY_3;
  hsdram1.Init.WriteProtection = FMC_SDRAM_WRITE_PROTECTION_DISABLE;
  hsdram1.Init.SDClockPeriod = FMC_SDRAM_CLOCK_PERIOD_2;
  hsdram1.Init.ReadBurst = FMC_SDRAM_RBURST_ENABLE;
  hsdram1.Init.ReadPipeDelay = FMC_SDRAM_RPIPE_DELAY_0;
  /* SdramTiming */
  SdramTiming.LoadToActiveDelay = 2;
  SdramTiming.ExitSelfRefreshDelay = 7;
  SdramTiming.SelfRefreshTime = 4;
  SdramTiming.RowCycleDelay = 7;
  SdramTiming.WriteRecoveryTime = 3;
  SdramTiming.RPDelay = 2;
  SdramTiming.RCDDelay = 2;

  if (HAL_SDRAM_Init(&hsdram1, &SdramTiming) != HAL_OK)
  {
    Error_Handler( );
  }

  /* USER CODE BEGIN FMC_Init 2 */
  __IO uint32_t tmpmrd = 0;

    /* Step 1: Configure a clock configuration enable command */
    Command.CommandMode            = FMC_SDRAM_CMD_CLK_ENABLE;
    Command.CommandTarget          =  FMC_SDRAM_CMD_TARGET_BANK1;
    Command.AutoRefreshNumber      = 1;
    Command.ModeRegisterDefinition = 0;

    /* Send the command */
    HAL_SDRAM_SendCommand(&hsdram1, &Command, SDRAM_TIMEOUT);

    /* Step 2: Insert 100 us minimum delay */
    /* Inserted delay is equal to 1 ms due to systick time base unit (ms) */
    HAL_Delay(1);

    /* Step 3: Configure a PALL (precharge all) command */
    Command.CommandMode            = FMC_SDRAM_CMD_PALL;
    Command.CommandTarget          = FMC_SDRAM_CMD_TARGET_BANK1;
    Command.AutoRefreshNumber      = 1;
    Command.ModeRegisterDefinition = 0;

    /* Send the command */
    HAL_SDRAM_SendCommand(&hsdram1, &Command, SDRAM_TIMEOUT);

    /* Step 4: Configure an Auto Refresh command */
    Command.CommandMode            = FMC_SDRAM_CMD_AUTOREFRESH_MODE;
    Command.CommandTarget          = FMC_SDRAM_CMD_TARGET_BANK1;
    Command.AutoRefreshNumber      = 8;
    Command.ModeRegisterDefinition = 0;

    /* Send the command */
    HAL_SDRAM_SendCommand(&hsdram1, &Command, SDRAM_TIMEOUT);

    /* Step 5: Program the external memory mode register */
    tmpmrd = (uint32_t)SDRAM_MODEREG_BURST_LENGTH_1 | \
             SDRAM_MODEREG_BURST_TYPE_SEQUENTIAL    | \
             SDRAM_MODEREG_CAS_LATENCY_3            | \
             SDRAM_MODEREG_OPERATING_MODE_STANDARD  | \
             SDRAM_MODEREG_WRITEBURST_MODE_SINGLE;

    Command.CommandMode            = FMC_SDRAM_CMD_LOAD_MODE;
    Command.CommandTarget          = FMC_SDRAM_CMD_TARGET_BANK1;
    Command.AutoRefreshNumber      = 1;
    Command.ModeRegisterDefinition = tmpmrd;

    /* Send the command */
    HAL_SDRAM_SendCommand(&hsdram1, &Command, SDRAM_TIMEOUT);

    /* Step 6: Set the refresh rate counter */
    /* Set the device refresh rate */
    HAL_SDRAM_ProgramRefreshRate(&hsdram1, REFRESH_COUNT);

    //Deactivate speculative/cache access to first FMC Bank to save FMC bandwidth
//   FMC_Bank1->BTCR[0] = 0x000030D2;
    HAL_GPIO_WritePin(LED_1_GPIO_Port, LED_1_Pin, GPIO_PIN_RESET);
    HAL_Delay(200);
    HAL_GPIO_WritePin(LED_1_GPIO_Port, LED_1_Pin, GPIO_PIN_SET);
  /* USER CODE END FMC_Init 2 */
}

static uint32_t FMC_Initialized = 0;

static void HAL_FMC_MspInit(void){
  GPIO_InitTypeDef GPIO_InitStruct = {0};
  if (FMC_Initialized) {
    return;
  }
  FMC_Initialized = 1;

  /* Peripheral clock enable */
  __HAL_RCC_FMC_CLK_ENABLE();

  /** FMC GPIO Configuration
  PF0   ------> FMC_A0
  PF1   ------> FMC_A1
  PF2   ------> FMC_A2
  PF3   ------> FMC_A3
  PF4   ------> FMC_A4
  PF5   ------> FMC_A5
  PC0   ------> FMC_SDNWE
  PH2   ------> FMC_SDCKE0
  PH3   ------> FMC_SDNE0
  PF11   ------> FMC_SDNRAS
  PF12   ------> FMC_A6
  PF13   ------> FMC_A7
  PF14   ------> FMC_A8
  PF15   ------> FMC_A9
  PG0   ------> FMC_A10
  PG1   ------> FMC_A11
  PE7   ------> FMC_D4
  PE8   ------> FMC_D5
  PE9   ------> FMC_D6
  PE10   ------> FMC_D7
  PE11   ------> FMC_D8
  PE12   ------> FMC_D9
  PE13   ------> FMC_D10
  PE14   ------> FMC_D11
  PE15   ------> FMC_D12
  PD8   ------> FMC_D13
  PD9   ------> FMC_D14
  PD10   ------> FMC_D15
  PD14   ------> FMC_D0
  PD15   ------> FMC_D1
  PG2   ------> FMC_A12
  PG4   ------> FMC_BA0
  PG5   ------> FMC_BA1
  PG8   ------> FMC_SDCLK
  PD0   ------> FMC_D2
  PD1   ------> FMC_D3
  PG15   ------> FMC_SDNCAS
  PE0   ------> FMC_NBL0
  PE1   ------> FMC_NBL1
  */
  /* GPIO_InitStruct */
  GPIO_InitStruct.Pin = GPIO_PIN_0|GPIO_PIN_1|GPIO_PIN_2|GPIO_PIN_3
                          |GPIO_PIN_4|GPIO_PIN_5|GPIO_PIN_11|GPIO_PIN_12
                          |GPIO_PIN_13|GPIO_PIN_14|GPIO_PIN_15;
  GPIO_InitStruct.Mode = GPIO_MODE_AF_PP;
  GPIO_InitStruct.Pull = GPIO_NOPULL;
  GPIO_InitStruct.Speed = GPIO_SPEED_FREQ_VERY_HIGH;
  GPIO_InitStruct.Alternate = GPIO_AF12_FMC;

  HAL_GPIO_Init(GPIOF, &GPIO_InitStruct);

  /* GPIO_InitStruct */
  GPIO_InitStruct.Pin = GPIO_PIN_0;
  GPIO_InitStruct.Mode = GPIO_MODE_AF_PP;
  GPIO_InitStruct.Pull = GPIO_NOPULL;
  GPIO_InitStruct.Speed = GPIO_SPEED_FREQ_VERY_HIGH;
  GPIO_InitStruct.Alternate = GPIO_AF12_FMC;

  HAL_GPIO_Init(GPIOC, &GPIO_InitStruct);

  /* GPIO_InitStruct */
  GPIO_InitStruct.Pin = GPIO_PIN_2|GPIO_PIN_3;
  GPIO_InitStruct.Mode = GPIO_MODE_AF_PP;
  GPIO_InitStruct.Pull = GPIO_NOPULL;
  GPIO_InitStruct.Speed = GPIO_SPEED_FREQ_VERY_HIGH;
  GPIO_InitStruct.Alternate = GPIO_AF12_FMC;

  HAL_GPIO_Init(GPIOH, &GPIO_InitStruct);

  /* GPIO_InitStruct */
  GPIO_InitStruct.Pin = GPIO_PIN_0|GPIO_PIN_1|GPIO_PIN_2|GPIO_PIN_4
                          |GPIO_PIN_5|GPIO_PIN_8|GPIO_PIN_15;
  GPIO_InitStruct.Mode = GPIO_MODE_AF_PP;
  GPIO_InitStruct.Pull = GPIO_NOPULL;
  GPIO_InitStruct.Speed = GPIO_SPEED_FREQ_VERY_HIGH;
  GPIO_InitStruct.Alternate = GPIO_AF12_FMC;

  HAL_GPIO_Init(GPIOG, &GPIO_InitStruct);

  /* GPIO_InitStruct */
  GPIO_InitStruct.Pin = GPIO_PIN_7|GPIO_PIN_8|GPIO_PIN_9|GPIO_PIN_10
                          |GPIO_PIN_11|GPIO_PIN_12|GPIO_PIN_13|GPIO_PIN_14
                          |GPIO_PIN_15|GPIO_PIN_0|GPIO_PIN_1;
  GPIO_InitStruct.Mode = GPIO_MODE_AF_PP;
  GPIO_InitStruct.Pull = GPIO_NOPULL;
  GPIO_InitStruct.Speed = GPIO_SPEED_FREQ_VERY_HIGH;
  GPIO_InitStruct.Alternate = GPIO_AF12_FMC;

  HAL_GPIO_Init(GPIOE, &GPIO_InitStruct);

  /* GPIO_InitStruct */
  GPIO_InitStruct.Pin = GPIO_PIN_8|GPIO_PIN_9|GPIO_PIN_10|GPIO_PIN_14
                          |GPIO_PIN_15|GPIO_PIN_0|GPIO_PIN_1;
  GPIO_InitStruct.Mode = GPIO_MODE_AF_PP;
  GPIO_InitStruct.Pull = GPIO_NOPULL;
  GPIO_InitStruct.Speed = GPIO_SPEED_FREQ_VERY_HIGH;
  GPIO_InitStruct.Alternate = GPIO_AF12_FMC;

  HAL_GPIO_Init(GPIOD, &GPIO_InitStruct);

}

void HAL_SDRAM_MspInit(SDRAM_HandleTypeDef* sdramHandle){
  HAL_FMC_MspInit();
}

static uint32_t FMC_DeInitialized = 0;

static void HAL_FMC_MspDeInit(void){
  if (FMC_DeInitialized) {
    return;
  }
  FMC_DeInitialized = 1;
  /* Peripheral clock enable */
  __HAL_RCC_FMC_CLK_DISABLE();

  /** FMC GPIO Configuration
  PF0   ------> FMC_A0
  PF1   ------> FMC_A1
  PF2   ------> FMC_A2
  PF3   ------> FMC_A3
  PF4   ------> FMC_A4
  PF5   ------> FMC_A5
  PC0   ------> FMC_SDNWE
  PH2   ------> FMC_SDCKE0
  PH3   ------> FMC_SDNE0
  PF11   ------> FMC_SDNRAS
  PF12   ------> FMC_A6
  PF13   ------> FMC_A7
  PF14   ------> FMC_A8
  PF15   ------> FMC_A9
  PG0   ------> FMC_A10
  PG1   ------> FMC_A11
  PE7   ------> FMC_D4
  PE8   ------> FMC_D5
  PE9   ------> FMC_D6
  PE10   ------> FMC_D7
  PE11   ------> FMC_D8
  PE12   ------> FMC_D9
  PE13   ------> FMC_D10
  PE14   ------> FMC_D11
  PE15   ------> FMC_D12
  PD8   ------> FMC_D13
  PD9   ------> FMC_D14
  PD10   ------> FMC_D15
  PD14   ------> FMC_D0
  PD15   ------> FMC_D1
  PG2   ------> FMC_A12
  PG4   ------> FMC_BA0
  PG5   ------> FMC_BA1
  PG8   ------> FMC_SDCLK
  PD0   ------> FMC_D2
  PD1   ------> FMC_D3
  PG15   ------> FMC_SDNCAS
  PE0   ------> FMC_NBL0
  PE1   ------> FMC_NBL1
  */

  HAL_GPIO_DeInit(GPIOF, GPIO_PIN_0|GPIO_PIN_1|GPIO_PIN_2|GPIO_PIN_3
                          |GPIO_PIN_4|GPIO_PIN_5|GPIO_PIN_11|GPIO_PIN_12
                          |GPIO_PIN_13|GPIO_PIN_14|GPIO_PIN_15);

  HAL_GPIO_DeInit(GPIOC, GPIO_PIN_0);

  HAL_GPIO_DeInit(GPIOH, GPIO_PIN_2|GPIO_PIN_3);

  HAL_GPIO_DeInit(GPIOG, GPIO_PIN_0|GPIO_PIN_1|GPIO_PIN_2|GPIO_PIN_4
                          |GPIO_PIN_5|GPIO_PIN_8|GPIO_PIN_15);

  HAL_GPIO_DeInit(GPIOE, GPIO_PIN_7|GPIO_PIN_8|GPIO_PIN_9|GPIO_PIN_10
                          |GPIO_PIN_11|GPIO_PIN_12|GPIO_PIN_13|GPIO_PIN_14
                          |GPIO_PIN_15|GPIO_PIN_0|GPIO_PIN_1);

  HAL_GPIO_DeInit(GPIOD, GPIO_PIN_8|GPIO_PIN_9|GPIO_PIN_10|GPIO_PIN_14
                          |GPIO_PIN_15|GPIO_PIN_0|GPIO_PIN_1);

}

void HAL_SDRAM_MspDeInit(SDRAM_HandleTypeDef* sdramHandle){
  HAL_FMC_MspDeInit();
}
/**
  * @}
  */

/**
  * @}
  */
