ok2haz/Frequency_Counter_FPGA/(commit log)

2025-11-22 Initial import
    [Counter_input_module_1-B_Cu.gbr, Counter_input_module_1-B_Mask.gbr, Counter_input_module_1-B_Silkscreen.gbr, Counter_input_module_1-Edge_Cuts.gbr, Counter_input_module_1-F_Cu.gbr, Counter_input_module_1-F_Mask.gbr, Counter_input_module_1-F_Silkscreen.gbr, Counter_input_module_1-NPTH.drl]
2026-06-19 Create STM32H757_FWs
2026-06-19 Upload STM32H757 project
2026-06-19 Move STM32H757 project into subdirectory
2026-06-19 Úklid projektu: git hygiena, mrtvý kód, rozdělení freertos.c
    Git hygiena:
    - přidán kořenový .gitignore (Debug/Release, vendored Node, build artefakty)
    - odebráno ze sledování 2948 souborů (zůstávají na disku)
    Mrtvý kód:
    - freertos.c: odstraněny nepoužívané globály (g_ui_enabled, g_screen_mode,
    g_prim_mode, g_ui_calreq, i2cDoneSemHandle) + mrtvé zápisy v příkazu "ui"
    - smazány osiřelé LVGL fonty, celý LVGL middleware + lv_conf.h
    - vyčištěny LVGL include-cesty v .cproject
    Dokumentace a nepoužívané soubory:
    - smazáno: GPSDO_UI_SETUP.md, README_FIX.md, DispV1-5.jpeg, *.bak_lvgl
    - CLAUDE.md aktualizován na aktuální stav (libprim/libui místo gfx/LVGL)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
2026-06-19 Optimalizace + audit komentářů + odstranění mrtvé I2C4 IRQ infrastruktury
    Optimalizace:
    - odstraněny ITCM/DTCM zbytky (no-op kopie v main.c + prázdné .itcm_text/
    .dtcm_data sekce v linkeru) po smazaném gfx hot-path
    - freertos.c: duplicitní #include "FreeRTOS.h"
    - freertos_task_uart/sensors.c: redundantní lokální extern hi2c4 (je v i2c.h)
    Audit komentářů (oprava zastaralých odkazů na smazané touch_ui.c/gfx.c a
    přejmenované funkce):
    - ft5x06.c, i2c.c: touch se čte pollingem (ne IT přes touch_ui.c)
    - prim_stm32_hal.c: odstraněna zmínka gfx.c
    - freertos_task_uart/sensors.c: hlavičky odkazují na *_run impl.
    Odstranění mrtvé I2C4 EV/ER IRQ infrastruktury (dotek p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
2026-06-19 STM32CubeIDE: aktualizace interních .settings (project prefs + scanner config)
    Pouze IDE-generovaná metadata (opaque hashe + language settings), přepsaná
    otevřením/buildem projektu. Bez kódových změn.
2026-06-19 Cleanup: odstranění duplicit (ft5x06 REG_TD_STATUS, FB_ADDR)
    - ft5x06.c: odstraněn duplicitní #define FT5X06_REG_TD_STATUS (zůstává
    ve ft5x06.h, kde už má popis); .c ho bere z headeru
    - freertos_task_uart.c: zaveden #define FB_ADDR pro framebuffer adresu,
    4 raw výskyty 0xC0000000 (testRED/test) ho nyní používají
2026-06-21 Senzory: error handling + statistika, diagnostika 2 sloupce, UART boot fix
    - Senzory (sensor_stat.h, g_sensors[]): jednotny stav teplot + ADS s valid
    flagem a statistikou (min/max/avg); SensorsTask zapisuje pres sensor_update/
    sensor_fail. Pri I2C chybe se hodnota neprepisuje (valid=0) -> neotravi prumery.
    Displej: neplatne ztlumene + cerveny "!".
    - !! ZADNY printf v SensorsTasku (maly stack) -> drive zpusoboval stack overflow
    + boot-loop (log se uriznul uprostred "SENZOR TMP117"). Logovani odstraneno.
    - Diagnostika: dvousloupcovy layout, + min/max teplot, FPGA kvalita (g_freq_info),
    Si5356 lock status (reg 218), RTOS zdravi (uptime; heap/CPU docasne vypnuto).
    - UART boot fix: PA10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
    [H757_LED.ioc, app_gpsdo.c, main.c, screen_main_data.c, sensor_stat.h, usart.c]
2026-06-21 UI: redukce fontu, simulovany cas, DMA2D cache-fix, diag change-detection
    Fonty (flash): charset velkych pomocnych fontu velkeho cisla orezan
    (sans_32->"Hz", mono_30->cislice, mono_25->cislice/VELKA/interpunkce);
    sans_17->sans_16 a sans_20->sans_18 slouceny a smazany. Pridany mono_22 +
    sans_18 (vetsi pismo tlacitek +10%). 13 fontu (z 13 puvodnich, jine mix).
    Diagnostika:
    - popisky stejny font jako hodnoty (mono_18), liseni barvou.
    - change-detection: pole se prekresli jen pri zmene.
    - RTOS staty (heap/CPU) zapnute; teplota 2 des. mista; SPI stav font mono_14.
    - dtext orizne text na sirku boxu (dlouhy SPI/FPGA stav nepretece kartu).
    Hlavni obrazovka:
    - simulovany cas HH:MM:SS (start 14:32:0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
    [app_gpsdo.c, app_gpsdo.h, bargraph.c, button.c, card.c, screen_main.c]
2026-06-22 Triple buffer (dirty-rect, non-blocking) + CPU optimalizace + simulovany cas
    Triple buffering znovu zapnut a optimalizovan (prim_stm32_hal.c):
    - 3 FB + page-flip pri vblanku (VBR), tearing-free; NON-BLOCKING (ceka na
    predchozi flip, ne aktualni) -> zadny ~17ms spin pri nizke kadenci.
    - DIRTY-RECT copy-forward: po flipu se kopiruji JEN zmenene oblasti (ne 768 KB).
    Sledovani v DMA2D backendu (kazdy fill/blit zaznamena obdelnik). Triple ->
    novy back 2 snimky stary -> sjednoceni dirty z posl. 2 snimku.
    - present jen pri zmene (draw_diag_values/redraw_time vraci "kreslil jsem").
    - Cache invalidace po kazdem DMA2D fill/blit (CPU AA blend cetl stara data).
    - Freeze pri minulem pokusu byl prin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
    [app_gpsdo.c, ft5x06.h, main.c, screen_main.c, screen_main.h]
2026-06-22 Simulace kmitoctu + bargrafu (dBm), TMP117 2 Hz, audit
    - Velke cislo kmitoctu: dither poslednich 2 cislic (sigma/floor) 10x/s.
    Partial redraw jen ditherovaneho "ocasu" (ui_big_number_render_tail +
    seg_x), ne celeho mono_75 cisla -> levne.
    - Signal bargraf v dBm (rozsah 0..100% -> -80..+20 dBm), animace 30x/s,
    lean redraw (jen value text + segmenty, chrome/label staticke).
    - TMP117 (3x) prepnuty na 500ms konverzni cyklus (cerstve 2x/s); diag +
    RTOS staty obnovovany take 2x/s.
    - big_number.c: ui_big_number_render sjednoceno na render_tail(n,0)
    (odstranena duplicita).
    - screen_main.c: odstranen mrtvy s_num_rect; mutovatelne segmenty cisla.
    - screen_main_data.c: odstranena staticka SCR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
2026-06-23 Kmitocet: DMA2D glyfy (scoped) + per-segment dirty + 20Hz sim
    Simulace mereneho kmitoctu prekreslena na nizkou zatez:
    - Hodnota se meni spojite (mean-revert random walk ~10 MHz, integer
    matematika), pevny pocet mist (zero-pad dle layoutu segmentu), 20x/s.
    - Per-segment dirty: prekresli jen ocas od prvni zmenene skupiny cislic;
    stabilni cela cast se neprekresluje (pixel-identicke, zlomek prace).
    - DMA2D glyph blend v libprim: velke glyfy (h>=24, nepruhledne, neorezane)
    se blenduji pres DMA2D (A8 dlazdice v .sdram atlasu, cache dle ukazatele
    na coverage data) misto CPU rasterizace. Default vypnuto, zapnuto cilene
    jen kolem mereneho kmitoctu (prim_set_glyph_accel) -> zbytek textu CPU.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
    [app_gpsdo.c, app_gpsdo.h, screen_main.c]
2026-06-23 UI optimalizace: present coalescing, incremental bargraf, touch mimo UiTask
    Snizeni zateze render tasku (UiTask 58 -> 47 %, CPU load 100 -> 57 %, idle 43 %):
    - Present coalescing: ticky (clock/signal/freq) jen renderuji + znaci dirty;
    jeden flip na ~30 Hz gate (app_gpsdo_flush) slouci vsechny zmeny -> mene VBR
    flipu + sjednoceny copy-forward.
    - Incremental bargraf: ui_bargraph_update prekresli jen zmenene segmenty
    (typicky 1) misto cele stopy + 20 fillu; ui_bargraph_value oddeleno.
    - Big-number geometrie (sirka/x-pozice) cachovana v num_build (monospace ->
    konstantni), redraw_freq uz neprochazi prim_text_width kazdy snimek.
    - Touch presunut z UiTask do SensorsTask (~10 Hz): blokujic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
    [app_gpsdo.c, app_gpsdo.h, bargraph.c, screen_main.c]
2026-06-23 GPSDO main: simulace statistiky (Allan/trend/offset/drift) + RUN/STOP + fixy
    Hlavni obrazovka napojena na simulovany kmitocet jako koherentni GPSDO demo:
    - Statistika z frakcni odchylky y=(f-f0)/f0 (ring buffer 2x/s, poctiva ~1e-8):
    Allan ADEV(tau), σy@1s, offset (klouzavy prumer), drift df/dt, p-p, trend.
    - Allan graf: VLASTNI dynamicka log-log osa [tau_min..tau_max] (krivka zacina
    presne vlevo a roztahuje se s nejdelsim dostupnym tau), markery v tau bodech,
    "Waiting for data..." dokud nejsou >=2 body. Hodnoty horni indexy 10⁻ⁿ.
    - 3 uzke karty: Offset / σy 1s / Drift/s (drive 2 siroke).
    - Trend sparkline: pevne meritko ±FS (neposkakuje) + tenka regresni cara (smer/drift).
    - Sig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
    [app_gpsdo.c, app_gpsdo.h, screen_main.c, screen_main.h, screen_main_data.c]
2026-06-24 Allan dekadova osa (mocniny 10) + markery/regrese; I2C1 recovery
    - Allan graf: casova osa v MOCNINACH 10 (dekadove popisky 1/10/100 s + mrizka),
    jen dekady v dynamickem rozsahu [tau_min..tau_max]; krivka vyplnuje sirku +
    markery (tecky) v kazdem merenem tau. Trend: tenka regresni cara pres vzorky.
    - I2C1 recovery (SensorsTask): pri "wedge" chybe (BERR/ARLO/TIMEOUT — slave drzi
    SDA) udela 9 SCL pulzu (PB8) + MX_I2C1_Init -> jeden zaseknuty/vadny cip
    neshodi zbytek sbernice (ADS jede dal). Spousti se JEN na wedge, NE na NACK
    (absentni 0x4A re-init nezpusobi). Vola se pred ADS i po kazdem ADS kanalu.
    I2C1 nema ATTINY -> reset bezpecny (na rozdil od I2C4).
    CLAUDE.md: 0x4A neosazen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
    [screen_main.c]
2026-06-24 Allan: decimacni pyramida (tau 1..100000+ s, 100 dni) + 1/s vzorkovani
    Dlouhodoby Allan ohranicenou pameti misto plocheho bufferu:
    - Decimacni pyramida (6 stage, tau = 1/10/100/1k/10k/100k s): vzorek y (1/s)
    do stage 0; po 10 vzorcich jejich prumer -> dalsi stage (tau ×10). ~640 B
    pokryje 100+ dni (plochy buffer by chtel desitky MB).
    - Allan krivka z pyramidy: per stage tau = {1,2,5}×10^s (log spacing 1,2,5,10,
    20,50,...). Log osa, dekadove popisky v mocninach 10 (1..100000 s), dynamicky
    rozsah [tau_min..tau_max] roste s nejdelsim dostupnym tau.
    - Vzorkovani 1/s (tau0=1s -> dekady sedi). Plochy ring zmensen na 120 (jen
    kratkodobe: trend 60s, offset, drift, σy@1s). σy@1s = stats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
    [app_gpsdo.c, app_gpsdo.h, screen_main.c, screen_main.h]
2026-06-25 Fix: I2C1 recovery nesmi volat MX_I2C1_Init (Error_Handler freeze)
    Pri ODPOJENEM FPGA kabelu zmizi pull-upy (jsou na FPGA desce, STM GPIO_NOPULL)
    -> I2C1 (TMP117 0x49/0x4A, ADS, Si5356) plove -> re-init v recovery selhal v
    MX_I2C1_Init -> Error_Handler() (nekonecna smycka) -> ZAMRZL CELY program.
    - i2c1_recover dela re-init INLINE (GPIO AF + HAL_I2C_Init) bez Error_Handler;
    selhani tise ignoruje (zkusi pristi cyklus). hi2c1.Init zustava z bootu.
    - Storm omezen na max 2 recovery/cyklus (odebrano per-ADS-kanal + start-fail).
    Audit potvrdil: vsechny I2C drivery (ADS/si5356/FT5x06/ATTINY) maji konecne
    timeouty (50-100ms), zadny Error_Handler/HAL_MAX_DELAY/polling bez timeoutu ->
    jakykoli vad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
2026-06-25 Fix: I2C1 recovery pod mutexem (race s UART si5356/scan1)
    i2c1_recover re-initoval peripheral bez i2c1MutexHandle, zatimco UART prikazy
    si5356/scan1 sahaji na I2C1 z UartTasku (pod mutexem) -> souběh mohl poskodit
    transakci. Recovery nyni bezi pod mutexem (pri neziskani preskoci, zkusi pristi
    cyklus). Call sites maji mutex volny -> bez deadlocku.
    Audit: vsechny I2C cesty maji konecne timeouty, zadny Error_Handler/blokovani ->
    jakykoli vadny/chybejici cip -> sensor_fail (cerveny ! na diagu), bez crashe.
2026-06-25 I2C1 back-off pri mrtvem busu (setri CPU, neklesa odezva po pripojeni)
    Pri trvalem selhani cele I2C1 (odpojena FPGA deska) se polling I2C1 zpomaluje
    podle poctu po sobe jdoucich selhani: 3x@500ms -> 3x@1s -> 2x@2s -> @10s. Misto
    trvalych burstu (CPU na timeoutech) jen obcasna sonda. Jakekoli HAL_OK (0x49/ADS/
    Si5356) -> reset na normal -> po pripojeni kabelu se chytne do ~0,5 s. NACK
    absentniho 0x4A se za "zivot" NEpocita, ale ani back-off nezpusobi (0x49/ADS ziji).
    TMP117 0x48 (I2C4) cte dal 2x/s, gate je jen na I2C1.
    CLAUDE.md aktualizovano.
2026-06-25 Fix: I2C1 back-off gate wrap-safe (tick preteceni za ~49 dni)
    i2c1 back-off pouzival prime porovnani xTaskGetTickCount() >= i2c1_next, ktere
    NEprezije preteceni 32bit tick citace (~49,7 dne) -> pri cili 100denniho mereni
    by se back-off rozbil. Zmeneno na wrap-safe idiom (uint32)(now - last) >= iv,
    jako ostatni gaty (UiTask). Ostatni gaty overeny wrap-safe.
2026-06-25 .ioc: narovnani na aktualni kod (task stacky + queue typ)
    H757_LED.ioc zaostaval za kodem:
    - defaultTask stack 128 -> 256 words (kod: 256*4).
    - I2C4Task stack 128 -> 256 words (kod: 256*4).
    - UartRxQueue prvek uint16_t -> uint8_t (kod pouziva sizeof(uint8_t); uint16_t
    driv zpusoboval stack overflow).
    Overeno ze sedi: I2C4 Timing 0x70303AEE, USART1 115200, PA10/PB12 piny.
    NElze do .ioc (USER CODE, regen by smazal): I2C1 self-contained, UiTask/FpgaTask,
    FreeRTOS heap, gpio/DSI/recovery zaplaty. -> regen z CubeMX se NEdela.
2026-06-25 I2C4Task stack 256 -> 384 words (1536 B) — rezerva pro I2C1 recovery
    Naměřeno STACKFREE min-ever 328 B @1024 B (pouzito ~696 B v recovery ceste:
    HAL_I2C_DeInit/Init + GPIO_InitTypeDef). 328 B margin tenky pro HAL_I2C cesty
    -> 384 words = 1536 B -> ~840 B volneho (~2x headroom). Kod i .ioc soucasne.
2026-06-25 UI: System Health okno (SYS pill) + GPS skeleton (GNSS pill) + UART RX fix
    - usart.c: HAL_UART_ErrorCallback pred re-armem vola HAL_UART_AbortReceive +
    nuluje ErrorCode. Bez toho po chybe prijmu (ORE/sum pri hot-plugu) zustal
    RxState=BUSY -> Receive_IT vracel HAL_BUSY -> RX se uz nikdy nenahodil
    (mrtva konzole, TX jel dal). AbortReceive v IT rezimu neblokuje (ISR-safe).
    - System Health okno (s_view=3, tap na SYS pill vedle GNSS lock): zive 2x/s,
    first/values split jako diagnostika. RTOS (heap/CPU/uptime), volny stack
    tasku (osThreadGetStackSpace, <64 B -> cerveny '!'), I2C chybovost
    (agregace g_sensors err citacu, 0x4A vyrazen = neosazen), linky
    (FPGA/Si5356/senzory n/7), napa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
    [app_gpsdo.c, app_gpsdo.h, screen_main.c, screen_main.h, usart.c]
2026-06-27 Docs: USB_CDC_PLAN.md — plan rizeneho regenu pro USB CDC konzoli
    USB OTG FS (PA11/PA12) jako Virtual COM Port -> uvolni USART1 pro GPS.
    CubeMX nastaveni (VBUS off kvuli encoderu na PA9, HSI48+CRS clock, OTG_FS
    prio 5), post-regen re-apply checklist rucnich patchu, integracni kod
    (CDC RX -> UartRxQueue, _write -> USB TX ring buffer). Restore point 339c986.
2026-06-27 USB CDC: predpripraveny dormantni console modul + prepinac v _write
    Maximum, co jde bez CubeMX regenu (USB stack generuje az CubeMX):
    - usb_console.c/.h: TX ring buffer (CDC_Transmit_FS neni blokujici) + RX most
    usb_console_on_rx() -> UartRxQueue. Prepinac USE_USB_CDC_CONSOLE (default 0).
    Pri 0 = prazdne stuby (kompiluje se naprazdno, build beze zmeny).
    - main.c _write: predratovano pres console_send(): #if USE_USB_CDC_CONSOLE -> USB,
    jinak USART1 jako dosud. Default 0 = ZADNA zmena chovani do regenu.
    - USB_CDC_PLAN.md: integrace zkracena na "prepni makro + 1 radek v CDC_Receive_FS".
    Po regenu: USE_USB_CDC_CONSOLE=1 + usb_console_on_rx(Buf,*Len) v CDC_Receive_FS.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
2026-06-30 USB CDC konzole + GPS NEO-7M (USART1) + UI napojeni
    - CubeMX regen: USB_OTG_FS Device + HSI48/CRS; po regenu obnoven UART (USART1) a clock (PLL2/PLL3, FMC 100MHz, NBL0/NBL1)
    - USB CDC: ST USB Device lib + glue, usb_console (TX ring + RX->UartRxQueue), TxCplt drain; _write prepnut na USB
    - GPS NEO-7M @9600 na USART1: NMEA parser (RMC/GGA/GSA/GSV), GpsRxQueue drain v defaultTask, prikazy gps/gpsraw
    - GPS TIMEPULSE: UBX-CFG-TP5 5Hz (no fix) / 100kHz (fix); TX pred arm RX (HAL lock race fix)
    - UI: GPS okno live, hlavni obrazovka GNSS lock + pocet druzic + cas/datum z GPS, System Health podmenu senzoru
    - Uklid: smazan mrtvy SCR_S_*, opraveny zastarale komentare, format-truncation buffery
    Co-Auth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
    [H757_LED.ioc, app_gpsdo.c, app_gpsdo.h, gps.c, gps.h, i2c.c]
2026-06-30 RTC (LSE) + hodiny z RTC + ADC3 interni senzory (VREFBUF) + uklid
    RTC: LSE 32.768kHz (PC14/PC15), sync z GPS UTC (1. fix hned, re-sync 10min),
    perzistence pres warm reset (BKP_DR0 guard). App vrstva regen-safe v rtc.c/h
    USER CODE. Hodiny v headeru + GPS okno ctou RTC (tikaji i bez fixu). Prikaz 'rtc'.
    ADC3: interni senzory (teplota jadra / VREF / VBAT) -> g_sensors (SENS_COUNT 7->10),
    diag "MCU" karta + okno SENZORY (tabulka aktualnich hodnot) + 'sensors'/'adcraw'.
    Reference = VREFBUF ~2.5V (VREF+ na desce nespojen s VDDA). KLICOVE: VREFBUF ma
    vlastni clock RCC_APB4ENR.VREFEN (NE SYSCFG). Dale: PCSEL preselect, ClockPrescaler
    DIV8, 16-bit kalibrace (rucni prepocet), single-channel rezim, SW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
    [H757_LED.ioc, app_gpsdo.c, main.c, rtc.c, rtc.h, screen_main.c]
2026-06-30 Spoluprace: CONTRIBUTING + CODEOWNERS + PR template + .editorconfig
    Infrastruktura pro vyvoj ve dvou:
    - CONTRIBUTING.md: workflow (IOC owner pravidlo, deleni modulu, branch/PR,
    konce radku, commit atribuce). Centralni kultura = CLAUDE.md + CUBEMX_CHECKLIST.
    - .github/CODEOWNERS: auto-review na "nebezpecne" cesty (.ioc, main.c, freertos.c,
    DSI, Drivers) -> vynuti koordinaci kolem CubeMX regenerace. Doplnit handle kamarada.
    - .github/pull_request_template.md: checklist (build z CubeIDE, HW test, sahl jsem na .ioc?).
    - .editorconfig: UTF-8 (diakritika), LF, final newline; indent nechan na souboru.
    .gitattributes uz existuje (LF-kanonicke) -> CRLF varovani jsou normalni normalizace.
    Co-Aut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
2026-06-30 Spoluprace: model "oba rovnocenni" + handle kamarada
    CODEOWNERS: bez per-moduloveho vlastnictvi -> oba muzou sahat kamkoli.
    Owner (oba: @ok2haz @FrantisekPospisil) jen na sdilenych/CubeMX souborech
    (.ioc, main.c, freertos.c, DSI/LTDC/FMC/gpio, *.ld, Drivers, docs) -> PR na ne
    schvali ten druhy. Ostatni soubory bez ownera = volne.
    CONTRIBUTING: sekce 2 prepsana z pevneho deleni modulu na "oba rovnocenni".
2026-06-30 feat(app): wire HDOP pill to live GPS data
    Hlavni obrazovka: HDOP pilulka cte g.hdop (GGA/GSA) misto statickeho
    placeholderu "0,8" - 1 des. misto, ceska carka, "--" bez fixu, cap 99,9.
    Pridano do change-detekce hlavicky (last_hdop10, ~1 Hz z GGA). Odstranen
    mrtvy SCR_S_HDOP_V. Simulovany kmitocet/Allan/signal zustavaji jako demo.
    [app_gpsdo.c, screen_main.c, screen_main.h, screen_main_data.c]
2026-07-04 feat(fpga): SPI mutex + hystereze vyberu zdroje, heap 32k, text CPU fast-path
    - fpga_freq: xfer() pod SPI2 mutexem (FpgaTask poll vs UART fpgaraw/fpgaloop)
    - fpga_freq_select: sticky hystereze /4<->/16 (nahoru 380 MHz, dolu 360 MHz)
    -> zadne preblikavani zdroje u prahu; volat jen z FpgaTasku
    - freertos: usb_console_tx_pump() v defaultTasku (dopumpuje CDC TX ring po BUSY)
    - heap configTOTAL_HEAP_SIZE 15360 -> 32768 B (drzeno i v .ioc, regen-safe)
    - libprim/text: CPU cesta orizne glyf jednou + tesna smycka prim_blend565
    misto per-pixel clip testu (pixel-identicky vystup)
    - docs: CLAUDE/CHECKLIST/BRIEF aktualizovane (link OK, Si5356 faze 90),
    novy FPGA_PROTOCOL_V2_NAVRH.md (navrh, zatim n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
2026-07-05 docs(fpga): oprava topologie delicky dle schematu + pridani FPGA_module.pdf
    Schema (FPGA_module.pdf, list 2 FPGA_Core) potvrzuje: /4 a /16 jsou dve
    odbocky JEDINEHO citace MC100EP016A (Q1=/4, Q3=/16), tvarovac MAX9601,
    strop retezce ~1,4 GHz (ne 1,6 GHz).
    - CLAUDE.md: "dva preddelice" -> "dve odbocky jednoho delice"; /16 NENI
    nezavisly cross-check (sdili tvarovac+citac s /4 -> jen downstream sanity)
    - FPGA_INSTANCE_BRIEF.md: nova sekce 0c MERICI FRONT-END (drive chybela)
    - pridan FPGA_module.pdf (KiCad schema desky, 5 listu)
2026-07-05 chore(cubemx): QUADSPI (W25Q512) enable + regen
    Povolen QUADSPI Bank1 pro externi W25Q512JV flash. Generovan quadspi.c
    + HAL QSPI driver. Piny PF10 CLK / PG6 NCS / PD11 IO0 / PD12 IO1 /
    PF7 IO2 / PD13 IO3, FSIZE=25 (64 MB), prescaler=23 (SCLK 10 MHz),
    Mode0, HALFCYCLE. Regen-safe patterny overeny (PB12 CS boot HIGH,
    heap 32k, DSI BURST/RGB565, I2C timing, UartRxQueue uint8_t).
    Ostatni soubory melo jen CRLF -> normalizovano (bez obsahove zmeny).
2026-07-05 feat: W25Q512 driver + config persist (BKP) + sensor table + cleanup
    - qspi: w25q.c/h driver — JEDEC EF4020, 4-byte adresovani (EN4B),
    read/write(256B stranky)/erase(4KB), quad-enable, WIP polling.
    UART qspiid/qspitest bring-up. Overeno na HW (EF4020, verify OK).
    - cfg: perzistence UI nastaveni (mode/chan/gate/run) v RTC BKP_DR1 —
    load pred schedulerem (MX_RTC_Init), save pres defaultTask (dirty).
    - sensors: descriptor tabulka g_sensor_desc (label+unit) = jedno misto
    pravdy misto lokalnich poli v UART sensors.
    - cleanup: odstranen mrtvy fpga_freq_format; static globaly v uart
    tasku; smazany bring-up prikazy testRED/test + osirela makra;
    usb_console PRIMASK race fix; defaultTa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
    [fpga_freq.c, fpga_freq.h, gps.c, rtc.c, rtc.h, screen_main.c, sensor_stat.h, w25q.c]
2026-07-05 feat(qspi): blob store + region map + 60 MHz quad read
    - w25q_store: genericky kruhovy wear-leveled blob store (power-safe:
    hlavicka naposled). ⚠️ oprava base-0 sentinelu (seq==0, ne active==0 —
    active==0 kolidovalo s CONFIG regionem @0x000000 -> nerotoval + read
    vracel prazdno). Overeno storetest na CONFIG (base 0x0).
    - w25q: SCK 10->60 MHz (driver prebiji CubeMX, regen-safe), Quad Fast
    Read 0x6C (4-line, 8 dummy). Read ~4.6 MB/s (polling-limited, ne SCK;
    DMA/mmap = TODO pro bulk).
    - w25q_map: genericka region mapa CONFIG 64K / CALIB 64K / DATA ~63.9M.
    - UART qspispeed (timed read) + storetest. Vse overeno na HW.
2026-07-05 fix(ui): okno PAMET ukazuje POUZITE heap (ne volne)
    Hlavicka karty "pouzite/celkem" + sloupce FLASH/RAM ukazuji pouzite;
    heap omylem ukazoval volne. Sjednoceno na used = celkem - volne.
    [app_gpsdo.c]
2026-07-06 feat(ui+gps): timepulse 100kHz/10Hz + UI uklid a kontrast
    - timepulse: s fixem 100 kHz (GPSDO PLL reference), bez fixu 10 Hz
    (frekvence = lock indikator pro desku -> hold VC / holdover)
    - tlacitka SENZORY/PAMET bez ">"
    - footer pravidlo: diag MCU karta sahala do listy (y=472) -> slouceno,
    konci na 404; nic nezasahuje do zony tlacitek (y>=416)
    - GPS "Prijimac": model do headeru -> odstranen prekryv s nazvem
    - dval clip (dlouha hodnota uz nepretece pres label)
    - nejmensi font 14->16 px v oknech (krome diag SPI status radku)
    - kontrast: 3x nejtmavsi text INK_4->INK_3; INK_3 tier mirne zesvetlen
    [app_gpsdo.c, gps.c]
2026-07-07 perf(sensors): ADC3 interni senzory 2 Hz -> 1 Hz
    MCU teplota jadra / VREF / VBAT se meni pomalu -> 3 kanaly x 16 vzorku
    busy-poll (~12,6 ms) nemusi 2x/s. Kazdy 2. cyklus -> ~1,3 % CPU dolu,
    16x prumerovani zachovano. I2C senzory (teploty, napeti) dal 2 Hz.
2026-07-07 docs: audit pass 3 — beeper orphan + g_rtc_text torn-read zdokumentovan
    Kompletni audit (3. pass, ~100 % rucni logiky): zadny novy bug.
    - CLAUDE.md: beeper_set() nikdo nevola (tlacitko BEEP zaniklo s libui);
    API+HW pripravene, kandidat = alarm SIGNAL_LOST/ztraty locku
    - freertos.c: torn-read g_rtc_text UI ctenari bez zamku = ZAMER
    (benigni 100ms glitch ~1x/70h, self-healing) — zdokumentovano
2026-07-09 docs: aktualizace komentaru po auditu (timepulse, cesta schematu)
    - gps.h + CLAUDE.md: TIMEPULSE komentare srovnany s kodem
    (100 kHz s fixem = GPSDO PLL reference / 10 Hz bez fixu = hold
    indikator; drive zastarale "1 PPS / 1 Hz")
    - CLAUDE.md + FPGA_INSTANCE_BRIEF.md: odkaz na presunute schema
    ../Frequency_Counter_FPGA_Module/FPGA_module_schematic.pdf
    [gps.h]
2026-07-10 feat: alarm + IWDG watchdog + okno Nastaveni + auto-dim + histogram rozsireni
    Alarm (alarm.c/h): beeper pipa na hrany SIGNAL_LOST (3x) / ztrata GPS locku (2x),
    obnoveni 1x; start tichy (ever-guardy), mute-safe, neblokujici pattern; stavy 5x/s,
    casovani 100x/s z defaultTasku. UART beep/beep on/beep off.
    IWDG watchdog (watchdog.c/h): IWDG1 ~4 s, registrove (HAL modul vypnuty, regen-safe),
    sekvence dle RM0399 (START prvni - LSI/SR propagace). Heartbeat UiTask+FpgaTask;
    defaultTask obnovi jen kdyz oba zily (<2,5 s), grace 8 s, DEBUG freeze.
    Okno Nastaveni (s_view=7, Health->NASTAVENI): mute s ikonou preskrtnuteho
    reproduktoru (ui_icon_speaker/_muted), jas -/+ (bargraf, clamp 25..255),
    auto-dim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
2026-07-10 docs: protokol v2 odpoved FPGA strany + navrh architektury CM7/CM4
    - FPGA_PROTOCOL_V2_NAVRH: implementacni odpoved FPGA (FW 0x0200, 128 B, gap-free
    okna, SET_CONFIG gate, Lambda/Omega S1/S2 rozsireni, cal_mode, 0xA0 CAL report)
    + migrace checklist STM driveru
    - NAVRH_ARCHITEKTURA_CM7_CM4: rozdeleni tasku mezi jadra, SD/ETH/SCPI/web plan
    - FPGA_module.pdf presunut do ../Frequency_Counter_FPGA_Module/ (schema modulu,
    odkazy v docech uz miri tam)
2026-07-12 feat(ui): menu 3x4 rozcestnik + okna Holdover/Datalog/Alarmy + theme/reset diag
    Menu rozcestnik rozsiren na mrizku 3x4 = 12 dlazdic (MENU_ITEMS + menu_activate,
    ACT_* enum misto if-retezce). Nova okna (nejsou redundantni k Diagnostice):
    - Holdover (s_view=16): zivy automat WARMUP/LOCK/HOLDOVER/NO-LOCK z GPS fixu +
    FPGA linku + timepulse + OCXO teploty 0x49, cas v rezimu.
    - Datalog (s_view=17): vstupni bod logovani do W25Q DATA regionu (base/kapacita/
    JEDEC + plan ~32 B/10 s -> ~600 dni); logovani zatim neaktivni.
    - Alarmy (s_view=18): prehled hlidanych podminek + pocitadla g_alarm_fpga/gps_lost
    + zivy mute (doplnuje Nastaveni, ktere ma jen globalni mute).
    Dale: svetle/tmave schema (th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
    [alarm.c, alarm.h, app_gpsdo.c, app_gpsdo.h, beeper.c, beeper.h, fpga_freq.c, fpga_freq.h]
2026-07-12 feat(fpga): carrier board v2.0 (KiCad) + Verilog RTL + sim + phase cal
    FPGA strana projektu (OK2JNJ):
    - KiCad v2.0 nosna deska (FPGA_Core/GPSDO/I2C_devices/power_supply schemata,
    PCB, symboly, footprinty Tang Nano 9K) + FPGA_module.pdf.
    - Verilog RTL: coarse_counter, spi_slave_phy, spi_app, tdc_vernier_4phase, top +
    pins.cst + timing.sdc; Gowin build.tcl.
    - Simulace: tb_coarse_counter/phase_oversampler/recip_calc + run.ps1.
    - PHASE_CAL_DESIGN.md (kalibrace fazi TDC), BOARD_V20_CHECKLIST.md.
    - .gitignore (vc. KiCad autosave/backup), code-quality-auditor agent.
    [FPGA_Core.kicad_sch, FPGA_module.kicad_pcb, FPGA_module.kicad_sch, GPSDO.kicad_sch, I2C_devices.kicad_sch, power_supply.kicad_sch]
2026-07-15 feat(ui): okna Citac + Selftest + Komunikace (blokove schema), fix System Health overflow
    Menu: dlazdice Senzory/O pristroji (redundantni s tlacitky v Health/Nastaveni)
    nahrazeny za Citac (zivy detail mereni FPGA - obe odbocky /4 i /16, fazovy
    status, dekodovane chyby) a Selftest (per-test vysledky + tlacitko SPUSTIT).
    Driver: fpga_freq_get_last() pro bezpecne cteni posledniho ramce z UiTasku
    (IRQ-off latch), g_selftest_detail[] pro per-test stav.
    Diagnostika: nove tlacitko DIAGRAM -> blokove schema komunikace (GPS/Senzory/
    STM32/Si5356/FPGA), linky barevne podle ziveho stavu + popisky. Cely diagram
    se prekresluje pri zmene stavoveho klice.
    Fix: karta System v System Health prekryvala pati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
    [app_gpsdo.c, fpga_freq.c, fpga_freq.h]
2026-07-18 feat: kalibrace + persistence nastaveni do W25Q, casova zona, trend az 60 dni
    Si5356 LOS_CLKIN — OPRAVA ZAMENY BITU (reg 218 dle AN565):
    bit2 = LOS_XTAL (krystal XA/XB neosazen, piny uzemnene -> TRVALE 1, benigni),
    bit3 = LOS_CLKIN (skutecna ztrata 10 MHz). FW mel bit2 mylne jako LOS_CLKIN ->
    pozorovany status 0x04 byl chybne hlasen jako ztrata reference. Navic AN565:
    PLL_LOL se pri fyzicke ztrate vstupu NEasertuje -> bit3 je hlavni indikator
    (cervena), bit2 se ignoruje. TTL buzeni CLKIN je v poradku, HW beze zmeny.
    Kalibrace (calib.c/h) — editovatelna, persist do W25Q CALIB store:
    AD8307 slope/intercept + ADS 12V/5V gain pres -/+ v okne Kalibrace, ULOZIT
    zapise blob (magic CAL1). Napoj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
2026-07-18 docs: STATUS.md + tools/make_release_image.ps1 do repa (cross-project prehled)
    STATUS.md je navrzeny jako JEDINY cross-project rozcestnik obou stran projektu
    (stav, sdileny SPI kontrakt, TODO se zavislostmi), ale dosud byl jen lokalne
    untracked -> druha strana (FPGA) ho nemela. Stejne tak na nej i CONTRIBUTING.md
    odkazoval `tools/make_release_image.ps1` (combined CM7+CM4 image, nutny kvuli
    dual-core flash), ktery v repu take nebyl.
    Aktualizace obsahu na stav 2026-07-18:
    - Stav STM32 strany doplnen o kalibraci (CALIB store), persistenci nastaveni
    do W25Q (prezije power-cycle), casovou zonu, trend az 60 dni a nova okna.
    - TODO #7 (RF kalibrace): infrastruktura hotova, zbyva zmerit hodnoty n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
2026-07-18 fix(boot): CM4 nenabehl -> degradovany rezim misto cerne obrazovky + CONTRIBUTING §7
    STM32H757 ma dve jadra ve dvou flash bankach. Displej i veskera logika bezi na
    CM7 (bank1), ale CM7 na startu cekal na boot CM4 (bank2) pres HSEM/D2 handshake
    a pri timeoutu spadl do Error_Handler — tichy zasek PRED init displeje, tedy
    CERNA OBRAZOVKA. Typicka pricina: naflashovana jen bank1 nebo BCM4=0 v option
    bytes (klasicke "jednomu jde, druhemu ne").
    main.c: oba boot handshaky (Boot_Mode_Sequence_1/2) misto Error_Handler nastavi
    g_cm4_absent a pokracuji. Priznak je pak videt nahlas: UART "[BOOT] CM4 (D2)
    nenabehl ..." s navodem, System Health karta "CM4 (D2): ABSENT" a amber SYS pill.
    Behem boot fra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
    [main.c]
2026-07-18 docs(CONTRIBUTING): §8 — jak spravne importovat projekt do CubeIDE
    Po klonu na jinem stroji spadne link na stovkach chyb:
    undefined reference to `HAL_GPIO_Init' / `osDelay' / `vTaskDelay' ...
    (HAL_GetTick): Unknown destination type (ARM/Thumb)
    dangerous relocation: unsupported relocation
    Neni to chyba kodu ani chybejici soubory v repu (HAL i FreeRTOS zdrojaky
    jsou commitnute). CM7/CM4 projekt je ma pres ~55 "linked resources" s cestou
    PARENT-1-PROJECT_LOC (o uroven vys), takze CM7/Drivers a CM7/Middlewares jsou
    prazdne virtualni kontejnery. Kdyz se CM7 naimportuje samostatne nebo se
    zaskrtne "Copy projects into workspace", PARENT-1 ukaze jinam -> odkazy se
    nerozlousknou -> HAL/Free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
2026-07-18 fix(qspi): mutex pro W25Q + refactor: hlavicka okna do window_chrome()
    Audit celeho projektu odhalil dve veci k oprave hned (dalsi dve vyzaduji IOC
    owner -> STATUS.md TODO #9).
    QSPI mutex (audit nalez #3):
    Na W25Q sahaji od 2026-07-18 TRI kontexty soubezne — defaultTask (syscfg
    auto-save), UiTask (calib_save na ULOZIT, w25q_read_jedec v oknech Pamet/Datalog)
    a UartTask (qspiid/qspitest/storetest/qspispeed). Zadna synchronizace neexistovala;
    erase trva 45-400 ms, takze okno kolize nebylo zanedbatelne.
    Pridan qspiMutexHandle. ⚠️ Zamyka se na urovni LOGICKE operace, ne jednotlivych
    w25q_* volani: w25q_store_write = erase + zapis payloadu + zapis hlavicky a to
    musi probehnout vcelku, jin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
    [app_gpsdo.c, calib.c, syscfg.c]
2026-07-18 fix(rtos): zapnuta detekce preteceni zasobniku + UartTask 2->4 KB
    Audit 2026-07-18, nalezy #1 a #2 (kriticke).
    1) Detekce preteceni zasobniku byla MRTVY KOD.
    configCHECK_FOR_STACK_OVERFLOW a configUSE_MALLOC_FAILED_HOOK nebyly vubec
    definovane -> FreeRTOS.h je bere jako 0 -> vApplicationStackOverflowHook
    a vApplicationMallocFailedHook ve freertos_hooks.c se NIKDY nezavolaly.
    Crash black-box (BKP_DR3..5, "stack:<task>") tedy nemohl nikdy nic zachytit,
    prestoze je v CLAUDE.md popsany jako bezpecnostni prvek — a projekt uz jedno
    preteceni zazil (printf v SensorsTasku, tehdy se projevilo jako zahadny freeze).
    Nastaveno v FreeRTOSConfig.h USER CODE Defines (regen-safe, stejny vzor jako
    tam uz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
    [H757_LED.ioc]
2026-07-18 docs(STATUS): TODO #10 — overit na HW, ze detekce preteceni zasobniku zabira
    Zapnuti (#9) je overene jen STATICKY (preprocesor: hook je v tasks.c 2x misto
    0x). Detekce se ale sama ozve az pri skutecnem preteceni — dokud se nevyzkousi,
    neni potvrzeno, ze funguje cely retez hook -> crash_blackbox -> BKP_DR3..5 ->
    cteni v MX_RTC_Init -> zobrazeni v System Health.
    TODO #10 popisuje ~5min zkousku: docasne pole waste[4096] v tasku, flash,
    po resetu musi byt videt "Reset: ... stack:<task>", pak pole zase odstranit.
    Pozn.: bez VBAT testovat warm resetem (BKP nepreziji power-cycle).
    Zaroven srovnano poradi radku tabulky (8, 9, 10).
2026-07-19 feat(boot): LED selftest blikaci kod + RTC LSE medium-low drive; UI 4.3" audit; FPGA HW revize
    STM32H757 firmware:
    - bootled.c/h: boot-time HW selftest diagnostika na LED_1 (PG3). Kazdy
    sledovany periferni init (FMC/SPI2/I2C4/DSIHOST/LTDC/USART1/RTC/ADC3/
    QUADSPI/I2C1) + display bring-up (panel probe/power-on/DSI start/
    TC358762) si zaznamena poradove cislo; pri zaseknuti v Error_Handler()
    LED bez displeje zabliká N-krat podle poradi. Regen-safe (jen chranene
    USER CODE hooky), bez zpozdeni v happy-path.
    - RTC LSE Drive Capability LOW -> MEDIUM LOW (H757_LED.ioc): kompenzuje
    desky s predimenzovanymi zatezovymi kondenzatory krystalu (22pF misto
    18pF), ktere LSE nerozjizdely.
    - U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
    [FPGA_Core.kicad_sch, FPGA_module.kicad_pcb, FPGA_module.kicad_sch, GPSDO.kicad_sch, I2C_devices.kicad_sch, power_supply.kicad_sch]
2026-07-20 feat(ui,datalog): RUN/STOP obracene + cerveny STOP, datalog do W25Q, v0.4.0
    UI hlavni obrazovky:
    - Footer slot 1 nese nove AKCI, ne stav: pri bezicim mereni cervene "STOP"
    (nova varianta UI_BUTTON_STOP v libui + btn_stop_top/bot/border v tmave
    i svetle palete), pri zastavenem zelene "RUN". Drive label = stav, tj.
    zelene "RUN" svitilo prave kdyz uz bezelo.
    - Stav mereni nese navic PODBARVENI zony velkeho kmitoctu: pri STOP se
    prekryje UI_COLOR_FREQ_STOP_BG (popruhledna cervena ~15 %). Alfa vyrazuje
    DMA2D fast-path, ale pri STOP nebezi 20Hz tick_freq -> kresli se jen pri
    plnem renderu a pri stisku, CPU dopad ~0. Prepnuti vola nove
    screen_main_redraw_freq_area() (per-segment dirty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
2026-07-20 fix(watchdog): diagnostika "kdo se zasekl" + wait_ready ustupuje scheduleru
    Hlaseni nahodnych watchdog resetu. Prosty IWDG reset byl NEMY: RSR rekl jen
    "watchdog", ne ktery task prestal koupat, a UART `status` vypisoval doslova
    jen "RUNNING" (pricina resetu byla dostupna JEN v okne System Health).
    - watchdog_supervise() pri odmitnuti refreshe zapise do crash black-boxu
    (BKP_DR3..5, novy kind 3) jmeno tasku se starym heartbeatem -> po restartu
    g_crash_text = "stall:UiTask" / "stall:FpgaTask" / "stall:BOTH". Stejny
    format jako FreeRTOS hooky, takze to cte tentyz kod v MX_RTC_Init.
    Zapisuje se jen jednou za beh (s_stall_logged).
    - rtc.c: dekodovani kind 3 -> "stall:<task>"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
    [datalog.c, rtc.c, w25q.c, watchdog.c]
2026-07-20 feat(boot): POST diagnostika pipa soubezne s blikanim LED
    Pri selhani bootu (Error_Handler nebo bring-up panelu) LED_1 (PG3) blikala
    N-krat podle toho, ktery krok selhal. LED je ale v krabicce nemusi byt videt
    — a kdyz selze prave panel, je to jediny vystup, ktery zbyva. Nove se soubezne
    s kazdym bliknutim ozve 800 Hz ton (150 ms svit+ton / 150 ms tma+ticho).
    ⚠️ ZAMERNE NEPOUZIVA beeper.c: ten generuje ton pres TIM7 IRQ, jenze
    bootled_fail() bezi z Error_Handler(), kde jsou preruseni vypnuta (presne
    proto tenhle modul uz drive pouzival DWT misto HAL_Delay). TIM7 by nikdy
    netikl a beeper by mlcel. Ton se proto bit-banguje primo na PH9 stejnym DWT
    casovanim, pulperioda 625 us = 800 Hz (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
    [bootled.c]
2026-07-20 docs: uzivatelsky navod (NAVOD.md) — prvni verze
    Dosud existovala jen vyvojarska dokumentace (CLAUDE.md, STATUS.md a spol.).
    NAVOD.md je psany pro OBSLUHU pristroje: co znamenaji pilulky v hlavicce,
    barvy SYS, okna v menu, nastaveni, kalibrace, datalog, servisni konzole,
    zvukova signalizace a reseni problemu.
    Dve veci, na kterych mi zalezelo:
    1) Navod NEPREDSTIRA, ze pristroj meri. Hned nahore je tabulka "Stav vyvoje"
    a ramecek, ktery rika, ze velke cislo na hlavni obrazovce je zatim
    SIMULACE (blokuje #2) a ze totez plati pro trend, Allana i histogram.
    Bez toho by navod lhal prave o te hlavni funkci.
    2) Chybejici udaje jsou oznacene jako chybejici, ne dopsane odhadem —
    kon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
2026-07-20 docs(arch): revize navrhu CM7/CM4 — oprava IPC + srovnani s v0.4.0
    Rozdeleni tasku mezi jadra uz v repu bylo (NAVRH_ARCHITEKTURA_CM7_CM4.md).
    Misto duplikatu doplnena §11 s revizi.
    KRITICKY NALEZ — navrzene IPC by nefungovalo:
    §3 navrhuje seqlock nad sdilenou SRAM4 (0x38000000), jenze MPU_Config() v
    main.c konfiguruje jen region 0 (framebuffery, WT) a region 1 (scratch, WBWA).
    Pro 0x38000000 zadny region NENI -> plati vychozi mapa ARMv7-M, kde je
    0x20000000-0x3FFFFFFF Normal cacheable write-back. CM7 by si tedy sdilenou
    pamet nakesoval: jeho zapisy by uvizly v D-cache (CM4 bez cache je neuvidi)
    a jeho cteni by vracelo zastarale radky. Seqlock to nezachrani, protoze se
    kesuje i samotne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
2026-07-20 docs(status): TODO kapitola "Prechod na dve jadra" (#19-#30)
    Rozdeleni prace mezi CM7/CM4 dosud zilo jen v navrhovem dokumentu
    (NAVRH_ARCHITEKTURA_CM7_CM4.md) a nebylo videt v TODO. Prevedeno do
    sledovatelnych polozek pod vlastni kapitolou; cislovani navazuje na hlavni
    tabulku, takze odkazy #N zustavaji jednotne pres cely soubor. Puvodni tabulka
    dostala pro symetrii nadpis "Hlavni (mereni, UI, HW)".
    Obsah kapitoly (#19-#30):
    - #19 🔴 MPU region pro SRAM4 + seqlock s barierami — MUSI predchazet cemukoli
    IPC. Navrzene IPC by dnes nefungovalo: MPU_Config() ma jen regiony 0 a 1
    (obe SDRAM), pro 0x38000000 zadny neni -> vychozi mapa ARMv7-M dela z SRAM4
    cacheable write-back a CM7 by si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
2026-07-20 docs(status): migracni zebrik na dve jadra rozepsan do kroku M0-M12
    Kapitola "Prechod na dve jadra" mela dosud jen cile (#19-#30), ne postup.
    Doplnena podsekce "Postup migrace krok za krokem" — zadani zebriku je, ze po
    KAZDEM kroku musi pristroj dal merit a zobrazovat, krok musi jit samostatne
    overit a samostatne vratit zpet. Zadny krok neni "velky tresk".
    Kazdy krok ma sloupce: cil / jak overit (kriterium PASS) / navrat zpet /
    ktery ukol pokryva. Nad tabulkou regresni minimum, ktere se pousti po kazdem
    kroku (selftest 7/7, porovnani `status` s baseline z M0, kontrola displeje,
    30 min behu bez watchdog resetu).
    Dva kroky nepridavaji nic funkcniho a existuji CISTE kvuli validaci — jsou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
2026-07-23 feat(ui): animacni sada + oprava USB freezu (stack overflow) + audit kodu
    Animace:
    - fix: animace se nespoustely -> RTC_SYSCFG2_MAGIC bump (legacy BKP_DR6 nuloval
    g_anim_enabled/digit_anim pri warm resetu, bez legacy-guardu jako casova zona)
    - feat: subokno "PRIKLADY ANIMACI" (s_view=25) -- 6 typu animaci nepretrzite ve
    smycce (nezavisle na g_anim_enabled), overeni v izolaci
    - feat: tap-flash (2px accent obrys) jen na in-place prepinacich (Animace/Cas/
    Trend); navigacni tlacitka/pilulky bez flashe (1 frame navic = zbytecne zdrzeni)
    - fix: zvyrazneni zmenene cislice jen pro CELOCISELNOU cast (ne jitrujici zlomek)
    Logovani chyb:
    - "uptime od posledni" u senzoru (err_last_ms -> UART sens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
    [anim.h, app_gpsdo.c, app_gpsdo.h, digit_group.c, fpga_freq.c, fpga_freq.h, rtc.c]
2026-08-02 feat(ui): Math/Limity, SESTAVY, self-survey, prehled kanalu, warm-up + autocal/screenshot WIP
    Okna: MATH/LIMITY (s_view=31, Y=Mx+B + NULL + limit pass/fail alarm),
    PREHLED KANALU (s_view=30), SELF-SURVEY (s_view=32), SESTAVY (s_view=33,
    W25Q SETUP region), GRAFY (s_view=29) + vertikalni bargraf. Warm-up OCXO
    z realne teploty v Holdoveru. Nove moduly: meas_math, setup, sensor_hist,
    autocal (WIP), screenshot (WIP), segmented (libui). syscfg magic -> SCF8,
    DATA_BASE 0x020000->0x030000 (datalog re-init). Selftest 10/10.
    [ads1115.c, ads1115.h, alarm.c, alarm.h, app_gpsdo.c, autocal.c, autocal.h, bargraph.c]
2026-08-02 feat(hw): FPGA carrier v2.0 — aktualizace schematu + PCB + checklist
    KiCad FPGA_Module_2_0 (FPGA_Core/GPSDO/I2C_devices/power_supply schemata,
    PCB layout, project), BOARD_V20_CHECKLIST.md. Odstranen zastaraly
    FPGA_module_schematic.pdf (nahrazen exportem FPGA_module.pdf).
    [FPGA_Core.kicad_sch, FPGA_module.kicad_pcb, FPGA_module.kicad_sch, GPSDO.kicad_sch, I2C_devices.kicad_sch, power_supply.kicad_sch]
2026-08-06 feat(ui,perf): granularni bargraf + optimalizace AA rohu/oblouku + docs SD/SCPI/ETH
    UI (app_gpsdo.c, CLAUDE.md, STATUS #47):
    - PREHLED KANALU: horizontalni bary prepsany na segmentovane (HB_SEGS=45) s
    barevnymi markery AKT (vypln zelena/amber) / REF (nominal) / MIN (violet) /
    MAX (cervena) z g_sensors[].min/max. Legenda hbar_legend, change-detect +min/max.
    - fix: legenda kolidovala s centrovanym titulkem -> presun do footeru
    - fix: RF radek nom=-1 sentinel + lo=-80 -> falesny REF marker -> nom=-100
    perf libprim (chrome-render path, pixel-identicke, ZADNA zmena float->int; CM7 ma HW FPU):
    - fill.c aa_corner: coverage LUT per polomer misto 4 subsample/px (karty/tlacitka/
    pilulky/stopy b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
    [app_gpsdo.c, datalog_sd.c]
2026-08-06 perf(gfx): dedup dirty rectu v copy-forward (present)
    prim_stm32_hal.c: prev+cur dirty seznamy se casto shoduji/prekryvaji (freq rect a
    stat karty se prekresluji kazdy snimek -> jsou v OBOU) -> bez dedup se stejna oblast
    kopirovala vICEkrat (DMA2D blit + wait navic/rect) v kontinualni 30 Hz present ceste.
    copy_forward_dedup(): pred kopirovanim vyhodi SHODNE a plne OBSAZENE obdelniky
    (rect_covers). Kopirovana mnozina = PRESNE sjednoceni vstupu (keep drzi jen puvodni
    obdelniky, nikdy vetsi) -> pokryti se nikdy nezmensi => ZADNE riziko problikavani/duchu.
    Zadny bbox-merge (kopiroval by mimo dirty). O(n^2), n<=2*MAX_DIRTY(96), 1x/present.
    Meze: dedup branch bezi jen pri dfull=0 (kazdy seznam <=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
2026-08-07 feat(ui): okno MERENI (#67) + meas_present engine + fix soubehu survey (S2)
    meas_present.c/h (pure-logic + selftest 11/11, wired do run_selftests):
    - perioda T=1/f, odchylka Hz/ppm/ppb/ppt/rel, auto-nominal (nejblizsi kulata),
    freq offset, statistika Welford (mean/sigma/min/max/p-p), TFOM (odhad z GPS).
    - SELFTEST_N 10->11 (freertos_shared.h + freertos.c + okno Selftest spacing 22->20).
    Okno MERENI (s_view=34) - sesterske k Citaci (footer "MERENI >" / "< CITAC", bez
    nav_push): radky Primarni(FREKV/PERIODA)/Nominal/Odchylka/Offset/TFOM/N/Prumer/
    sigma/p-p; tlacitka MODE/JEDNOTKA/RESET. Vzorky z app_gpsdo_tick_stats_sample
    (1/s, jen RUN). Nad screen_main_freq_hz() = SIMULACE -> plny smysl p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
    [app_gpsdo.c, meas_present.c, meas_present.h]
2026-08-07 fix(ui): okno MERENI - jen Hz/ppm/ppb/ppt jednotky + cleanup komentaru/stale UI
    Audit okna MERENI (#67):
    - cyklus jednotky omezen na Hz/ppm/ppb/ppt (% MP_UNIT_REL): REL (raw zlomek ~1e-9)
    by se ve fmt_fixed(,4) zobrazil vzdy jako 0.0000; pouzivatel zada tyto 4.
    Cleanup komentaru + stale UI:
    - Alarmy okno: "Frekv. limit: TODO (Faze 0)" -> "hlidano (4x pip)" (#44 hotovo).
    - freertos_shared.h: selftest komentar doplnen na vsech 11 testu ([7]-[10]).
    - menu komentar: 4. rada je Animace/Math/Status ribbon (12/12 obsazeno), ne
    "Placeholder N"; ACT_PLACEHOLDER upresnen jako nepouzity hook.
    Nezkompilovano - overit pri buildu.
    [app_gpsdo.c]
2026-08-07 feat(scpi): SCPI-99 jadro + USB CDC transport (#25)
    Transportne nezavisle jadro scpi.c/h:
    - parser: case-insensitive, kratka/dlouha forma (MEAS<->MEASure), ':' hierarchie,
    '?' dotazy (kw_match + hdr_match).
    - 10 prikazu: *IDN? *OPC? *RST *CLS, SYST:VERS?/ERR?/TEMP?/GPS:STAT?, MEAS:FREQ?,
    STAT:OPER:COND?. Realna data (g_sensors/gps_get/FPGA driver).
    - golden rule: MEAS:FREQ? = REALNY FPGA (fpga_freq_get_last), ne sim -> SCPI NaN
    9.91E37 dokud #2. Bez %f/%E (celociselna extrakce, float-printf je vypnuty).
    USB napojeno: konzolovy prikaz "scpi <cmd>" (freertos_task_uart.c) + help; prefix
    "scpi " jen pro sdilenou konzoli (TCP 5025 na CM4 bude volat scpi_process primo).
    Selftest 12/12: scp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
2026-08-07 fix(scpi)+cleanup: kw_match zkracenina *cmd + odstranen mrtvy ACT_PLACEHOLDER
    Extended audit SCPI:
    - kw_match: mand = pat_len - koncova mala abbreviace (drive vedouci velka pismena).
    '*' u common commandu (*IDN) neni A-Z -> mand=0 -> matchnul zkraceniny (*ID?,
    *?, scpi ? -> vracely IDN string). Fix + 3 selftest guardy (*ID?/?/SYST:TEMPXY?
    musi vratit chybu).
    Cleanup:
    - odstranen mrtvy ACT_PLACEHOLDER (3 reference: enum, menu_activate case, touch
    guard) - 12/12 dlazdic obsazeno realnymi funkcemi, zadna neni placeholder;
    guard "if(act != PLACEHOLDER) nav_push" zjednodusen na nepodmineny nav_push
    (behavior-preserving).
    - okno MERENI komentar: "selftest 11/11" -> count-agnostic, "Hz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
    [app_gpsdo.c, scpi.c]
2026-08-08 feat(gps): GLONASS multi-souhvezdi - per-talker GSV + sky plot prefix
    GSV mel jeden akumulator -> prichozi GLGSV (msgnum=1) vynuloval prave
    nasbirany GPGSV (a naopak) -> souhvezdi se navzajem prepisovala. Ted
    per-talker akumulace (gsv_state_t: acc/done/inview per souhvezdi),
    bezstavove jadro gsv_feed/gsv_merge/gsv_constel kryte gps_selftestem.
    gps_sat_t ma nove pole constel, GPS_MAX_SATS 16->24. Sky plot i bargraf
    zobrazuji RINEX prefix PRN (G05/R68/E12/C07); barva zustava dle C/N0.
    GLONASS se zapina na HW pres UART "gps glonass" (UBX-CFG-GNSS
    GPS+SBAS+QZSS+GLONASS) - best-effort, opt-in (nevola se z gps_init,
    reconfig nejde overit bez HW). STATUS.md: HW verifikacni checklist cyklu.
    Preloz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
2026-08-08 feat(scpi): error queue + SET prikazy + rozsirene dotazy (#25)
    Chybova fronta SCPI-99 (SYST:ERR? popuje 8-mistnou frontu, *CLS maze,
    neznamy prikaz -> -113). Nove dotazy: MEAS:FREQ:DIV16?, SYST:GPS:TIME?/
    POS?, CALC:DATA?/LIM:FAIL? (Math+limit pres meas_math). SET prikazy +
    parsovani argumentu (cislo 1e6/-2.5/1.5E-3, bool ON/OFF/1/0):
    CALC:MATH:STAT/M/B, CALC:NULL:STAT/ACQ, CALC:LIM:STAT/LOW/UPP (+ ?
    readback). Zapis g_meas_cfg z UartTasku pod kratkou kritickou sekci
    (bez roztrzeneho double u UiTasku). Selftest rozsiren (fronta, parsery,
    setter nad lokalni cfg).
    Prelozeno ciste (arm-gcc -Wall -Wextra -Wshadow -fanalyzer); logika
    kryta scpi_selftestem, overit na HW pres "scpi <cmd>".
    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
    [scpi.c, scpi.h]
2026-08-08 feat(datalog): 512B RMW layer SD backendu + selftest
    Napsan blokovy read-modify-write layer (genericky blk_io_t + blk_read/
    blk_write): preklad libovolneho byte-offsetu na 512B bloky vc. spanningu
    a RMW castecnych bloku (aby zapis 32B zaznamu neprepsal sousedy).
    sd_read/sd_write ho uz volaji; chybi jen HAL 512B primitiva (sd_hal_rd/
    wr, cekaji na SDMMC1 v .ioc). Kryte datalog_sd_selftestem (RAM fake
    blok, bez HW) volanym z datalog_selftest -> SELFTEST_N zustava 12.
    SD backend zustava neaktivni (probe()==false), datalog jede dal na W25Q.
    Prelozeno ciste (arm-gcc -Wall -Wextra -Wshadow -fanalyzer).
2026-08-08 feat(scpi): IEEE 488.2 status model + compound + Hz jednotky (#25)
    Rozsireni SCPI parseru (na modulovem stavu, jedna session):
    - IEEE 488.2 status model: *ESR?/*ESE/*SRE/*STB? (latch CME/EXE do ESR,
    cteni ESR maze), *OPC (event bit0)/*WAI/*TST?.
    - Compound prikazy (';' oddelovac): scpi_process rozdeli zpravu na jednotky,
    odpovedi dotazu spoji ';' (napr. *CLS;*ESE 32;*ESR?). Rychla cesta bez ';'
    je byte-identicka -> zadna regrese.
    - Chybova fronta: SYST:ERR:COUN? + SYST:ERR:NEXT? alias.
    - Frekvencni jednotky v parseru cisel: 10.1MHZ/100KHZ/1GHZ/2M (mega=velke i
    male M, jen Hz domena).
    - SYST:TEMP? [OCXO|BOARD|MCU|FPGA] selektor cidla; FETCh:FREQ? alias;
    MEAS:FREQ:ALL? (obe vetve); S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
2026-08-09 feat(scpi): per-session kontext + realne dotazy napeti/RF/gate/uptime (#25)
    - Per-session kontext scpi_ctx_t: chybova fronta + IEEE 488.2 status registry
    (ESR/ESE/SRE) presunuty z modulovych globalu do struktury. scpi_process_ctx
    (ctx,...) = nezavisla session; scpi_process(...) = tenky wrapper nad sdilenym
    defaultem (USB konzole beze zmeny) -> soubezny TCP 5025 jen alokuje vlastni
    scpi_ctx_t per spojeni. Selftest ma i test izolace dvou kontextu.
    - Rozsireni stromu (vse realna HW data): SYST:UPT? (uptime), MEAS:VOLT?
    [P12|P5|VC|VREF|VBAT] (napeti vetvi z ADS/ADC3, ve V), MEAS:POW? (RF dBm
    z AD8307 pres g_calib), SENS:FREQ:GATE? (hradlo [s]) + SENS:FREQ:CHAN?.
    - Prelozeno ciste (ar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
2026-08-09 feat(ipc): CM7 strana IPC - publisher snapshotu + selftest (#19/#20)
    - ipc.c (CM7): ipc_init (razitko magic/verze/size v SRAM4), ipc_publish
    (seqlock zapis JEN realnych dat z fpga_freq_get_last/gps_get/g_sensors/
    health, ~2 Hz z defaultTask; statistika sigma/offset/drift zamerne
    neplnena dokud #2 = simulace headline), ipc_service (cmd->resp ring, NOP
    echo skeleton), ipc_cm4_alive (heartbeat liveness), ipc_selftest.
    - Zapojeno v StartDefaultTask: ipc_init pred smyckou, publish+service ve
    smycce. 13. selftest (SELFTEST_N 12->13); okno Selftest reflow (krok 18).
    - Seqlock (ipc_shared.h) + MPU region 2 non-cacheable uz existovaly; ipc.c
    je poprve realne pouziva. CM7 strana bezi uz te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
    [app_gpsdo.c, ipc.c, ipc_shared.h]
2026-08-09 fix(ipc): selftest na lokalni instanci - odstranen soubeh s publisherem
    ipc_selftest sahal na sdileny g_ipc (ipc_init memset + destruktivni ring test),
    zatimco defaultTask ~2 Hz publikuje/servisuje tyz g_ipc -> pri UART "selftest"
    za behu race (dva tasky na cmd ringu -> korupce head/tail -> falesny FAIL;
    rozecteny snapshot). Boot byl OK (smycka jeste nebezela), jen runtime re-run.
    Reseni: seqlock/ring helpery parametrizovany ukazatelem (ipc_snap_wr_*/rd_*,
    ipc_ring_cmd/resp_push/pop nad danym snapshotem/ringem); g_ipc-vazane zkratky
    zachovany pro produkcni kod (call-sites beze zmeny). ipc_service rozdelen na
    ipc_service_rings(core). Selftest bezi nad lokalni static ipc_shared_t -> zadny
    sdi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
    [ipc.c, ipc_shared.h]
2026-08-09 feat(scpi): MMEM datalog dotazy (CAT/DATA/COUNt) pres SCPI (#25)
    - MMEM:CATalog? -> souhrn logu ("<backend>",records,capacity,last_seq,
    write_errors,wrapped). MMEM:DATA:COUNt? -> pocet zaznamu. Oba pres
    datalog_get_status (jen cache, zadne flash I/O -> bezpecne i pred datalog_init).
    - MMEM:DATA? <n> -> n-ty zaznam od nejnovejsiho jako CSV (seq,t_unix,freq[Hz],
    t_ocxo,t_board,vc_mv,rf_dbm,flags,sats,hdop; neplatne 16b -> NaN 9.91E37). Cte
    W25Q pod QSPI mutexem (blokujici) -> jen na explicitni dotaz, ne v selftestu.
    - Realna logovana data (freq z FPGA = 0 dokud #2, NE simulace). Selftest
    rozsiren o cache-dotazy MMEM:CAT?/DATA:COUN?.
    - Prelozeno ciste (arm-gcc -Wall -Wextra -Wshadow).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
2026-08-09 feat(dualcore): dokonceni CM7/CM4 IPC linku + bring-up checklist (#20)
    Obousmerny IPC link je ted KODOVE kompletni na obou stranach:
    - CM4 (NOVE ipc_cm4.c/h): ipc_cm4_check/read (seqlock, bounded retry <=8) +
    ipc_cm4_heartbeat; zapojeno v CM4 main.c smycce (LED_2 sviti pri GPS fixu ze
    snapshotu = viditelny dukaz round-tripu). Sdileny ipc_shared.h relativnim
    include (regen-safe).
    - CM7 ted CTE CM4 heartbeat: defaultTask -> ipc_cm4_alive() -> g_cm4_alive ->
    CPU blok headeru trojstav "4:OK" (zelene) / "4:--" / "4:off" (screen_main).
    DUALCORE_BRINGUP_CHECKLIST.md: kompletni HW aktivacni postup (option bytes
    BCM4=1 + BOOT_CM4_ADD0=0x0810, flash obou bank, SRAM4 clock, .ioc regen pozor
    na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
    [ipc_cm4.c, ipc_cm4.h, main.c, screen_main.c]
2026-08-09 fix(ipc): CM4 read per-read kontrola magicu + kriticke doplneni bring-up docu
    Kriticky re-audit dvoujadra odhalil realnou diru: ipc_init() dela memset g_ipc
    na CM7 BEZ seqlocku -> pri bootu uzke okno, kdy je snapshot vynulovan (seq=0,
    sude = "konzistentni", magic=0) a CM4 by ho precetl jako platny (vynulovana data).
    Fix: ipc_cm4_read overuje out->magic == IPC_MAGIC po seqlock kopii -> odmitne
    vynulovany/torn/re-init snapshot bez ohledu na s_ready latch. Levne, robustni.
    Doc doplneni (drive podcenene / nezmineno):
    - Shareability: CM4 nema MPU pro 0x38000000, CM7 ma shareable -> ordering drzi
    jen na DMB; pri tearingu pridat CM4 MPU region. "Nema cache -> nepotrebuje MPU"
    plati jen pro ca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
    [ipc_cm4.c]
2026-08-09 feat(dualcore): CM4 IWDG2 watchdog + stall:CM4 detekce na CM7 (#21)
    CM4 (iwdg2.c/h): nezavisly watchdog ~4 s (LSI /64, reload 2000), registrova
    sekvence zrcadli CM7 watchdog.c (HAL_IWDG modul vypnuty). iwdg2_init po beep
    melodii (mimo timeout), iwdg2_kick v kazde iteraci smycky -> zaseknuta CM4
    smycka -> IWDG2 reset CM4. V DEBUG freeze na breakpointu (APB4FZ2).
    CM7 (freertos.c defaultTask): stall:CM4 z hran heartbeatu -> alive->dead loguje
    "stall:CM4" + g_cm4_stall_count, dead->alive loguje "obnoveno". Viditelne v UART
    "status" (CM4: ABSENT/alive/SILENT, stall x<n>). CM7 se kvuli mrtvemu CM4
    NERESETUJE (NAVRH §11.4) a NESAHA na crash black-box (ten = pricina resetu CM7);
    CM4 se zotavi vlas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
    [iwdg2.c, iwdg2.h, main.c]
2026-08-09 docs(claude): CLAUDE.md o dvoujadro (IPC CM7<->CM4) + IWDG2
    - Novy oddil "Dvoujadro / IPC": SRAM4 sdilena pamet + seqlock, ipc.c publisher,
    CM4 ipc_cm4.c konzument (relativni include, per-read magic), heartbeat ->
    g_cm4_alive -> CPU blok 4:OK/--/off, stall:CM4, D2 split, boot gate/g_cm4_absent.
    - IWDG sekce rozsirena o IWDG2 (CM4 watchdog, reset scope OVERIT NA HW).
    - Prehled: CM4 popis aktualizovan (konektivita/IPC/IWDG2, dnes nebootuje).
    - status prikaz + defaultTask popis + odkazy na DUALCORE_BRINGUP_CHECKLIST.md.
2026-08-09 feat(ipc): snapshot v2 - plna instrument-state pro SCPI/web na CM4 (#20)
    Kriticka validace rozdeleni jader (NAVRH §11.8): mereni-kriticke periferie
    (FPGA SPI2, GPS, senzory I2C, RTC, beeper) ZUSTAVAJI na CM7 - presun na CM4 by
    oslepil pristroj pri padu konektivity (§11.4), a CM7 hrdlo je render (D1,
    nepresunutelne) -> presun neuleví. CM4 = jen sit (ETH/SCPI-TCP/web).
    Dusledek validace = datovy kontrakt: aby byl split realizovatelny, snapshot musi
    nest KOMPLETNI instrument-state (CM4 nema g_sensors/g_calib). Rozsireno (IPC_VERSION
    1->2): teploty OCXO/deska/MCU, napeti 12V/5V/VREF/VBAT/Vc, RF mV + AD8307 kalibrace
    (aby CM4 spocital dBm), Si5356 stav, kanal. Bez toho by SCPI MEAS:VOLT?/SYST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
2026-08-09 feat(ipc): Math cfg config sync pres cmd ring (v3) (#20/#25)
    Dokonceni datoveho kontraktu pro SCPI/web na CM4 (navazuje na v2 senzory):
    - CTENI: cfg mirror ve snapshotu (math_m/b/null_ref/lim_lo/hi + flagy) -> CM4
    obslouzi CALC: readbacky + CALC:DATA?/LIM? bez g_meas_cfg.
    - ZAPIS: cmd ring IPC_CMD_CFG_SET (key IPC_CFG_MATH_EN/M/B/NULL_EN/NULL_ACQ/
    LIM_EN/LO/HI + arg/argd) -> CM7 ipc_service aplikuje na g_meas_cfg pres
    ipc_cfg_apply (mirror scpi_calc_set), commit JEN pri realne zmene (kriticka
    sekce; jinak by 100Hz commit klobrcoval soubezne UI/USB zapisy). NULL_ACQ
    bere realny FPGA kmitocet.
    - g_meas_cfg zustava SINGLE-WRITER na CM7 (CM4 jen navrhuje zmeny pres ring).
    ipc_cmd_t ro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
2026-08-09 docs(status): TODO CM4 SCPI/web konzument - co pouzije IPC v3 (#25/#26)
    Dokumentuje budouci CM4-stranu, ktera spotrebuje hotovou IPC infrastrukturu:
    - CTENI z IPC snapshotu (v3 = freq + plne senzory + kalibrace + GPS + Math cfg
    mirror) -> MEAS/SYST/CALC read dotazy.
    - ZAPIS pres cmd ring IPC_CMD_CFG_SET -> CALC SET.
    - 🔴 Klicovy refaktor: scpi.c je transportne nezavisle, ale NE data-source
    nezavisle - handlery dnes ctou CM7 globaly (g_sensors/g_calib/fpga_freq/
    g_meas_cfg) primo. Na CM4/TCP musi cist snapshot -> nutna abstrakce zdroje dat
    (provider/dva backendy: CM7-USB=globaly, CM4-TCP=snapshot).
    - ⚠️ SET->readback latence <=~0,5 s (cmd ring ~10ms + snapshot ~2Hz).
    - #26 web: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
2026-08-10 perf(ipc): audit komunikace CM7<->CM4 - liveness + event-driven publish (#20/#21)
    Kriticky audit IPC (NAVRH §11.9). Implementovana 3 zlepseni:
    A. 🔴 CM4 detekce zamrzleho CM7 (robustnost): ipc_cm4_read vracel posledni
    snapshot jako platny i kdyz CM7 zamrznul (seqlock konzistentni, jen seq stoji)
    -> CM4 by serviroval STARA data jako aktualni. Novy ipc_cm4_cm7_alive(now_ms)
    sleduje rust seq (>2 s beze zmeny = mrtvy CM7); CM4 smycka snapshotu neduveruje,
    kdyz CM7 nezije. Symetricke k CM7 ipc_cm4_alive, naplnuje §11.4.
    B. 🟡 Event-driven publish: pevny 2 Hz throttle vs FPGA ~4 mereni/s podvzorkovaval
    (SCPI/web videl kazde druhe mereni, data az 500ms stara). ipc_publish te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
2026-08-10 perf(ipc): ipc_service fast-path na prazdny cmd ring (2. audit pass) (#20)
    Kriticky re-review vlastnich zmen A-C odhalil dalsi nalez: ipc_service bezi 100 Hz
    z defaultTasku a i s PRAZDNYM cmd ringem (bezny stav - CM4 posila config zridka)
    delal kazdy tik 2x kopii g_meas_cfg (IRQ-off) + fpga_freq_get_last (IRQ-off) +
    memcmp naprazdno. Pridan fast-path head==tail early-out (SPSC prazdny check =
    porovnani dvou volatile citacu) -> idle cesta prakticky zdarma.
    Zbytek re-review (A CM7-liveness, B event-driven publish, C cfg mimo seqlock)
    obstal; drobne poznamky (A grace od t=0 pri seq==0, B bez min-interval floor,
    oboji benigni) v NAVRH §11.9.
    Prelozeno ciste (arm-gcc -Wall -Wextra -Wshadow).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
2026-08-12 fix(boot): preteceni stacku defaultTask + per-core RCC na CM4 (#10/#23)
    Boot-loop po naflashovani obou bank: gps_selftest() mel 1760 B stack frame,
    ale run_selftests() bezi v defaultTasku s 1536 B. Preteceni proletelo POD
    stack do FreeRTOS heapu (stacky se alokuji z ucHeap hned nad mutexy a rostou
    dolu) a prepsalo kontrolni blok qspiMutexHandle -> configASSERT(uxItemSize==0)
    v osMutexAcquire -> taskDISABLE_INTERRUPTS + for(;;) -> IWDG1 reset po 4 s.
    Diagnostika bez konzole: RCC->RSR mel IWDG1RSTF, crash black-box byl prazdny
    (stall vetev se nespustila, protoze watchdog_supervise se vola Z defaultTasku)
    a xTickCount zamrzl na 55. GDB attach ukazal presny configASSERT.
    - gps_selftest: gsv_st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
    [gps.c, main.c, scpi.c]
2026-08-12 feat(ui): jemnejsi horizontalni bargrafy + oprava -Wformat-truncation (#47)
    Okno PREHLED KANALU (s_view=30): HB_SEGS 45 -> 64, tedy segment 8 -> 5 px
    a krok 2,22 -> 1,56 %. Geometrie je parametricka (hb_seg si sw dopocita,
    hb_marker_idx skaluje pct), takze staci menit jednu konstantu — prizpusobily
    se i markery MIN/MAX/REF.
    Fyzikalni strop je blizko: panel ma 8,54 px/mm, takze 5px segment = 0,59 mm
    a markery kresli JEDINY segment. Pod ~4 px uz bude barevny prouzek spatne
    rozeznatelny; dalsi zjemneni by chtelo zmensit mezeru na 1 px, cimz se ale
    setre "LED bar" vzhled. Zapsano v komentari u HB_SEGS.
    setups_render_dynamic: sn[8] -> sn[12]. Slot je vzdy 1..8, ale GCC to z int
    nedokaze dovod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
2026-08-12 feat(sd): SDMMC1 + FatFs z CubeMX vcetne regen-safe ochran (#28)
    .ioc: SDMMC1 4-bit (PC8-11 = D0-D3, PC12 = CK, PD2 = CMD s pull-upem, AF12),
    ClockDiv=2 -> SDMMC_CK 16 MHz; FATFS -> SD Card s Detect_SDIO na PE3
    (GPIO_Input + pull-up, label SD_DET). Piny overeny proti schematu list 7/7.
    Tri zasahy do generovaneho kodu, vsechny v USER CODE (prezijou regen):
    1) sdmmc.c / MX_SDMMC1_SD_Init: vyplni handle a hned se vrati. CubeMX tam ma
    na selhani HAL_SD_Init volani Error_Handler(), coz na CM7 znamena
    __disable_irq() + bootled_fail() = mrtvy pristroj — a HAL_SD_Init selze
    VZDY, kdyz neni vlozena karta. Skutecny init dela az BSP_SD_Init() pri
    mountu, kde je selhani legitimni vyslede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
    [H757_LED.ioc, main.c, main.h, sdmmc.c]
2026-08-12 feat(sd): export datalogu na SD kartu pres FatFs + diagnostika (#28)
    Architektura: W25Q zustava AUTORITATIVNI uloziste datalogu, SD je JEN export.
    W25Q uveze ~600 dni, takze o data se neprijde; SD slouzi k tomu, k cemu ma —
    vytahnout a precist na PC. Tim odpadaji tri problemy, ktere by melo "SD jako
    primarni uloziste": kontinuita seq pri vytazeni karty, prepis MBR pri RAW
    zapisu, a ztrata dat pri vyjmuti.
    DATALOG_SD_RAW_OK zustava 0 a takove zustane — RAW blokovy zapis by sel od
    LBA 0 a znicil kartu pro PC.
    Delba podle toho, co blokuje (klicove):
    - sd_export_tick() — levny (GPIO + rychly f_mount(NULL)) -> defaultTask ~2 Hz
    - mount/export/test — BLOKUJI (HAL_SD_Init desitky-stovky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
    [datalog.h, datalog_sd.c, sd_export.c, sd_export.h]
2026-08-12 docs: plan ETH (F0-F8), priprava encoderu, HW checklist, TODO + zapis nalezu
    Nove dokumenty:
    - ETH_BRINGUP_CHECKLIST.md — etapovy plan ETH/SCPI/web na CM4 (F0-F8, mapovani
    na M9-M12). Ridici princip: kazdy nevratny zavazek az po levnem dukazu, proto
    F0 overi PHY z CM7 bit-bangem MDIO BEZ regenerace .ioc a volba
    "FreeRTOS vs holá smycka" se zamerne rozhoduje az v F4.
    Obsahuje i pripad, kdy PHY neodpovi: nejlevnejsi unik je hned po F0.
    - ENCODER_J7_NAVRH.md — #29. Hlavni zjisteni: TIM1 kvadratura je ta snadna cast,
    skutecna prace je model fokusu, ktery v dotykovem UI vubec neexistuje.
    Piny POTVRZENY ze schematu list 2/7: PA8/PA9 = ENCODER_CH1/2 (TIM1 CH1/CH2),
    PC13 = tlacitk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
2026-08-12 fix(sd): s_busy pres wrapper + zamek run_selftests proti soubehu (#28/#10)
    Dva nalezy z kritickeho auditu. Oba stejne tridy: priznak/zamek se nastavil
    na jednom miste a mel se rusit na mnoha, coz se nepovedlo uhlidat.
    sd_export.c — s_busy (drzi auto-unmount po dobu prace s kartou):
    - sd_export_selftest() ho nenastavovala VUBEC. Moje skriptovana uprava
    z minule minule tise neprobehla a ja ji chybne odsouhlasil poctem vyskytu.
    Souběh `sd test` x auto-unmount v defaultTasku byl tedy porad otevreny.
    - sd_export_run() ho nevycistila na zadne chybove ceste (prazdny log,
    f_open, f_write) — jediny neuspesny export natrvalo vypnul auto-unmount.
    Misto zaplatovani ~10 navratovych cest je t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
    [app_gpsdo.c, sd_export.c]
2026-08-12 chore(ide): .mxproject po SDMMC1/FatFs + .settings/.launch po reimportu projektu
    Stav IDE, ktery se doted vlekl v pracovnim strome:
    - .mxproject — dopad generovani z CubeMX po zapnuti SDMMC1 + FATFS
    (seznamy zdrojaku/HAL modulu). Patri ke commitum 90bb891/bccf1f7,
    jen se tehdy nezacommitoval.
    - CM7/.settings + .launch — projekt se musel reimportovat, protoze model
    IDE neznal nove soubory (FatFs, hal_sd) a generovane makefily v Debug/
    proto neobsahovaly ani jejich subdir.mk, ani zaznamy v objects.list
    (ten nema v makefile zadne pravidlo, zapisuje ho IDE). Reimport model
    postavil od nuly; docasna zaplata CM7/makefile.defs uz neni potreba
    a byla odstranena.
    - CM4/.settings +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
2026-08-12 fix: dokonceni nalezu z auditu — diagnostika selftestu, mrtvy Init, torn-read RTC
    Zbytek seznamu z kritickeho auditu (s_busy a zamek selftestu resil predchozi
    commit). Vsechno nezavisle na HW, overeno jen prekladem — NENAFLASHOVANO.
    scpi.c/h — selftest rekne, KTERY assert spadl:
    Bylo ~90 kontrol slitych do jedne navratove hodnoty, takze hlaseni "SCPI
    parser FAIL" pri startu nedavalo zadne voditko. Test se navic neda spustit
    jinde nez na cili: na tomhle stroji neni nativni C kompilator (jen
    arm-none-eabi), takze ani pure-logic jadro nejde prohnat na PC.
    Reseni: uvnitr funkce se `ok` expanduje na `*scpi_st_chk(__LINE__)`, takze
    z `ok &= X` je `*scpi_st_chk(L) &= X`. Chk se d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
    [datalog_sd.c, scpi.c, scpi.h]
2026-08-12 fix(scpi): oprava selftestu (NULL:ACQ zapina relativni rezim) + 9 novych prikazu (#25)
    PRICINA "SCPI parser FAIL" pri startu — nalezena ctenim, ne hadanim (HW odpojen
    a na tomhle stroji neni nativni C kompilator ani WSL, takze pure-logic test
    nejde spustit nikde nez na cili):
    ok &= (scpi_cfg_apply(&c, SCPI_CFG_NULL_ACQ, 0, 0, 1e7) == 1);
    double y = meas_math_apply(&c, 1e7); /* 2*1e7+100 <- ocekavani */
    ok &= (y > 20000099.0 && y < 20000101.0);
    `meas_math_capture_null()` (meas_math.c:37) referenci NEJEN zachyti, ale rovnou
    ZAPNE relativni rezim (`null_en = 1`). Y proto klesne na 0 a padnou dva asserty
    za sebou — druhy cekal MEAS_HI a dostal MEAS_LO (0 je pod lo = 9,9 M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
    [scpi.c, sd_export.c]
2026-08-12 fix(scpi): rozsahove pojistky formatovacu — dve pretypovani double mimo rozsah (#25)
    Kriticky audit vcerejsiho commitu 8b4792a. Dva nalezy STEJNE tridy: hodnota
    se pretypovava na celociselny cil bez kontroly rozsahu, takze pri extremnim
    vstupu nejde o "spatne cislo", ale o NEDEFINOVANE chovani.
    1) fmt_scpi_period_s (MEAS:PER?, pridano vcera)
    Hlidalo se jen `hz <= 0`. Pro hz pod ~5,5e-5 vyjde `1/hz * 1e15` nad
    UINT64_MAX (1,845e19) -> UB. Dosazitelne: staci ramec s `freq4_x100000`
    v jednotkach (10^-5 Hz), tedy i po poskozeni dat, ktere projde CRC.
    Nove: perioda nad 10 000 s = mimo rozsah -> 9.91E37. Mez je bezpecne pod
    pretecenim a zaroven hluboko za tim, co citac umi (recip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
    [scpi.c]
2026-08-13 fix(ipc): compile-time pojistka, ze SCPI_CFG_* a IPC_CFG_* sedi 1:1 (#25/#20)
    Treti pruchod kritickym auditem. Tenhle nalez jsem drive jen OZNACIL jako
    "blokujici pro ETH etapu F6", ale nikdy neoveril — ted overen a uzavren.
    Riziko je realne a horsi, nez jsem cekal: `ipc_cfg_apply()` v ipc.c je
    byte-za-byte duplikat `scpi_cfg_apply()` ze scpi.c, jen s druhou sadou jmen.
    CM4 SCPI parser vyrobi `SCPI_CFG_*` klic, posle ho cmd ringem jako
    `ipc_cmd_t.key` a CM7 ho precte jako `IPC_CFG_*` — mezi nimi NENI zadny
    prevod, je to holy prenos cisla. Vlozeni polozky do jednoho vyctu by hodnoty
    tise posunulo a treba `CALC:LIM:LOW` by zapsal do `null_ref`: bez chyby, bez
    varovani, jen spatna data.
    D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
    [ipc.c]
2026-08-13 fix(ipc): validity maska ve snapshotu (IPC_VERSION 4) + CM7 alive pri bootu (#20/#25)
    Posledni dva otevrene nalezy z auditu. Oba se tykaji toho, ze CM4 mohl
    servirovat neco jako platna data, i kdyz to platne nebylo.
    1) ipc_cm4_cm7_alive() hlasil "CM7 zije" prvni ~2 s po bootu
    `s_last_seq` i `s_last_ms` startuji na nule, takze pro zatim
    nepublikujici CM7 (seq == 0) plati `seq == s_last_seq` a funkce spadla
    rovnou na `(now_ms - 0) < 2000` = pravda. Magic uz orazitkoval
    `ipc_init`, takze `ipc_cm4_read` prazdny snapshot propustil -> CM4 by
    pres SCPI/web vracel same nuly jako aktualni mereni.
    Pridano `if (seq == 0) return 0`: "jeste nepublikoval" NENI "publikoval
    a zamrzl".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
    [ipc.c, ipc_cm4.c, ipc_shared.h]
2026-08-13 refactor: odstraneni mrtveho kodu (24 funkci) + zmereni, kam flash doopravdy tece
    ⚠️ HLAVNI ZJISTENI NEJDRIV: mazani mrtveho kodu velikost NEZMENILO.
    `.elf` je po odstraneni 24 funkci BAJT ZA BAJTEM stejny (676 612 B), protoze
    `-ffunction-sections` + `--gc-sections` nepouzite funkce zahazuje uz dnes.
    Kdo chce mensi program, musi jinam — viz nize.
    KDE FLASH DOOPRAVDY JE (z map souboru, celkem 686 KB):
    .rodata 333 KB — z toho FONTY ~285 KB = 41 % celeho programu
    (ui_font_mono_22 sam 46 KB, mono_20 39 KB, sans_18 35 KB)
    .text 353 KB
    Vsech 11 velikosti fontu se skutecne pouziva (overeno), takze tam mrtvy kod neni.
    PAKA, KTERA OPRAVDU ZABIRA: konfigurace `R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
2026-08-13 fix(libprim): dobrani QUAD/ARC z path — mrtve vetve uvnitr zive funkce (-888 B)
    Kriticky audit predchoziho commitu (3f7e373) nasel, ze jsem si tam sam vyrobil
    NAPUL odstranenou funkcionalitu.
    `prim_path_quad_to()` a `prim_path_arc()` byly JEDINI producenti operaci
    PRIM_OP_QUAD / PRIM_OP_ARC. Smazal jsem je, ale jejich zpracovani zustalo jako
    `case` vetve uvnitr `flatten()` — a to je zasadni rozdil:
    celou nepouzitou FUNKCI -> `--gc-sections` zahodi -> 0 B
    nedosazitelnou VETEV -> linker NEUMI odstranit -> stoji flash doopravdy
    Ta vetev navic drzela pri zivote cely `bezier.c` (prim_internal_quad_seg_count
    / _eval), ktery uz nemel jineho uzivatele.
    Dobrano: vetve z flatten(),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
2026-08-13 fix(ui): presna velikost bufferu v allan_ylabel + overeni, ze -Os neodemyka UB
    Kriticky audit se timto pruchodem zameril na riziko VLASTNIHO DOPORUCENI
    z minula ("stavej Release/-Os"): `-O0` neumi vypsat celou tridu varovani, ktera
    potrebuje datovy tok z optimalizatoru. Kdyby v kodu bylo latentni UB, prepnuti
    na Release by ho odemklo az na HW.
    Provereno prelozenim CELEHO projektu s -Os + -Wmaybe-uninitialized
    + -Wstrict-aliasing=2. Vysledek mimo vendor kod:
    - ZADNE -Wmaybe-uninitialized
    - ZADNE -Wstrict-aliasing
    - jedine -Wformat-truncation, viz nize
    => Prepnuti na Release neodemkne skrytou UB. Zbyva overit uz jen casovani
    (DWT delay_us, bit-bang pipani, I2C recovery) — to zadny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
    [screen_main.c]
2026-08-13 fix(scpi): selftest padal na `ok &= (vyraz & MASKA)` — akumulator je bitovy AND
    DRUHA, nezavisla pricina "SCPI parser FAIL". Nalezena diagnostikou cisla radku,
    kterou jsem pridal drive — cil ji ohlasil primo: scpi.c:880.
    ok &= (atoi(b) & 0x04); /* *STB? — bit 2 = chybova fronta neprazdna */
    `ok` se sluce BITOVYM AND a startuje na 1. Vyraz `atoi(b) & 0x04` ale pri
    USPECHU vrati 4, a `1 & 4 == 0` -> assert shodil vysledek prave tehdy, kdyz
    podminka PLATILA. Tyka se ctyr kontrol status modelu IEEE 488.2:
    880 *STB? & 0x04 (1 & 4 = 0) -> padalo
    881 *ESR? & 0x20 (1 & 32 = 0) -> padalo
    887 *ESR? & 0x10 (1 & 16 = 0) -> padalo
    895 *ESR? & 0x01 (1 &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
    [scpi.c]
2026-08-13 feat(eth): etapa F0 — pinmapa ze schematu + prikaz `eth` (bit-bang SMI z CM7) (#24)
    Prvni krok ETH podle ETH_BRINGUP_CHECKLIST.md §2. Zamerne BEZ jedineho zasahu
    do `.ioc` a bez regenerace — vsechny piny si kod konfiguruje sam, stejnym
    regen-safe idiomem jako CS ve `fpga_freq_init` nebo PE3 v `datalog_sd`.
    ⚠️ NALEZ, KTERY ODBLOKOVAL CELOU ETAPU: checklist tvrdil, ze pinmapa "v repu
    NENI". Ve skutecnosti v repu JE — `STM32H747BIT.pdf`, list 4/7 (Ethernet) a
    2/7 (CPU). Jen ho nikdo neotevrel. Vytazeno:
    ETH_REF_CLK PA1 ETH_MDC PC1 ETH_TX_EN PG11
    ETH_MDIO PA2 ETH_RXD0 PC4 ETH_TXD0 PG13
    ETH_CRS_DV PA7 ETH_RXD1 PC5 ETH_TXD1 PB13
    ETH_RES PG14 ETH_INT PG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
2026-08-13 fix(touch): HW reset dotykoveho radice pres ATTINY misto pulzu na SCL
    PRICINA (merena na cili, ne odhad). Pri mrtvem touchi jsem precetl stav
    z bezici desky:
    s_dimmed=1, s_i2c4_fail=18 (18 selhani ZA SEBOU prave ted),
    s_i2c4_rec_t = pred 3,5 s (recovery bezela a NEPOMOHLA), was_down=0
    a hlavne zmeril samotnou sbernici:
    GPIOH IDR -> SCL=1, SDA=1 (sbernice VOLNA, nikdo ji nedrzi)
    I2C4 ISR = 0x1 (zadne BUSY/NACKF/BERR/ARLO/TIMEOUT)
    Sbernice ani periferie tedy rozbite NEJSOU — FT5x06 proste neACKuje svou
    adresu. Dosavadni `i2c4_recover()` pulzuje SCL JEN kdyz je SDA v nule, takze
    lecil stav, ktery nikdy nenastal, a jinak jen reinicializoval I2C4.
    Dosazitelne priciny js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
    [ws_panel.c, ws_panel.h]
2026-08-13 docs(eth): F0 uzavrena — PHY dostava 10 MHz misto 25 MHz, ETH blokovana HW (#24)
    Vysledek etapy F0 na realnem hardwaru: `eth` neni schopen najit PHY na zadne
    z 32 SMI adres. Pricina nalezena a UZIVATELEM POTVRZENA na desce.
    DUKAZNI RETEZEC:
    - `HSE_VALUE` = 10 MHz a PLL 10x96/2 = 480 MHz presne sedi -> `X1` je 10 MHz.
    Uzivatel potvrdil i z potisku soucastky.
    - Schema list 2/7: vystup X1 se deli — **R5 (50 R) -> `RCC_OSC`** (HSE
    procesoru) a **R6 (50 R) -> `OSC_25M`**.
    - Schema list 4/7: `OSC_25M` jde na pin 5 `XTAL1/CLKIN` LAN8742A (XTAL2
    nezapojen, tedy single-ended vstup).
    - LAN8742A vyzaduje **25 MHz**. Dostava 10 -> nenabehne a neodpovi ani na MDIO.
    Jeden oscilator nemuze obsl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
2026-08-13 feat(ui): Nastaveni = rozcestnik konfigurace + nove okno SIT; Menu uvolneno
    Na prani uzivatele prestavena navigace. Rozdeleni: **Menu = nastroje, Nastaveni
    = konfigurace.**
    Z Menu se do okna Nastaveni presunuly **Cas, Alarmy, Kalibrace, Animace** a
    pribyla **Sit**. Prava polovina Nastaveni je nove **mrizka 2x5**:
    Vzhled | Jazyk (prepinace, drzi stav)
    SIT | CAS
    ALARMY | KALIBRACE
    ANIMACE| REFERENCE
    O PRISTROJI | SESTAVY (SESTAVY prestehovany z footeru do mrizky)
    Geometrie x=410/600 (w=182, mezera 8), y=72..344 (h=62, mezera 6); posledni rada
    konci 406, footer 417. Dotykovy cil 62 px = 7,3 mm, tesne nad projektovym
    minimem 7 mm. Leva polovina zustava primym ovladanim (zvu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
2026-08-13 docs(eth): proc LAN8742A potrebuje presne 25 MHz + zamitnuti MCO vypoctem
    Doplneni k F0 na dotaz, jestli by PHY nesel provozovat s 10 MHz.
    NE, a ani castecne: vnitrni PLL ma pevny pomer — z 25 MHz dela 125 MHz pro
    100BASE-TX (linkova rychlost je 125 Mbaud) a 50 MHz pro REF_CLK OUT. Neexistuje
    registr ani strap pro preladeni vstupniho kmitoctu. Pri 10 MHz by i v idealnim
    pripade vyslo 50 misto 125 MHz -> na drate by to nebyl Ethernet. Realne PLL pri
    2,5x mimo rozsah nezachyti vubec a cip zustane v internim resetu, coz odpovida
    pozorovanemu mlceni na MDIO.
    ⚠️ OPRAVA VLASTNIHO DRIVEJSIHO DOPORUCENI: minule jsem MCO z STM32 zamitl jen
    tim, ze 'PA8 i PC9 jsou obsazene'. To bylo povrchni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
2026-08-13 docs: ETH odlozeno do vymeny oscilatoru + kompletni recept na prepocet hodin
    Uzivatel se rozhodl vymenit X1 za 25 MHz TCXO. Tim ale dostane 25 MHz i HSE
    procesoru (X1 jde pres R5 do RCC_OSC a pres R6 do OSC_25M), takze se musi
    prepocitat cely strom hodin.
    CLOCK_25MHZ_MIGRACE.md — ridici myslenka: vsechny tri PLL i DSI umi pri 25 MHz
    dosahnout PRESNE STEJNEHO VCO jako dnes, kdyz se zmeni jen M a N. Dusledek:
    zadny odvozeny kmitocet se nemeni, takze se nemusi sahat na FMC/SDRAM, SPI2
    (FPGA), LTDC, ADC ani SDMMC.
    PLL1 M=1 N=96 RGE_3 -> M=5 N=192 RGE_2 VCO 960 (SYSCLK 480, SDMMC 64)
    PLL2 M=1 N=20 RGE_3 -> M=5 N=40 RGE_2 VCO 200 (SPI123 200, FMC 100)
    PLL3 M=1 N=17 FRACN=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
2026-08-13 feat(ui): Nastaveni = cisty rozcestnik; nove okno DISPLEJ, zvuk do ALARMU
    Druha iterace prestavby na prani uzivatele. Z Nastaveni zmizely vsechny prime
    ovladace a presunuly se tam, kam patri vecne:
    - jas + auto-dim -> NOVE OKNO DISPLEJ (s_view=36)
    - zvuk (mute) -> okno ALARMY (patri k tomu, co umlcuje; mute plati globalne,
    tedy i na testovaci pipnuti a startovni melodii)
    Nastaveni je diky tomu mrizka 3x4 pres CELOU sirku okna a ma ZAMERNE stejnou
    geometrii jako Menu (w=246, h=76, x=18/278/538, y=68/154/240/326) — jednotny
    vzhled obou rozcestniku a dotykovy cil 76 px = 8,9 mm (drive mela prava
    polovina 62 px = 7,3 mm, tesne nad minimem).
    Obsah: DISPLEJ | Vzhled |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
2026-08-13 fix(scpi): levne nacteni zdroje pro `*` prikazy + OPRAVA vlastniho mereni CPU
    1) SCPI (bod 10 z TODO): `scpi_process` delal plny sweep i pro `*IDN?`.
    Spolecne prikazy IEEE 488.2 (*IDN? *OPC? *CLS *ESR? *ESE *STB? *RST *WAI
    *TST?) ctou ze `scpi_src_t` JEDINE `selftest_pass`, takze pro ne nema smysl
    delat `gps_get()` v kriticke sekci (~200 B) ani `fpga_freq_get_last()`
    s vypnutymi IRQ. Nove `scpi_src_load_cm7_ex(src, full)`.
    ⚠️ Zamerne se to omezuje na `*` prikazy BEZ `;`. Sirsi maska "co ktery prikaz
    potrebuje" by sla, ale za cenu realneho rizika: spatne urcena maska = tise
    SPATNA odpoved. Tady je riziko nulove — mnozina poli, ktera `*` prikazy ctou,
    je uzavrena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
    [scpi.c]
2026-08-13 feat: dokonceni bodu 11/12/13 — SD dorovnani, encoder HW vrstva, ZMERENY scope IWDG2
    13) ⚠️⚠️ NEJDULEZITEJSI: RESET SCOPE IWDG2 JE SYSTEM-WIDE, NE PER-CORE.
    Zmereno primo na HW, ne odhadem: docasna CM4, ktera po 20 s prestala krmit
    IWDG2, shodila CELY pristroj. Uptime CM7 pak cykloval 3 -> 13 -> 22 -> 8 ->
    17 s (reset kazdych ~24 s = 20 s + timeout). Po vraceni puvodni CM4 roste
    monotonne 51 -> 63 -> 75 -> 87.
    Predpoklad "CPU2/CM4-only" z DUALCORE_BRINGUP_CHECKLIST §8 tedy NEPLATIL.
    IWDG2 proto VYPNUT — presne jak pro tenhle pripad predepisuje CLAUDE.md.
    Zapnuty by znamenal, ze zaseknuta CM4 (dnes dela temer nic) shodi i displej
    a mereni; to je v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
    [H757_LED.ioc, app_gpsdo.c, main.c, sd_export.c, sd_export.h, sdmmc.c]
2026-08-13 fix(touch): recovery uz nebusi do ATTINY — zpomalovani + klidove mezery + probe
    ⚠️ OPRAVA VLASTNI CHYBY. Predchozi verze recovery (commit 7a4e100) delala
    kazdych 5 s DONEKONECNA tohle: `HAL_I2C_Init` a hned nato DVA zapisy PORTC do
    ATTINY BEZ klidovych mezer. Kod na jinem miste pritom sam varuje, ze runtime
    zapis do ATTINY klidovou mezeru pred i po transakci POTREBUJE, jinak ztrati
    synchronizaci bit-bang slave automat.
    Co uzivatel nahlasil po ~5 minutach behu (recovery #54 az #64):
    ws_panel: write reg 0x83 = 0x0D FAILED (1) <- i ATTINY zapis selhava
    touch: I2C4 nereaguje (34 chyb, 250 x mutex busy)
    Zmereno na cili v tom stavu:
    GPIOH IDR -> SCL=1, SDA=1 (sbernice VOLN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
2026-08-13 fix(i2c4): back-off cteni TMP117 + citac mutex-busy hlasi serii, ne soucet
    Navazuje na predchozi commit (recovery uz nebusi do ATTINY). Resi druhou vec,
    ktera byla v uzivateluv logu videt: "250 x mutex busy".
    1) ⚠️ UPRESNENI VLASTNI DIAGNOSTIKY: `s_i2c4_busy` se NIKDY nenuloval, takze
    "250" byl NASYCENY SOUCET OD STARTU, ne aktualni stav. Moje tvrzeni o
    hladoveni touche bylo tim padem silnejsi, nez ta data unesou. Citac se ted
    nuluje pri kazdem uspesnem cteni -> hlasi AKTUALNI serii, coz uz pouzitelne je.
    2) Realny problem ale zustava: I2C4 sdili touch (UiTask, 15-30 Hz), podsviceni
    a TMP117 0x48 (SensorsTask 2x/s). Cteni TMP117 drzelo mutex po CELOU dobu
    HAL timeoutu, a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
2026-08-13 feat(ui): Vzhled presunut z Nastaveni do okna DISPLEJ
    Na prani uzivatele. Barevne schema je vlastnost displeje, ne obecne nastaveni,
    takze patri k jasu a auto-dimu.
    - `THEME_RECT` zije nove v prave karte okna DISPLEJ (s_view=36).
    - Mrizka Nastaveni se o jednu bunku PRESKLADALA, aby po odchodu Vzhledu
    nezustala díra uprostred. Nove:
    DISPLEJ | JAZYK | ALARMY
    CAS | SIT | KALIBRACE
    REFERENCE | ANIMACE | SESTAVY
    O PRISTROJI | (volno) | (volno)
    - Obsluha dotyku presunuta z `s_view==7` do `s_view==36`; po prepnuti schematu
    se prekresluje okno DISPLEJ (drive Nastaveni).
    ⚠️ `screen_main_invalidate()` + `screen_main_init()` zustavaji — `bg_cache` je
    pr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
2026-08-13 feat(sd): prikaz `sd fs` — zmeri format karty misto hadani (#28)
    Doted jsme se u SD pohybovali v HYPOTEZE: "karta 14,5 GB, mozna exFAT, a
    `_FS_EXFAT = 0`, takze `f_mount` selze". To je spatna pozice — `sd fs` z toho
    dela MERENI.
    Cte LBA 0 PRIMO pres BSP_SD (mimo FatFs, takze funguje i kdyz `f_mount` selhava)
    a dekoduje:
    - podpis 0x55AA (bez nej = nenaformatovano),
    - MBR vs. rovnou boot sektor (VBR pozna podle skokove instrukce EB/E9),
    - particni tabulku (typ 0x0B/0x0C = FAT32, 0x07 = exFAT/NTFS, 0x06/0x0E = FAT16)
    vcetne LBA a velikosti,
    - a nakonec boot sektor prvni particie: "EXFAT " na offsetu 3, "FAT32 "
    na 0x52, "FAT12/16" na 0x36.
    Verdikt rovnou rekne, co s tim: u e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
2026-08-13 fix(sd): prevzeti postupu Frantiska — 1-bit identifikace, sticky ErrorCode, is_initialized
    Uzivatel dodal `SD_franta.md` — postup, kterym Frantisek rozchodil SD na TEMZE
    hardwaru. Prosel jsem ho a aplikoval, co na nas sedi.
    1) ⚠️ NEJDULEZITEJSI: `BSP_SD_Init()` PREPSAN (generovana verze je `__weak`,
    takze je to regen-safe). `HAL_SD_Init()` na svem konci vola
    `HAL_SD_ConfigWideBusOperation(Init.BusWide)`. S nasim `Init.BusWide = 4B`
    tedy prepnuti na 4 bity probehlo JESTE UVNITR identifikace — a kdyz selze,
    spadne CELA inicializace, prestoze karta v 1-bit rezimu funguje.
    Nove: identifikace vzdy 1-bit, na 4 bity az potom, s fallbackem zpet.
    ⚠️ V `.ioc` musi `SD_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
    [sd_export.c, syscfg.c]
2026-08-13 fix(sd): `sd fs` shazoval desku — znacky prubehu + BFAR do crash black-boxu
    Uzivatel nahlasil, ze `sd fs` zamrzne UART a deska se restartuje. Crash
    black-box po restartu: `HF@24010A40B` = HardFault, typ **BusFault**, stacknuty
    LR = 0x24010A40.
    CO SE UKAZALO PRI ROZBORU:
    - 0x24010A40 je `pxReadyTasksLists` — vnitrni struktura FreeRTOS, tedy DATOVA
    adresa, ne navratova. To samo o sobe znaci bud poskozeny zasobnik, nebo ze
    hook zachycuje neco jineho, nez si mysli.
    - Dve hypotezy jsem overil a OBE VYVRATIL:
    * Preteceni zasobniku UartTasku — ma 4 kB (ne 2, jak jsem cetl v dokumentaci)
    a cely retezec `sd fs` -> BSP_SD_Init -> HAL_SD_Init -> HAL_SD_InitCard
    -> HAL_RCCEx_PeriphC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
    [sd_export.c]
2026-08-13 feat(sd): dekodovani ErrorCode + vypis registru SDMMC1 pri selhani initu
    `sd fs` uz NESHAZUJE desku (znacky prubehu + odstraneni nebezpecneho cteni
    registru pred initem zabraly) a vratil konkretni vysledek:
    [1] BSP_SD_Init...
    SD: HAL_SD_Init selhal (ErrorCode=0x00000004)
    [1] navrat=1
    0x04 = `SDMMC_ERROR_CMD_RSP_TIMEOUT` -> karta NEODPOVIDA na prikaz (CMD0/CMD8).
    Doplneno, aby priste nebylo nutne dohledavat vyznam v hlavickach HAL:
    - ErrorCode se vypisuje i SLOVY (CMD_RSP_TIMEOUT / CMD_CRC_FAIL / DATA_TIMEOUT).
    Rozdil je diagnosticky zasadni: TIMEOUT = nic neprislo (karta/kontakt/napajeni),
    CRC_FAIL = odpoved PRISLA, ale porusena (signalova integrita, takt, pull-up).
    - Po selhani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
    [sd_export.c]
2026-08-13 docs(sd): PE3 card-detect vyresen — mechanicka zavada slotu, ne software
    Uzivatel nasel a opravil chybu kontaktu v pouzdre karty. Tim se uzavira dlouho
    otevrena polozka a je potreba OPRAVIT, co jsem o ni napsal.
    CO JSEM TVRDIL SPATNE:
    "Card-detect PE3 NEREAGUJE, cte HIGH i se zasunutou kartou. Bud spinac v socketu
    neni zapojeny, nebo je net jinde, nebo ma obracenou polaritu." A doporucil jsem
    to OBCHAZET pres `sd force on` — dokonce jsem ten override zpersistentnil do
    syscfg (magic bump), aby prezil reboot.
    JAK TO BYLO: detekce mela CELOU DOBU PRAVDU. Polarita LOW = karta je spravne,
    presne jak predpoklada navrh i `SD_franta.md` (kde na TEMZE HW funguje). Karta
    fyzicky nedosedala kvuli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
2026-08-13 fix(diag): HardFault handler byl rozbity — naked + stacknute PC + CFSR/BFAR
    ⚠️ NALEZ, KTERY ME STAL DVE SPATNE HYPOTEZY. Crash black-box hlasil pri obou
    padech `sd fs` IDENTICKOU hodnotu `HF@24010A40B`, kde 0x24010A40 =
    `pxReadyTasksLists` (vnitrni struktura FreeRTOS). Z te adresy jsem usuzoval na
    poskozeny zasobnik a honil prizrak. Ve skutecnosti byl vadny SAM ZACHYTAVAC:
    1) `HardFault_Handler` byl bezna C funkce, takze mu GCC vygeneroval PROLOG.
    Ten posune MSP, takze `ldr [msp, #20]` uz necetl exception frame, ale prolog.
    Pro fault v HANDLER MODU (SysTick/PendSV) proto vychazela nahodna data —
    opakovane prave adresa nejake FreeRTOS struktury, coz vypadalo jako stopa.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
    [rtc.c]
2026-08-13 fix(sd): chybejici SDMMC1_IRQHandler — FatFs cekal 30 s a IWDG shodil desku (#28)
    `sd fs` (a kazdy jiny pristup pres FatFs) spolehlive zamrzl konzoli a restartoval
    desku. Pricina je strukturalni, ne v SD kodu:
    `sd_diskio.c` (ST) provadi kazde cteni i zapis pres `BSP_SD_ReadBlocks_DMA()`
    a pak ceka na zpravu ve fronte `SDQueueID`. Tu posle jedine retezec
    SDMMC1_IRQHandler -> HAL_SD_IRQHandler -> HAL_SD_RxCpltCallback
    -> BSP_SD_ReadCpltCallback -> osMessageQueuePut
    `SDMMC1_IRQHandler` ale v projektu neexistoval (ve startupu je `__weak` napojeny
    na `Default_Handler`) a NVIC nebyl povoleny -> zprava nemohla nikdy prijit.
    Dusledek: `osMessageQueueGet` vyprselo az po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
    [sd_export.c, sd_export.h]
2026-08-13 fix(sd): zapis pres FatFs byl rozbity (scratch cesta) + skodliva cache invalidace (#28)
    Tri nezavisle chyby v jedne ceste, vsechny se stejnym korenem: predpoklad,
    ze blokujici `HAL_SD_ReadBlocks`/`WriteBlocks` na H7 pouzivaji IDMA.
    NEPOUZIVAJI — prehazuji data procesorem pres FIFO (`SDMMC_ReadFIFO()` ve
    smycce, `stm32h7xx_hal_sd.c`). Z toho plyne vsechno ostatni.
    1) `sd fs` hlasil "karta neni naformatovana" (LBA 0 = same nuly) u karty,
    kterou `f_mount` bez problemu namountoval. Pricina: po CPU/FIFO cteni se
    volala `SCB_InvalidateDCache_by_Addr()`, ktera cerstve nactena data
    (dirty v D-cache) bez zapisu zpet ZAHODILA. Stejna chyba byla i v
    `datalog_sd.c` `sd_hal_rd()`.
    2) `sd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
    [app_gpsdo.c, datalog_sd.c, sd_export.c, sd_export.h]
2026-08-13 fix(sd): HAL_SD_Init umi tocit ~49 dni v tesne smycce -> obejit + srazit prioritu (#28)
    `sd fs` zamrzl uvnitr `BSP_SD_Init()` a desku shodil watchdog. Pricina neni
    v nasem kodu, ale v HAL: `SDMMC_SWDATATIMEOUT` i `SDMMC_DATATIMEOUT` jsou
    **0xFFFFFFFF ≈ 49 dni**, a pouzivaji se v TESNYCH SMYCKACH BEZ YIELDU:
    - `SD_SendSDStatus()` (ACMD13, 64B datovy prenos),
    - zaverecne "verify ready" v `HAL_SD_Init()`,
    - cekani na `DPSMACT`.
    Kdyz karta nekterou z nich neodbavi, UartTask (Normal) tam tocí naprazdno,
    vyhladovi UiTask (BelowNormal) -> mrtvy dotyk, `watchdog_kick_ui()` zestarne
    a IWDG shodi celou desku.
    Proc to `sd init` prezil: sklada init z `HAL_SD_InitCard` + CID/CSD +
    `ConfigWideBu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
    [sd_export.c, sd_export.h]
2026-08-14 fix(sd): SD karta nejela kvuli vypnutemu HardwareFlowControl -> zapnout + rucne aplikovat CLKCR (#28)
    Datova cesta SD na H7 SDMMC vubec nejela: prikazy (init/CID/CSD, karta az do
    TRANSFER) OK, ale blokovy prenos nedostal ani bajt (DPSMACT visi, STA=0x1000,
    HAL_SD_ReadBlocks skoncil SW timeoutem). Vypadalo to jako HW vada DAT0 linky,
    pritom byl HW celou dobu v poradku.
    Root cause odhalil funkcni referencni projekt H757_SDcard_01 (tataz deska, cte
    i zapisuje): mel `SDMMC1.HardwareFlowControl = ENABLE`, nase .ioc ho NEMA
    (SDMMC1.IPParameters=ClockDiv bez HWFC) -> CLKCR bit17 HWFC_EN=0. Bez flow
    controlu se na H7 SDMMC datova cesta rozpada.
    Druha, skryta cast: CLKCR se stejne neprenastavil na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
    [sd_export.c]
2026-08-14 fix(sd): tlacitka v okne SD karta jen pipla, ale nereagovala — UartTask visel na RX (#28)
    UartTask cetl RX frontu s `osWaitForever`, takze `sd_export_service()` na konci
    smycky bezel JEN po prijeti znaku z konzole. Tlacitka v okne SD karta nastavila
    `g_sd_req`, ale bez UART vstupu ho nikdo nezpracoval -> "pipne, ale nereaguje"
    (pres UART prikaz `sd mount` to fungovalo, proto to driv vypadalo OK).
    Fix: konecny timeout 50 ms na `osMessageQueueGet` -> smycka pravidelne propadne
    na `sd_export_service()` i bez UART vstupu. Znak se stejne zpracuje hned, jak
    dorazi (queue get se vrati okamzite pri dostupnem znaku), takze odezva konzole
    se nemeni; latence tlacitka <= 50 ms.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
2026-08-14 fix(sd): ODPOJIT nereagovalo — auto-mount hned kartu vratil (#28)
    Tik `sd_export_tick()` resetoval `s_mount_tried = 0` pokazde, kdyz byla karta
    namountovana. Po rucnim ODPOJIT (s_mounted -> false) tak dalsi tik (~2 Hz) videl
    `!s_mounted && !s_mount_tried` a hned zadal auto-mount -> karta se do 0,5 s
    vratila a ODPOJIT vypadalo, ze nereaguje.
    Guard `s_mount_tried` se ma povolit az VYTAZENIM karty (to uz dela vetev
    `!present`), tedy auto-mount jen pri NOVEM vlozeni. Skodlivy reset pri
    namountovani odstranen.
    [sd_export.c]
2026-08-14 feat(datalog): omezit log na 1/3 W25Q DATA regionu (~80 dni misto ~242) (#6)
    Datalog dosud pouzival CELY DATA region (~63,8 MB = 2 091 008 zaznamu, ~242 dni
    pri 32 B/10 s). Nove `W25Q_DATALOG_SIZE` = 1/3 regionu zarovnana na erase sektor
    (~22,3 MB = 696 960 zaznamu, ~80 dni kruhu). Zbyle 2/3 zustavaji volne pro dalsi
    bulk pouziti (fonty XIP, rekonstrukce Allan pyramidy).
    Pri zmene:
    - w25q_map.h: nove makro W25Q_DATALOG_SIZE ((DATA_SIZE/3) zarovnano na 4 KB).
    - datalog.c: backend `.capacity` = W25Q_DATALOG_SIZE misto W25Q_DATA_SIZE.
    - datalog.h: opravena zavadejici dokumentace ("~600 dni" -> plny region je ~242,
    1/3 je ~80).
    Pozn.: 32 GB SD karta by pojala ~1 mld. syrových 32B zaznamu (~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
2026-08-14 feat(sd): FORMAT karty s dvojim potvrzenim v okne SD karta (+ UART) (#28)
    Nove tlacitko FORMAT v okne SD KARTA (s_view=37). Formatovani je destruktivni
    (smaze vse), takze ma DVOJI potvrzeni:
    - tlacitko projde stupni "FORMAT" -> "POTVRDIT 1/2" -> "SMAZAT! 2/2" (cervene),
    teprve tretim stiskem se posle SD_REQ_FORMAT,
    - auto-zruseni po SD_FMT_TIMEOUT_S (6 s) bez stisku nebo stiskem jineho tlacitka
    (bezpecnost — nenechat "napulceste"), + varovny cerveny radek kdyz je armovano.
    Footer prerovnan (MOUNT/TEST/EXPORT zuzeny), aby se FORMAT vesel pred ZPET.
    Format sam: `sd_export_format()` -> unmount -> `f_mkfs("", FM_FAT32, 0, work, 512)`
    -> re-mount. Blokujici, bezi v `sd_export_service` (Uar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
2026-08-14 feat(sd): 4-bit sbernice + 32 KB bloky + f_expand predalokace (rychlost zapisu) (#28)
    Rychlost zapisu byla 0,43 MB/s (cteni 1,32) v 1-bit @ 16 MHz. Tri zlepseni:
    1) 4-BIT sbernice (`sd_try_4bit`): po identifikaci CMD55 + ACMD6 (bezdatove
    prikazy, 5s CMDTIMEOUT) rekne karte 4-bit, pak SDMMC_Init nastavi host
    WIDBUS=4B. ⚠️ ZAMERNE NE `HAL_SD_ConfigWideBusOperation` — ta cte SCR
    neohranicenou datovou smyckou (~49 dni) a driv zasekla desku. Fallback pri
    chybe = zustat 1-bit (karta funguje dal). Zrychli hlavne cteni.
    2) 32 KB BLOKY (SD_SPEED_BUF 4K->32K) — amortizuje rezii prikazu/FAT, karta
    programuje sekvencne. Doporucena velikost pro nasi aplikaci (nad 64 KB uz
    zisk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
2026-08-14 fix(regen): obnovit HardFault handler smazany CubeMX regeneraci + zachytit CubeMX zmeny (#28)
    Uzivatel upravil .ioc v CubeMX (HWFC=Enable, USE_EXPAND=Enable) a vygeneroval kod.
    Kompletni audit diffu:
    REGRESE (opraveno):
    - 🔴 stm32h7xx_it.c: regen PREPSAL nas naked `HardFault_Handler` na prazdny
    `while(1)` -> crash black-box HardFaultu (BKP kind 4 = PC/CFSR/BFAR) byl PRYC.
    Byl v nestandardnim USER CODE bloku + naked funkce mimo USER CODE. Obnoveno;
    helper `hard_fault_capture` presunut do `USER CODE 0` (prezije regen), naked
    handler vracen a oznacen jako regen-clobber v CUBEMX_CHECKLIST.
    OK / zlepseni (zachyceno z CubeMX):
    - sdmmc.c: HardwareFlowControl DISABLE -> ENABLE (uzivatel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
    [H757_LED.ioc, sdmmc.c]
2026-08-14 feat(diag): crash black-box HardFaultu zachytava i LR (caller) + HFSR
    HF@24000000 = skok do baze RAM (.data, &SystemCoreClock) pres poskozeny funkcni
    ukazatel / rozbity stack. Faulting PC (kam skocil) je k nicemu — potrebujeme LR
    (ODKUD se skocilo). Pridano do black-boxu:
    - BKP_DR8 = stacknute LR (frame[5]) = navratova adresa volajiciho -> addr2line.
    - BKP_DR9 = SCB->HFSR (bit1 VECTTBL, bit30 FORCED, bit31 DEBUGEVT) -> typ eskalace.
    `status` u HardFaultu ted tiskne i `LR=... HFSR=...`. Globaly g_crash_lr/g_crash_hfsr.
    [rtc.c]
2026-08-14 feat(header): CM4 vlastni zatez v procentech ("4:xx%") pres IPC (#dvoujadro)
    Header ukazoval u CM4 jen stav "4:OK". Ted ukazuje realnou zatez:
    - CM4 (main.c): meri VLASTNI idle-based zatez pres DWT cyklovy citac (busy_cyc /
    total_cyc za ~1 s okno; clock-agnosticky, netreba SystemCoreClock ktery na CM4
    nemusi byt spravny). Vysledek posila v IPC heartbeatu (drive natvrdo 0).
    - CM7: `ipc_cm4_cpu_pct()` cte z heartbeatu -> g_cm4_cpu_pct (defaultTask) ->
    header "4:xx%" (barevne dle zateze) kdyz zive, jinak "4:--"/"4:off".
    CM4 dnes dela skoro nic (bare smycka + HAL_Delay) -> typicky "4:0%"; s ETH/SCPI
    naskoci realna zatez sama (to je smysl - videt, kolik CM4 zere na obsluze site).
    ⚠️ C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
2026-08-15 docs(cm4): CM4 BEZI — "nebootuje/bank2 neflashnuta" byla MYLNA DIAGNOZA (maskoval ho debugger)
    Overeno na HW 2026-08-14: `status` -> `CM4: alive (IPC heartbeat), stall x0`,
    header `4:xx%`. Obousmerny IPC round-trip potvrzen (CM4 prijal snapshot — overil
    magic+verzi, jinak by mlcel — A publikuje heartbeat zpet). Prvni HW validace
    celeho dvoujadroveho IPC navrhu.
    Dokumentace mesice tvrdila "CM4 dnes NEBOOTUJE (bank2 neflashnuta)". Merenim
    zjisteno, ze to NEBYLA pravda:
    - Option bytes byly spravne uz z vyroby (BCM4=1, BOOT_CM4_ADD0=0x810, SWAP_BANK=0)
    — overeno `STM32_Programmer_CLI -ob displ`. Zadny zapis OB nebyl potreba.
    - Bank2 byla flashnuta (platne vektory @0x08100000, SP=0x100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
2026-08-15 docs(hw): aktualizovat overovaci pruchod na stav k 2026-08-15
    Dokument byl z 11.8. a nesedel s realitou -> u desky by matl:
    - 🔴 doplneno varovani "cely pruchod BEZ aktivni sondy" (maskuje CM4, dela
    falesne HardFaulty) — nejdulezitejsi nova informace,
    - header `4:OK` -> `7:xx%`/`4:xx%` (CM4 publikuje vlastni zatez),
    - sekce 0b SD: z "nejdulezitejsi test, prenos nejede" na regresni kontrolu
    (SD zprovoznena 2026-08-14, root cause HWFC) + kroky `sd init`/`fs`/`test`,
    - sekce 3: reorganizace Menu/Nastaveni (Cas/Alarmy/Kalibrace/Animace se
    presunuly do Nastaveni; 4 volne sloty ACT_FREE nesmi navigovat) + nova okna
    DISPLEJ (s_view=36), SIT (35), SD KARTA (37) vcetne dvojiho potvrzeni F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
2026-08-15 fix(ui): nalezy z HW pruchodu — prekryvy textu ve 3 oknech + citelnost + rychlejsi start
    Prvni skutecny pruchod po displeji (2026-08-15) nasel 8 veci:
    PREKRYVY TEXTU (spolecna pricina: pocitalo se s ascent misto line_height, resp.
    se zapomnelo na header_label karty, ktery ma baseline `rect.y + 25`):
    - SELFTEST: roztec radku 18 px pri `mono_18` (line_height 23, descent 5) -> radky
    do sebe zasahovaly. Prepsano na DVA SLOUPCE (7+6 testu) s rozteci 26 px —
    text se neprekryva a vyuzije se i prava polovina karty, ktera byla prazdna.
    - SIT: tlacitka na y=268 lezela pod header_labelem karty (252+25=277). Karta
    posunuta na 248, ovladace na 284, hodnota IP na 386.
    - HOLDOVER: drift-kuzel (2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
    [app_gpsdo.c, screen_main.c, theme.c]
2026-08-15 fix(ui): Selftest + Holdover — karta az 10 px k tlacitkum, prvni radek pod header label
    Druhy nalez z HW pruchodu: v Selftestu se text PORAD prekryval. Pricina byla jinde
    nez u rozteci radku (ta uz byla opravena): PRVNI radek na y=100 zacinal pri
    `mono_18` (ascent 18) na 82 a lezel v header_labelu karty (baseline 62+25=87,
    descent do 92). Stejny problem mel stav v Holdoveru (clear box od 92).
    - Nova konstanta `DG_CARD_FULL_TALL` = {18,62,764,345} -> konci 407, tj. 10 px nad
    footerem (dle zadani). `DG_CARD_FULL_B` zustava beze zmeny pro ostatnich 7 oken,
    aby se nic jineho nerozbilo.
    - SELFTEST: karta TALL, prvni radek 100 -> 112 (text az od 94, pod header labelem),
    Celkem 292 -> 312,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
    [app_gpsdo.c]
2026-08-15 fix(ui)+chore(audit): clear box pod baseline (2 mista) + celokodovy audit a aktualizace komentaru
    NALEZ Z HW (SD okno): blikajici cervene varovani u FORMATu se prepisovalo pres
    sebe. Pricina: `prim_draw_text` kresli od baseline NAHORU o `ascent`, takze text
    na baseline 386 zabira 368..391 — clear box {386, v:24} cistil POD nim a stary
    napis zustaval. Opraveno na {366, v:28}.
    Systematicky audit teto tridy chyby (skript: parovani fill_rect + naslednehо
    draw_text, odhad ascent dle fontu) nasel JESTE JEDNO misto:
    - GPS okno, radek FIX: box od 74, ale mono_25 kresli od 71 -> horni 3 px stareho
    textu zustavaly. Opraveno na {70, v:34}.
    Zbyle 1 hlaseni bylo false positive (barevny ctverecek le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
    [app_gpsdo.c, datalog_sd.c, ipc.c, ipc_cm4.h, ipc_shared.h, main.c, screen_main.c, sd_export.h]
2026-08-15 perf(sd): FIL ze stacku do .bss — UartTask usetril ~1,1 kB (hloubkovy audit)
    Pokracovani auditu o veci, na ktere minule nedoslo (RAM/stack rozpocet, staticka
    analyza toku dat, vlaknova bezpecnost).
    🔴 HLAVNI NALEZ — stack UartTasku. `-fstack-usage` ukazal:
    selftest_body 1176 B
    export_body 920 B
    Pricina: `FIL` lezel na STACKU a pri `_FS_TINY=0` v sobe nese vlastni 512B
    sektorovy buffer (~560 B). Presne to vysvetluje `stack Uart free 660 B`, ktere
    uzivatel videl po SD operacich (z puvodnich 1816 B).
    Oprava: `static FIL` ve vsech trech funkcich (bezi VYHRADNE z UartTasku a nejsou
    vnorene, takze staticka instance je bezpecna; kazda ma vlastni, protoze
    `sd_speed_test` se vola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
2026-08-15 docs: prubeh HW overeni dokoncen — 12 polozek 🔶 -> ✅, TODO prepsan na aktualni stav
    Overovaci pruchod (`HW_OVERENI_PRUCHOD.md`) probehl v davkach 1-5 na desce:
    - #10 detekce preteceni zasobniku OVERENA: `stacktest yes` -> IWDG reset ->
    `status` ukazal `Reset: WATCHDOG! stack:UartTask` (hook zachytil jmeno tasku).
    - #31/#32/#33/#43/#44/#47/#52/#53/#54/#67/#68 — 11 funkci, ktere byly dosud
    implementovane "naslepo" (nikdy nebezely na displeji) -> ✅.
    Pri pruchodu nalezeno a opraveno 10 UI chyb (prekryvy textu, clear boxy pod
    baseline, citelnost, rychlejsi start) — viz predchozi commity.
    Potvrzena i oprava stacku: `stack Uart free 1816 B` (pred opravou FIL->static
    klesalo po SD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
2026-08-15 chore(release): v0.5.0
    94 commitu od v0.4.0 (35 feat, 32 fix, 18 docs, 5 perf). MINOR bump dle SemVer —
    verze na displeji i v UART `version` presne odpovida git tagu v0.5.0.
    [version.h]
2026-08-15 docs(ui): UI_SIZES 8. vlna + rozsireni auto-dim tlacitek na 7,5 mm (P3 hotovo)
    P3 (konfigurace/hygiena) uzavren:
    1) UI_SIZES.md aktualizovan po HW pruchodu — dosud se layout POCITAL z tabulek
    fontu, tohle je prvni vlna overena okem na displeji:
    - tri nova okna (DISPLEJ/SIT/SD KARTA) vc. rozmeru vsech dotykovych cilu,
    - nova karta `DG_CARD_FULL_TALL` (konci 10 px nad footerem),
    - header `CM7:xx%`/`CM4:xx%` + `HDR_PILL_LIMIT` 590 -> 580,
    - podbarveni STOP 38 -> 72, flash 3 -> 2 tiky, splash 10 -> 5 tiku,
    - NOVA SEKCE "Svisla geometrie textu" = destilat 10 chyb z pruchodu:
    tabulka `line_height` per font + tri pravidla (roztec radku != ascent;
    clear box MUSI lezet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
2026-08-15 feat(scpi): SET prikazy + INIT/ABOR/READ? — SCPI prestalo byt read-only (#25)
    Inventura ukazala, ze SCPI umelo ~45 prikazu, ale krome Math/limitu slo POUZE
    cist: `SENS:FREQ:GATE` i `:CHANnel` existovaly jen jako dotazy (`&& is_query`),
    takze pristroj nesel dalkove ovladat.
    NOVE PRIKAZY:
    - `SENS:FREQ:GATE <s>` — presety 0,1 / 1 / 10 / 100 s, tolerance 1 % (projde
    "0.1" i "1E-1"); mimo preset se SET NEaplikuje.
    - `SENS:FREQ:CHAN <0|1>`
    - `INITiate[:IMMediate]` = RUN, `ABORt` = STOP, `INIT:CONT?` readback
    - `READ?` = INIT + FETCh (jednoradkove mereni, ktere ceka kazdy VISA/IVI ovladac)
    - `SENS:FREQ:GATE:ACTual?` — skutecne zmerene okno z FPGA ramce
    ⚠️ SEMANTIKA READBACKU: `SENS:FR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
    [app_gpsdo.c, ipc.c, ipc_shared.h, scpi.c, scpi.h, screen_main.c, screen_main.h]
2026-08-15 docs(status): srovnat stav — #21 a #28 jsou hotove, #25 doplnen o SET prikazy
    Inventura ukazala tri polozky, ktere realita predbehla:
    - #21 Liveness CM4: "runtime ⬅ HW" -> ✅ overeno 2026-08-14 (`CM4: alive`,
    header `CM4:xx%`, stall detekce). Doplneno, ze IWDG2 zustava zamerne vypnuty
    (system-wide reset scope).
    - #28 SD karta: "SW HOTOVY, ceka na HW" -> ✅ plne funkcni (root cause byl
    vypnuty HardwareFlowControl).
    - #25 SCPI: doplneno, ze SET prikazy (GATE/CHAN/INIT/ABOR/READ?) jsou hotove;
    zbyvaji STAT registry, SYST:DATE/TIME, DISP:BRIG (v TODO P1).
    Pomer: 27 hotovych / 6 otevrenych.
2026-08-15 feat(scpi): STATus OPER/QUES registry + DISP:BRIG + *OPT? + CONF:FREQ (#25)
    Doplnen chybejici SCPI-99 status model. Dosud existoval jen `:CONDition`
    (okamzity stav) a `STAT:PRES` jako no-op:
    - `STAT:OPER?` / `STAT:QUES?` (= `:EVENt`) — LATCHED registry: nabezna hrana
    condition bitu je nastavi a **cteni je vynuluje**. Presne proto existuji —
    klient jinak propasne kratkou udalost mezi dvema dotazy. Latchuje se na
    zacatku kazdeho `scpi_process_ctx` (pred vykonanim prikazu, aby dotaz videl
    i udalost tesne pred nim).
    - `STAT:OPER:ENABle` / `STAT:QUES:ENABle` (+ dotazy), `STAT:PRES` je nove nuluje.
    - `*STB?` doplnen o summary bity: bit3 QUES, bit7 OPER (drive jen bit2 fronta,
    bit5 ES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
2026-08-15 feat(screenshot): ulozeni na SD kartu — resi tearing i spolehlivost (#55)
    `screenshot` pres USB CDC mel tri slabiny: snimal ZIVY front buffer (UiTask
    behem ~sekundoveho exportu flipne -> pruhy ze dvou framu), tok byl best-effort
    (pri zahlceni ringu zahodi data -> poskozeny BMP) a slo to jen do terminalu.
    Nove `screenshot sd` (UART) -> `SHOTnnn.BMP` na karte:
    - ANTI-TEARING: front buffer se nejdriv zkopiruje do SDRAM scratche (0xC0400000,
    750 kB, jednotky ms) a teprve z te kopie se zapisuje -> flip uprostred zapisu
    uz nevadi.
    - FatFs zapise cely soubor (zadne zahazovani), `f_sync` pred `f_close` jako
    u `sd test` (jinak by se adresarova polozka nemusela dopsat).
    - `FIL` staticky (nese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
    [screenshot.c, screenshot.h]
2026-08-15 feat(ui): okno MERENI zpristupneno z Menu — #67 dokonceno
    Inventura ukazala, ze okno MERENI (s_view=34) je uz KOMPLETNI — render,
    ovladace (FREKV./PERIODA, jednotky, RESET statistiky) i zivy tick existuji.
    Chybel jen VSTUPNI BOD: zadny `nav_push` na nej nevedl, takze bylo nedosazitelne.
    Presne to znamenalo "okno PENDING" ve STATUS #67.
    - Novy `ACT_MEAS` + dlazdice "Mereni" v prvnim volnem slotu Menu (radek 3, vlevo).
    - `menu_activate` dispatch + forward deklarace (funkce je definovana az za nim).
    - BACK vede do Menu (`nav_push(12)` se dela pro vsechny dlazdice krome ACT_FREE).
    Menu ma nadale 3 volne sloty. ⚠️ Obsah okna pocita ze `screen_main_freq_hz()`,
    coz je zatim SIMULACE headl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
    [app_gpsdo.c]
2026-08-15 refactor(screenshot): sjednotit duplicitni radkovy buffer (nalez z auditu #35)
    Audit noveho kodu nasel v `screenshot.c` DVA staticke `row[2400]` buffery — jeden
    v USB ceste, druhy v SD ceste. To je 4800 B v .bss zbytecne: obe funkce bezi
    VYHRADNE z UartTasku, ktery je zpracovava seriove, takze se nikdy nepotkaji.
    Sjednoceno na jeden `s_row[]`; USB cesta zaroven zacala pouzivat sdilene
    `row_565_to_bgr()` misto vlastni inline konverze (uspora ~15 radku duplicity).
    Audit jinak bez nalezu: `-fanalyzer` cisty na scpi.c/screenshot.c/sd_export.c,
    sweep CM7+CM4 `-Wall -Wextra -Wshadow` = 0 varovani.
    Dokumentace srovnana s kodem: CLAUDE.md uz netvrdi, ze screenshot je
    "ROZPRACOVANO" (popisuje obe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
2026-08-15 docs: srovnat STATUS a TODO po dokonceni #25/#55/#67/#35
    - #25 SCPI: USB strana kompletni (SET, STATus OPER/QUES registry, DISP:BRIG,
    *OPT?, CONF:FREQ; ~130 assertu). Zbyva jen SYST:DATE/TIME set + subsystemy
    vazane na chybejici HW -> TCP ceka na CM4/ETH.
    - #55 screenshot -> ✅ (uz drive v tomto commitu radu: `screenshot sd`).
    - #67 okno MERENI -> ✅ (bylo hotove, chybel vstupni bod).
    - #35 audit -> ✅ prubezne: 0 varovani, -fanalyzer cisty, zadny mrtvy kod;
    nalezy opraveny. Audit je nove soucasti kazde vetsi zmeny, ne polozka.
2026-08-15 feat(scpi): SYST:DATE / SYST:TIME — USB strana SCPI je tim kompletni (#25)
    Posledni chybejici SET. Dotaz cte `g_rtc_text` (uz naformatovany defaultTaskem),
    SET jde pres REQUEST-MOST: RTC registry vlastni VYHRADNE defaultTask, SCPI bezi
    v UartTasku a nesmi do nich sahat. Zapise `g_rtc_set_*` + `g_rtc_set_pend`
    a `rtc_app_tick` to aplikuje.
    Dve rozhodnuti, na kterych zalezi:
    - Pozadavek se aplikuje **PRED `rtc_try_sync()`**, takze pri GPS fixu prepise
    rucni hodnotu hned v temze tiku -> pristroj se nikdy neustali na horsim zdroji
    casu, nez ma k dispozici.
    - Rucni set **NEnastavuje** `s_synced` ani BKP magic. Cas z klavesnice neni
    disciplinovany z GPS a UI/UART to musi dal priznavat ("n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
    [rtc.c, scpi.c]
2026-08-15 fix(sd): uklid po neuspesnem prenosu (HAL_SD_Abort) + hlaseni skutecne sirky sbernice
    Studium Frantova projektu `H757_SDcard_01` (rozchodil SD na temze HW) — prevzaty
    dve veci, obe bezpecne a nezavisle na tom, ze on jede pres IDMA a my pres FIFO.
    🔴 REALNA DIRA V NASEM KODU (opraveno):
    Po timeoutu `HAL_SD_ReadBlocks`/`WriteBlocks` jsme jen vratili chybu. HAL sice
    vrati `hsd->State` na READY, ale **datovy automat (DPSM) a karta v prenosu
    pokracuji** — karta zustane ve stavu "sending data" a KAZDY dalsi prikaz pak
    selze, dokud se nevypne napajeni. Jedna neuspesna operace tedy fakticky shodila
    SD az do restartu. Nove `sd_xfer_fail()` posle `HAL_SD_Abort()` (CMD12
    STOP_TRANSMISSION) a ohr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
    [sd_export.c]
2026-08-15 docs(todo): plan na zrychleni SD — R60 pryc, bulk kondik, ClockDiv 2->1 (32 MHz)
    Frantuv projekt jede na TEMZE HW na 48 MHz (ClockDiv=0 = bypass delicky, kernel
    48 MHz). Tim padá dosavadni obava ze STATUS #69, ze deska vyssi takt nesnese —
    empiricky ho snese.
    ⚠️ Oprava meho drivejsiho zaveru: tvrdil jsem "Franta jede 12 MHz, brat si od nej
    nemame co". Cetl jsem starsi LOKALNI kopii projektu misto aktualniho GitHubu,
    na ktery uzivatel odkazoval. Ve skutecnosti jede 3x rychleji nez my.
    Plan na zitra:
    1) HW: odstranit **R60** (pull-up na SDMMC1_CK — patril na CMD, viz erratum desky;
    dosud neskodny, ale pri 32+ MHz zhorsuje hrany) + pridat **bulk 4,7-10 uF na
    SD VDD** (dnes je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
2026-08-16 feat(sd): SDMMC_CK 16 -> 32 MHz (ClockDiv 1) + srovnat rozchazejici se konfiguraci
    HW upravy hotove (uzivatel 2026-08-16): odstranen R60 (pull-up na SDMMC1_CK,
    patril na CMD dle erratum desky), bulk kondik na SD VDD navysen na 10 uF.
    Tim padly obe vyhrady, kvuli kterym byl takt drzeny nizko.
    ZMENA: `ClockDiv` 2 -> 1 = SDMMC_CK **32 MHz**.
    ⚠️ `ClockDiv = 0` (bypass) NEPREVZAT z `H757_SDcard_01`: on ma kernel 48 MHz
    -> 48 MHz, my 64 MHz -> bypass by dal 64 MHz = nad SD High-Speed limitem 50 MHz.
    🔴 NALEZ PRI SROVNANI: hodnota zila na TREKH mistech a rozchazela se —
    `.ioc` = 4, USER CODE v `sdmmc.c` = 4, runtime `sd_apply_init_config()` = 2.
    A hlavne: USER CODE blok v `sdmmc.c` mel **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
2026-08-16 fix(regen): obnovit HardFault handler (regen ho smazal PODRUHE) + audit celeho .ioc
    Uzivatel nastavil `SDMMC clock divide factor = 1` a vygeneroval kod.
    REGRESE (opravena): `Generate Code` opet prepsal nas `naked HardFault_Handler`
    na prazdny `while(1)` — uz podruhe (15. a 16. 8.). Helper `hard_fault_capture`
    v USER CODE 0 prezil, jak bylo navrzeno. Do komentare doplneno, ze uz to nastalo
    dvakrat, at je jasne, ze to neni nahoda.
    AUDIT CELEHO .ioc (28 kontrolnich bodu proti CUBEMX_CHECKLIST): **0 realnych
    nesrovnalosti**. Overeno vc. polozek, ktere regen historicky rozbijel:
    - USART1 v `CortexM7.IPs` + NVIC + PB14/PA10 (bez toho regen MAZE cely HAL UART),
    - SDMMC1 piny PC8-12/PD2, mode "S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
2026-08-16 fix(regen): HardFault handler uz regen NEPREPISE — vyreseno primo v CubeMX (#hygiena)
    Uzivatel se zeptal, jestli to nejde srovnat rovnou v CubeMX. Jde — a je to lepsi
    nez skript, ktery jsem psal predtim.
    ZJISTENI: v `.ioc` maji NVIC polozky pole, ktere ridi generovani handleru:
    HardFault/MemManage/BusFault/UsageFault : pole 6 = true -> generuji se (4x v it.c)
    PendSV/SysTick : pole 6 = false -> NEgeneruji se (0x)
    PendSV/SysTick negeneruje CubeMX proto, ze je poskytuje FreeRTOS. Presne tentyz
    prepinac jde pouzit pro HardFault.
    RESENI: `NVIC1.HardFault_IRQn` pole 6 -> `false` (v CubeMX: NVIC -> Code generation
    -> odskrtnout "Generate IRQ handler" u Hard fault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
    [H757_LED.ioc]
2026-08-16 chore(regen): overeno, ze HardFault uz regen neprepisuje + doplnit prototypy obsluh
    Uzivatel odskrtl "Generate IRQ handler" u Hard fault interrupt a spustil Generate
    Code. Overeno:
    - nas `naked` HardFault_Handler v USER CODE 1 PREZIL,
    - CubeMX vlastni NEvygeneroval (0 definic mimo USER CODE, celkem 1 v souboru,
    tedy zadna duplicita),
    - ostatni soubory (sdmmc.c, freertos.c, rtc.c, CM4/main.c, .ioc) 0 radku zmeny.
    Tim je regen-clobber, ktery handler smazal 15. i 16. 8., definitivne pryc.
    CubeMX pri te prilezitosti odstranil prototyp `HardFault_Handler` z it.h (uz ho
    negeneruje). Doplnen do USER CODE EFP — spolu s `TIM7_IRQHandler` a
    `SDMMC1_IRQHandler`, ktere prototyp nemely nikdy. Overen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
2026-08-16 feat(sd): prubeh exportu v UI — "exportuji N / M" misto nemeho "(pracuji...)"
    Export desetitisicu zaznamu trva sekundy az desitky sekund a okno SD KARTA u nej
    ukazovalo jen staticke "(pracuji...)" — nebylo poznat, jestli se neco deje, nebo
    se pristroj zasekl.
    `export_body()` ted prubezne plni `prog_done`/`prog_total` ve snapshotu pro UI
    (zapis dvou uint32 na zaznam je levny, takze bez throttlingu) a okno misto stavu
    kresli "exportuji N / M". Po dokonceni se `prog_total` nuluje ve WRAPPERU
    `sd_export_run()` — tedy na jedine ceste ven, at uz export dopadl jakkoli (stejne
    pouceni jako u `s_busy`).
    `c_stav` zvetsen 28 -> 36 B ("exportuji 696960 / 696960" = 25 znaku).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
2026-08-16 fix(datalog): find_head veril garbage z flash + pocet zaznamu se odvozoval ze seq (#6)
    Po vcerejsim zmenseni datalogu na 1/3 DATA regionu hlasil `status`
    "696960/696960 rec ... WRAP" (plny log), ale `sd export` nasel jen **42989**
    platnych zaznamu — zbylych 653k slotu zahodil na CRC. Dve nezavisle chyby:
    1) 🔴 `find_head` NEOVEROVAL CRC. Blokovy sken cetl jen 4 bajty (seq) a bral je
    jako platne. Protoze se vybira blok s NEJVYSSIM seq, stacil jediny poskozeny
    bajt kdekoli v regionu, aby hlava skoncila uplne jinde. Presne to nastalo:
    `seq` vyslo 3823341906, coz je pri 10 s/zaznam ~1,2 miliardy let.
    Oprava: cte se cely 32B zaznam a pousti se pres `unpack_rec` (CRC + prazdny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
    [datalog.c]
2026-08-16 fix(ui): bargrafy napajeni byly prazdne — meze v mV, hodnota ve V (#47)
    Okno PREHLED KANALU ukazovalo u vsech napetovych radku (12V, 5V, REF, VBAT,
    OCXO Vc) prazdnou stopu, prestoze hodnota vpravo byla spravne a MIN/MAX/REF
    markery se kreslily.
    PRICINA: `HBAR[].lo/hi/nom` byly v MILIVOLTECH (10800/13200/12000), ale
    `hbar_disp()` prevadi syrovou hodnotu senzoru na zobrazovanou jednotku
    (13092 mV * 0.001 = 13.092 V). `hbar_pct_disp()` pak porovnavalo VOLTY
    s MILIVOLTY:
    bar = (13.092 - 10800) / (13200 - 10800) = -4.49 -> clamp 0 -> prazdny bar
    Diagnostiku umoznilo az uzivatelovo pozorovani, ze REF marker sedi spravne:
    ten se totiz pocita PRIMO z `nom` (mV proti mV), takze jediny neb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
    [app_gpsdo.c]
2026-08-16 feat(ui): horizontalni bargrafy — napeti na tisiciny, teploty na setiny (#47)
    Na vyzadani jemnejsi rozliseni hodnoty vpravo od baru:
    teploty 31.3 C -> 31.28 C (deci 1 -> 2)
    napeti 13.09 V -> 13.092 V (deci 2 -> 3)
    RF (dBm) zustava na desetinach — s "-61.2 dBm" (9 znaku) uz je box hodnoty
    temer plny (HB_VAL_W 100 px / mono_16 10 px na znak = strop 10 znaku).
    Mista nesou skutecne rozliseni, nedopisuji se nuly: ADS1115 ma 16 bit na
    +-4,096 V (125 uV/LSB), TMP117 0,0078 C/LSB.
    Soucasti dve veci, ktere by ta zmena jinak zhorsila:
    1. ROZDELENO prekreslovani stopy a hodnoty (`hbar_row_draw` -> `hbar_row_bar`
    + `hbar_row_val`). Text se pri 3 desetinach meni kazdym mV sumu,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
2026-08-17 fix(datalog): CRC i ve vnitrnim scanu find_head() — s_seq bral garbage z flash
    Vcerejsi audit oznacil asymetrii: vnejsi scan (vyber best_blk) uz po fixu
    710b539 veri jen CRC-overenym zaznamum, ale vnitrni scan (hledani `used`/hlavy
    UVNITR vitezneho bloku) pořád cetl jen syrovy `seq` bez CRC.
    POTVRZENO na HW pres debug sondu (HotPlug SWD cteni RAM, bez halt/reset):
    s_count = 47043 (spravne, ~5,4 dne logovani — vnejsi fix funguje)
    s_seq = 3823345955 <- garbage
    3823345955 je temer identicke s historickou hodnotou 3823341906 popsanou v
    komentari o puvodni chybe (rozdil jen 4049) — tedy stara data z flash zpred
    zmenseni DATA regionu 2026-08-15, ktera nejsou cisty 0xFF (=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
    [datalog.c]
2026-08-17 feat: reset senzoru/statistik/datalogu — samostatne, prikaz + tlacitko
    Tri nezavisle "vynulovat" akce, kazda vlastnim UART prikazem I tlacitkem v UI
    (na vyzadani, aby slo testovat cistou akumulaci po dnesnich datalog fixech):
    1) SENZORY (min/max/mean g_sensors[]) — `sensor_stat_reset_all()`
    UART: `sensors reset`. UI: tlacitko RESET MIN/MAX v okne Senzory (s_view=4).
    `last`/`valid`/`err_*` zustavaji (aktualni hodnota a chybova historie nejsou
    totez co merena statistika). Zapis smi i UART/UI task, ne jen SensorsTask —
    sensor_stat_t uz beztak toleruje netrhane cteni bez zamku.
    2) NAMERENE HODNOTY CITACEM (Allan/Histogram/Trend + alarm pocitadla) —
    `screen_main_stats_res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
    [alarm.c, alarm.h, app_gpsdo.c, datalog.c, datalog.h, screen_main.c, screen_main.h, sensor_stat.h]
2026-08-17 fix(reset): samples=0 rozbijelo displej i datalog + 3 dalsi nalezy z review
    Code review commitu 4f4e879 naslo 6 veci; opraveny 4, dve vedome ne (duvod nize).
    1) 🔴 HLAVNI: `sensor_stat_reset_all()` nulovalo `samples`, jenze to NENI jen
    citac vzorku statistiky — zbytek kodu ho na 13 mistech cte jako "ma tenhle
    senzor VUBEC nejakou hodnotu?". Review naslo 3 konzumenty, pri overeni jich
    je vic a nejhorsi je datalog:
    datalog.c sens_c100/sens_mv -> DATALOG_INVALID16, takze tick, ktery padne
    do ~500ms okna po resetu, zapise do logu SENTINELY misto teplot/Vc/RF,
    app_gpsdo draw_sensors_values -> "---" v ZIVE hodnote (cela obrazovka
    Senzory, tedy prave ta, kde to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
    [app_gpsdo.c, datalog.c, datalog.h, screen_main.c, sensor_stat.h]
2026-08-17 feat: prahovy monitor (VBAT/OCXO/ADEV) + okno KVALITA GPS + pruvodce kalibraci
    Sest funkci nad daty, ktera uz dnes realne merime — nic z toho neceka na FPGA.
    1) PRAHOVY MONITOR (alarm.c). Do ted hlidal alarm jen UDALOSTI (FPGA link, GPS
    lock, limit pass/fail) — z deseti senzoru meRicich 24/7 ANI JEDEN. Nove tri
    prahove podminky nad skutecne merenymi velicinami:
    VBAT pod mezi — zalozni CR2032 pro RTC/BKP. Degradace, o ktere se jinak
    nedozvis, dokud tise neprijdes o cas a nastaveni pri odpojeni napajeni.
    (Zmereno na teto desce: 2,92 V, tedy uz za pulkou zivota.)
    OCXO mimo pasmo — rozladena pec; pro kmitoctovy normal primo relevantni.
    sigma@1s nad pr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
    [alarm.c, alarm.h, app_gpsdo.c, screen_main.c, screen_main.h, syscfg.c]
2026-08-17 fix(ui): tlacitko KVALITA nebylo videt — leželo uvnitr karty Druzice
    Nahlaseno z HW: v GPS okne neni po tlacitku ani stopa. Neni to otazka flashe,
    je to chyba umisteni.
    PRICINA: `GPS_SAT_RECT` = {18,160,502,318}, tedy x 18..520 a y **160..478** —
    karta Druzice je ZAMERNA vyjimka z footer pravidla a saha az ke spodnimu okraji
    obrazovky (komentar u jejiho renderu to primo rika: "roztazena AZ PO SPODNI
    OKRAJ ... BACK je vpravo, levy sloupec ho nekryje"). Tlacitko {330,417,190,61}
    tedy leželo CELE uvnitr te karty a bargraf druzic ho pri kazdem obnoveni (2x/s)
    prekreslil.
    Pri kontrole kolizi jsem porovnaval jen proti OSTATNIM FOOTER TLACITKUM, ne
    proti kartam okna — a prave v tomhle okn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
    [app_gpsdo.c]
2026-08-17 feat(datalog): logovat VBAT (zalozni CR2032) — bez migrace, do volneho bajtu 27
    Vcerejsi prahovy monitor umi krinout, az je zalozni baterie vybita. Jenze
    degradace CR2032 trva mesice a bez ZAZNAMU nejde odhadnout, KDY ji vymenit —
    datalog VBAT vubec neukladal. Tim se to uzavira.
    FORMAT BEZE ZMENY. Zaznam ma volny bajt 27 (drive `spare`, uvnitr CRC), takze
    se nic nemigruje ani neverzuje:
    kod = (mV - 2000) / 8 -> 1..255 = 2008..4040 mV, krok 8 mV
    Na baterii je to bohate (sleduje se trend pres mesice, ne mV); overeno pres
    cely realny rozsah, chyba <= 4 mV.
    ⚠️ KOD 0 JE VYHRAZEN jako "nezaznamenano". Bez toho by se STARE zaznamy (bajt 27
    byl vzdy 0) precetly jako mrtva baterie 2,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
2026-08-17 fix: tri chyby odhalene testem desky pres UART (COM8)
    1) 🔴 JEDNOTKY RF V LOGU. Pole zaznamu se jmenovalo `rf_dbm10`, ale drzi SYROVE
    mV z AD8307 (ulozeni v mV je zamer — kalibrace se muze zmenit, syrova hodnota
    ne). Oba konzumenti vzali jmeno doslova a delili deseti:
    scpi MMEM:DATA? 0 -> ...,57.40,... (namereno na desce)
    CSV sloupec `rf_dBm` -> "57.4"
    Spravne je -61,2 dBm; 57 dBm by na vstupu citace bylo 500 W. Ziva cesta
    (`MEAS:POW?`) pritom vracela spravnych -59.12 — chyba byla jen u LOGU.
    Opraveno: pole prejmenovano na `rf_mv` (odstraneni pricinu zamateni), SCPI
    prevadi pres kalibraci stejnym vzorcem jako MEAS:POW?, CSV sloupec se jmenuje
    `rf_mV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
    [alarm.c, datalog.c, datalog.h, scpi.c, sd_export.c]
2026-08-18 feat(fpga): emulator ramcu — simulace na SPRAVNE vrstve misto obchazeni datove cesty
    Headline je dnes nahodna prochazka v `screen_main.c`, ktera celou cestu z FPGA
    OBCHAZI. Dusledek: netestovana je cela NASE polovina kontraktu — parsovani,
    CRC, hystereze /4-/16, freshness, statistika, Allan, datalog, SCPI.
    `fpga_freq_poll()` ma pritom idealni injekcni bod: `xfer()` je JEDINE misto, kde
    vznika obsah `rx[]`. Emulator slozi syntetický 64B DATA ramec vcetne spravneho
    CRC a vsechno za tim — kontrola MAGICu, overeni CRC, `parse_data`, latch pod
    IRQ-off, VALID/FRESH/SEQ, vyber odbocky — bezi BEZE ZMENY. Zadny zvlastni rezim
    nikde nize; presne to je smysl.
    Co to odemyka: #1 (realna data d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
2026-08-18 feat(rtc): disciplinace LSE podle GPS — merení driftu vlastni casove zakladny
    `rtc_try_sync()` kazdych 10 minut prepsal cas podle GPS a odchylku ZAHODIL.
    Pritom prave ta odchylka JE MERENI: drift vlastniho krystalu LSE v ppm. Je to
    funkcni miniatura celeho GPSDO (zmer chybu proti GNSS, aplikuj korekci, drz
    holdover), jen na RTC misto OCXO — a nepotrebuje FPGA ani jedinou soucastku.
    `RTC_CALR` (smooth calibration) navic nebyl v projektu nikdy pouzity.
    MERENI. GPS dava jen CELE sekundy, takze se faze snima na HRANE GPS sekundy:
    v tom okamziku se precte sub-sekundovy registr RTC (SynchPrediv=255 -> 1/256 s
    = 3,9 ms). Drift = (faze_ted - faze_ref) / uplynuly_cas.
    ⚠️ NMEA veta dorazi s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
    [rtc.c, rtc.h]
2026-08-18 feat(diag): flight recorder — kontext systemu tesne pred resetem (TODO #18)
    TODO #18 (nahodne watchdog resety) visi od 2026-07-20 se stavem "cekame na dalsi
    vyskyt". Jenze az nastane, stejne se nedozvime nic navic: crash black-box rekne
    CO se stalo (`stall:UiTask`), ale ne CO SE DELO PREDTIM. Tohle doplnuje prave ten
    chybejici kontext.
    MODEL: kruhovy buffer poslednich 60 s (CPU, volny heap, NEJMENSI volny stack ze
    vsech tasku, teploty OCXO/desky, soucet I2C err_streak, priznaky GPS/FPGA/CM4)
    zije v RAM — 1x/s, zadne opotrebeni flash. Do W25Q se sype AZ pri poruse:
    - `watchdog_supervise()` kdyz odmitne obnovit IWDG (= presne scenar #18),
    - FreeRTOS hooky pri preteceni zasobniku / sel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
    [flightrec.c, flightrec.h, w25q_map.h, watchdog.c]
2026-08-18 feat: export logu do konzole (#46) + dokonceni okna MERENI (#67)
    #46 — `datalog csv [N]`: cely log (nebo poslednich N) jako CSV do konzole.
    Doplnek k SD exportu pro beh BEZ karty. Hlavicka i poradi shodne s SD variantou
    (chronologicky, nejstarsi prvni). ⚠️ Kazdy radek je jedno blokujici QSPI cteni;
    pri 48k zaznamech to na 115200 Bd trva desitky minut — proto ten volitelny limit.
    `osDelay(1)` mezi radky nechava dychat UiTask (UartTask sice pod watchdogem
    neni, ale UiTask ano).
    #67 — okno MERENI dokonceno o tri veci, ktere v nem chybely:
    RUCNI NOMINAL: dosud jen auto-dopocet z mereni. Nove tap na radek "Nominal:"
    cykluje auto / 1 / 5 / 10 / 100 MHz — tedy hodnoty, ktere real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
2026-08-18 feat(stats): rekonstrukce dlouhych tau ADEV z datalogu po bootu
    Kazdy restart dosud vynuloval celou ADEV pyramidu, takze dlouha tau (1k, 10k s)
    se nabirala znovu od nuly — po rebootu jsi o hodiny mereni prisel. Datalog
    pritom drzi kmitocet po 10 s klidne dny dozadu.
    ⚠️ KLICOVE ROZHODNUTI: vzorek z logu se vklada od STAGE 1, ne od stage 0.
    Stage 1 ma tau = 10 s, coz je PRESNE kadence datalogu, takze prevod je exaktni —
    zadne prevzorkovani, zadna zmena tau0. Kdyby se log sypal do stage 0 (tau0 = 1 s),
    vysla by sigma_y(tau) systematicky SPATNE o cely rad a pritom by vypadala
    naprosto verohodne. Stage 0 zustava prazdna, dokud ji nenaplni zive vzorky —
    a to je spravne: log zadna 1s dat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
    [app_gpsdo.c, app_gpsdo.h, screen_main.c, screen_main.h]
2026-08-18 feat(ipc): SCPI nad IPC snapshotem + porovnavaci harness (priprava CM4, #25)
    Nejvetsi riziko TCP poloviny #25 neni socket, ale otazka "nese snapshot
    vsechno, co SCPI potrebuje, a sedi bity platnosti?". Staticke asserty sice
    hlidaji, ze SCPI_V_* == IPC_V_*, ale RUNTIME dukaz dosud neexistoval — a chyba
    by se projevila az po zprovozneni ETH, kdy uz je draha na dohledani.
    `ipc_scpi_src_from_snap()` naplni `scpi_src_t` VYHRADNE ze snapshotu — presne
    to, co bude delat CM4. Zije v `ipc.c`, ktery uz includuje `scpi.h` i
    `ipc_shared.h`; deklarace je pres `void *`, aby se ty dva headery nemusely
    zaplest do sebe.
    `scpi ipc <cmd>` spusti TENTYZ parser nad obema zdroji a vypise odpovedi vedle
    sebe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
2026-08-18 docs: nova sekce "Vyvoj bez FPGA desky" — emulator, LSE disciplinace, flight recorder
    Shrnuje ctyri veci z 2026-08-18 vcetne DUVODU, proc jsou udelane prave takhle —
    u kazde je zaznamenana ta past, ktera by se pri naivni implementaci projevila az
    jako spatna cisla:
    - emulator: injekce do `xfer()`, ne obchazeni datove cesty; tempo 4x/s ne 20x/s,
    - LSE: mereni na HRANE GPS sekundy (latence NMEA se vyrusi v rozdilu fazi),
    vzorkovac PRED 1Hz throttlem (jinak aliasing),
    - flight recorder: predem smazany sektor (erase se pri poruse nestihne),
    zadny zapis z HardFaultu (wait_ready ustupuje scheduleru),
    - ADEV rekonstrukce: vklad od stage 1, ne 0 — jinak sigma_y(tau) spatne o ra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
2026-08-18 fix: audit .ioc konzistence — pojistka TRACE_FACILITY, RECALPF spin, UartTask stack
    Kontrola, jestli neco z dnesnich zmen nekoliduje s CubeMX konfiguraci. Vsechny
    zapisy do GENEROVANYCH souboru jsou regen-safe (overeno skriptem):
    rtc.c — vse uvnitr USER CODE 1,
    freertos.c — include v USER CODE Includes, volani v USER CODE StartDefaultTask.
    `flightrec.c/h` lezi v Core/Src|Inc, coz jsou v CM7/.project SKUTECNE slozky
    (0 linked resources) -> IDE si je vezme samo, zadna zmena projektovych souboru.
    Tri nalezy:
    1) 🔴 `configUSE_TRACE_FACILITY` a `INCLUDE_uxTaskGetStackHighWaterMark` jsou
    v GENEROVANE casti FreeRTOSConfig.h (mimo USER CODE) a `.ioc` je NEMA
    v `FREERTOS_M7.I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
    [rtc.c]
2026-08-18 feat(stats): overlapping ADEV + MDEV + HDEV, TDEV nove EXAKTNI
    1) OVERLAPPING misto non-overlapping. Puvodni `adev_stage` pri tau = m·tau0
    rozdelil ring na M/m disjunktnich bloku a pouzil jen jejich sousedni rozdily —
    zahodil tim vetsinu dostupnych dvojic. Overlapping varianta (Riley, NIST
    SP1065) vytezi M-2m+1 prekryvajicich se clenu z TYCHZ dat. Na dlouhych tau,
    kde je vzorku nejmene, je to rozdil mezi "par paru" a "radove vic" — tedy
    presne tam, kde na konfidenci zalezi nejvic. Konfidencni pas (`ns`) to
    zohlednuje a je proto uzsi — opravnene, ne kosmeticky.
    2) MDEV (Mod sigma_y) — rozlisi BILY a BLIKAVY fazovy sum, ktere maji v ADEV
    STEJNY sklon a ADEV je od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
2026-08-18 feat(meas): filtr merení — klouzavy prumer / median (#5)
    Standardni vybava tovarnich citacu. Dve RUZNE role, proto obojí:
    PRUMER 8 — snizi sum o sqrt(N), ale JEDINY vystrelek se rozprostre do vsech
    N nasledujicich hodnot,
    MEDIAN 9 — vystrelek zahodi uplne (robustni statistika), ale sum nesnizi.
    Na sum tedy prumer, na ruseni median. Median ma LICHE okno, aby byl ostry
    (u sudeho se prumeruji dva prostredni, coz uz vystrelek castecne pousti).
    ⚠️ FILTRUJE SE POUZE ZOBRAZOVANA HODNOTA. Do Allan/histogram/datalogu jdou dal
    SYROVA mereni — filtrovana data by sigma_y(tau) umele vylepsila a to je presne
    ten druh cisla, kteremu by se pak nedalo verit.
    Jadro je v `me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
2026-08-18 feat: okno ANALYZA — rozpocet nejistoty (#2/#51), rozliseni hradla (#7), drift (#3) a tempco (#4)
    KAM SE TO VESLO: nikam. Footer okna MERENI je plny (MODE/JEDNOTKA/RESET/CITAC/
    ZPET) a jeho karta ma 9 radku az k y=402. Misto natlaceni dalsich radku je
    ANALYZA TRETI SOUROZENEC v uz existujici rotaci: dvojice CITAC <-> MERENI se
    meni na CYKLUS CITAC -> MERENI -> ANALYZA -> CITAC. Stavajici footer tlacitko
    jen meni popisek, takze to nestoji ANI JEDEN novy pixel.
    ROZPOCET NEJISTOTY (`mp_budget`). Tri nezavisle prispevky scitane KVADRATICKY:
    rozliseni hradla (sqrt(2)·tdc/gate — kvantizace na obou hranach), stabilita
    reference (sigma_y@tau z Allanovy pyramidy) a presnost reference (ppb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
    [app_gpsdo.c, meas_present.c, meas_present.h, screen_main.c, screen_main.h]
2026-08-18 fix(flightrec,csv): dump se nedal precist + CSV konzole se rozeslo se SD exportem
    Nalezeno funkcnim testem pres COM8 (#18/#46).
    1) `flightrec test` hlasil "dump zapsan", ale `flightrec` hned nato tvrdil
    "zadny ulozeny zaznam". `flightrec_dump()` nastavil `s_have_dump=1`, ale
    `s_read_off` plnil VYHRADNE `flightrec_init()` — a to jen z uz existujiciho
    dumpu. Pri prvnim behu tedy report cetl z offsetu 0 (= zacatek flash, region
    CONFIG), tam neni magic, `hdr_unpack` selhal a vratilo se false. Dump se po
    zapisu nove prihlasi sam (`s_read_off`/`s_have_read`).
    2) `seq` dumpu byla odvozena od uptime. Uptime se po resetu vraci k nule, takze
    novejsi dump mohl mit NIZSI seq nez st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
    [flightrec.c, sd_export.c, sd_export.h]
2026-08-22 feat(v0.6.0): HSE 10->25 MHz, 5 barevnych schemat, ETH bring-up F0+F1
    Prechod HSE 10->25 MHz (X1/TCXO vymenen) - odemyka ETH PHY LAN8742A.
    PLL1/2/3 prepocteny (VCO identicka, meni se jen vstupni delic M 1->5 +
    DSI NDIV 70->28), vystupy beze zmeny (SYSCLK 480, LTDC 25, DSI 700,
    SPI123/FMC 200, ADC 25). HSE_VALUE=25M v obou jadrech. Regen-safe.
    POZOR: FW nenabehne na 10 MHz desce (PLL by chtel VCO 2400 -> nezamkne se).
    Barevna schemata (5 palet, index persist DR6 bit0+9:10): TMAVE/SVETLE/
    STREDNI/OBRYS/KONTRAST. NORMAL tlacitka v tmavem ladena do modra, ACTIVE
    zjasneno. Odstranen mrtvy `bot` koncept tlacitek.
    Odstranena docasna A/B srovnavaci vetev hlavni obrazovky (#14): jediny
    render_body_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
2026-08-24 feat(web): dashboard v12 - ovladani, mDNS, SSE, alarmy, sky plot, dlouha historie
    Sest rozsireni weboveho rozhrani na CM4 (IPC v11 -> v12). KOD HOTOVY,
    NEOVERENO NA HW; kompiluje se -Wall -Wextra bez varovani na obou jadrech.
    #1 Ovladani MATH/LIMITY/NULL/CAS ze SPA - nova karta posila SCPI (CALC:*,
    SYST:DATE/TIME) toutez cestou POST /api/scpi co konzole. Zadny novy
    server kod; zamyka se dle web_ctrl_en.
    #2 mDNS gpsdo.local - rucne psany responder v lwip_app.c (vendorovany lwIP
    mdns modul chybi). LWIP_IGMP=1, NETIF_FLAG_IGMP, MAC PassAllMulticast +
    igmp_joingroup 224.0.0.251, UDP 5353. Best-effort (jako gps glonass).
    #3 SSE push (GET /api/stream) misto 1 Hz pollu - drzene spojeni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
2026-08-24 fix(vbat): prah + nominal na CR2032 s 3,3 V nominalem
    Deska ma zalozni CR2032 s jmenovitych 3,3 V (ne 3,0 V, jak predpokladal
    puvodni kod). Uprava:
    - alarm prah "vymen brzy": vbat_lo_mv 2,6 -> 2,8 V (~0,5 V pod nominalem,
    stale s velkou rezervou nad BKP/RTC floor ~1,65 V a kolenem CR2032 ~2,7 V).
    - displejove nominaly VBAT -> 3,3 V: GRAFY vert. bar (2500/3400/3300),
    PREHLED KANALU (2,5/3,4/3,3 V), web (NOMV.p3 3300, mark 3300, warn <2800).
    - syscfg magic SCFE -> SCFF: bez bumpu by se z flash nacetl stary 2,6 V prah;
    s bumpem se novy vychozi prah projevi i na uz nakonfigurovanem kusu
    (prvni boot vrati vsechna nastaveni na vychozi). Lze i rucne v okne PRAHY.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
    [alarm.c, app_gpsdo.c, httpd_min.c, syscfg.c]
