ok2haz/Frequency_Counter_FPGA/(notices)

Notices in the files:
Frequency_Counter_STM32H757/CM7/Core/Src/main.c:
Copyright (c) 2025 STMicroelectronics.
All rights reserved.
This software is licensed under terms that can be found in the LICENSE file
